BDR16/svn-migration-dump/Administration/Competition Forms/Formula Electric/ESF/Photos/6.2 Motor and Wiring Position - Copy.JPG

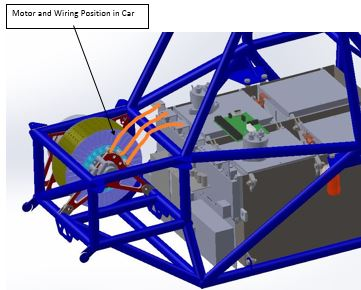
Administration/Competition Forms/Formula Electric/ESF/Photos/6.2 Motor and Wiring Position - Copy.JPG
