BDR16/svn-migration-dump/Administration/Project Management/Change Management/Read Me.txt

Files in this folder should be named according to the work package that the effect and the date which they were created.

Examples: "Drivetrain Nov 1" "Steering Oct 5" etc
