BDR16/svn-migration-dump/Administration/Impact Attenuator Reports/FH Design Selection.docx

Design Selection:

We decided to use the same Aluminum honeycomb from our 2014 vehicle, as that attenuator performed well. Again, we opted for the industry standard pre-crushed 8*8*4 in aluminum 5052 5.7pcf 3/16” honeycomb because of its abundance and low-cost compared to a custom-built honeycomb.

To dissipate the kinetic energy of our 317.5 kg car in the event of a crash at 7 m/s, we needed at least 9.3 in in the fore/aft direction. After adding a 15% safety margin we decided to stack another 2.6 in honeycomb with identical properties on top of the 8*8*4 block, thereby giving rise to our new impact attenuator with dimensions 10.6*8*4. This safety margin allows our car to strike a wall at 20 degrees and still absorb all of the vehicle’s Kinetic Energy.

We bonded these pieces with WEST SYSTEM® Six10® Thickened Epoxy Adhesive. To increase surface area and improve resistance to shearing forces, we placed a 0.06 inch thick aluminum plate between the honeycomb pieces. Detailed information regarding the equivalency of the epoxy to the (4) 5/16 Grade 5 bolts stated in the rules T3.20.3 can be found in our SES rev1.

To attach the honeycomb system and the aluminum L brackets that help support the honeycomb on the anti-intrusion plate we again used WEST SYSTEM® Six10® Thickened Epoxy Adhesive. The aluminum L brackets provide an additional level of protection against shearing forces and enhances stability in the event of a linear impact.

We used 4 mm-thick aluminum for our anti-intrusion plate to facilitate bonding with the honeycomb and the L brackets, since they are aluminum as well.

In summary, the impact attenuator we designed for our 2016 car was optimized in terms of cost, weight and use of materials. We emphasized safety as a key point and thus over-engineered both our honeycomb system and our anti-intrusion plate to outperform the criteria of Formula Hybrid, as we believe that a few pounds and a few dollars are well spent to protect a human life.

Yale University, Formula SAE Hybrid 2016
