BDR16/svn-migration-dump/Administration/Competition Forms/Formula Hybrid/213_Yale University_FH_Design.docx

## Bulldogs Racing BR16 Design Report

## Introduction

Bulldogs Racing has moved from the hybrid category to the all-electric category in the 2016 season for a variety of reasons. First, Yale University has set a major focus on sustainability throughout our daily lives. We think that electric vehicles will be the key to a sustainable future in transportation assuming improved battery technology over the course of the century. Additionally, the three North American electric vehicle competitions provide more utility for an electric vehicle than the single hybrid competition in New Hampshire. Most importantly, Formula Student has set a trend of electric vehicle performance that has dwarfed previous internal combustion, not to mention hybrid, records. Bulldogs Racing’s 2016 car, BR16, has been designed for optimal performance across acceleration, skid pad, autocross, and endurance events while still remaining manufacturable and cost conscious.

Our design philosophy can be summed up in this single phrase: “We don’t get to choose not to have problems, but we do get to choose the types of problems we are likely to have.” We do not have a perennial Formula SAE team with a history of success at competition. We do not have significant carry over between teams due to the leadership burning out. Not a single member of the championship 2013 team is on this year’s 2016 team, and only three of our members have been to a competition. Our first step to success has been recognizing these disadvantages, and focusing our efforts on the parts of the car that will benefit us most in competition. The North American electric vehicle competitions have been plagued with poor performances during technical inspection, resulting in cars that do not reach the track. Our number one priority is passing technical inspection with a car that can be successful in all four dynamic events.

## Powertrain

The powertrain of BR16 is made up of the cells, motor controller, motor, and gearbox. All of these components were chosen to operate well with each other. Moreover, the entire package was designed to race competitively in the acceleration, skid pad, autocross, and endurance dynamic events.

### Motor

The design started with the motor, as we found it easiest to adjust other components in relation to the motor rather than vice versa. The goals of motor selection were to traction limit the vehicle up to as high of a speed as possible, maintain greater than 90% efficiency at the average endurance speed, and reduce cost/fabrication time. We discarded any homemade or rewound motors due to the last goal, leaving us with a list of motors from Enstroj, Yasa, Nova, and Allied Motion. Of these choices, the Emrax 207 medium motor matched our goals best in an independent rear wheel drive configuration. We planned to mount our batteries directly behind the driver to drastically lower our polar moment of inertia when compared to side pods. This scheme would not be possible with a chain or belt drive, so we had a choice of direct or planetary gear drive. The Yasa motor lends itself to direct drive, but has a low power to weight ratio when compared to the Emrax. The Emrax 207 Medium has a maximum voltage of 300V, directly correlating with the electric vehicle ruling in North America. Running two Emrax motors each with a gear ratio of 4 results in a top speed of 90mph, traction limited operation up to 40mph, and greater than 96% efficiency from 25 to 50mph. On top of these phenomenal performance characteristics, using two independent motors cuts out the need for a differential.

### Gearbox

To meet packaging requirements, the gearbox had to mount axially to each of the rear motors with a speed reduction ratio of 4. The best solution we found to meet this need was the planetary gearbox. Following our design philosophy, we searched for a planetary gearbox that could be dropped into the car using only mounting tabs and half shafts rather than designing the gearbox ourselves. Unfortunately, we could not find such a product and had to settle somewhere in between. The Matex 146-4MEF planetary gearbox fit our reduction ratio needs at the cost of designing a watertight housing to meet manufacturer-suggested lubrication specifications.

### Motor Controller

The motor controller’s primary design specification was to match the motor type, voltage, and current while remaining efficient, low cost, and easy to integrate. Additionally, we wanted a motor controller that could perform in all four quadrants for regenerative braking. Enstroj suggested using the Bamocar D3 400-400 motor controller with the Emrax series of motors. We decided to follow their suggestion in order to ensure compatibility between the motor and controller. While the Bamocar motor controller is fairly lightweight, it wastes a lot of space volumetrically. We repackaged the motor controllers in a lower footprint housing in order to fit them behind the driver’s seat. This, again, is an example of a compromise we had to make between designing an entire component from scratch versus buying a drop-in component off the shelf.

### Cells

The accumulator cell was the most difficult component of the powertrain to choose due to the wide performance gap between designing and purchasing battery packs. Most off the shelf battery packs that we found did not meet our requirements for nominal voltage, continuous current, peak current, specific power, specific energy, energy density, and form factor. The only suitable battery pack we found was the A123 AMP20 energy module, but we could not find a supplier that sold them. Between lithium cobalt cells from Tenergy, Haiyen, and Turnigy and lithium iron cells from A123 we looked for a cell that would meet our requirements while resulting in a manufacturable and reliable battery pack. Our main focus was on high capacity cells such that the battery pack could be a series string of cells, forgoing the parallel cell fusing rule. Additionally, higher capacity cells would require less overall cells, resulting in easier fabrication and higher reliability. The A123 AMP20 cell used in the A123 AMP20 energy module was selected for numerous reasons. Its 20Ah capacity allowed us to design an accumulator with an 86S1P configuration with a maximum voltage of 300V. Its 600A peak current aligns well with two times the Emrax 207 Medium’s peak current rating. Lastly, AMP20 pouch cells are aligned face to face in compressed cell stacks that fit well between the driver’s seat and rear axle.

## Tires

All forces produced by the powertrain in acceleration and cornering are reacted through the tire contact patches at low speeds. Therefore, it is important for the chassis, suspension, braking, and steering systems to keep the tires in their optimal state throughout all conditions that may be achieved on the track. However, determining this optimal state is another problem in and of itself, usually achieved through the analysis of tire data.

### Tire Selection

Tire selection depends mostly upon rear weight bias, of which Bulldogs Racing's 2016 car will have about 60%. Tires should be picked such that the peak coefficient of friction for the outside rear tire under 30% load plus load transfer should be equal to the peak coefficient of friction for the outside front tire under 30% load plus load transfer. Doing this will ensure that the two sets of tires begin slipping from the track at about the same lateral acceleration. Aside from matching the fronts and rears in this manner, the tires with the highest possible coefficients of friction should be chosen to maximize vehicle performance.

Due to time constraints and a small one-man tire team, tire selection was limited to finding peak values and fitting magic formula curves rather than developing extensive tire models. The data was parsed into runs with constant rim width, pressure, vertical load, and camber. Figure 4 (left) shows five example data sets of cornering force vs. slip angle for a 7.5” Hoosier tire on an 8” rim width at 10psi of pressure and 0 degrees of camber. After the data was parsed into a usable format, each data set was fit with Pacejka's magic formula to determine peak coefficient of friction values for both longitudinal and lateral forces. MATLAB's nonlinear least squares curve fitting tool was used to create the fits, one of which is shown in Figure 4 (right).

### Tire Analysis

Once the runs were fit, the peak coefficient of friction values were averaged across multiple dimensions and compared between differing tire manufacturers and models. Peak coefficient of friction was averaged across all dimensions except for rim width to determine optimal rim width. Then that rim width was chosen for future analysis. Next peak coefficient of friction was averaged across all dimensions except for rim width and pressure to determine optimal pressure at the optimal rim width. Then that pressure was chosen for future analysis. Finally, a plot of lateral force versus vertical force for multiple cambers was generated at the optimal rim width and pressure to determine tire camber sensitivity as shown in figure 5. This analysis was completed for both the front and rear Hoosier tires such that the suspension could be designed to keep the tires happy.

### Suspension Geometry

The goal of our double wishbone geometry was to minimize camber change, track width change, and roll center change as the suspension moves in bump, droop, and roll. Note in figure 5 that the 7.5” Hoosiers performed best at 0 degrees of camber, and therefore the suspension should be designed such that the outside, more heavily laden tire has 0 degrees of camber during a turn. A 2D geometry sketch was used with a trial and error process to determine optimal parameters. Note that a more robust method would have involved a track simulator with tire models, but we did not have the time to implement such a solution. The change in camber was adjusted to about 2 degrees for a 2.5 degree roll, thereby compromising between tire camber and roll gradient performance. The static camber was left very low, namely -0.5 degrees in the front and -1 degree in the rear because the uprights will have built-in static camber adjustment through shims, but only in the negative direction. Additionally, the front and rear roll centers were kept as close as possible to each other in both height and lateral offset such that the roll axis remained constant relative to the vehicle mass centroid axis.

### Suspension Adjustability

A multitude of suspension parameters are statically adjustable between races. Toe can be adjusted due to a left and right handed rod end being used on the front steering link and rear toe rod. Ride height can be adjusted by the same method’s use on the pull rods. Additionally, this ride height adjustment is independent of spring preload, which is adjusted directly on the damper. Kingpin axis inclination is adjustable by the threaded rod ends on the front wishbones, although this adjustment will slightly change other suspension properties such as camber, track, and roll center sensitivity to bump, droop, and roll. Steering arm and Ackermann are adjustable through steering link tabs that bolt to the front uprights. Finally, camber is adjustable through shims on the bottom of each front and rear upright.

### Uprights

The suspension uprights were manufactured from 7075-T6 aluminum to reduce weight and compliance. A variety of major changes were made to the front and rear uprights from BR13. The front and rear uprights were thinned from 1.95” to 1.4” and 1.5” respectively. A removable plate was added at the bottom wishbone attachment point to allow for camber adjustment. In terms of weight savings, the new upright pockets were cut completely through because simulation showed that leaving a thin layer of aluminum on the back of the upright does not significantly increase strength or rigidity, but drastically increases weight. Additionally, a triangular structure was run to either side of the wishbone and toe link attachment points on the uprights to better support the nodes. A weight of 1.71 and 1.98lbs was achieved for the front and rear uprights respectively with a safety factor of over 5, as opposed to about 3.16 and 3.37lbs for the old car.

## Steering

A Stiletto 12:1 rack and pinion was used to transfer steering forces from the wheels to the steering column and driver. Four brake calipers were used at the front of the car to produce enough braking force for BR13. To reduce weight and system complexity, Wilwood master cylinder and caliper bore diameters were selected such that only two brake calipers needed to be used at the front of the car, resulting in a total of four calipers on the vehicle. Additionally, the bore diameters were selected such that braking force distribution matched 2g longitudinal load transfer for a 40% front biased vehicle.

## Chassis

To start off, we were able to reduce both the height and length of the chassis due to packaging design considerations made before the summer of 2015. The width could also be reduced because the vehicle no longer needed to house both an electric motor and internal combustion engine in parallel. The rear box that used to house the differential, but now houses the motors and gearboxes was significantly reduced in size due to the lack of large chain driven sprockets. Lastly, the driver seat angle was increased to 45 degrees to give more room for the accumulator in the area directly behind the seat. A weight of 65lb was achieved, directly in line with our goal of fabricating a chassis that weighs less than 70lb.

## Aerodynamics

Despite our lack of experience, we made a few common sense design decisions to take advantage of aerodynamics with BR16. Frontal area of the cockpit opening was reduced as much as possible in chassis design to reduce aerodynamics drag. Additionally, our contoured body prevents laminar-turbulent flow transition, again reducing drag. Lastly, NACA ducts on either side of the driver’s head pull air into the radiator that cools the motors and motor controllers.

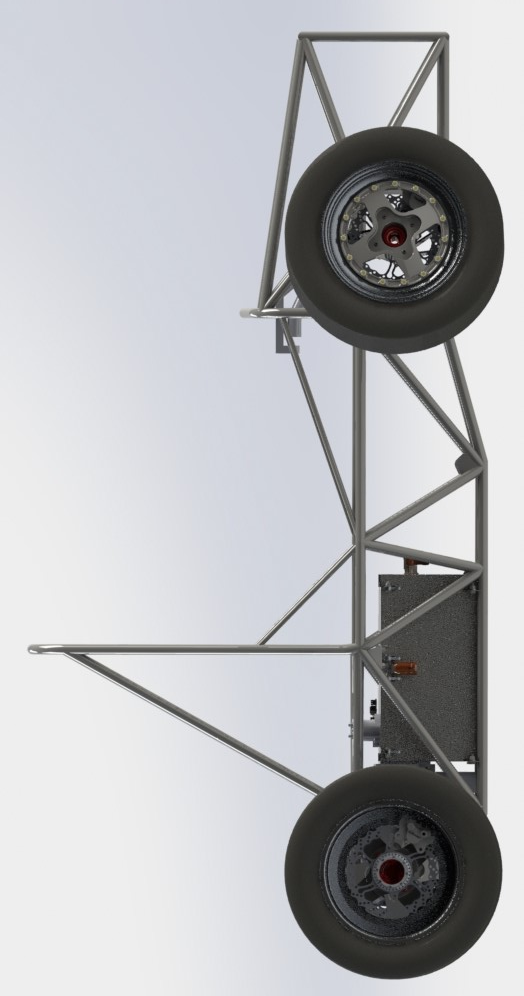
[picture p7: figure]

Figure 1 - Side view

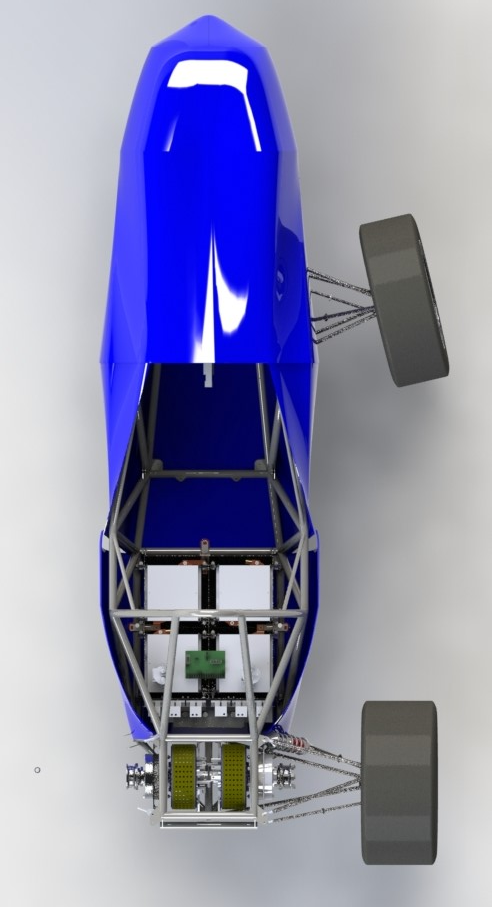
[picture p8: figure]

Figure 2 - Front view

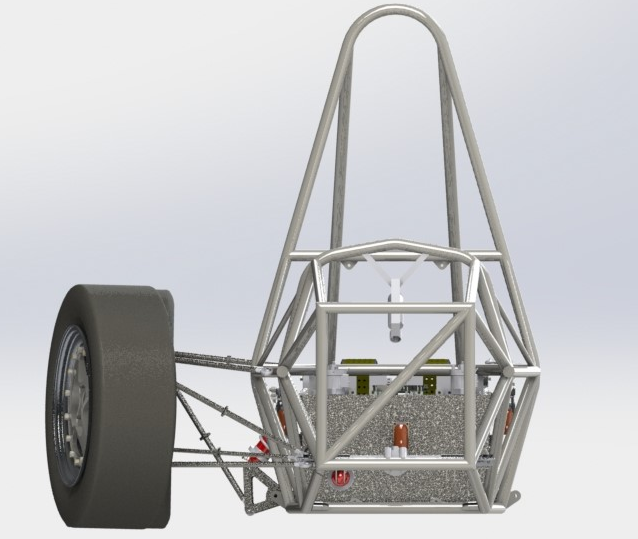
[picture p9: figure]

Figure 3 - Front View

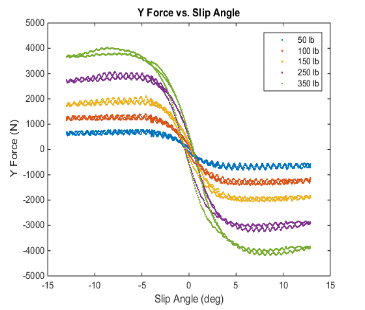
[picture p10: figure]
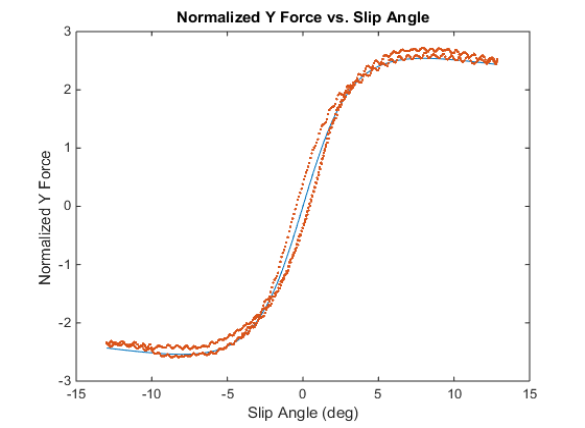
[picture p11: figure]

Figure 4 – TTC parsed tire data (left) fit to Pacejka’s magic formula (right)

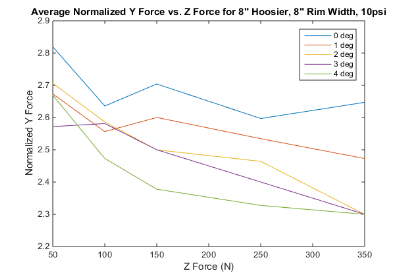
[picture p12: figure]

Figure 5 – Lateral vs. vertical force for rear tire cambers (listed cambers should be negative)

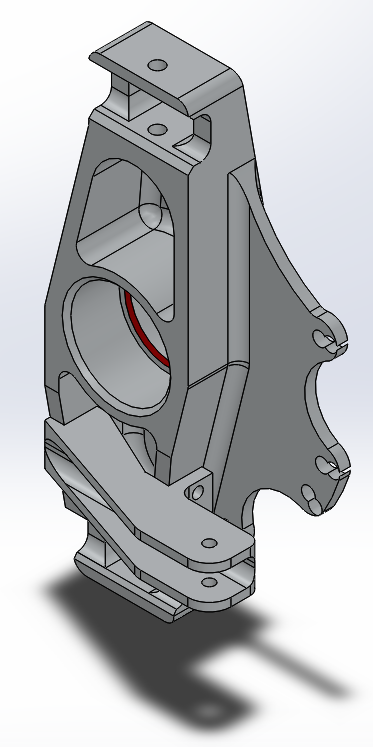
[picture p13: figure]
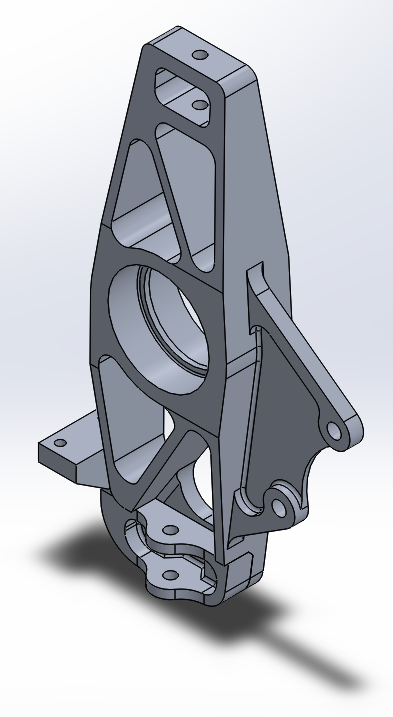
[picture p14: figure]
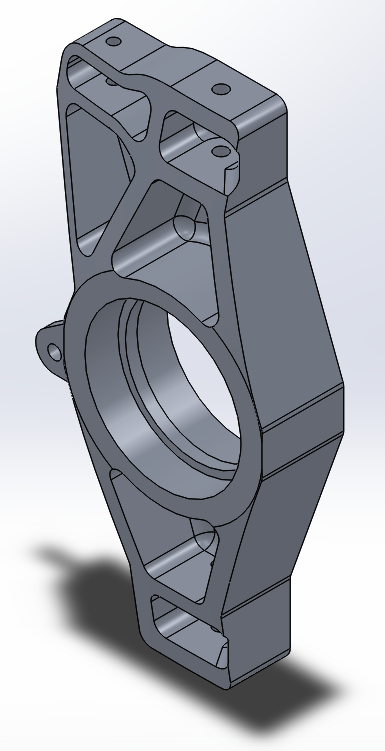
[picture p15: figure]
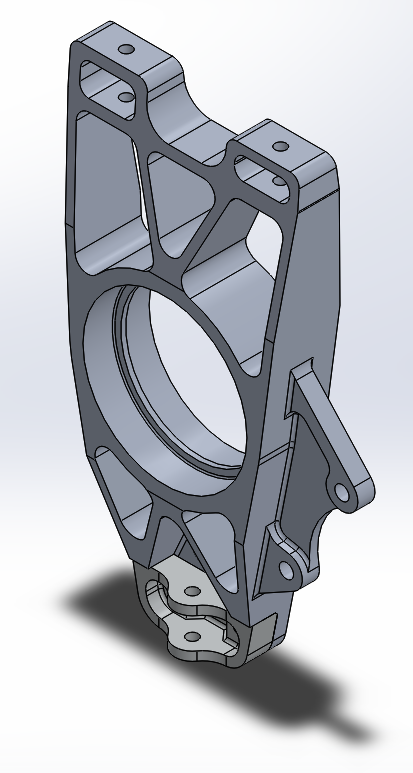
[picture p16: figure]

Figure 6 – From left to right old front, new front, old rear, new rear

bulldogsracing.com | philip.piper@yale.edu | (713) 501-2744
