BDR16/svn-migration-dump/Administration/Bulldogs Racing Template.pptx

## Slide 2

Bulldogs Racing

Notes: 4-5 day seminar focusing on vehicle dynamics from a data standpoint. Started with the tire data and moved towards suspension. It was a lot of work. Got a giant binder and an excel sheet with a lot of the calculation. On the way back, Saw belter’s house.
