BDR16/svn-migration-dump/Administration/Impact Attenuator Reports/213_Yale University_FH_IAD_Addendum.xlsx

Formula SAE Hybrid Impact Attenuator Report Addendum: Equivalency of Epoxy Bonding
5/16 Grade 5 bolts |  |  |  |  |  | Honeycomb Properties
Tensile Strength | 827 | MPa |  |  |  | Hexagonal Cell Size | 0.1875 | in
Shear Strength | 513 | MPa |  |  |  | One side of the hexagon | 0.10825 | in
Tensile Stress Area Diameter | 0.008 | m | (1 bolt)* |  |  | Foil Gauge | 0.002 | in
Shear Stress Area Diameter | 0.008 | m | (1 bolt)* |  |  | One Hexagon Area | 0.03 | sq in
Tensile Stress Area | 0.0002010619298 | m^2 | (4 bolts) |  |  | One Hexagon Perimeter | 0.65 | in
Shear Stress Area | 0.0002010619298 | m^2 | (4 bolts) |  |  | Crush Area of Honeycomb | 32 | sq in
Tensile Failure of Bolts | 166278.216 | N | (4 bolts) |  |  | # of Hexagons in Crush Area | 1066.666667
Shear Failure of Bolts | 412579.08 | N | (4 bolts) |  |  | Foil Surface Area for Bonding* | 2.426666667 | sq in
*Assuming a 5/16 shank (which is an overestimate) |  |  |  |  |  | Foil Surface Area for Bonding* | 0.001565588267 | m^2
 |  |  |  |  |  | *For calculating the failure limits of the epoxy. Found by multiplying the number of hexagons by the perimeter of a single hexagon by the foil thickness. Divided by 2 to avoid double-counting the adjacent sides. Epoxy assumed to form 0.005" radius fillet between the honeycomb and the spacer.
Equivalency of Epoxy Bonding the Main Honeycomb and its Brackets to the Anti-Intrusion Plate*
Epoxy Tensile Strength | 44 | MPa
Epoxy Shear Strength | 78 | MPa
Tensile Stress Area | 0.02064512 | m^2 | (4 brackets)**
Tensile Stress Area | 0.001565588267 | m^2 | (Honeycomb)*** |  |  | Honeycomb Failure Limits
Shear Stress Area | 0.02064512 | m^2 | (4 brackets)** |  |  | Tensile Strength* | Not Rated
Shear Stress Area | 0.001565588267 | m^2 | (Honeycomb)*** |  |  | Shear Strength | 3.17 | MPa
Tensile Failure of Honeycomb and Brackets | 977271.1637 | N | (Total) | 587.7325289 | % equivalency | Tensile Stress Area** | 0.02064512 | m^2
Shear Failure of Honeycomb and Brackets | 1732435.245 | N | (Total) | 419.9038024 | % equivalency | Shear Stress Area** | 0.02064512 | m^2
*Total of 4 L brackets are used at 4 sides of the honeycomb. Each bracket is a 4" x 4" 0.060" thick 6061 T6 Aluminum, bent into an L shape. |  |  |  |  |  | Tensile Failure of Honeycomb* | Not Rated
 |  |  |  |  |  | Shear Failure of Honeycomb | 65445.0304 | N
**Assuming 2" x 4" bracket contact area with both the AI plate and the honeycomb. Sides of the honeycomb are flattened before adhesion. |  |  |  |  |  | *Tensile strength of honeycomb not rated; poor in tension.
 |  |  |  |  |  | **For calculating the failure limits of the Aluminum honeycomb. Same as the crush area. Supplied by Plascore, vendor of the honeycomb, in references.
***See the Honeycomb Properties chart for the details on the calculation.
All Dimensions in Inches in Drawing |  |  |  |  |  | Equivalency of Epoxy Bonding the Extenstion Honeycomb to the Spacer Plate*
 |  |  |  |  |  | Tensile Strength | 44 | MPa
 |  |  |  |  |  | Shear Strength | 78 | MPa
 |  |  |  |  |  | Foil Surface Area for Bonding* | 0.001565588267 | m^2
 |  |  |  |  |  | Tensile Stress Area | 0.001565588267 | m^2
 |  |  |  |  |  | Shear Stress Area | 0.001565588267 | m^2
 |  |  |  |  |  | Tensile Failure of Epoxy | 68885.88373 | N | N/A | % equivalency
 |  |  |  |  |  | Shear Failure of Epoxy | 122115.8848 | N | 186.5930599 | % equivalency
 |  |  |  |  |  | *The equivalency that we need to prove is that of the honeycomb, since the failure modes on the spacer plate and the additional honeycomb block are those of the epoxy and the honeycomb itself.
 |  |  |  |  |  | References
 |  |  |  |  |  | Bolt Tensile Strength (https://www.fastenal.com/content/documents/FastenalTechnicalReferenceGuide.pdf)
 |  |  |  |  |  | Bolt Shear Strength (http://www.blacksfasteners.co.nz/assets/boltshearcapacity_14-15.pdf)
 |  |  |  |  |  | West Systems Six10 Epoxy (http://www.westsystem.com/ss/typical-physical-properties/)
 |  |  |  |  |  | Plascore Aluminum Honeycomb (http://www.plascore.com/download/datasheets/honeycomb_data_sheets/Plascore_5052.pdf)
