BDR16/svn-migration-dump/Electrical/High Voltage/High Voltage Design.xls

Voltage (V) | Capactiance (uF) | Safety Factor
300 | 1600 | 1.35
Precharge Resistor
%Voltage | Time (s) | Resistance (Ohm) | Power (W)
90 | 5 | 1005.311301 | 11.664
Discharge Resistor
End Voltage (V) | Time (s) | Resistance (Ohm) | Power for 15s per Formula Hybrid EV4.9.3 (W)
30 | 5 | 1005.311301 | 89.52450842
