BDR16/svn-migration-dump/Mechanical/Impact Attenuator/Impact Attenuator Calculations.xlsx

Sheet: Material
New Impact Attenuator Reference
Material
Vendor | Plascore
ID | PAMG-XR1-5.7-3/16-P-5052
Rebranded As | PACL-XR1-5.7-3/16-20-P-5052
Properties
Series: | PAMG Aerospace Grade | (rebranded as PACL CrushLite)
Alloy | 5052 Aluminum
Corrosion Resistance | Coated
Density | 5.7 pcf (91.3 kg/m^3)
Cell Size | 3/16 in (4.76mm) | measured from edge to edge, perpendicular
Thickness | 0.02 in (0.51 mm)
Perforated | Yes
Why this material?
Aluminum | best strength to weight; most cost-efficient compared to plastic or composite solutions
5052 | best strenght to weight ratio for Aluminum honeycomb, only second to 5056, but much cheaper than 5056
5.7 pcf, 3/16 in, .02 | most widely and readily available and cheapest that still satisfies the constraints
Precrushed | to eliminate peak loads at the front crush zone

Sheet: Calculations
Independent Variables
Car Mass | 230.00 | kg
Driver Mass | 80.00 | kg | This is in the rules
Crash Velocity | 7.00 | m/s | This is in the rules
Max Acceleration | 40.00 | g
Max Avg Acceleration | 20.00 | g
Min Crush Stroke | 0.20 | m | This is in the rules
Min IA Width | 0.20 | m | This is in the rules
Min IA Height | 0.10 | m | This is in the rules
Max Crush P | 2844087.00 | Pa | Supplied by Plascore
Min Crush P | 2326981.00 | Pa | Supplied by Plascore
Min Crush Stroke Efficiency | 0.76 |  | Supplied by Plascore
Dependent Variables
Total Mass (lbs) | 700.00 | lbs | Rounded to the nearest 100 lbs, per the rules
Total Mass | 317.52 | kg
KE | 7779.12 | J
Primary Calculations
Crush Area | 0.02 | m^2 | as mandated by the rules
Min Crush Stroke w/ Pmax | 0.14 | m | Quoting KE = F * s ; F = P * A ; Pmin and Pmax are Plascore values
Min Crush Stroke w/ Pmin | 0.17 | m
Min IA Length | 0.21993 | m
Sanity Check
Min Crush Stroke | 0.12 | m | Quoting Vf^2 = Vi^2 + 2 * a * s | The design crush stroke value is higher; average acceleration will be less than 20g
Max Crush Area | 0.02 | m^2 | Quoting F = m * a ; F = P * A | The design crush area is lower; a force lower than m * 20g will be needed to compress
Max Avg Acceleration | 14.94 | g
Min Energy Absorbed | 7779.12 | J |  | Above 7350 J as stated by the FSAE
Min Crush Force | 46539.62 | N
Max Crush Force | 56881.74 | N |  | This might be a problem if we want to collect data from Instron - it does not register data after 50 kN I think, but then there is not much we can do, since F is directly proportional to Area, and we can not reduce the area per the rules.
Dynamicity and Angularity of the Impact
Crush P coefficient (7 m/s) | 1.06 |  | fig 2, pg 5 of Hew Web | As the impact velocity increases, the crush P coefficient increases, up to about 1.1 at 10 m/s, after which it continues to increase at a marginal rate.
Min Dynamic Crush Stroke | 0.16 | m | at 7 m/s
Min Dynamic IA Length | 0.21 | m |  | Lower than the min static IA length
Crash Angle | 20.00 | degrees |  | Up to 20 degrees, linear decrease in the crush strength proportional to the change in the angle between the load path and the normal vector of the front plane of the IA (1% decrease for every degree). After 20 degrees, 2% decrease after every degree. Car is not expected to hit a wall head-on at any angle greater than 20 degrees. Quoting Theta = arccos(L / R), where L is the wheelbase of the car and R is the turning radius for a rough estimate of centripetal acceleration. V^2 / R = 7^2 / 4.5 = around 1.1g. Assuming the driver is using the brakes if the impact is imminent, the traction circle does not premit cornering with over 20 degrees of steering input without breakaway. As a result, impacts over 20 degrees are not expected.
Angular Crush P coefficient | 0.80 |  | fig 3, pg 6 of Hex Web
Normal Crash Velocity (grip) | 6.58 | m/s | case where the wheels and the car point in the same direction
KE | 6869.13 | J
Min Dynamic Crush Stroke w/ Pmin | 0.17 | m
Min Dynamic IA Length | 0.22902 | m
Crash Angle | 20.00 | degrees
Angular Crush P coefficient | 0.80 |  | fig 3, pg 6 of Hex Web
Normal Crash Velocity (oversteer) | 7.00 | m/s | case where the wheels point in the direction of the load path, but vehicle travels at 30 degrees wrt the wheels (oversteer)
KE | 7779.12 | J
Min Dynamic Crush Stroke w/ Pmin | 0.20 | m
Min Dynamic IA Length | 0.25936 | m
Precrushed Section Length | 0.00953 | m | pg 11 of Hex Web |  | 0.9525
Total Proposed IA Length | 0.26888 | m
 | 10.58590857 | in
