BDR16/svn-migration-dump/Mechanical/Steering/Steering Design.xls

Sheet: Steering Statics
Car Parameters
Mass (kg) | 300
Front Track Width | 1258.49
COG Height (mm) | 250
Front Weight Bias (%) | 40
Max Lateral G's | 1.6
Tire Parameters | Outside | Inside
Tire Fz (lbf) | 216.4386797 | 48.20765233
Tire Mz (Nm) | 58 | 7
Tire Fy (N) | 2500 | 600
Caster Angle (deg) | 4 | 4
Kingpin Offset (mm) | 0 | 0
Wheel Radius (in) | 21 | 21
Pneumatic Trail (mm) | 23.2 | 11.66666667
Mechanical Trail (mm) | 18.64948075 | 18.64948075
Steering Moment (Nm) | 104.6237019 | 18.18968845
Steering Forces/Moments
Upright Arm Length (mm) | 100
Upright Bolt Separation (mm) | 27.94
Steering Wheel Diameter (mm) | 260
Rack Linear Travel (mm) | 114.3
Rack Rotational Travel (deg) | 315
Rack Effective Pinion Radius (mm) | 20.79018285
Tie Rod Force (N) | 1228.133903
Upright Bolt Force (N) | 2197.805839
Steering Ratio | 4.809962505
Steering Wheel Torque (Nm) | 43.50291785
Steering Wheel Force (lb) | 37.61496524
Bolts | Tie Rod Bolt | Upright Bolt
Diameter (in) | 0.25 | 0.19
Tensile Strength (psi) | 170000 | 170000
Shear Strength Mult | 0.6 | 0.6
Shear Strength (psi) | 102000 | 102000
Critical Shear Force (N) | 44543.70368 | 25728.44325
Safety Factor | 36.26941946 | 11.70642228
Tubes
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
