BDR16/svn-migration-dump/Administration/Competition Forms/Formula Electric/E228_Yale_spec.xls

Sheet: FSAE_Specs_EV_Powertrain
FSAE (EV) Design Spec Sheet |  |  |  |  |  |  | 2016
Competitors: Please read the Instructions-Tips (tab below) prior to the completion and submission of this sheet.
Car No. |  | E228
School |  | Yale University
Dimensions | Units
Overall Dimensions | mm | Length: | 2650 | Width: | 1452 | Height: | 1149
Wheelbase & Track | mm | Wheelbase: | 1549 | Front Track: | 1263 | Rear Track: | 1187
Center of Gravity Design Height | mm | CG Height: | 200 to 250 | Confirmed Via: | Three point hang test with ballast for driver
Mass without driver | kg | Front: | 60 to 75 | Rear: | 150 to 165 | Total: | 210 to 240
Weight Distribution with 68kg driver |  | % Front: | 40 | % Left: | 50
Suspension Parameters | Units | Front |  |  | Rear
Tire Size, Compound and Make |  | Hoosier 13" ID x 6" width R25B |  |  | Hoosier 13" ID x 8" width R25B
Wheels (width, construction) |  | Keizer aluminum 13" OD x 6" width |  |  | Keizer aluminum 13" OD x 8" width
Suspension Type |  | Double wishbone |  |  | Double wishbone
Suspension design travel | mm | Jounce (col D): Rebound (col E): | 30 | 30 | Jounce (col G): Rebound (col H): | 30 | 30
Wheel rate (chassis to wheel center) | N/mm | 14.84 |  |  | 21
Roll rate (chassis to wheel center) | NM/deg | 205.1 |  |  | 255.6
Sprung mass natural frequency | Hz | 2.5 |  |  | 2.4
Jounce Damping | % critical | 0.8 | at __ mm/sec: | 100 | 1.15 | at __ mm/sec: | 100
Rebound Damping | % critical | 1.25 | at __ mm/sec: | 100 | 1.75 | at __ mm/sec: | 100
Motion ratio | _.__:1 | 1 | Type: | linear | 1.04 | Type: | linear
Ride Camber (Rate of Camber Change) | deg/m | 33.1 |  |  | 29.5
Roll Camber | deg/deg | 0.79 |  |  | 0.76
Static Toe (- out, + in) | deg | -1.0 to 1.0 |  |  | -1.0 to 1.0
Static camber | deg | -0.5 to -2.5 |  |  | -1.0 to -3.0
Static camber adjustment method |  | Adjustable by up to 2 degrees using upright shims |  |  | Adjustable by up to 2 degrees using upright shims
Anti dive / Anti Squat | % | 0 |  |  | 0
Roll center height above ground, static | mm | 46.6 |  |  | 37.2
Roll center position at 1g lateral acc | mm | Height (col D): Lateral (col E): | 41.3 | 48.5 | Height (col G): Lateral (col H): | 37.5 | 33.7
Front Caster, Trail, and Scrub Radius |  | Caster (deg): | 4 | Kin Trail (mm): | 18.6 | Scrub Rad (mm) | 31.4
Front Kingpin Axis |  | Inclination (deg): | 0.5 | Offset (mm): | 31.4
Static Ackermann | % | 25 | Adjustable? | Yes
Suspension Adjustment Methods |  | Adjustable Ackermann and steering arm length through interchangeable steering arms bolted to front uprights
Steer Ratio, C-Factor, Steer Arm Length |  | Steer Ratio (x:1) | 5.3 | c-factor (mm) | 65.3 | Steer Arm Length | 60.8
Brake System / Hub & Axle | Units | Front |  |  | Rear
Rotors |  | RCV floating iron 9" dia 0.18" thick weight optimized |  |  | RCV floating iron 9" dia 0.18" thick weight optimized
Master Cylinder |  | Wilwood compact remote flange 0.8125" bore size |  |  | Wilwood compact remote flange 1.125" bore size
Calipers |  | Wilwood PS-1 dual piston 1.12" piston diameter |  |  | Wilwood PS-1 dual piston 1.12" piston diameter
Brake Pad/Lining Material |  | Wilwood 4108 sintered metallic pad |  |  | Wilwood 4108 sintered metallic pad
Force and Pressures @ 1g Deceleration |  | Front Pres. (bar): | 32.1 | Rear Pres. (bar): | 16.8 | Pedal Force (kN) | 0.43
Upright Assembly |  | Alu 7075-T6 camber, steering arm, and Ackermann adj |  |  | Machined aluminum 7075-T6 camber adjustable
Hub Bearings |  | Timken 08000 back to back tapered roller bearings |  |  | Timken L610500 back to back tapered roller bearings
Axle type, size, and material |  | RCV steel hub |  |  | RCV steel hub with enclosed CV joint
Ergonomics | Units
Driver Size Adjustments |  | Longitudinally adjustable pedal plate (+/- 4") and vertically adjustable seat (+/- 6")
Seat (materials, padding/damping) |  | Carbon fiber seat with foam inserts for comfort and height adjustment
Steering Wheel (dia, construction) |  | Diamter (mm) | N/A | Construction | N/A
Shift Actuator (type, location) |  | N/A
Clutch Actuator (type, location) |  | N/A
Instrumentation |  | Speed gage, fuel gage, AMS fault light, IMD fault light, software fault light, and performance/endurance switch
Optional: (e.g., Driver Safety Systems, etc.?) |  | Regenerative braking hand paddle actuation
Electrical (non-drive systems) | Units
Power Management / Control |  | Littelfuse PDM with relay and fuse integration
Wiring / Loom / ECM mounting |  | Expandable braided sleaving for heat and vibration resistance
Battery / Charging System |  | Lithium polymer 12V, 6Ah battery with on-board battery management system
Grounding |  | Analog instrumentation grounding through shielded cable
Driver Assist Systems |  | Driver adjustable traction control and torque vectoring
Logging / Telemetry |  | Data logging through CAN bus to ECU; wireless AMS data transmission
Special Sensing Technology |  | N/A
Frame | Units
Frame Construction |  | Steel spaceframe
Material |  | 4130 steel
Joining method and material |  | TIG welding with ER80S-D2
Bare frame mass with brackets & paint | kg | Target: | 30 | Physical Test: | 30
Torsional stiffness | N-m/deg | Target: | 1500 | Simulated: | 1455 | Physical Test: | N/A
Torsional stiffness validation method |  | N/A
Impact Attenuator configuration |  | Aluminum honeycomb student design based on standard impact attenuator
Impact Attenuator dimensions | mm | Width: | 203 | Height: | 102 | Depth: | 272
Impact Attenuator energy capacity | kJ | Energy: | 8.72 | Method: | Instron physical testing
Tractive Drive Power System | Units | Front |  |  | Rear
Motor Manufacturer / Model / Type |  | N/A |  |  | Enstroj Emrax 207 Medium
Motor Technology utilized |  | N/A |  |  | Permanent magnet synchronous axial flux
Motor Count and Location(s) |  | N/A |  |  | 2; one per left/right wheel
Driven Wheel Count & Location(s) |  | N/A |  |  | 2; left and right wheels are independently driven
Nominal Motor Voltage (phase and volts) | P, V | Phase (col D): Voltage (col E): | N/A | N/A | Phase (col G): Voltage (col H): | 3 | 320
Maximum Design Motor RPM (1/min) | rpm | N/A |  |  | 6000
Base Speed (max torque until xx RPM) | rpm | N/A |  |  | 4000
Maximum Motor Torque (peak) | Nm for Xsec | N/A |  |  | 160 for minutes at cold start or seconds at hot start
Maximum Motor Torque (continuous) | Nm | N/A |  |  | 80
Maximum Motor Power (peak) | kW at RPM | N/A |  |  | 80kW at 6000RPM
Maximum Motor Power (continuous) | kW @ RPM | N/A |  |  | 20 to 32kW at 6000RPM
Motor Speed Sensor(s)? If so, what type |  | N/A |  |  | One resolver per motor
Significant Motor Modifications |  | N/A |  |  | N/A
Motor Controller(s) Type / Model |  | N/A |  |  | Unitek Bamocar D3 400-400
Motor Controller Discharge Power (peak) | kW for x sec | N/A |  |  | 160
Controller Continuous Discharge Power | kW | N/A |  |  | 80
Accumulator Cell Manufacturer / Type |  | N/A |  |  | A123 Amp20 pouch cell
Accumulator Cell Voltage / Capacity | Volts, mAh | N/A |  |  | 300V, 20000mAh
Accumulator Voltage (fully charged) | V | N/A |  |  | 300
Accumulator Cell Technology/Chemistry |  | N/A |  |  | LiFePO4
Accumulator Cell Configuration |  | N/A |  |  | 86S1P
Accumulator Discharge Power (peak) | kW for x sec | N/A |  |  | 180kW for 10s
Accumulator Discharge Pwr (continuous) | kW | N/A |  |  | 60
Accumulator Full Charge Time | hrs:min | N/A |  |  | 1:20 on 230VAC and 2:40 on 115VAC
Accumulator Charging Efficiency | % | N/A |  |  | 93
Accumulator Charging Power | kW | N/A |  |  | 4.5kW on 230VAC and 2.25kW on 115VAC
Torque Control Modes (vectoring, etc.) |  | N/A |  |  | Independent rear wheel torque vectoring
Other Special Components |  | N/A |  |  | Motor and controller liquid cooling
Drivetrain | Units
Drive Type |  | Matex 146-4MEF planetary gearbox
Differential Type (if used) |  | Independent rear wheel torque vectoring
Final Drive Reduction Ratio | _:1 | 4
Vehicle Speed @ max power (design) rpm | kph | 1st gear: | 148kph at 80kW/6000RPM | 2nd gear: | N/A | 3rd gear: | N/A
Vehicle Speed @ max power (design) rpm | kph | 4th gear: | N/A | 5th gear: | N/A | 6th gear: | N/A
Half shaft size and material |  | Hollow 13.5" long 4130 steel
Axle Joint type |  | Inner and outer tripod CV joint
Aerodynamics (if applicable) | Units
Type / Configuration |  | N/A
Forces (at 80 kph, ρ= 1.162 kg/m^3) |  | Downforce (N): | N/A | % Front: | N/A | Drag (N): | N/A
Coefficients & Reference Area |  | Cl: | N/A | Ref. Area (m^2): | N/A | Cd: | N/A
Noteable Features (active, etc) |  | N/A
Other Information | Units
Body Work (material, process) |  | Carbon fiber nosecone with dacron side panels
Optional Information |  | Retro F1 design

Sheet: Instructions-Tips
Instructions / Tips for Design Specification Sheet
Formatting: Please do not modify the formating of the spec sheet. It has been laid out to print on a single sheet of 8.5 x 11 paper (double sided). While we acknowledge that there is little space in the cells, we ask that you be brief and include longer descriptive information within the Design Report.
Completeness: Please complete the spec sheet in its entirety. The judges expect that there will be a value or description entered for each and every line item contained within. If by chance, the particular item does not apply to your vehicle / design, please enter "N/A" in the space provided. N/A in this case meaning: Not Applicable.
Range of Values: In cases where you have yet to determine a specific value for a parameter, please input the range that you anticipate the values to fall within. Please make the noted range as tight (ie. narrow bandwidth) as you feel comfortable.
Units: For the majority of the specifications requiring a numerical input, an example of the desired unit of measure has been provided. Please be consistent with the units as specified on this sheet.
Comments / Clue Tabs: For many line items, there is additional descriptive information provided if you hover your cursor over the specification cell. Please use this information to guide your entry.
Understanding: The sample values in the template are fictional and should not be used as the baseline for your designs. Note that the specifications identified within the spec sheet contain the type of information the judges will expect you to know, understand, and be capable of discussing during the Design Event. Key factors during the discussion shall be the engineering rationale behind each decision and resulting specification.
Consistency: All values contained within this spec sheet are expected to align with your Design report and your vehicle at competition. It should be expected that inconsistencies will be discussed during the Design event. Without adequate reasoning for the discrepancies, a negative impact on your design score may result.
Timliness: Please submit the Spec Sheet and Design Report ON TIME. Late submission penalties can be significant and there is little excuse for points lost due to late submissions.
Data Entry Issues: If you are having issues with Excel not taking a value (especially if a negative sign is used) please try beginning the entry with a " ' " as the first character.
File naming: Please adhere to the specific file naming convention as stated in the rules. This greatly simplifies file management for the judges and event organizers.
