BDR16/svn-migration-dump/Administration/Competition Forms/Formula Hybrid/213_Yale University_FH_Specs.xlsx

Formula Hybrid Design Spec. Sheet |  | 2016
Submit this sheet with your design report. This information will be reviewed by the design judges and may be referred to during the design event.
--Please do not modify the format of this sheet. Consistent formatting will help keep the judges happy!
Car No. | 213
School | Yale University
Team Name | Bulldogs Racing
Dimensions | Front | Rear
Overall Length, Width, Height | 2650mm x 1452mm x 1149mm
Wheelbase | 1549mm
Track | 1263mm | 1187mm
Weight (empty) | 60 to 75 kg | 150 to 165 kg
Weight with 150lb driver | 90 to 105 kg | 195 to 210 kg
Suspension Parameters | Front | Rear
Suspension Type | Double wishbone | Double wishbone
Tire Size and Compound Type | Hoosier 13in ID x 6in width R25B | Hoosier 13in ID x 8in width R25B
Wheels | Keizer aluminum 13in OD x 6in width | Keizer aluminum 13in OD x 8in width
Design ride height (chassis to ground) | 1.25in | 5in
Center of Gravity Design Height | 225mm
Suspension design travel | 1.25in | 1.25in
Static Toe and adjustment method | -1.0 to 1.0 deg with left/right handed rod ends | -1.0 to 1.0 deg with left/right handed rod ends
Static camber and adjustment method | -0.5 to -2.5 deg with upright shims | -1.0 to -3.0 deg with upright shims
Front Caster and adjustment method | 4 deg non-adjustable
Static Akermann and adjustment method | Progressive to 100% with upright steering tabs
Anti dive / Anti Squat | 0% | 0%
Roll center position static | 46.6mm | 37.2mm
Steer location, Gear ratio, Steer Arm Length | 5.3:1 steer ratio, 65.3mm c-factor, 60.8mm steer arm length
Mechanical Brake System / Hub & Axle | Front | Rear
Brake Rotors | RCV floating iron 9" x 0.18" thick weight optimized | RCV floating iron 9" x 0.18" thick weight optimized
Master Cylinder | Wilwood compact remote flange 0.8125" front bore and 1.125" rear bore
Calipers | Wilwood PS-1 dual piston 1.12" piston diameter | Wilwood PS-1 dual piston 1.12" piston diameter
Hub Bearings | Timken 08000 back-back tapered roller bearings | Timken L610500 back-back tapered roller bearings
Upright Assembly | Alu 7075-T6 camber, steering arm, and Ack adj | Alu 7075-T6 camber, steering arm, and Ack adj
Axle type, size, and material | RCV steel hub | RCV steel hub with enclosed CV joint
Regenerative Braking | Front | Rear
Type | N/A | Independent rear wheel regen braking
Ergonomics
Driver Size Adjustments | Longitudinall ajdustable pedal plate (+/-4") and vertically adjustable seat (+/- 6")
Seat (materials, padding) | Carbon fiber seat with foam inserts for comfort and height adjustment
Driver Visibility (angle of side view, mirrors?) | 110 degrees side view angle without mirrors
Frame
Frame Construction | Steel spaceframe
Material | 4130 steel
Joining method and material | TIG welding with ER80S-D2
Bare frame weight with brackets and paint | 30kg
Crush zone material | Aluminum honeycomb student design based on standard impact attenuator
Crush zone length | 272mm
Crush zone energy capacity | 8.72kJ
I.C. Engine | N/A
Fuel type | N/A
Manufacturer / Model | N/A
No. of Cylinders | N/A
Bore | N/A
Stroke | N/A
Displacement | N/A
Muffler | N/A
Max. rated power (kW @ RPM) | N/A
Max. rated torque (N·m @ RPM) | N/A
Complete the following only if Modified per. IC1.1
Compression ratio | N/A
Induction | N/A
Throttle Body / Mechanism | N/A
Fuel System (mfgr. and type) | N/A
Other significant modifications | N/A
Accumulator / Batteries
Type | Pouch cell
Manufacturer | A123
Model No. | AMP20
Capacity (Nameplate Rating) | 20Ah
Nominal Voltage & Operating Range | 3.3V, 2V to 3.6V
Quantity (Number of Cells) | 86S1P (86 total cells)
Total battery voltage | 283.8V
Total capacity (Wh) | 5676Wh (non-derated)
Protection / Fuses | Littelfuse L50S225 Fuse
Protection / Relays | Kilovac EV200 contactors
Official FH Cost
Accumulator / Capacitors
Type | N/A
Manufacturer | N/A
Type | N/A
Capacitance | N/A
Nominal Voltage & Operating Range | N/A
Rated Voltage | N/A
Quantity (Number of Cells) | N/A
Total capacitor voltage | N/A
Total capacity (Wh) | N/A
Protection / Fuses | N/A
Protection / Relays | N/A
Official FH Cost | N/A
Drive Motor(s)
Manufacturer | Enstroj
Type | Permanent magnet axial-flux AC synchronous
Model Number | Emrax 207 Medium
Max. rated power (kW @ RPM) | 80 kW @ 6000 RPM
Max. rated torque (N·m @ RPM) | 160 Nm @ 0 RPM
Maximum voltage | 300V
Maximum current | 320Arms
Estimated efficiency range | 96% from 1500 RPM to 3500 RPM at 40 Nm to 80 Nm
Motor Controller(s)
Manufacturer | Unitek
Model Number | Bamocar D3 400-400
Maximum voltage in | 400V
Maximum voltage out | 400V
Maximum current in | 400A
Maximum current out | 400A
Estimated efficiency range | 97%
Drivetrain
Type | 4:1 planetary gearbox
Architecture | Independent rear wheel drive from planetary gearbox to half shaft
Voltage Converter 1
Type (DC/DC, Inverter, or rectifier; unidirectional or bidirectional) | N/A
Input source (bus, accumulator, generator, etc.) | N/A
Output load (bus, accumulator, generator, etc.) | N/A
Maximum input voltage | N/A
Maximum output voltage | N/A
Maximum input current | N/A
Maximum output current | N/A
Estimated efficiency range | N/A
Voltage Converter 2
Type (DC/DC, Inverter, or rectifier; unidirectional or bidirectional) | N/A
Input source (bus, accumulator, generator, etc.) | N/A
Output load (bus, accumulator, generator, etc.) | N/A
Maximum input voltage | N/A
Maximum output voltage | N/A
Maximum input current | N/A
Maximum output current | N/A
Estimated efficiency range | N/A
On-board Charger (if applicable)
Max. Voltage | N/A
Max Current | N/A
Instrumentation
Driver displays | Speed gage, fuel gage, AMS fault light, IMD fault light, software fault light, and perf/end switch
Telemetry | In helmet radio
On-board computer | Beaglebone Black
Fuel level/consumption/efficiency/state of charge | Dashboard gauge
Aerodynamics (if applicable)
Front Wing (lift/drag coef., material, weight) | N/A
Rear Wing (lift/drag coef., material, weight) | N/A
Undertray (downforce/speed) | N/A
Wing mounting | N/A
Additional Information
Body Work (material, process) | Carbone fiber nosecone made with wet layup and dacron side panels
Design style | Retro F1
