BDR16/svn-migration-dump/Mechanical/Wheel Assemblies/Brakes/Brakes Design.xls

Brakes Design
Bulldogs Racing
BR2016
Read “Brakes Design.doc” for an explanation of what this spreadsheet calculates.
Car Parameters
Mass (kg) | 300
Wheelbase (mm) | 1550
COG Height (mm) | 250
Rear Weight Bias (%) | 60
Front Tire COF | 1.5
Rear Tire COF | 1.6
Max Braking Deceleration (g) | 1.53
Tire Forces | Front | Rear
Tire Vertical Load (N) | 951.7282258 | 519.7717742
Tire Ideal Brake Force (N) | 1427.592339 | 831.6348387
Front Brake Bias | 0.6318941065 | 0.3681058935
Brake Pedal
Driver Force (N) | 660 |  | Preferably 400-900N until lock
Max Driver Force (N) | 2000 |  | Set by the rules
Max Drive Force SF | 1.5
Brake Pedal Ratio | 5 |  | Smaller pedal ratio results in less pedal travel due to compliance
Pedal Force (N) | 3300
Max Pedal Force (N) | 15000
Bias Bar | Front | Rear
Brake Percent (%) | 50 | 50
Master Cylinder Force (N) | 1650 | 1650
Max Master Cylinder Force (N) | 7500 | 7500
Hydraulic Forces | Front | Rear
Master Cylinder Diameter (in) | 0.8125 | 1.125 | Wilwood Compact Remote Flange Mount Master Cylinder
Number of Calipers | 1 | 1 | Wilwood PS1
Caliper Diameter (in) | 1.123 | 1.123
Caliper Force (N) | 6304.15254 | 3288.277096
Max Caliper Force (N) | 28655.23882 | 14946.71407
Line Pressure (psi) | 715.3912607 | 373.1516144
Max Line Pressure (psi) | 3251.778458 | 1696.143702
Brake Force | Front | Rear
Brake Pad COF | 0.6 | 0.6
Brake Caliper Radius (in) | 4 | 4
Wheel Radius (in) | 10.5 | 10.3
Brake Force (N) | 1440.949152 | 766.2004885
Max Brake Force (N) | 6549.768872 | 3482.729493
Front Brake Bias | 0.6528552145 | 0.3471447855
Thermal
Brake Pedal Travel
Caliper piston travel (min) (in) | 0.04385 | for a single piston of PS1 2-piston caliper, stock pad w/o wear, 0.18 in rotor
Caliper piston travel (max) (in) | 0.21705 | for a single piston of PS1 2-piston caliper, stock pad w/ max wear, 0.18 in rotor
Total Fluid Displaced on Front Calipers (min) (m^3) | 2.84695192e-06
Total Fluid Displaced on Front Calipers (max) (m^3) | 1.409192507e-05
Total Fluid Displaced on Rear Calipers (min) (m^3) | 2.84695192e-06
Total Fluid Displaced on Rear Calipers (max) (m^3) | 1.409192507e-05
Front MC travel required (min) (in) | 0.3350752592
Front MC travel required (max) (in) | 1.658565223 | note that the max stroke of the calipers are 1.12 in
Rear MC travel required (min) (in) | 0.1747769099
Rear MC travel required (max) (in) | 0.8651158106 | note that the max stroke of the calipers are 1.12 in
 |  | design the system to allow 1 in MC travel on both MCs
