BDR16/svn-migration-dump/Mechanical/Wheel Assemblies/Suspension/Suspension Design.xls

Sheet: New Method
Sprung Mass (kg) | 260.00
Rear Weight Bias (%) | 60.00
Nominal Ride Height (mm) | 31.75
Max Roll Gradient (deg/g) | 1.56
 | Front |  |  |  | Rear
 | 0.00 | 0.25 | 1.00 | 1.25 | 0.00 | 0.25 | 1.00 | 1.25
Bump Spring Travel (mm) | 233.65 | 227.33 | 208.83 | 202.87 | 233.65 | 227.01 | 207.27 | 200.89
Droop Spring Travel (mm) | 233.65 | 240.02 | 259.53 | 266.16 | 233.65 | 240.29 | 260.21 | 266.79
Bump Motion Ratio |  | 1.00 | 0.98 | 0.97 |  | 1.05 | 1.04 | 1.03
Droop Motion Ratio |  | 1.00 | 1.02 | 1.02 |  | 1.05 | 1.05 | 1.04
 | Front | Rear |  | Spring (N/mm)
Sprung Mass (kg) | 52.00 | 78.00 |  | 11.4
Track Width (mm) | 1258.49 | 1182.29 |  | 14.9
COG Height (mm) | 250.00 | 200.00 |  | 16.6
Roll Center Height (mm) | 46.56 | 37.18 |  | 19.3
Tire Rate (N/mm) | 110.50 | 114.00 |  | 25.4
Spring Rate (N/mm) | 14.90 | 19.30
Wheel Rate (N/mm) | 14.84 | 20.95
Ride Rate (N/mm) | 13.08 | 17.70
Natural Frequency (Hz) | 2.52 | 2.40
Max Acceleration (g) | 7.99 | 7.20
Max Bump Spring Travel (mm) | 30.78 | 32.76
Max Droop Spring Travel (mm) | 32.51 | 33.14
Roll Rate (Nm/deg) | 180.82 | 215.88
Roll Gradient (deg/g) | 0.57 | 0.58
Roll Gradient (deg/g) | 1.18
Magic Number | 0.46
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
