BDR16/svn-migration-dump/Administration/Project Management/Project Management Application to BDR.pptx

## Project Management Application to BDR

Sunday October 4th, a beautiful day

## Introduction to PM

- Tool to aid in meeting project goals and timeline
- Creates a process for moving through a project and adapting to change
- Facilitates design succession
- Not an obstacle that impedes work

Bulldogs Racing

Notes: 4-5 day seminar focusing on vehicle dynamics from a data standpoint. Started with the tire data and moved towards suspension. It was a lot of work. Got a giant binder and an excel sheet with a lot of the calculation. On the way back, Saw belter’s house.

## Introduction to PM

## PM Applied to FH

- Project Plan 10/18
- Interim Report 2/3
- Presentation – Day of Static Events

## Project Plan – Outline of project

- Scope/Objectives presented in SOW
- Team Structure outlined in WBS
- Gantt Chart based on WP
- Change Management plan
- Succession Plan

## Interim Report – how are we doing

- Issued regularly throughout the project
- Identifies the project Status by comparing current state and real state
- Indicates any deviation from original plan through the use of change management

## Interim Report – how are we doing

## PM Presentation – Convince judges that the plan was

- carefully made
- Dynamically and flexible executed (change management)
- That information will be passed on
