BDR16/svn-migration-dump/Administration/Competition Forms/Formula Electric/ESA ESO Form/2016 FSAE ESA ESO Yale University.pdf

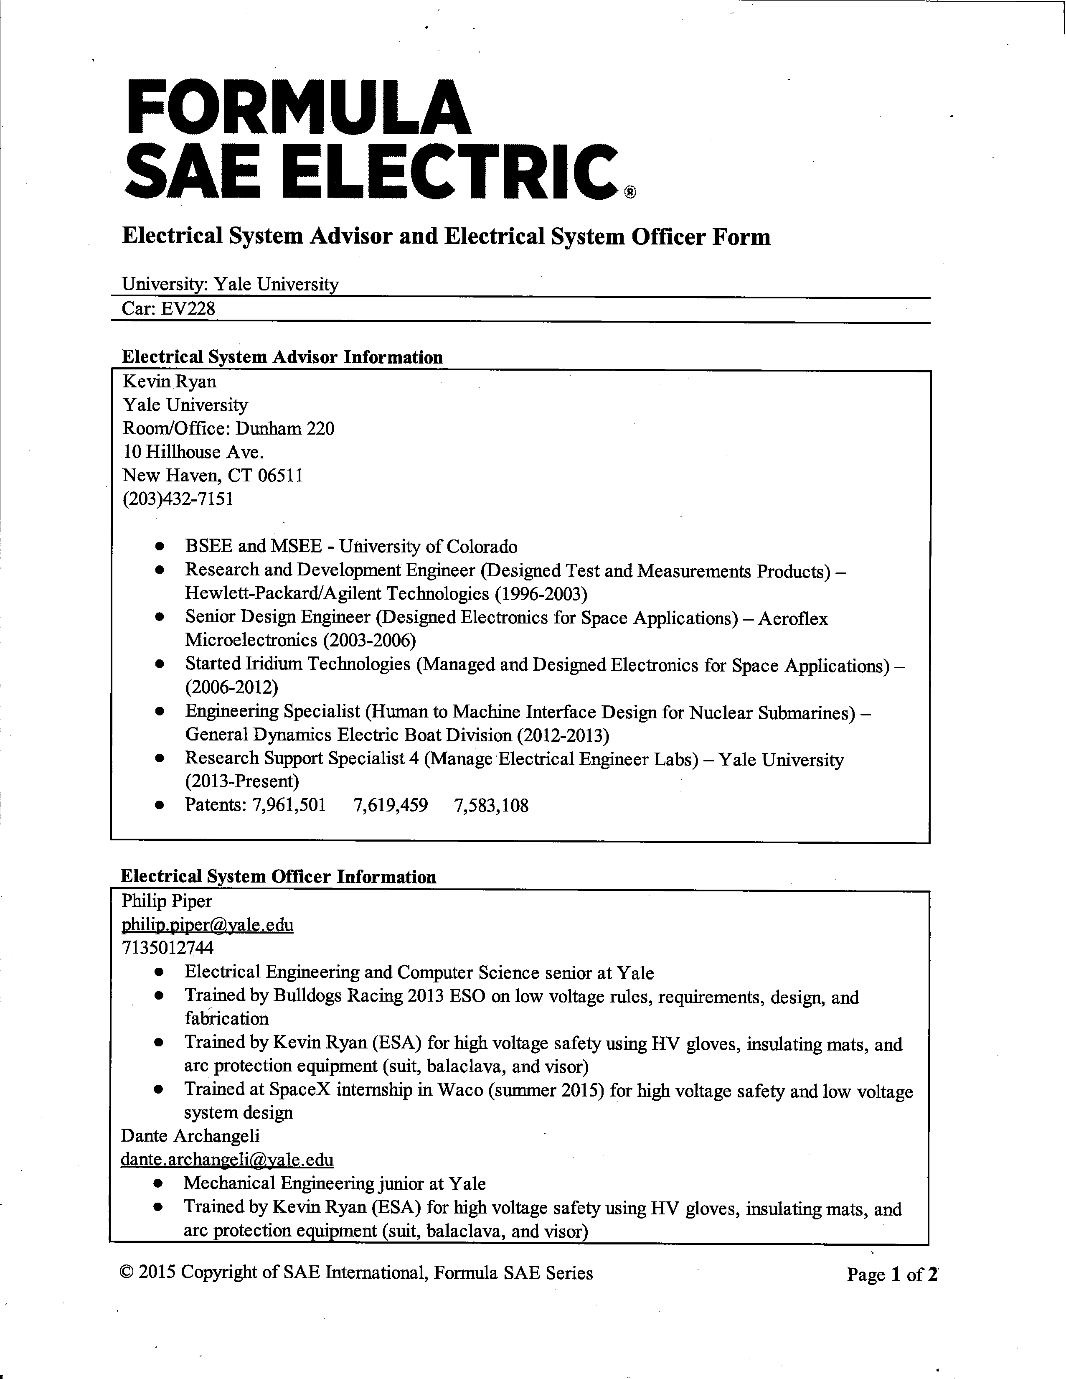
[picture p61: page 1]
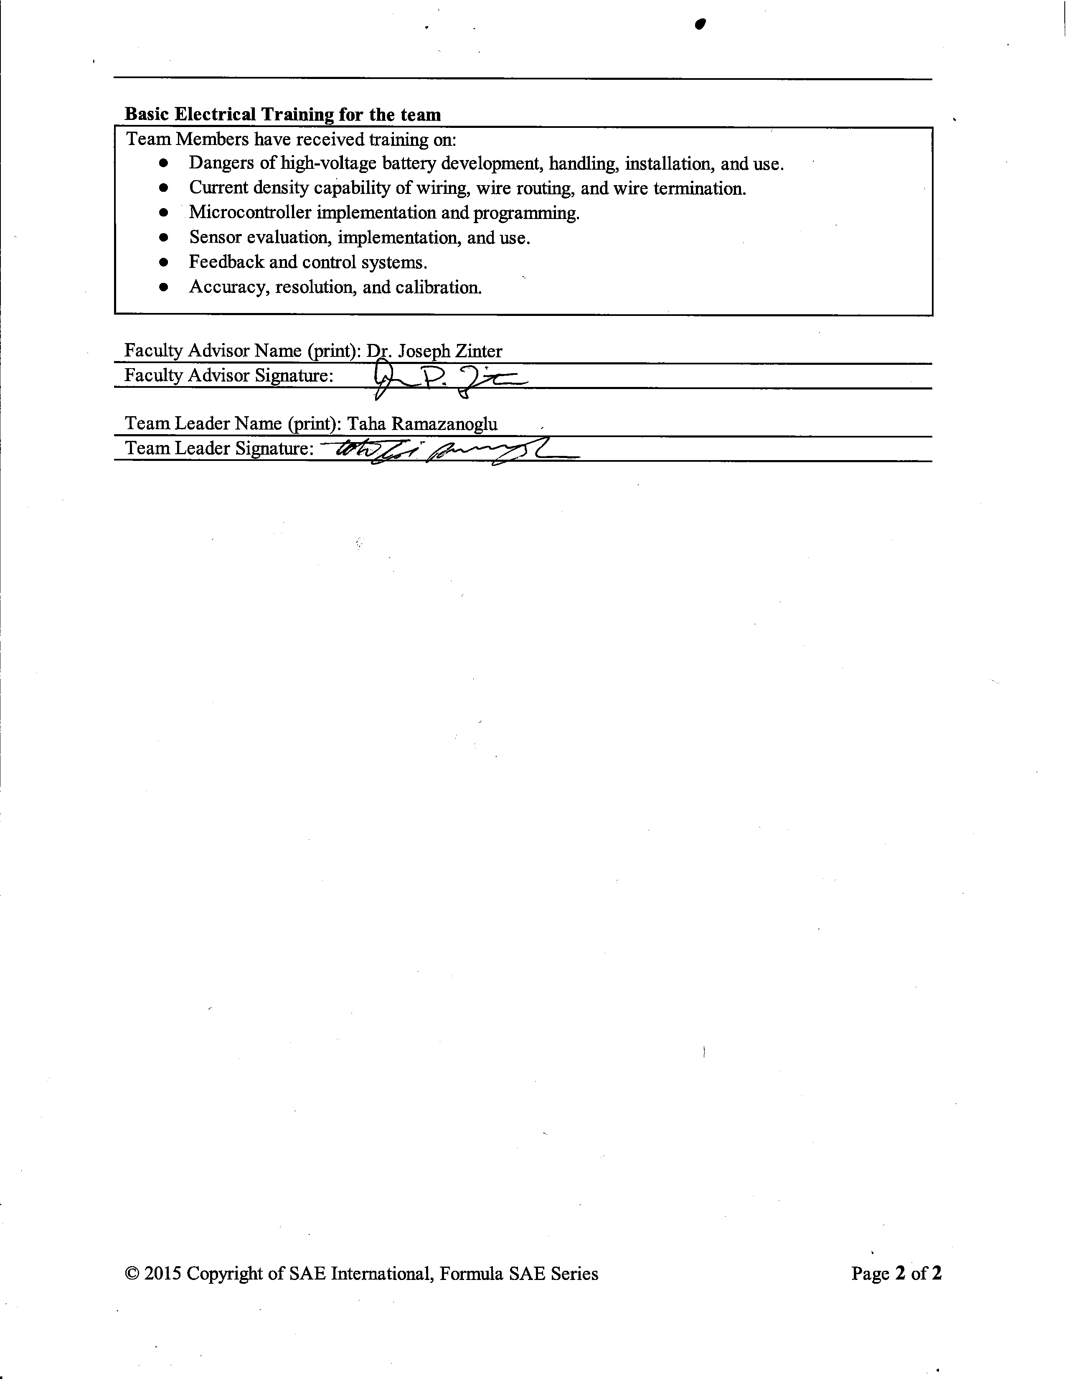
[picture p62: page 2]
