BDR16/svn-migration-dump/Administration/Competition Forms/Formula Electric/ESF/Photos/2.3.PNG

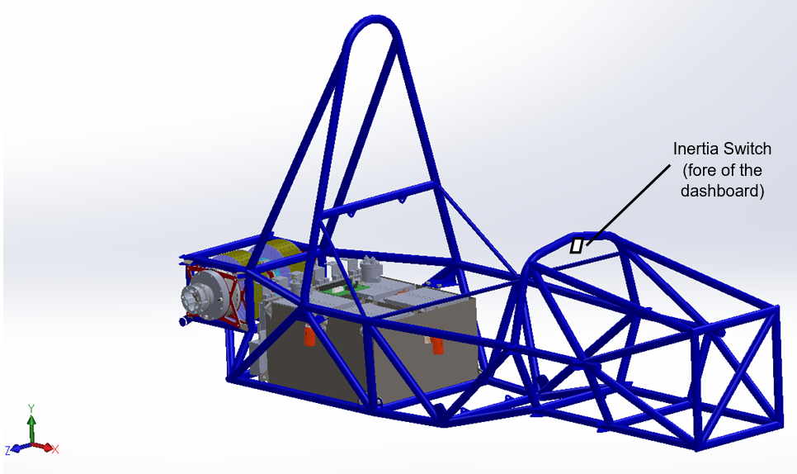
Administration/Competition Forms/Formula Electric/ESF/Photos/2.3.PNG
