BDR16/svn-migration-dump/Administration/Competition Forms/Formula Electric/ESF/Photos/2.5.PNG

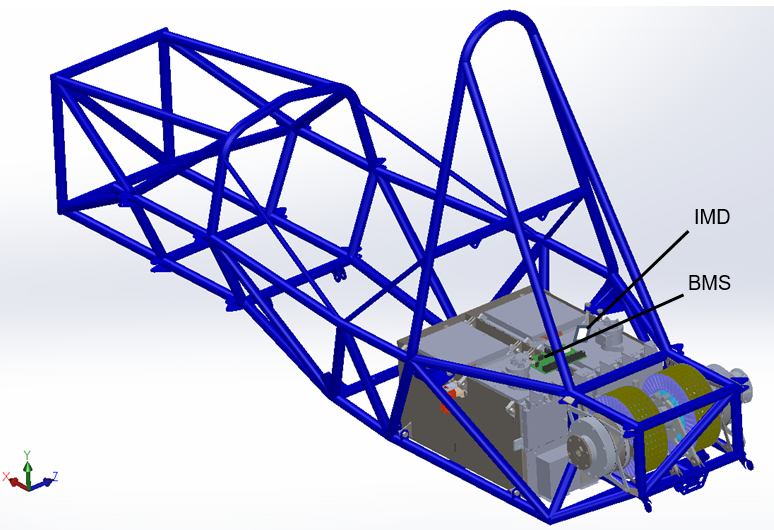
Administration/Competition Forms/Formula Electric/ESF/Photos/2.5.PNG
