BDR16/svn-migration-dump/Administration/Competition Forms/Formula Electric/ESF/Photos/4.3 Energy Meter - Copy.JPG

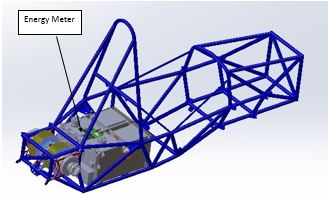
Administration/Competition Forms/Formula Electric/ESF/Photos/4.3 Energy Meter - Copy.JPG
