BDR16/svn-migration-dump/Administration/Competition Forms/Formula Electric/ESF/Photos/7.4.PNG

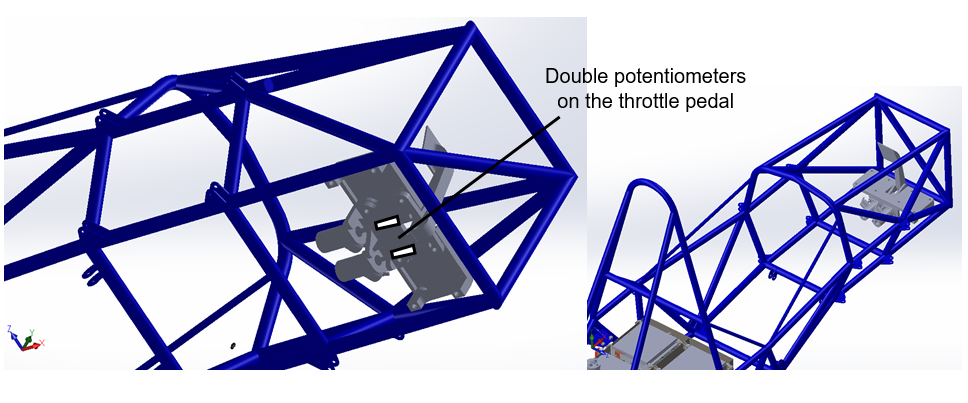
Administration/Competition Forms/Formula Electric/ESF/Photos/7.4.PNG
