BDR16/svn-migration-dump/Administration/Competition Forms/Formula Electric/ESF/Photos/8.1.3 DC-DC converttrt.JPG

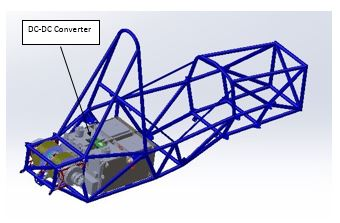
Administration/Competition Forms/Formula Electric/ESF/Photos/8.1.3 DC-DC converttrt.JPG
