BDR16/svn-migration-dump/Administration/Competition Forms/Formula Electric/ESF/Photos/10.1.2 Firewall - Copy.JPG

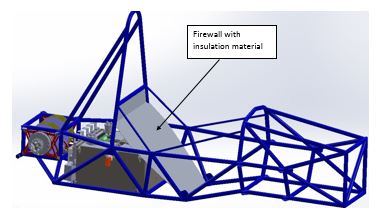
Administration/Competition Forms/Formula Electric/ESF/Photos/10.1.2 Firewall - Copy.JPG
