BDR16/svn-migration-dump/Administration/Competition Forms/Formula Electric/ESF/Photos/Accumulator Bot.png

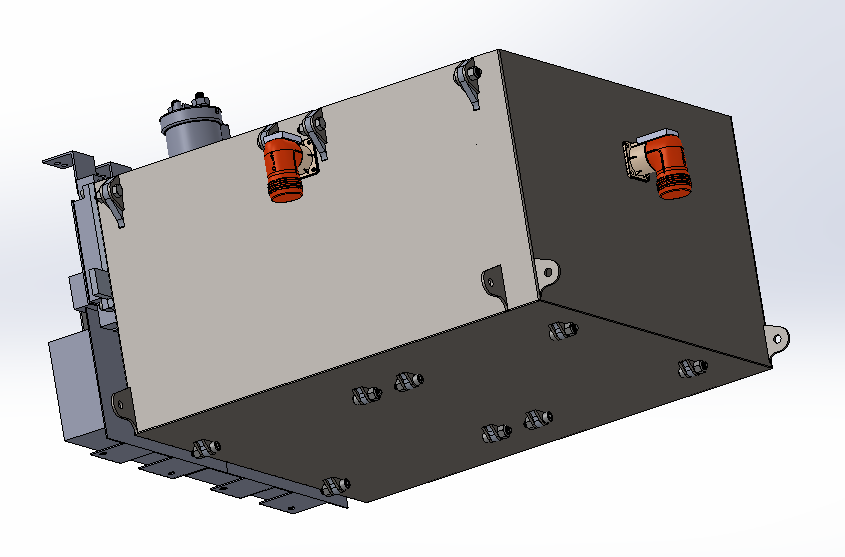
Administration/Competition Forms/Formula Electric/ESF/Photos/Accumulator Bot.png
