BDR16/svn-migration-dump/Administration/Competition Forms/Formula Electric/ESF/Photos/Accumulator box in the car for Phil.PNG

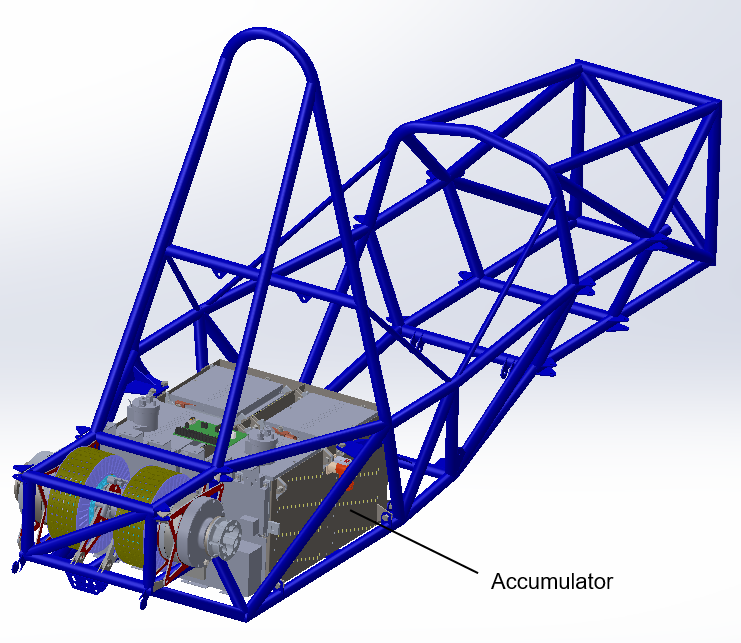
Administration/Competition Forms/Formula Electric/ESF/Photos/Accumulator box in the car for Phil.PNG
