BDR16/svn-migration-dump/Administration/Competition Forms/Formula Electric/ESF/Photos/BSPD.png

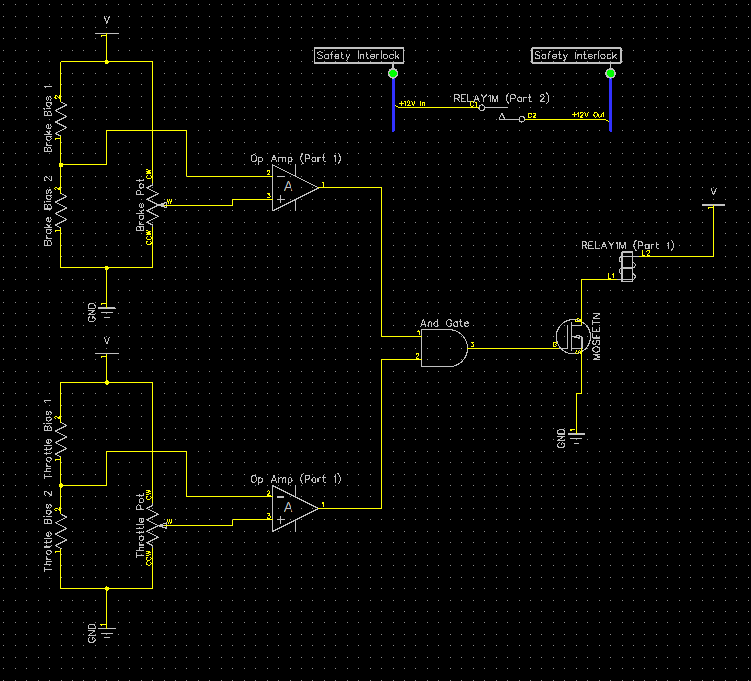
Administration/Competition Forms/Formula Electric/ESF/Photos/BSPD.png
