BDR16/svn-migration-dump/Administration/Competition Forms/Formula Electric/ESF/Photos/Buzzer.png

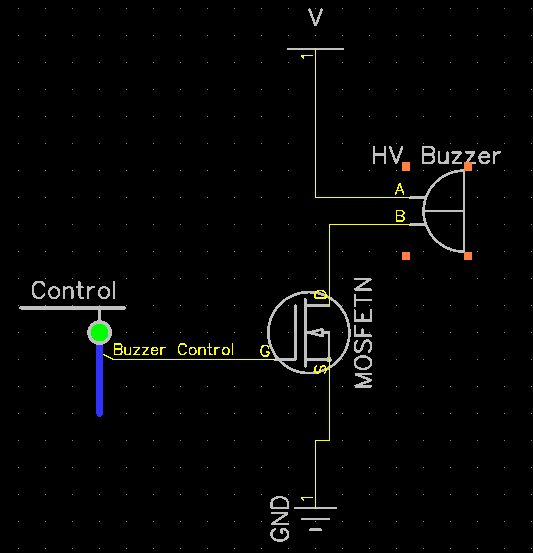
Administration/Competition Forms/Formula Electric/ESF/Photos/Buzzer.png
