BDR16/svn-migration-dump/Administration/Competition Forms/Formula Electric/ESF/Photos/Energy Meter Schematic.png

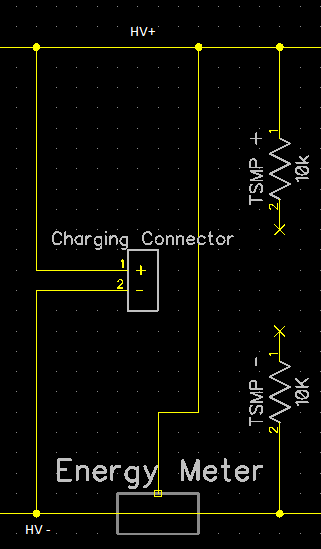
Administration/Competition Forms/Formula Electric/ESF/Photos/Energy Meter Schematic.png
