BDR16/svn-migration-dump/Administration/Competition Forms/Formula Electric/ESF/Photos/HV Indicator.png

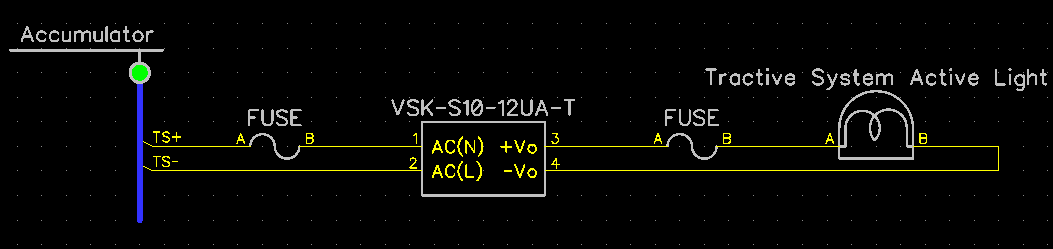
Administration/Competition Forms/Formula Electric/ESF/Photos/HV Indicator.png
