BDR16/svn-migration-dump/Administration/Competition Forms/Formula Electric/ESF/Photos/IMD Latching Circuit.png

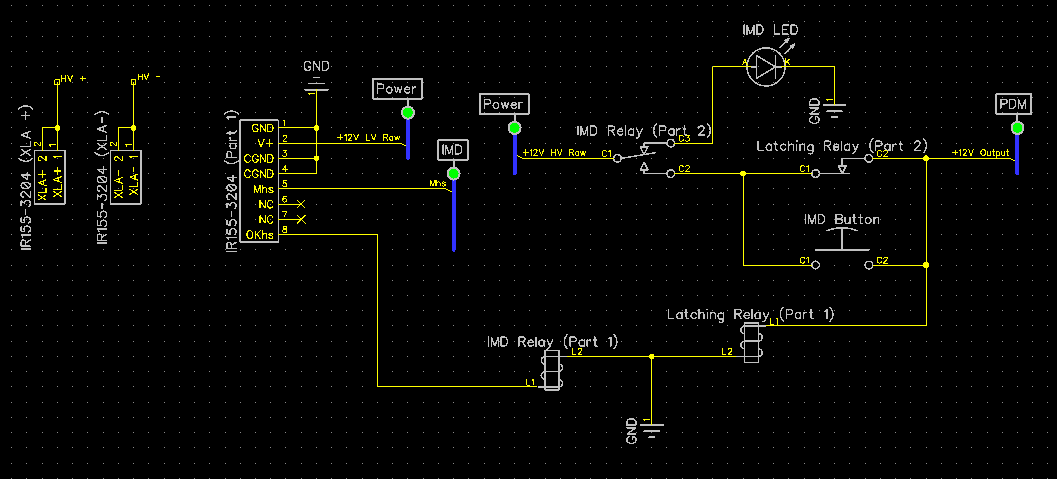
Administration/Competition Forms/Formula Electric/ESF/Photos/IMD Latching Circuit.png
