BDR16/svn-migration-dump/Administration/Competition Forms/Formula Electric/ESF/Photos/Latching Circuit.png

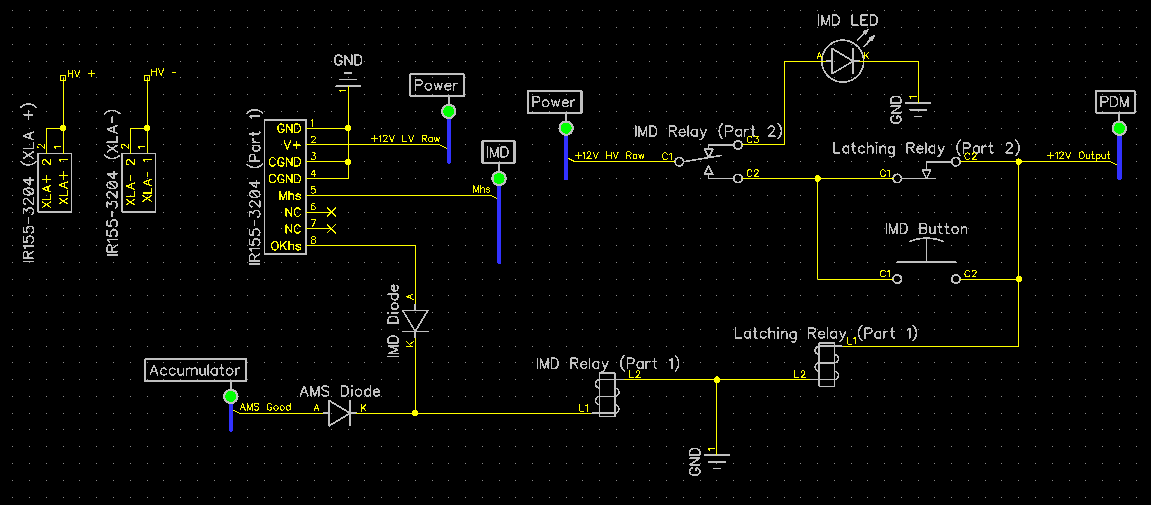
Administration/Competition Forms/Formula Electric/ESF/Photos/Latching Circuit.png
