BDR16/svn-migration-dump/Administration/Competition Forms/Formula Electric/ESF/Photos/Motor Controller Schematic Diagram.png

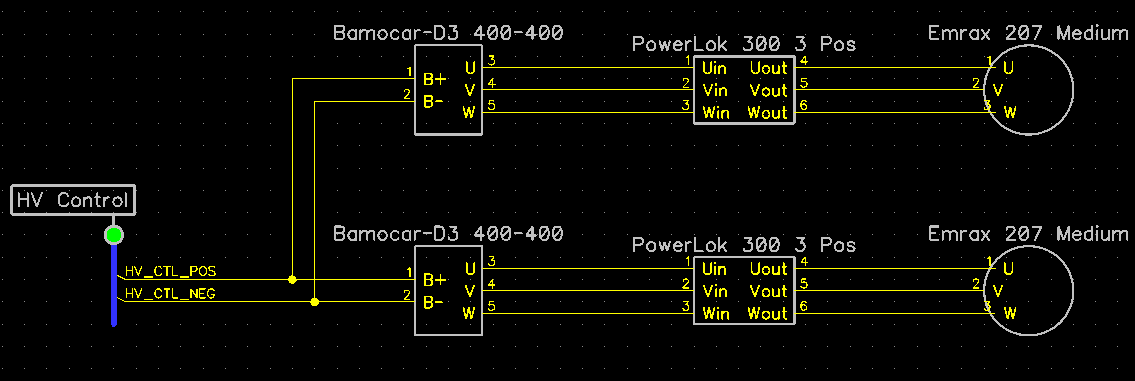
Administration/Competition Forms/Formula Electric/ESF/Photos/Motor Controller Schematic Diagram.png
