BDR16/svn-migration-dump/Administration/Competition Forms/Formula Electric/ESF/Photos/Safety Interlock Physical Buttons.png

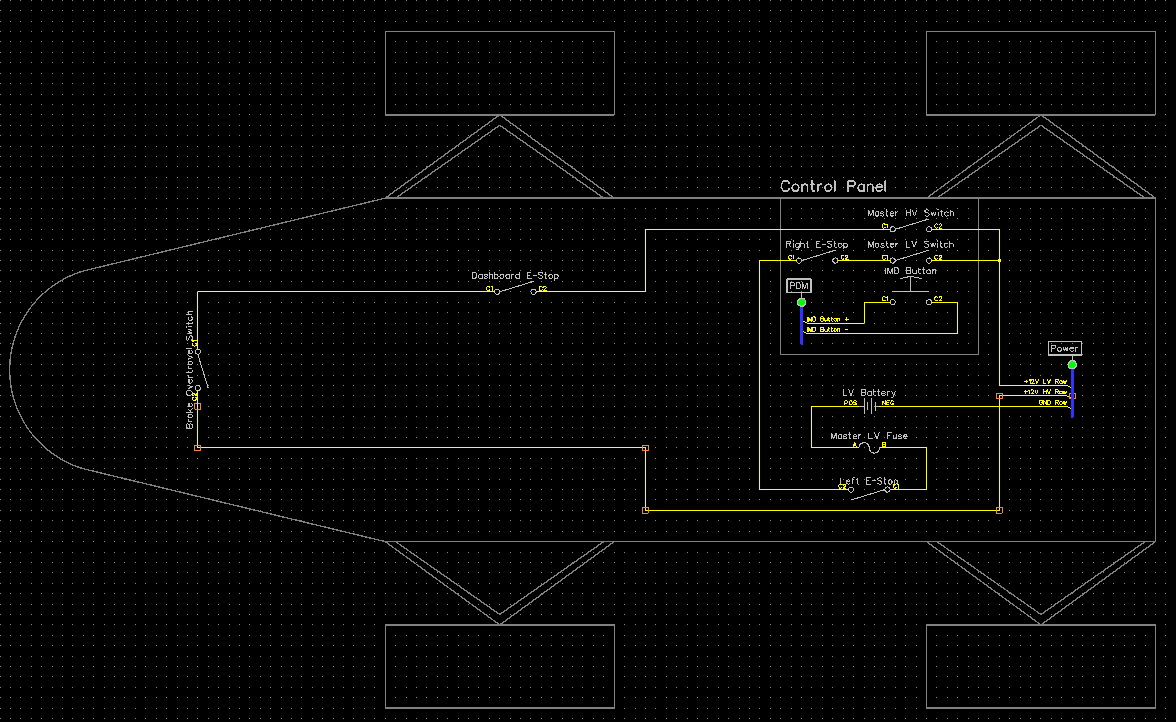
Administration/Competition Forms/Formula Electric/ESF/Photos/Safety Interlock Physical Buttons.png
