BDR16/svn-migration-dump/Administration/Competition Forms/Formula Electric/ESF/Photos/Stack Big Picture.png

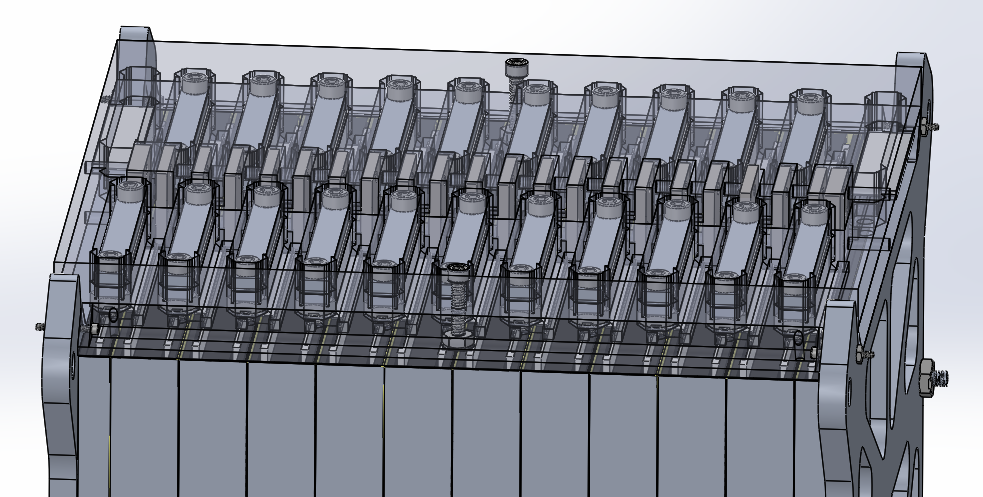
Administration/Competition Forms/Formula Electric/ESF/Photos/Stack Big Picture.png
