BDR16/svn-migration-dump/Administration/Competition Forms/Formula Electric/ESF/Photos/Stack Small.png

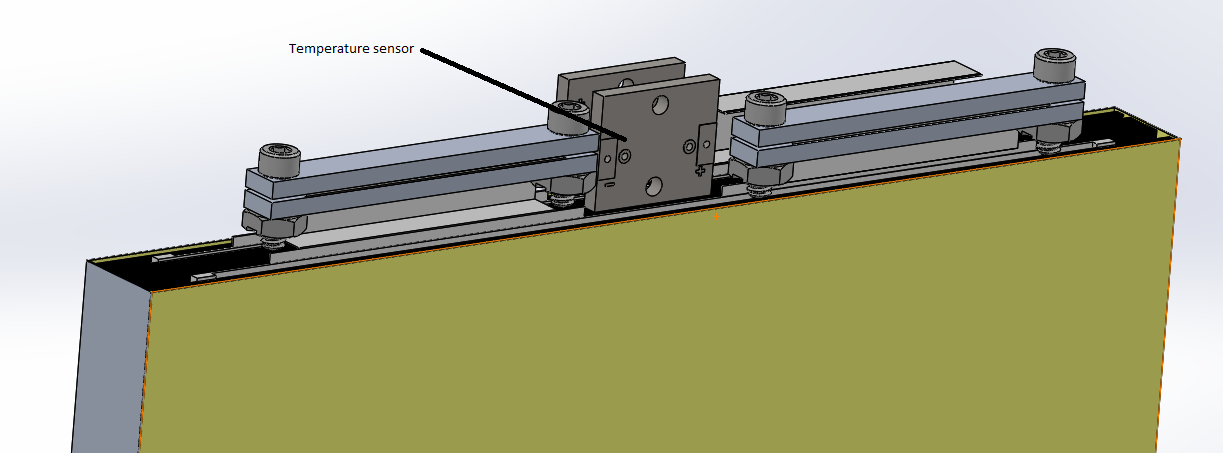
Administration/Competition Forms/Formula Electric/ESF/Photos/Stack Small.png
