BDR16/svn-migration-dump/Administration/Competition Forms/Formula Electric/ESF/Photos/Throttel Schematic.png

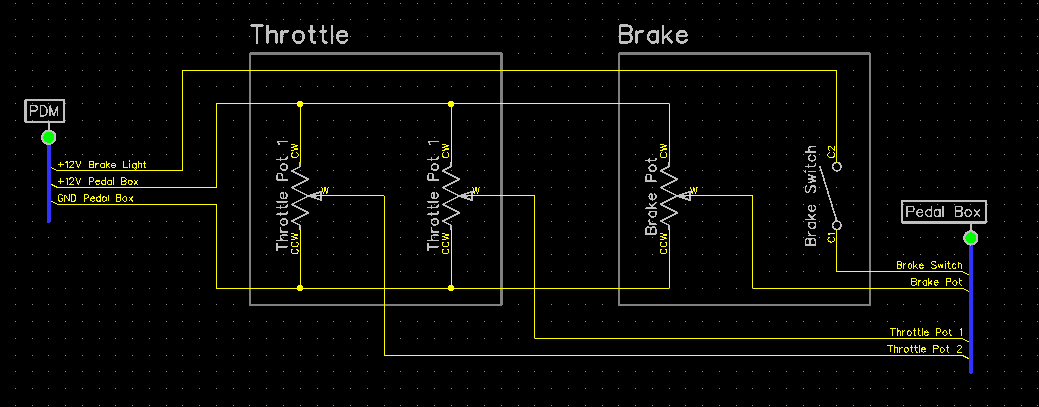
Administration/Competition Forms/Formula Electric/ESF/Photos/Throttel Schematic.png
