BDR16/svn-migration-dump/Administration/Competition Forms/Formula Hybrid/Team Photo.jpg

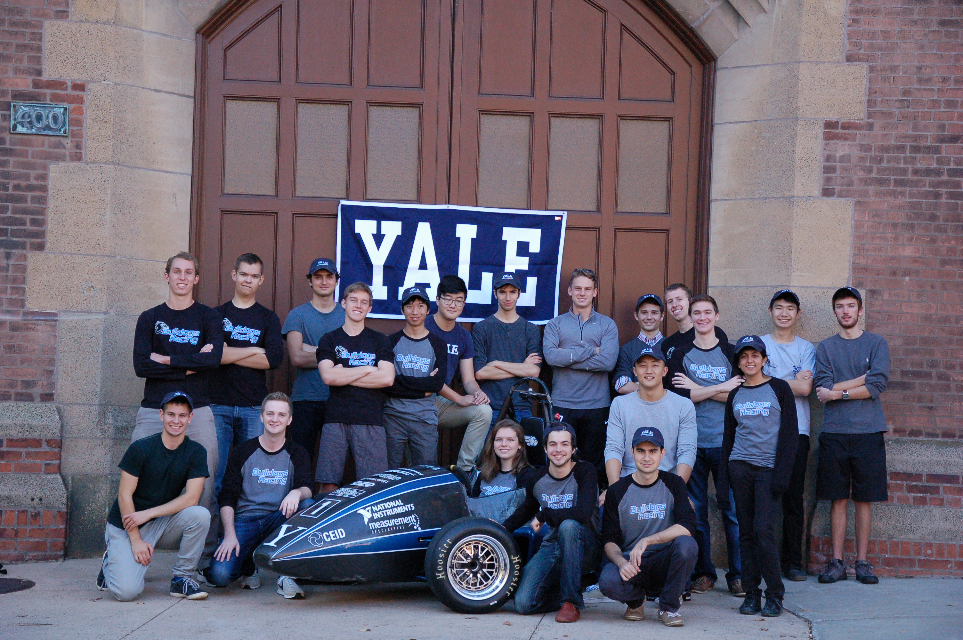
Administration/Competition Forms/Formula Hybrid/Team Photo.jpg
