BDR16/svn-migration-dump/Administration/Competition Forms/Formula North/E06_Yale_Program Submission/Schematics/Top.jpg

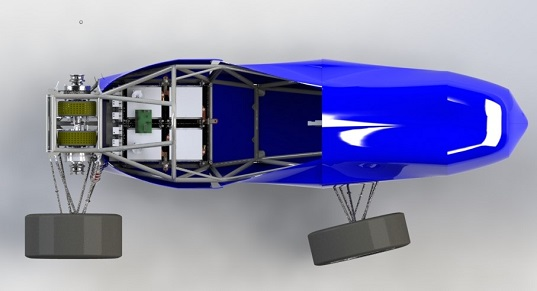
Administration/Competition Forms/Formula North/E06_Yale_Program Submission/Schematics/Top.jpg
