BDR16/svn-migration-dump/Administration/Competition Forms/Formula North/Quiz/Quiz Page 2.png

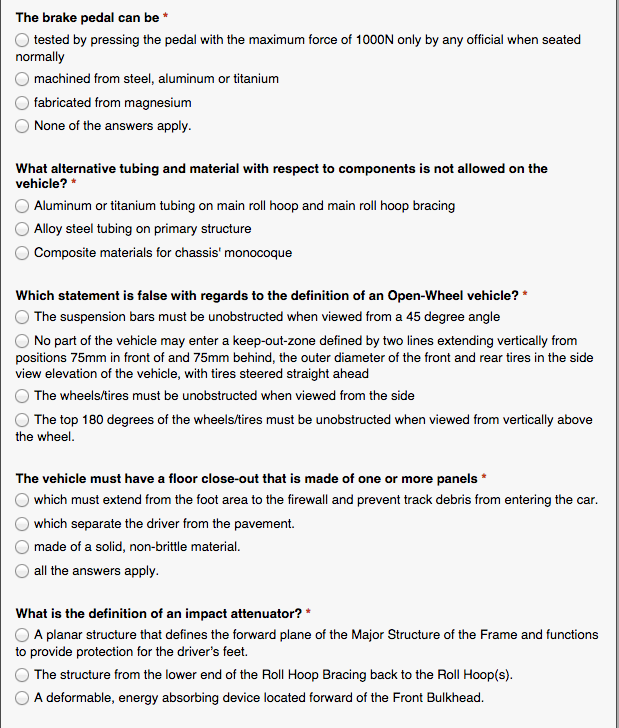
Administration/Competition Forms/Formula North/Quiz/Quiz Page 2.png
