BDR16/svn-migration-dump/Administration/Competition Forms/Formula North/Quiz/Quiz Page 4.png

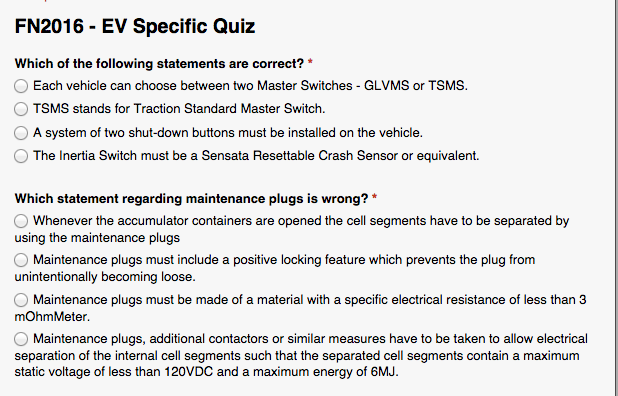
Administration/Competition Forms/Formula North/Quiz/Quiz Page 4.png
