BDR16/svn-migration-dump/Administration/Conventions/Design Flow Chart.png

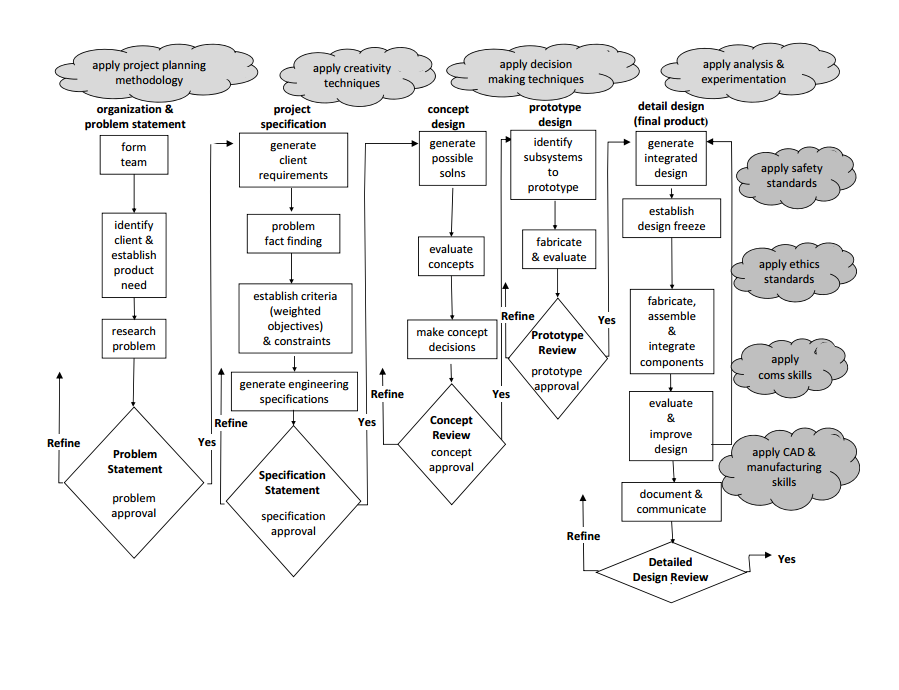
Administration/Conventions/Design Flow Chart.png
