BDR16/svn-migration-dump/Administration/Project Management/Gantt Chart/Gantt Full.jpg

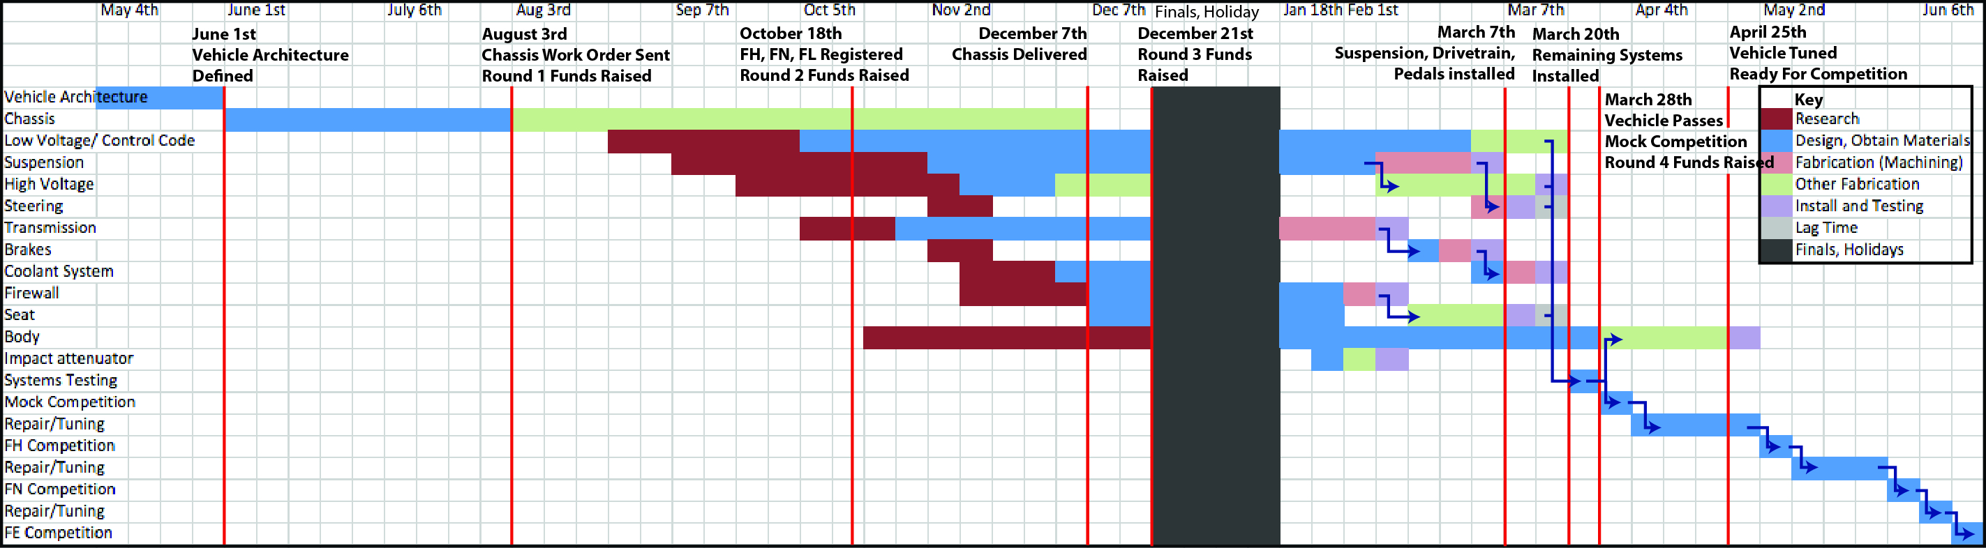
Administration/Project Management/Gantt Chart/Gantt Full.jpg
