BDR16/svn-migration-dump/Mechanical/Controls/Steering Wheel Materials.rtf

Urecoat: this will be painted on the inside of the mold so that when the grips are poured, they will have a grippy coating.
http://www.smooth-on.com/index.php?cPath=1434_1434

Flex Foam IT: this is a flexible foam that smooth-on inc recommended. I haven't quite decided on which density to get. The video on the website is number ten and I think we should go stiffer than that. They don't give much in terms of the elasticity or tear strength for each density.
http://www.smooth-on.com/index.php?cPath=1121

Moldstar: for mold making, they recommended Moldstar silicone rubber. I think the highest density should work well because we are using expanding rubber and we don't want the mold to deform during the expansion.
http://www.smooth-on.com/Silicone-Rubber-an/c2_1115_1341/index.html

US composites has a plasticine clay for molding that is compatible with the molding rubber. The catalog number is:
KLY-02
http://www.uscomposites.com/moldmaking.html

The only other part we would need for the steering wheel is the disconnect which is sold by Summit racing. This is the cheapest one that I could find that was similar to the one we have now:
http://www.summitracing.com/parts/qcr-68-015/overview/
