BDR16/svn-migration-dump/Administration/Orders/3_18_16 Order.ods

Sheet: Cooling
Total | 326.52
Name | Company | Product | Supplier | Quantity | Unit Price ($) | Link | Comments
NACA duct | Pegasus | Small NACA duct | Pegasus | 2 | 21.49 | https://www.pegasusautoracing.com/productselection.asp?Product=3627 | Black
Air duct | Pegasus | Neoprene 2.5” duct | Pegasus | 1 | 17.29 | https://www.pegasusautoracing.com/productselection.asp?Product=3620 | Part No. 3620-2.50-3 FOOT
Radiator | Motor Parts Mall | 266mm x 220mm | Motor Parts Mall | 1 | 85.95 | http://www.motorpartsmall.com/index.php?main_page=product_info&cPath=53_60&products_id=1369
Pump | Swiftech | Laing D5 Vario | Amazon | 1 | 94.99 | http://www.amazon.com/Swiftech-MCP655TM-Laing-Vario-controller/dp/B001G6S1JY
1/2” coolant line | Small Parts | 1/2” ID, 11/16” OD | Amazon | 1 | 24.85 | http://www.amazon.com/dp/B000FN1G6Y/ref=biss_dp_t_asn | 10' length
1/2” 1/2” barb union | Anderson Metals | 1/2” 1/2” barb union | Amazon | 1 | 4.5 | http://www.amazon.com/Anderson-Metals-Brass-Fitting-Union/dp/B0070TVBAW"+1%2F2"+barb+union | Choose 1/2” x 1/2” Barb
5/8” to 1/2” reducer | Pegasus | 5/8” x 1/2” straight reducer | Pegasus | 1 | 8.99 | https://www.pegasusautoracing.com/productdetails.asp?RecID=2806
Water block copper | Mueller B&K | 3/8” soft copper coil | Amazon | 1 | 21.54 | http://www.amazon.com/Mueller-UT06025-General-Purpose-Utility-Copper/dp/B00S04F8Z0
Water block tube nut | Eaton Weatherhead | 100X6 3/8” inv flare nut | Amazon | 2 | 1.46 | http://www.amazon.com/Eaton-Weatherhead-100X6-Inverted-Fitting/dp/B00VG35Y3I" | Choose the 1 option
Mot ctl dual flare to barb | Anderson Metals | 5/8”-18 male flare to 1/2” barb | Amazon | 1 | 7.55 | http://www.amazon.com/Anderson-Metals-Swivel-Fitting-Connector/dp/B0070TWKO8 | Choose 1/2” Barb x 5/8” Dual Seat Flare
Ctl rad dual flare to barb | Anderson Metals | 5/8”-18 male flare to 5/8” barb | Amazon | 1 | 7.66 | http://www.amazon.com/Anderson-Metals-Swivel-Fitting-Connector/dp/B0070TWKO8 | Choose 5/8” Barb x 5/8” Dual Seat Flare
Hose clamps | Precision Brand | M10S Micro Seal 1/2” | Amazon | 1 | 7.3 | http://www.amazon.com/Precision-Brand-Micro-Miniature-Stainless/dp/B007Q4YDOC?s=industrial | Choose ½ inches; pack of 10

Sheet: Brakes
Total | 293.07
Name | Company | Product | Supplier | Quantity | Unit Price ($) | Link | Comments
Banjo bolt | Earl's Performance Plumbing | M10-1.25 | Jegs | 4 | 4.99 | http://www.jegs.com/i/JEGS-Performance-Products/555/100736/10002/-1?parentProductId=
Banjo to AN3 | Earl's Performance Plumbing | 3/8” (10mm) to #3 | Jegs | 4 | 7.72 | http://www.jegs.com/i/Earls/361/997603/10002/-1?parentProductId=#moreDetails
Crush washer | Earl's Performance Plumbing | 10mm | Pegasus Racing | 12 | 0.79 | https://www.pegasusautoracing.com/productselection.asp?Product=3241 | Part No. 3241-3/8
Braided brake line | Earl's Performance Plumbing | Speed-Flex Hose -3AN | Jegs | 1 | 62.96 | http://www.jegs.com/i/Earls/361/620003/10002/-1?parentProductId=#moreDetails | 20 feet
Hose end | Jegs | 3AN hose end | Jegs | 12 | 5.99 | http://www.jegs.com/i/JEGS-Performance-Products/555/104000/10002/-1
Tee adapter | Jegs | 3AN by 3 steel tee | Jegs | 2 | 7.99 | http://www.jegs.com/i/JEGS-Performance-Products/555/100720/10002/-1
Hard line tube nut | Jegs | 3/16” - 3AN steel nut | Jegs | 1 | 3.99 | http://www.jegs.com/i/JEGS-Performance-Products/555/100385/10002/-1?parentProductId=#moreDetails | Pack of 6
Hard line tube sleeve | Jegs | 3/16” - 3AN steel sleeve | Jegs | 1 | 3.99 | http://www.jegs.com/i/JEGS-Performance-Products/555/100395/10002/-1?parentProductId=#moreDetails | Pack of 6
Hard line | Jegs | 3/16” NiCopp hard line | Jegs | 1 | 49.99 | http://www.jegs.com/i/JEGS-Performance-Products/555/635800/10002/-1?parentProductId=2111534 | 25 feet
NPT to AN fitting | Pegasus Racing | 1/8 NPT to 3AN | Pegasus Racing | 2 | 1.99 | https://www.pegasusautoracing.com/productselection.asp?Product=3250&scid=scplp11654763 | Part #3250-02-03S
AN male to male union | Pegasus Racing | 3AN to 3AN male union | Pegasus Racing | 1 | 4.69 | https://www.pegasusautoracing.com/productselection.asp?Product=3225 | Part no: 3225-03-03S
Rear caliper bolts | Drilled Head Bolts | M8-1.25 30mm | Drill Head Bolts | 1 | 7.86 | http://www.drilledheadbolts.com/DH-G88-HEX-M8-125-X-30MM-10-PCS-SDH80812530.htm | Pack of 10
Front caliper bolts | Drilled Head Bolts | M8-1.25 20mm | Drill Head Bolts | 1 | 7.43 | http://www.drilledheadbolts.com/DH-G88-HEX-M8-125-X-20MM-10-PCS-SDH80812520.htm | Pack of 10

Sheet: Steering
Total | 6.92
Name | Company | Product | Supplier | Quantity | Unit Price ($) | Link | Comments
Flanged bushing | McMaster Carr | 1.25” OD 1” ID | McMaster Carr | 2 | 3.46 | http://www.mcmaster.com/#6389k559/=11l3qov
Bushing housing | Anyone | 1.5” OD and <= 1.25” ID | Anywhere | 4 |  |  | I'll let you choose supplier in case you want to minimize cost. Aircraft Spruce or McMaster Carr would work. Quantity in inches.

Sheet: Charging PCB
Total | 43.94
Name | Company | Product | Supplier | Quantity | Unit Price ($) | Link | Comments
Charger fault LED | APEM | Q8R1BXXY110E | Newark | 1 | 1.78 | http://www.newark.com/apem/q8r1bxxy110e/panel-mount-indicator-led-8mm/dp/16R0187
Charger fault LED | APEM | Q14F1CXXR110E | Newark | 2 | 2.81 | http://www.newark.com/apem/q14f1cxxr110e/panel-mount-indicator-led-14mm/dp/15R9884
Charger fault relay | TE Connectivity | OUAZ-SS-112L | Newark | 2 | 2.14 | http://www.newark.com/te-connectivity-oeg/ouaz-ss-112l-900/relay-signal-spdt-120vac-24vdc/dp/73J6576
Charger latch relay | TE Connectivity | RTE24615 | Newark | 1 | 5.79 | http://www.newark.com/te-connectivity-schrack/rte24615/relay-dpdt-250vac-8a/dp/48F3750
Charger fault relay | TE Connectivity | T9AS5D12-12 | Digikey | 2 | 3.5 | http://www.digikey.com/product-detail/en/te-connectivity-potter-brumfield-relays/T9AS5D12-12/PB306-ND/254523
Charger latch relay | TE Connectivity | T92S11A12-120 | Digikey | 1 | 15.53 | http://www.digikey.com/product-detail/en/te-connectivity-potter-brumfield-relays/8-1393211-0/PB1412-ND/1127987
High V/C connector | Phoenix Contact | SPT 3 pos 1991105 | Digikey | 2 | 1.6 | http://www.digikey.com/product-detail/en/phoenix-contact/1991105/277-6710-ND/2527262
6 position connector | Phoenix Contact | Combicon PTSA 6 pos | Digikey | 1 | 0.74 | http://www.digikey.com/product-detail/en/phoenix-contact/1985234/277-1626-ND/568663

Sheet: LV PCB
Total | 0.77
Name | Company | Product | Supplier | Quantity | Unit Price ($) | Link | Comments
10V reference | TI | LM4040DIZ-10 | Digikey | 1 | 0.77 | http://www.digikey.com/product-detail/en/texas-instruments/LM4040DIZ-10.0%2FNOPB/LM4040DIZ-10.0%2FNOPB-ND/212716
