BDR16/svn-migration-dump/Administration/Orders/3_25_16 Order.ods

Sheet: Cooling
Total | 28.95
Name | Company | Product | Supplier | Quantity | Unit Price ($) | Link | Comments
5/8” to 1/2” reducer | Pegasus | 5/8” x 1/2” straight reducer | Pegasus | 1 | 8.99 | https://www.pegasusautoracing.com/productdetails.asp?RecID=2806
3/8” comp to 3/8” NPT male | Parker | CPI 6-6 | Amazon | 2 | 4.48 | http://www.amazon.com/Parker-4-4-FBZ-B-Compression-Fitting/dp/B005CD2O7M?s=industrial|Threaded+NPT | Choose 3/8” x 3/8” NPT Male
1/2” barb to 3/8” NPT fem | Anderson Metals | 1/2” Barb x 3/8” NPT female | Amazon | 2 | 5.5 | http://www.amazon.com/Anderson-Metals-Fitting-Connector-Female/dp/B0070TU3UQ | Choose 1/2” Barb x 3/8” NPT Female

Sheet: Brakes
Total | 5.99
Name | Company | Product | Supplier | Quantity | Unit Price ($) | Link | Comments
Replacement olives | Jegs | 3AN brass olives | Jegs | 1 | 5.99 | http://www.jegs.com/i/JEGS-Performance-Products/555/104050-1/10002/-1?parentProductId=1300664 | Pack of 4

Sheet: Charging PCB
Total | 89.29
Name | Company | Product | Supplier | Quantity | Unit Price ($) | Link | Comments
Charger fault relay | TE Connectivity | T9AS5D12-12 | Digikey | 2 | 3.5 | http://www.digikey.com/product-detail/en/te-connectivity-potter-brumfield-relays/T9AS5D12-12/PB306-ND/254523
Charger latch relay | TE Connectivity | T92S11A12-120 | Digikey | 1 | 15.53 | http://www.digikey.com/product-detail/en/te-connectivity-potter-brumfield-relays/8-1393211-0/PB1412-ND/1127987
High V/C connector | Phoenix Contact | SPT 3 pos 1991105 | Digikey | 2 | 1.6 | http://www.digikey.com/product-detail/en/phoenix-contact/1991105/277-6710-ND/2527262
6 position connector | Phoenix Contact | Combicon PTSA 6 pos | Digikey | 1 | 0.74 | http://www.digikey.com/product-detail/en/phoenix-contact/1985234/277-1626-ND/568663
Charger connector | Harwin Inc | Datamate female | Digikey | 1 | 13.33 | http://www.digikey.com/product-detail/en/harwin-inc/M80-4C10205F1-02-325-00-000/952-1244-ND/2264231
Charger connector | Harwin Inc | Datamate male | Digikey | 1 | 20.92 | http://www.digikey.com/product-detail/en/harwin-inc/M80-5T10205M1-02-331-00-000/952-1245-ND/2264232
Step down butt splice | Molex | 8 to 10-12 AWG | Digikey | 3 | 1.68 | http://www.digikey.com/product-detail/en/molex-llc/0191540044/WM4327-ND/2421258
Butt splice | Molex | 8 AWG | Digikey | 3 | 0.87 | http://www.digikey.com/product-detail/en/molex-llc/0191540041/WM7286-ND/3044480
1/2” cable gland | Amphenol | 0.5” diameter | Digikey | 1 | 2.8 | http://www.digikey.com/product-detail/en/amphenol-industrial-operations/AIO-CSM22/AIO-CSM22-ND/3904973
Power cable | Schurter | IEC 320-C19 | Digikey | 1 | 14.04 | http://www.digikey.com/product-detail/en/schurter-inc/6051.2041/486-1595-ND/2682474
Power outlet | TE Connectivity | IEC 320-C20 | Digikey | 1 | 4.08 | http://www.digikey.com/product-detail/en/te-connectivity-corcom-filters/4-1609134-7/CCM1919-ND/2571040

Sheet: LV PCB
Total | 1.14
Name | Company | Product | Supplier | Quantity | Unit Price ($) | Link | Comments
10V reference | TI | LM4040DIZ-10 | Digikey | 1 | 0.77 | http://www.digikey.com/product-detail/en/texas-instruments/LM4040DIZ-10.0%2FNOPB/LM4040DIZ-10.0%2FNOPB-ND/212716
3 position connector | Phoenix Contact | Combicon PTSA 3 pos | Digikey | 1 | 0.37 | http://www.digikey.com/product-detail/en/phoenix-contact/1985205/277-1623-ND/568660

Sheet: Body
Total | 40.44
Name | Company | Product | Supplier | Quantity | Unit Price ($) | Link | Comments
Copper mesh | M-D Hobby & Craft | Rolled copper mesh | Amazon | 6 | 6.74 | http://www.amazon.com/M-D-Hobby-Craft-Copper-24-Inch/dp/B00KKUZ6PY

Sheet: Dashboard
Total | 146.31
Name | Company | Product | Supplier | Quantity | Unit Price ($) | Link | Comments
Speedometer | Speedhut | GR2-SPEEDO-01 | Speedhut | 1 | 79.96 | http://www.speedhut.com/gauge/GR2-SPEEDO-01/1/Speedometer-Gauge-120mph-programmable
Fuel gauge | Speedhut | G-FUELLEV-01 | Speedhut | 1 | 56.68 | http://www.speedhut.com/gauge/G-FUELLEV-01/1/Speedhut-Fuel-Level-Gauge-(programmable)
Regen potentiometer | Bourns Inc. | PTA2043-2015CPB103 | Digikey | 2 | 1.16 | http://www.digikey.com/product-detail/en/bourns-inc/PTA2043-2015CPB103/PTA2043-2015CPB103-ND/3781176
Coily cable | CES | 3 conductor coil cable | Amazon | 1 | 7.35 | http://www.amazon.com/Coiled-Cable-conductors-extends-5ft/dp/B012J4615M?s=aps

Sheet: General
Total | 65.27
Name | Company | Product | Supplier | Quantity | Unit Price ($) | Link | Comments
Kapton Tape | Nulink | 150mm wide, 100ft | Amazon | 1 | 23.99 | http://www.amazon.com/Polyimide-Temperature-Resistant-Adhesive-Soldering/dp/B00U1X3WU6 | Choose “Wide: 150mm”
Smaller PDM | Cooper Bussmann | 15303-4-0-4 | Waytek Wire | 1 | 19.81 | https://www.waytekwire.com/item/46344/Cooper-Bussmann-15303-4-0-4-Mini-Fuse-Panel-/
1/4” heat shrink labels | Dymo | RhinoPRO 1/4in x 5ft | Amazon | 1 | 21.47 | http://www.amazon.com/DYMO-RhinoPRO-Heat-Shrink-Cable-4-inch/dp/B000AN9I7I
