BDR16/svn-migration-dump/Administration/Orders/3_8_16.ods

Sheet: General
Total | 584.369
Name | Company | Product | Supplier | Quantity | Unit Price ($) | Link | Comments
Inertia switch | Sensata |  | Electric Motorsport | 1 | 52 | http://www.electricmotorsport.com/resettable-inertia-switch-crash-sensor-kit.html | Buy with mating connectors option!!!
TSMS and GLVMS | E Support |  | Amazon | 1 | 15.99 | http://www.amazon.com/Support-Battery-Isolator-Disconnect-Switch/dp/B00U5UBQE4 | Order one pack of two
Ground bus | Blue Sea Systems | DualBus Plus | Amazon | 1 | 24.27 | http://www.amazon.com/Blue-Sea-Systems-DualBus-BusBar/dp/B000K2MABA
LV battery | Enersys | NP4-12 | Amazon | 1 | 33.99 | http://www.amazon.com/EnerSys-Genesis-NP4-12-Fast--Connector/dp/B00V57JC74 | Order one pack of two
LV fuse | Littelfuse | MINI 297 Series 2A | Newark | 10 | 0.313 | http://www.newark.com/littelfuse/0297002-wxn/fuse-mini-blade-2a/dp/98K4443
LV fuse | Littelfuse | MINI 297 Series 3A | Newark | 5 | 0.471 | http://www.newark.com/littelfuse/0297003-wxnv/fuse-blade-3a-32v-fast-acting/dp/78J5673
LV fuse | Littelfuse | MINI 297 Series 4A | Newark | 3 | 0.471 | http://www.newark.com/littelfuse/0297004-wxnv/fuse-blade-4a-32v-fast-acting/dp/12J4289
LV fuse | Littelfuse | MINI 297 Series 5A | Newark | 3 | 0.471 | http://www.newark.com/littelfuse/0297005-wxnv/fuse-blade-5a-32v-fast-acting/dp/78J5674?MER=BN-78J5674
LV fuse | Littelfuse | MINI 297 Series 7.5A | Newark | 3 | 0.236 | http://www.newark.com/littelfuse/029707-5wxnv/fuse-blade-7-5a-32v-fast-acting/dp/95F2012
Dashboard LED | Chicago Mini Lighting | 5102H3-12V Red | Newark | 5 | 1.59 | http://www.newark.com/chicago-miniature-lighting/5102h1-12v/panel-mount-indicator-led-6-35mm/dp/18M8153
Dashboard LED | Chicago Mini Lighting | 5103H3-12V Amber | Newark | 1 | 1.59 | http://www.newark.com/chicago-miniature-lighting/5102h3-12v/panel-mount-indicator-led-6-35mm/dp/93F3489
Dashboard LED | Chicago Mini Lighting | 5104H3-12V Green | Newark | 1 | 1.59 | http://www.newark.com/chicago-miniature-lighting/5102h5-12v/panel-mount-indicator-led-6-35mm/dp/18M8154
LV relay | Omron | G8V | Newark | 6 | 2.74 | http://www.newark.com/omron-electronic-components/g8v-1c7t-r-dc12/micro-automotive-relay-spdt-12vdc/dp/89C6921
BRB | IDEC | AVW401-R E-Stop | Newark | 2 | 38.11 | http://www.newark.com/idec/avw401-r/switch-emergency-stop-spst-nc/dp/74K3690
Ferrule crimper | Ferrules Direct | FD2810HX | Ferrules Direct | 1 | 64 | http://www.ferrulesdirect.com/terminal/3210/FD2810HX.htm
Ferrules 22 AWG | Ferrules Direct | AW05008 | Ferrules Direct | 1 | 6.08 | http://www.ferrulesdirect.com/terminal/INFERR/AW05008.htm
Ferrules 20 AWG | Ferrules Direct | AW07058 | Ferrules Direct | 1 | 6.08 | http://www.ferrulesdirect.com/terminal/INFERR/AW07508.htm
Ferrules 18 AWG | Ferrules Direct | AW10008 | Ferrules Direct | 1 | 6.08 | http://www.ferrulesdirect.com/terminal/INFERR/AW10008.htm
Ferrules 16 AWG | Ferrules Direct | AW15008 | Ferrules Direct | 1 | 6.08 | http://www.ferrulesdirect.com/terminal/INFERR/AW15008.htm
Label maker | Dymo | Rhino 4200 | Amazon | 1 | 45.99 | http://www.amazon.com/DYMO-Industrial-Labeling-Keyboard-1801611/dp/B005MR516Y?s=office-products
1/4” heat shrink labels | Dymo | RhinoPRO 1/4in x 5ft | Amazon | 1 | 21.47 | http://www.amazon.com/DYMO-RhinoPRO-Heat-Shrink-Cable-4-inch/dp/B000AN9I7I
1/2” heat shrink labels | Dymo | RhinoPRO 1/2” x 5ft | Amazon | 1 | 24.95 | http://www.amazon.com/DYMO-RhinoPRO-Heat-Shrink-Cable-2-inch/dp/B000AN9I64
1/4” sleeving | Techflex | 1/4” self wrap braided | Amazon | 1 | 19.47 | http://www.amazon.com/Sleeving-Self-Wrap-Braided-20/dp/B004UHQN2I
1/2” sleeving | Techflex | 1/2” self wrap braided | Amazon | 1 | 17.97 | http://www.amazon.com/TechFlex-0-50-inch-split-sleeving/dp/B0008IV3XC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
1/16” heat shrink | Alpha Wire | F221B1/16 BK100 | Digikey | 1 | 1.15 | http://www.digikey.com/product-detail/en/alpha-wire/F221B1%2F16 BK100/A116B-4-ND/281667
1/8” heat shrink | Alpha Wire | F221B1/8 BK100 | Digikey | 1 | 1.31 | http://www.digikey.com/product-detail/en/alpha-wire/F221B1%2F8 BK100/A018B-4-ND/281671
1/4” heat shrink | Alpha Wire | F221B1/4 BK100 | Digikey | 1 | 1.99 | http://www.digikey.com/product-detail/en/alpha-wire/F221B1%2F4 BK100/A014B-4-ND/281675
1/2” heat shrink | Alpha Wire | F221B1/2 BK210 | Digikey | 1 | 2.5 | http://www.digikey.com/product-detail/en/alpha-wire/F221B1%2F2 BK210/A012B-4-ND/281679
1” heat shrink | Alpha Wire | F221B1IN BK209 | Digikey | 1 | 5.06 | http://www.digikey.com/product-detail/en/alpha-wire/F221B1IN BK209/A100B-4-ND/281683
1.5” heat shrink | TE Connectivity Raychem | RNF-100-1-1/2-BK-SP | Digikey | 2 | 3.64 | http://www.digikey.com/product-detail/en/te-connectivity-raychem-cable-protection/RNF-100-1-1%2F2-BK-SP/RNF-100-1-1%2F2-BK-SP-01-ND/5418600
Self fusing silicon tape | Vypar Products | TPE-XCSB 2 pack | Amazon | 1 | 10.6 | http://www.amazon.com/Vypar-Products-Inc-TPE-XCSB-Self-Fusing/dp/B017RA7R5Q?s=office-products | Select the 2-Pack
Cold zip ties | Gardner Bender | 46-308UVBFZ | Amazon | 1 | 7.99 | http://www.amazon.com/Gardner-Bender-46-308UVBFZ-Performs-185-Degree/dp/B00PXLNB48
20 AWG red | Nexans | M22759/32-20-2 | Newark | 50 | 0.17 | http://www.newark.com/nexans/m22759-32-20-2/hook-up-wire-20awg-red-per-ft/dp/21T2995
20 AWG black | Harbour Industries | M22759/16-20-0 | Newark | 50 | 0.127 | http://www.newark.com/harbour-industries/m22759-16-20-0/hook-up-wire-20awg-black-per-ft/dp/21T2823
20 AWG white | Nexans | M22759/32-20-9 | Newark | 25 | 0.11 | http://www.newark.com/nexans/m22759-32-20-9/hook-up-wire-20awg-white-per-ft/dp/21T3013
20 AWG blue | NTE Electronics | WH20-06-100 | Newark | 1 | 14.34 | http://www.newark.com/nte-electronics/wh20-06-100/hook-up-wire-100ft-20awg-copper/dp/33C7326
16 AWG red | Pro Power | PP001272 | Newark | 1 | 28.66 | http://www.newark.com/pro-power/pp001272/tri-rated-cable-1-5mm2-red-100m/dp/68Y7955
16 AWG black | Pro Power | PP001188 | Newark | 1 | 28.66 | http://www.newark.com/pro-power/pp001188/tri-rated-cable-1-5mm2-black-100m/dp/68Y7871

Sheet: PDM
Total | 119.465
Name | Company | Product | Supplier | Quantity | Unit Price ($) | Link | Comments
PDM | Cooper Bussmann | 15303-5-2-4 | Waytek Inc | 1 | 57.57 | https://www.waytekwire.com/item/46357/Cooper-Bussmann-15404-2-0-1-0A-RFRM-Panel-/
PDM terminal removal | Delphi | 12094429 removal tool | Waytek Inc | 1 | 23.28 | http://www.waytekwire.com/item/422/Delphi-12094429-Metri-Pack-Terminal-Removal-Tool-/
PDM crimp tool | Delphi | 22-14 AWG crimper | Waytek Inc | 1 | 9.46 | http://www.waytekwire.com/item/533/CRIMPER-SEALED-METRI-PACK/
PDM terminals | Delphi | 22-20 AWG tangless | Waytek Inc | 50 | 0.1005 | http://www.waytekwire.com/item/30068/Delphi-12110846-Metri-Pack-280-Series-22-20-GA/
PDM terminals | Delphi | 18-16 AWG tangless | Waytek Inc | 50 | 0.0914 | http://www.waytekwire.com/item/30069/Delphi-12110847-Metri-Pack-280-Series-18-16-GA/
PDM seals | Delphi | 20-18 AWG seals | Waytek Inc | 100 | 0.0642 | http://www.waytekwire.com/item/39000/Delphi-15324982-Metri-Pack-280-Series-Cable-Seal-/
PDM seals | Delphi | 16-14 AWG seals | Waytek Inc | 100 | 0.0639 | http://www.waytekwire.com/item/39001/Delphi-15324980-Metri-Pack-280-Series-Cable-Seal-/
PDM seals | Delphi | Plug seals | Waytek Inc | 100 | 0.0675 | http://www.waytekwire.com/item/39010/Delphi-12010300-1-Way-Cable-Cavity-Plug-Seal-/

Sheet: LV PCB
Total | 29.42
Name | Company | Product | Supplier | Quantity | Unit Price ($) | Link | Comments
BBB cape headers | Adafruit | Stacking Header Set… | Adafruit | 2 | 4.95 | https://www.adafruit.com/products/706
5V DC-DC converter | Murata | OKI-78SR-5/1.5-W36H-C | Digikey | 2 | 4.3 | http://www.digikey.com/short/3qmd8c
2 position connector | Phoenix Contact | Combicon PTSA 2 pos | Digikey | 12 | 0.28 | http://www.digikey.com/product-detail/en/phoenix-contact/1985195/277-1622-ND/568659
4 position connector | Phoenix Contact | Combicon PTSA 4 pos | Digikey | 2 | 0.51 | http://www.digikey.com/product-detail/en/phoenix-contact/1985218/277-1624-ND/568661
5 position connector | Phoenix Contact | Combicon PTSA 5 pos | Digikey | 4 | 0.6 | http://www.digikey.com/product-detail/en/phoenix-contact/1985221/277-1625-ND/568662
8 position connector | Phoenix Contact | Combicon PTSA 8 pos | Digikey | 2 | 0.94 | http://www.digikey.com/product-detail/en/phoenix-contact/1985250/277-1628-ND/568665
9 position connector | Phoenix Contact | Combicon PTSA 9 pos | Digikey | 2 | 1.13 | http://www.digikey.com/product-detail/en/phoenix-contact/1985263/277-1629-ND/568666

Sheet: HV PCB
Total | 86.98
Name | Company | Product | Supplier | Quantity | Unit Price ($) | Link | Comments
HV DC-DC converter | CUI Inc | VSK-S5-12UA | Digikey | 2 | 16.33 | http://www.digikey.com/product-detail/en/cui-inc/VSK-S5-12UA/102-2388-ND/2718949
Precharge relay | Standex-Meder Elec | KT12-1A-40L-THT | Digikey | 1 | 8.42 | http://www.digikey.com/product-detail/en/standex-meder-electronics/KT12-1A-40L-THT/374-1359-ND/4341852
Discharge relay | Panasonic | AQZ404 | Digikey | 1 | 14.97 | http://www.digikey.com/product-search/en/relays/solid-state-relays/1048664?k=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
Precharge resistor | Vishay Dale | 1K 13W 5% wire | Digikey | 1 | 1.59 | http://www.digikey.com/product-detail/en/vishay-dale/CW0101K000JE73/CWE-1.0KRCT-ND/1166482
Discharge resistor | Ohmite | 2K 10W 5% wire | Digikey | 2 | 2.4 | http://www.digikey.com/product-detail/en/ohmite/20J2K0E/20J2K0E-ND/822951
HV indicator resistor | Vishay Dale | 22K 10W 5% wire | Digikey | 2 | 1.55 | http://www.digikey.com/product-detail/en/vishay-dale/ALSR0522K00JE12/ALSR5J-22.0K-ND/257471
TSMP resistor | Vishay Dale | 10K 10W 1% wire | Digikey | 2 | 2.18 | http://www.digikey.com/product-detail/en/vishay-dale/RS01010K00FE73/RSD-10KRCT-ND/1166571
HV lights fuse | Littelfuse | ATO 1A | Digikey | 2 | 0.28 | http://www.digikey.com/product-detail/en/littelfuse-inc/0287001.PXCN/F4191-ND/3102551
HV lights fuseholder | MPD | ATO holder BK-6010 | Digikey | 1 | 0.54 | http://www.digikey.com/product-detail/en/mpd-memory-protection-devices/BK-6010/BK-6010-ND/2330529
HV emeter fuse | Eaton Bussmann | BK/PCB-1/2-R 0.5A | Digikey | 2 | 2.24 | http://www.digikey.com/product-detail/en/eaton-bussmann/BK%2FPCB-1%2F2-R/283-2757-ND/954337
HV emeter fuseholder | Eaton Bussmann | BK/PCB | Digikey | 1 | 1.51 | http://www.digikey.com/product-detail/en/eaton-bussmann/BK%2FPCS/283-2356-ND/264876
HV TSAL/TSEL switch | E-Switch | 100DP1T1B1M2QEH | Digikey | 1 | 2.83 | http://www.digikey.com/product-detail/en/e-switch/100DP1T1B1M2QEH/EG2400-ND/378869
2 position connector | Phoenix Contact | Combicon PTSA 2 pos | Digikey | 3 | 0.28 | http://www.digikey.com/product-detail/en/phoenix-contact/1985195/277-1622-ND/568659
4 position connector | Phoenix Contact | Combicon PTSA 4 pos | Digikey | 2 | 0.51 | http://www.digikey.com/product-detail/en/phoenix-contact/1985218/277-1624-ND/568661
6 position connector | Phoenix Contact | Combicon PTSA 6 pos | Digikey | 1 | 0.74 | http://www.digikey.com/product-detail/en/phoenix-contact/1985234/277-1626-ND/568663
HV reg input capacitor | Nichicon | 1uF UVZ2V010MED | Digikey | 2 | 0.29 | http://www.digikey.com/product-detail/en/nichicon/UVZ2V010MED/493-1434-ND/589175
HV reg output capacitor | Nichicon | 22uF UVY2V220MHD1TO | Digikey | 2 | 1.14 | http://www.digikey.com/product-detail/en/nichicon/UVY2V220MHD1TO/493-12994-1-ND/4328611
HV reg | ON Semiconductor | NCP785AH120T1G | Digikey | 2 | 0.85 | http://www.digikey.com/product-detail/en/on-semiconductor/NCP785AH120T1G/NCP785AH120T1GOSCT-ND/5267884

Sheet: HV
Total | 1033.41
Name | Company | Product | Supplier | Quantity | Unit Price ($) | Link | Comments
HV charging fuse | Littelfuse | 0487010.MXP 10A | Digikey | 1 | 4.58 | http://www.digikey.com/product-detail/en/littelfuse-inc/0487010.MXP/F6661-ND/5029353
HV charging fuseholder | MPD | BF303 | Digikey | 1 | 1.32 | http://www.digikey.com/product-detail/en/mpd-memory-protection-devices/BF303/BF303-ND/2330519
Charger fault LED | APEM | Q8R1BXXY110E | Newark | 1 | 1.78 | http://www.newark.com/apem/q8r1bxxy110e/panel-mount-indicator-led-8mm/dp/16R0187
Charger fault LED | APEM | Q14F1CXXR110E | Newark | 2 | 2.81 | http://www.newark.com/apem/q14f1cxxr110e/panel-mount-indicator-led-14mm/dp/15R9884
Charger fault relay | TE Connectivity | OUAZ-SS-112L | Newark | 2 | 2.14 | http://www.newark.com/te-connectivity-oeg/ouaz-ss-112l-900/relay-signal-spdt-120vac-24vdc/dp/73J6576
Charger latch relay | TE Connectivity | RTE24615 | Newark | 1 | 5.79 | http://www.newark.com/te-connectivity-schrack/rte24615/relay-dpdt-250vac-8a/dp/48F3750
TSVP thin | Super Bright LEDs Inc | M3-R6 | Super Bright LEDs Inc | 2 | 5.95 | https://www.superbrightleds.com/moreinfo/rv-marker-led-lights/rectangular-led-truck-trailer-light-3-78in-led-marker-clearance-light-with-6-leds/575/ | Red color
TSEL | Super Bright LEDs Inc | MSTRB-360-A | Super Bright LEDs Inc | 1 | 39.95 | https://www.superbrightleds.com/moreinfo/strobe-beacons/led-hideaway-strobe-lights-mini-emergency-vehicle-led-warning-lights/1905/ | 360 deg, amber color
HV fuse | Littelfuse | L50S225 | eBay | 2 | 42.21 | http://www.ebay.com/itm/LITTELFUSE-L50S-225-NSPP-L50S225-/231139223575
Energy meter LV plug | Harting | 21032122305 | Newark | 1 | 16.6 | http://www.newark.com/harting/21-03-212-2305/connector-receptacle-m12-4-position/dp/93K3137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
SMD/HVD female | Amphenol | PL28X-301-50 | Newark | 4 | 52.28 | http://www.newark.com/amphenol-industrial/pl28x-301-50/rectangular-power-connector-cable/dp/51Y5075
SMD/HVD male | Amphenol | PL00X-301-10D8 | Newark | 4 | 28.26 | http://www.newark.com/amphenol-industrial/pl00x-301-10d8/rectangular-power-connector-panel/dp/51Y5046
Cntrler to motor female | Amphenol | PL283X-301-50 | Newark | 2 | 142.4 | http://www.newark.com/amphenol-industrial/pl283x-301-50/rectangular-power-connector-cable/dp/51Y5081
Cntrler to motor male | Amphenol | PL083X-301-10D8 | Newark | 2 | 64.73 | http://www.newark.com/amphenol-industrial/pl083x-301-10d8/rectangular-power-connector-panel/dp/51Y5055
1/2” conduit | Electri-Flex | 12NMFX100 | Platt | 10 | 0.55 | https://www.platt.com/platt-electric-supply/Flexible-Conduit-Liquidtight-Non-Metallic/Electri-Flex/12NMFX100/product.aspx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 | Quantity in feet
1/2” 0 conduit fitting | Arlington | NMLT50 | Platt | 2 | 1.99 | https://www.platt.com/platt-electric-supply/Liquidtight-Flex-Non-Metallic-Straight-Connectors/Arlington/NMLT50/product.aspx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
1” 90 conduit fitting | Arlington | NMLT90100 | Platt | 4 | 9.43 | https://www.platt.com/platt-electric-supply/Liquidtight-Flex-Non-Metallic-90-Degree-Connectors/Arlington/NMLT90100/product.aspx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
1” 0 conduit fitting | Arlington | NMLT100 | Platt | 7 | 4.09 | https://www.platt.com/platt-electric-supply/Liquidtight-Flex-Non-Metallic-Straight-Connectors/Arlington/NMLT100/product.aspx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
1/0 AWG lugs | Windy Nation | 1/0 AWG 5/16” copper | Amazon | 1 | 12.19 | http://www.amazon.com/Tinned-Battery-Welding-Connector-Terminal/dp/B008D54QZO | Select 5/16” and 1/0-Gauge
1/0 AWG lugs | Windy Nation | 1/0 AWG 3/8” copper | Amazon | 1 | 12.19 | http://www.amazon.com/TINNED-BATTERY-WELDING-CONNECTOR-TERMINAL/dp/B008D54R1M" | Select 3/8” and 1/0-Gauge
Emeter HV plug | Molex | Mini Fit Jr. 39-01-3022 | Digikey | 2 | 0.31 | http://www.digikey.com/product-detail/en/molex-llc/0039013022/WM1021-ND/1118564
Emeter HV fem term | Molex | Mini Fit Jr. 39-00-0038 | Digikey | 10 | 0.086 | http://www.digikey.com/product-detail/en/molex-llc/0039000038/WM2501CT-ND/467978
TSMP fem connector | Conxall/Switchcraft | 6280-2SG-318 | Digikey | 2 | 5.75 | http://www.digikey.com/product-detail/en/conxall-switchcraft/6280-2SG-318/SC2199-ND/3514977
TSMP male connector | Conxall/Switchcraft | 7282-2PG-300 | Digikey | 2 | 3.78 | http://www.digikey.com/product-detail/en/conxall-switchcraft/7282-2PG-300/SC1272-ND/526237

Sheet: Charging PCB
Total | 51.87
Name | Company | Product | Supplier | Quantity | Unit Price ($) | Link | Comments
Charger fault LED | APEM | Q8R1BXXY110E | Newark | 1 | 1.78 | http://www.newark.com/apem/q8r1bxxy110e/panel-mount-indicator-led-8mm/dp/16R0187
Charger fault LED | APEM | Q14F1CXXR110E | Newark | 2 | 2.81 | http://www.newark.com/apem/q14f1cxxr110e/panel-mount-indicator-led-14mm/dp/15R9884
Charger fault relay | TE Connectivity | OUAZ-SS-112L | Newark | 2 | 2.14 | http://www.newark.com/te-connectivity-oeg/ouaz-ss-112l-900/relay-signal-spdt-120vac-24vdc/dp/73J6576
Charger latch relay | TE Connectivity | RTE24615 | Newark | 1 | 5.79 | http://www.newark.com/te-connectivity-schrack/rte24615/relay-dpdt-250vac-8a/dp/48F3750
Charger fault relay | TE Connectivity | T9AS5D12-12 | Digikey | 2 | 3.5 | http://www.digikey.com/product-detail/en/te-connectivity-potter-brumfield-relays/T9AS5D12-12/PB306-ND/254523
Charger latch relay | TE Connectivity | T92S11A12-120 | Digikey | 1 | 15.53 | http://www.digikey.com/product-detail/en/te-connectivity-potter-brumfield-relays/8-1393211-0/PB1412-ND/1127987
High V/C connector | Phoenix Contact | SPT 3 pos 1991105 | Digikey | 2 | 1.6 | http://www.digikey.com/product-detail/en/phoenix-contact/1991105/277-6710-ND/2527262
2 position connector | Phoenix Contact | Combicon PTSA 2 pos | Digikey | 3 | 0.28 | http://www.digikey.com/product-detail/en/phoenix-contact/1985195/277-1622-ND/568659
3 position connector | Phoenix Contact | Combicon PTSA 3 pos | Digikey | 1 | 0.37 | http://www.digikey.com/product-detail/en/phoenix-contact/1985205/277-1623-ND/568660
6 position connector | Phoenix Contact | Combicon PTSA 6 pos | Digikey | 1 | 0.74 | http://www.digikey.com/product-detail/en/phoenix-contact/1985234/277-1626-ND/568663
8 position connector | Phoenix Contact | Combicon PTSA 8 pos | Digikey | 1 | 0.94 | http://www.digikey.com/product-detail/en/phoenix-contact/1985250/277-1628-ND/568665
120 charger to board | Qualtek | Q-716 | Digikey | 1 | 5.78 | http://www.digikey.com/product-detail/en/qualtek/Q-716/Q528-ND/2180785
