BDR16/svn-migration-dump/Administration/Orders/4_14_16 Order.ods

Total | 109
Name | Company | Product | Supplier | Quantity | Unit Price ($) | Link | Comments
1/0 Shielded Cable | Champlain | EXRAD XLE 600V | EVWest | 6 | 9.49 | http://www.evwest.com/catalog/product_info.php?products_id=423
1/4” by 3/4” motor bolt
1/4” distorted thread nut
Shielded Cable Gland | Bud Industries | NG-9516 | Digikey | 4 | 4.46 | http://www.digikey.ca/product-detail/en/bud-industries/NG-9516/377-1974-ND/439544
Charging connector cover | Conxall/Switchcraft | 6295 | Digikey | 1 | 0.93 | http://www.digikey.com/product-detail/en/conxall-switchcraft/6295/SC1397-ND/965061
TSMP panel side male | Conxall/Switchcraft | 6282-2PG-3DC | Digikey | 1 | 5.82 | http://www.digikey.com/product-detail/en/conxall-switchcraft/6282-2PG-3DC/SC1262-ND/526227
TSMP panel side fem | Conxall/Switchcraft | 6282-2SG-3DC | Digikey | 1 | 6.77 | http://www.digikey.com/product-detail/en/conxall-switchcraft/6282-2SG-3DC/SC1263-ND/526228
AMS connector | Molex | 39012160 | Digikey | 1 | 0.78 | http://www.digikey.com/product-detail/en/0039012160/WM3707-ND/61394
AMS connector crimp | Molex | 39000039 | Digikey | 15 | 0.182 | http://www.digikey.com/product-detail/en/0039000039/WM2501-ND/61448
AMS coil connector | Molex | 50579404 | Digikey | 2 | 0.27 | http://www.digikey.com/product-detail/en/0050579404/WM2902-ND/115057
AMS coil crimp | Molex | 16020103 | Digikey | 25 | 0.1632 | http://www.digikey.com/product-detail/en/0016020103/WM2512-ND/115063
AMS cell connector | Molex | 0050579405 | Digikey | 4 | 0.34 | http://www.digikey.com/product-detail/en/0050579405/WM2903-ND/115035
#10 standoff | Essentra Components | 005453000014 | Digikey | 5 | 0.33 | http://www.digikey.com/product-detail/en/essentra-components/005453000014/005453000014-ND/4104075
#8 standoff | Bivar Inc | Round #8 Nylon Spacer | Digikey | 18 | 0.095 | http://www.digikey.com/product-detail/en/bivar-inc/9912-187/492-1118-ND/586438
New BBB box | Hammond Manufacturing | RL6555 | Digikey | 1 | 7.85 | http://www.digikey.com/product-detail/en/hammond-manufacturing/RL6555/HM1076-ND/2094814
