BDR16/svn-migration-dump/Administration/Orders/4_18_16 Order.ods

Total | 124.632
Name | Company | Product | Supplier | Quantity | Unit Price ($) | Link | Comments
AMS mating connector | Molex | 39-01-4046 | Digikey | 1 | 0.37 | http://www.digikey.com/product-detail/en/molex-connector-corporation/39-01-4046/WM18440-ND/300073
AMS male terminals | Molex | 39-00-0040 | Digikey | 25 | 0.0708 | http://www.digikey.com/product-detail/en/molex-llc/0039000040/WM2500CT-ND/467979
AMS test fuseholders | MPD | BF303 | Digikey | 4 | 1.32 | http://www.digikey.com/product-detail/en/mpd-memory-protection-devices/BF303/BF303-ND/2330519
AMS test fuse | Schurter | 0001.2504 | Digikey | 5 | 0.59 | http://www.digikey.com/product-detail/en/schurter-inc/0001.2504/486-1782-ND/639704
AMS cell board conn | Molex | 0039013022 | Digikey | 8 | 0.33 | http://www.digikey.com/product-detail/en/molex-llc/0039013022/WM1021-ND/1118564
AMS female terminals | Molex | 39-00-0039 | Digikey | 20 | 0.1356 | http://www.digikey.com/product-detail/en/molex-llc/0039000039/WM2501-ND/61448
AMS cell board plug | Molex | 0039013023 | Digikey | 8 | 0.33 | http://www.digikey.com/product-detail/en/molex-llc/0039013023/WM1030-ND/447277
Accumulator seal | Rubber Products | 1” wide x 1/8” thk x 33 ft | Amazon | 1 | 18.06 | http://www.amazon.com/NEOPRENE-RUBBER-Self-Adhesive-Strip/dp/B0089FMXN0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
1/4” heat shrink labels | Dymo | RhinoPRO 1/4in x 5ft | Amazon | 3 | 21.47 | http://www.amazon.com/DYMO-RhinoPRO-Heat-Shrink-Cable-4-inch/dp/B000AN9I7I
BBB box | Bud Industries | 6.387 x 3.246 x 3.346 | Digikey | 1 | 13.3 | http://www.digikey.com/product-detail/en/bud-industries/PN-1333-DGMB/377-2160-ND/4897003
2 pos grommet | Keystone Electronics | .432” grommet | Digikey | 10 | 0.166 | http://www.digikey.com/product-detail/en/keystone-electronics/736/36-736-ND/316717
6 pos grommet | Keystone Electronics | .625” grommet | Digikey | 25 | 0.27 | http://www.digikey.com/product-detail/en/keystone-electronics/742/36-742-ND/316743
??? grommet | Keystone Electronics | .562” grommet | Digikey | 10 | 0.209 | http://www.digikey.com/product-detail/en/keystone-electronics/739/36-739-ND/106230
