BDR16/svn-migration-dump/Administration/Orders/4_1_16 Order.ods

Total | 38.57
Name | Company | Product | Supplier | Quantity | Unit Price ($) | Link | Comments
AMS test connector | Molex | 39-01-4040 Mini Fit Jr. | Digikey | 1 | 0.4 | http://www.digikey.com/product-detail/en/molex-llc/0039014040/WM18435-ND/300068
AMS female terminals | Molex | 39-00-0039 | Digikey | 5 | 0.19 | http://www.digikey.com/product-detail/en/molex-llc/0039000039/WM2501-ND/61448
AMS mating connector | Molex | 39-01-4046 | Digikey | 1 | 0.37 | http://www.digikey.com/product-detail/en/molex-connector-corporation/39-01-4046/WM18440-ND/300073
AMS male terminals | Molex | 39-00-0041 | Digikey | 5 | 0.17 | http://www.digikey.com/product-detail/en/molex-llc/0039000041/WM2500-ND/61445
Brake light | Super Bright LEDs | STFM-R12P | Super Bright LEDs | 1 | 20.95 | https://www.superbrightleds.com/moreinfo/truck-lights-lamps/round-led-truck-and-trailer-lights-4-led-stop-turn-tail-light-w-12-leds/3013/5756/ | Choose the red color
TSMP panel mount | Conxall/Switchcraft | Micro-Con-X 2 pos | Digikey | 1 | 3.56 | http://www.digikey.com/product-detail/en/conxall-switchcraft/17282-2PG-300/SC1206-ND/526171
TSMP cover | Conxall/Switchcraft | Micro-Con-X 2 pos | Digikey | 1 | 1.02 | http://www.digikey.com/product-detail/en/conxall-switchcraft/16295/SC1398-ND/2523443
TSMP male | Conxall/Switchcraft | Micro-Con-X 2 pos | Digikey | 1 | 5.56 | http://www.digikey.com/product-detail/en/conxall-switchcraft/16282-2SG-311/SC1203-ND/526168
Graphite lubricant | Panef | L-300 graphite | Amazon | 1 | 4.91 | http://www.amazon.com/Panef-Corp-Powdered-Graphite-Lubricant/dp/B0016GZQ60
