BDR16/svn-migration-dump/Administration/Orders/4_20_16 Order.ods

Total | 7.42
Name | Company | Product | Supplier | Quantity | Unit Price ($) | Link | Comments
IDC MC Connector | Assmann WSW Comp | AWLP-34/3.2G | Digikey | 3 | 1.35 | http://www.digikey.com/product-detail/en/assmann-wsw-components/AWLP-34%2F3.2-G/HDM34H-ND/924876
3/4” heat shrink | Alpha Wire | F221B3/4 BK207 | Digikey | 1 | 3.37 | http://www.digikey.com/product-detail/en/alpha-wire/F221B3%2F4 BK207/A034B-4-ND/281681
