BDR16/svn-migration-dump/Electrical/High Voltage/Accumulator Parts.xls

Contactor
Name | Company | Voltage (V) | Cont Current (A) | Peak Current (A) | Coil Current (A) | Resistance (mOhms) | Economizer/Dual Coil | Coil Suppression | Mass (kg) | Price ($) | Link | Comments
GX12/GX22 | Gigavac | 800 | 225 |  | 0.082 | 0.4 | Optional | Yes | 0.5 |  | http://www.gigavac.com/catalog/pp/gx.html
GX23/GX14/GX24/GX34/GX54 | Gigavac | 800 | 350 |  | 0.23 | 0.4 | Yes | Yes | 0.44 |  | http://www.gigavac.com/catalog/pp/gx.html
GV200 | Gigavac | 800 | 500 |  | 0.13 | 0.4 | Optional | Yes | 0.38 |  | http://www.gigavac.com/catalog/pp/gx.html
LEV200 | TE Connectivity | 900 | 500 | 2000 | 0.18 | 0.2 | No |  | 0.6 | 178.04 | http://www.mouser.sg/new/te-kilovac/televrelays/
EV200 | TE Connectivity | 900 | 500 | 2000 | 0.13 | 0.2 | Optional | Yes | 0.43 | 301.64 | http://www.mouser.sg/new/te-kilovac/televrelays/
GX16 | Gigavac | 800 | 600 |  | 0.64 | 0.3 | Yes | Yes | 0.9
Precharge Relay
Name | Company | Voltage (V) | Cont Current (A) | Peak Current (A) | Coil Current (A) | Resistance (mOhms) | Mass (kg) | Price ($) | Link | Comments
G2RL | Omron | 300 |  | 8 | 0.033 | 100 |  | 3 | https://www.components.omron.com/components/web/pdflib.nsf/0/8F66C9A835A195FE85257201007DD572/$file/G2RL_0911.pdf
Discharge Relay
Name | Company | Voltage (V) | Cont Current (A) | Peak Current (A) | Coil Current (A) | Resistance (mOhms) | Mass (kg) | Price ($) | Link | Comments
G2RL | Omron | 300 |  | 8 | 0.033 | 100 |  | 3 | https://www.components.omron.com/components/web/pdflib.nsf/0/8F66C9A835A195FE85257201007DD572/$file/G2RL_0911.pdf
Precharge Resistor
Calculations | Capacitance (F) | Time (s) | Precharge (%) | Voltage (V) | Resistor (Ohms) | Energy Stored (J) | Average Power (W)
 | 0.05 | 10 | 90 | 300 | 86.85889638 | 2250 | 225
Name | Company | Type | Min Power (W) | Max Power (W) | Overload | Requires Heatsink | Distributor | Price ($) | Link | Comments
PW-RC Series | Xicon | Cement | 5 | 25 | 5.5 | No | Mouser | 2 | http://www.mouser.com/ds/2/351/XC-600041-198125.pdf
89 Series Metal-Mite | Ohmite | Aluminum | 5 | 50 | 5 | Yes | Mouser | 15 | http://www.mouser.com/ds/2/303/res_89-275782.pdf
KAL Series | Stackpole Electronics | Aluminum | 12.5 | 50 | 5 | Maybe (Probably) | Digikey | 4 | https://www.seielect.com/catalog/SEI-KAL.pdf
270 Series | Ohmite | Ceramic | 12 | 1000 | 10 | No | Mouser | 20 | http://www.ohmite.com/cat/res_270.pdf
Discharge Resistor
Calculations | Capacitance (F) | Time (s) | Min Voltage (V) | Voltage (V) | Resistor (Ohms) | Energy Stored (J) | Average Power (W)
 | 0.05 | 5 | 30 | 300 | 43.42944819 | 2250 | 450
Name | Company | Type | Min Power (W) | Max Power (W) | Overload | Requires Heatsink | Distributor | Price ($) | Link | Comments
PW-RC Series | Xicon | Cement | 5 | 25 | 5.5 | No | Mouser | 2 | http://www.mouser.com/ds/2/351/XC-600041-198125.pdf
89 Series Metal-Mite | Ohmite | Aluminum | 5 | 50 | 5 | Yes | Mouser | 15 | http://www.mouser.com/ds/2/303/res_89-275782.pdf
KAL Series | Stackpole Electronics | Aluminum | 12.5 | 50 | 5 | Maybe (Probably) | Digikey | 4 | https://www.seielect.com/catalog/SEI-KAL.pdf
270 Series | Ohmite | Ceramic | 12 | 1000 | 10 | No | Mouser | 20 | http://www.ohmite.com/cat/res_270.pdf
Maintenance Switch (HV Disconnect)
Name | Company | Voltage (V) | Cont Current (A) | Peak Current (A) | Resistance (mOhms) | Mass (kg) | Price ($) | Link | Comments
HBD21 | Gigavac | 1000 | 200 | 2000 |  | 0.5 |  | http://www.gigavac.com/catalog/pp/manual-disconnect-switches.html
HBD31 | Gigavac | 1000 | 300 | 2000 |  | 0.5 |  | http://www.gigavac.com/catalog/pp/manual-disconnect-switches.html
HBD41 | Gigavac | 1000 | 400 | 2000 |  | 0.5 |  | http://www.gigavac.com/catalog/pp/manual-disconnect-switches.html
HV Fuse
Name | Company | Voltage (V) | Cont. Current (A) | 600A Time (s) | 2000A Time (s) | Loss (W) | Length (in) | Diameter (in) | Indication | Price ($) | Link | Comments
L50S200 | Littelfuse | 450 | 200 | 6 | 0.004 | 35 | 3.675 | 1.21875 | No | 146.58 | http://www.littelfuse.com/products/fuses/specialty-power-fuses/semiconductor-fuses/l50s/l50s200.aspx
L50S225 | Littelfuse | 450 | 225 | 18 | 0.0045 | 31 | 4.34375 | 1.5 | No | 200.36 | http://www.littelfuse.com/products/fuses/specialty-power-fuses/semiconductor-fuses/l50s/l50s225.aspx
DFJ-200 | Cooper Bussmann | 450 | 200 | 20 | 0.015 | 24 | 5.75 | 1.63 | No | 342.77 | http://www.cooperindustries.com/content/public/en/bussmann/electrical/products/high_speed_/dfj.html
JLLS200.X | Littelfuse | 300 | 200 | 30 | 0.02 |  | 3.25 | 1.078 | Yes | 117.57 | http://www.littelfuse.com/products/fuses/industrial-power-fuses/class-t-fuses/jlls/jlls200.aspx
0JTD200.XXID | Littelfuse | 500 | 200 | 85 | 0.33 | 18.39 | 5.75 | 1.5 | No | 334.01 | http://www.littelfuse.com/products/fuses/industrial-power-fuses/class-j-fuses/jtd/jtd200.aspx
LPJ-200SPI | Cooper Bussmann | 300 | 200 | 80 | 0.6 |  | 5.75 | 1.63 | Yes |  | http://www.cooperindustries.com/content/dam/public/bussmann/Electrical/Resources/product-datasheets-a/Bus_Ele_DS_1063_LPJ_SPI_70_to_600_Amps.pdf
FWH-200 | Cooper Bussmann | 500 | 200 | 6 | 0.001 | 41 | 3.625 | 1.156 | No | 149.15 | http://www.cooperindustries.com/content/dam/public/bussmann/Electrical/Resources/Catalogs/bus-ele-cat-1007-sec06-high-speed-fuses-north-american.pdf
FWH-225 | Cooper Bussmann | 500 | 225 | 13 | 0.004 | 39 | 4.34 | 1.5 | No | 139.35 | http://www.cooperindustries.com/content/dam/public/bussmann/Electrical/Resources/Catalogs/bus-ele-cat-1007-sec06-high-speed-fuses-north-american.pdf
Charger
Name | Company | Power (W) | Current (A) | UL Listed | Price ($) | Contacted | Link
BC-Series | Current Ways | 3000 | 10 | Yes |  | Yes | http://www.currentways.com/ev-battery-chargers/air-cooled-chargers/3kw-bc-series-air-cooled-ev-battery-charger-225-450vdc/
NLG513 | Brusa | 3700 | 12 | Maybe |  |  | http://www.brusa.eu/en/products/energy/chargers-400-v/nlg513-air-cooled.html
PFC20X | Manzita Micro | 4800 | 16 | No | 2050 | Yes | http://www.manzanitamicro.com/products?product_id=39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
PFC 5000 | Elcon | 4000 | 7.5 | CE | 1400 | Yes | http://www.elconchargers.com/catalog/item/7344653/7638123.htm
