BDR16/svn-migration-dump/Mechanical/Drivetrain/Resources/Material Database and Cut List.xlsx

Sheet: Cut list
Subsystem | Part (quantity if >1) | Approximate Size | Material | Unit Size | Cost per unit | Source | Quantity of Unit | Total Cost | Notes
Drivetrain | Motor Support (2) | .25x10x6in | 6061 Aluminum Plate, | .25x12x12in | $25.00 | Gibbs? | 1 | $25.00 | estimate based on online rate
 | Welded Inner Support (2) | .1x10x7in | 4130 Steel Plate, | .1x12x12in | $25.00 | Waterjet? | 2 | $50.00 | estimate inlcuding cutting
 | Bolted Outer Support (2) | .125x10x7in | 6061 Aluminum Plate, | .125x12x12in | $25.00 | Waterjet? | 2 | $50.00 | estimate inlcuding cutting
 | Oil Seal Structure (2) | 1x6in | 6061 Aluminum Rod, | 2x5.75in OD | $28.12 | Speedy Metals | 1 | $28.12 | Bore out round pocket .38x5 in, could be made from tube welded/bolted on.
 | Bearing Structure (2) | 2x6in | 6061 Aluminum Rod, | 4x5.75in OD | $56.24 | Speedy Metals | 1 | $56.24 | Bore out round pocket .875x5 in. There is also a lip extrusion that is about .75 in tall. Could be made from tube and round plate welded/bolted together.
 | Tab Material | .1x5x9in | 4130 Steel Plate, | .1x5x9in | $0.00 | In Garage | 1 | $0.00
 | Shaft Coupler Flange (2) | 3x3.75in | 1045 Steel Rod | 3x3.75in OD | $18.81 | Speedy Metals | 1 | $18.81
 | Shaft key Small (1) | 1.5x.3125x.375 | Mild steel | 12 in length | $3.00 | Fastenal, or Gibbs? | 1 | $3.00
 | Bearings (2) |  | 61808 |  | $22.00 | BDI | 2 | $44.00
 | Oil Seal, Inner (2) |  | Harwal 32x52x8 mm |  | $8.00 | BDI | 2 | $16.00
 | Oil Seal, Outer (2) |  | Harwal 42x52x8 mm |  | $8.00 | BDI | 2 | $16.00
 | Gaskets (6) | 6x6 in | Cellulose, .03125 | 12x36in Sheet | $6.00 | Auto Zone | 2 | $12.00
 | Bleeder Screw (6) |  | Wilwood 1/8-27 | 4 in pack | $11.00 | Wilwood | 2 | $22.00
 | Shaft Key Large (1) | 1.5x.3125x.5 | Mild Steel | 12 in length | $3.00 | Fastenal, or Gibbs? | 1 | $3.00
 |  |  |  |  |  |  |  | $344.17 | $316.21 | Money saved using by using tube instead of solid.

Sheet: Database
Material | Type | Dimensions | Cost | source | By the Inch? | Notes
1045 Steel Cold | Rod | 3.75in OD, 1 ft length | $78.00 | Speedy Metals
1045 Steel Hot | Rod | 4in OD, 1 ft length | $64.00 | Speedy Metals | 6.27
4130 Steel | Plate | .1x12x12 in | $22.00 | Online Metals
6061 Aluminum | Plate | .125x12x12 in | $18.00 | Gibbs |  | estimates
6061 Aluminum | Plate | .1x12x12 in | $12.00 | Gibbs |  | estimates
6061 Aluminum | Plate | .125x12x12 in | $39.00 | McMaster
6061 Aluminum | Plate | .125x12x12 in | $16.00 | Online Metals
6061 Aluminum | Plate | .1x12x12 in | $13.00 | Online Metals
6061 Aluminum | Plate | .1x12x12 in | $13.00 | Speedy Metals
6061 Aluminum | Plate | .25x12x12in | $25.00 | Speedy Metals
6061 Aluminum | Rod | 5.75in OD, 1ft length | $147.00 | McMaster | yes
6061 Aluminum | Rod | 6in OD, 1ft length | $160.00 | McMaster | yes
6061 Aluminum | Rod | 6in OD, 1ft length | $154.00 | Online Metals
6061 Aluminum | Rod | 5.75in OD, 1ft length | $144.00 | Speedy Metals | 14.06
6061 Aluminum | Rod | 6in OD, 1ft length | $159.00 | Speedy Metals | yes
6061 Aluminum | Rod | 6in OD, 1ft length | $104.00 | TW Metal
6061 Aluminum | Tube | 6in OD, 5in ID 1ft length | $98.00 | McMaster | yes
6061 Aluminum | Tube | 6in OD, 5in ID 1ft length | $68.00 | Online Metals | yes
6061 Aluminum | Tube | 6in OD, 5in ID 1ft length | $59.00 | Speedy Metals | 5.74
6061 Aluminum | Tube | 6in OD, 5in ID 1ft length | $52.00 | TW Metal
