BDR16/svn-migration-dump/Electrical/Low Voltage/Low Voltage Design.xls

Sheet: Sensors
Control Sensors
Name | Location | Quantity | Type | Comments
Throttle potentiometer | Pedal box | 2 | Analog in
Brake switch | Pedal box | 1 | Digital in
Brake potentiometer | Pedal box | 1 | Analog in
Emergency stop | Pedal box | 1 | Hardwired
Car enable | Dashboard | 1 | Digital in
Fault light | Dashboard | 1 | Digital out | Amber, flash based error code
Car enabled light | Dashboard | 1 | Digital out | Green – don't turn on until HV feedback
IMD light | Dashboard | 1 | Hardwired | Red
Emergency stop | Dashboard | 1 | Hardwired
HV enable | Accumulator | 1 | Digital out
HV on feedback | Accumulator | 1 | Digital in
Right motor controller | Accumulator | 1 | CAN bus
Left motor controller | Accumulator | 1 | CAN bus
AMS | Accumulator | 1 | CAN bus
IMD feedback | Accumulator | 1 | Analog in
Pitot tube |  | 1 | Analog in | Traction control, torque vectoring
IMU | Center of gravity | 1 | I2C, SPI, UART | Traction control, torque vectoring
Spring potentiometers | Center of gravity | 4 | Analog in | Traction control, torque vectoring
DAQ communication | Electronics Bay | 1 | I2C, SPI, UART, CAN | Might not need this if BBB
Control CAN | Electronics Bay | 1 | CAN bus
DAQ Sensors
Name | Location | Quantity | Type | Comments
Stack temperature | Accumulator |  | Analog in or Digital in | Need to decide on a good sensor, could be analog or 1-wire
Stack pressure | Accumulator |  | Analog in
Tire temperature | Tires | 16 | Digital in | IR sensors
Cameras |  |  | USB
Storage | Electronics Bay |  | USB
Right motor controller | Accumulator | 1 | CAN bus
Left motor controller | Accumulator | 1 | CAN bus
AMS | Accumulator | 1 | CAN bus
Control communication | Electronics Bay | 1 | I2C, SPI | Might not need this if BBB
Speed display | Dashboard | 1 | I2C, SPI
DAQ CAN | Electronics Bay | 1 | CAN bus | Might move to control if we want less data
Motor Controller CAN Bus
Name | Type
Throttle Setpoint | Control
Brake Setpoint | Control
RPM Feedback | Control
Fault | Control
Current Feedback | DAQ
Voltage Feedback | DAQ
AMS CAN Bus
Name | Type
Contactor Request | Control
LLIM | Control
Fault | Control
Cell tab temperature | DAQ
Current | DAQ
Cell voltage | DAQ

Sheet: Calibration
Instrument | Method
Pedal box potentiometers | Calibrate in car (move pedals)
Spring potentiometers | Calibrate in car (tilt)
Carbon resistive pressure | Use weights and foam
Diode junction temperature | Cold water bath
IR temperature | Rubber in fixed temp oven?
IMU | Calibrate in car (tilt)
Pitot tube | Wind tunnel

Sheet: Dashboard
E-stop
IMD light
Fault light
Car enabled light
Car enable button
E-stop
Speed 7 segment display
Cell temperature 7 seg
Endurance race SOC
