BDR16/svn-migration-dump/Mechanical/Wheel Assemblies/Wheels/Tires/Tire Design.xls

Slicks
Company | Tire Name | Wheel OD (in) | Tire OD (in) | Tread Width (in) | Section Width (in) | Rim (in) | Weight (lb) | Price ($) | Tire Data | Link | Comments
Hoosier | 43127 | 13 | 21 | 6 | 7.3 | 5.5-6.5 | 11 | 169.6 | TTC 4, 6 | https://www.hoosiertire.com/Fsaeinfo.htm
Hoosier | 43163 | 13 | 21 | 7 | 8 | 5.5-8 | 11 | 169.6 | TTC 4, 5, 6 | https://www.hoosiertire.com/Fsaeinfo.htm
Hoosier | 43168 | 13 | 20.6 | 8 | 9.4 | 7-9 | 12 | 180.8 | TTC 4 | https://www.hoosiertire.com/Fsaeinfo.htm
Avon | 14227S | 13 | 20 | 6.2 |  | 6 |  |  | Avon and TTC 2 | http://www.avonmotorsport.com/resource-centre/tyre-applications/sae-formula-student
Avon | 14254S | 13 | 20 | 7.2 |  | 7 |  |  | Avon and TTC 2 | http://www.avonmotorsport.com/resource-centre/tyre-applications/sae-formula-student
Avon | 14140S | 13 | 20 | 8.2 |  | 9 |  |  | Avon | http://www.avonmotorsport.com/resource-centre/tyre-applications/sae-formula-student
Goodyear | 2646 | 13 | 20.5 | 7.2 | 9 | 7 | 9.5 | 242 | None | http://www.racegoodyear.com/tires/pdf/Goodyear_Sports_Catalog_2015.pdf
Goodyear | 2647 | 13 | 22.5 | 9.2 | 11.3 | 9 | 11.9 | 275 | None | http://www.racegoodyear.com/tires/pdf/Goodyear_Sports_Catalog_2015.pdf
Wets
Company | Tire Name | Wheel OD (in) | Tire OD (in) | Tread Width (in) | Section Width (in) | Rim (in) | Weight (lb) | Price ($) | Tire Data | Link | Comments
Hoosier | 44150 | 13 | 20.6 | 7.4 | 8.3 | 7-8 | 12 | 188 | None | https://www.hoosiertire.com/Fsaeinfo.htm
Hoosier | 44185 | 13 | 21.2 | 6.7 | 7.2 | 6-8 | 11 | 185.6 | None | https://www.hoosiertire.com/Fsaeinfo.htm
Avon | 14227S | 13 | 20 | 6.2 |  | 6 |  |  | None | http://www.avonmotorsport.com/resource-centre/tyre-applications/sae-formula-student
Avon | 14254S | 13 | 20 | 7.2 |  | 7 |  |  | None | http://www.avonmotorsport.com/resource-centre/tyre-applications/sae-formula-student
Avon | 14140S | 13 | 20 | 8.2 |  | 9 |  |  | None | http://www.avonmotorsport.com/resource-centre/tyre-applications/sae-formula-student
Goodyear | 1883 | 13 | 21 | 5.9 | 7.7 | 6 | 10.5 | 244 | None | http://www.racegoodyear.com/tires/pdf/Goodyear_Sports_Catalog_2015.pdf
Goodyear | 1318 | 13 | 22.4 | 8.8 | 11.1 | 8 | 13 | 287 | None | http://www.racegoodyear.com/tires/pdf/Goodyear_Sports_Catalog_2015.pdf
