BDR16/svn-migration-dump/Administration/Things to Sell.xlsx

Sheet: HV
Generic Name | Manufacturer | Product name | Product number | Used Cost | Quantity | Date put on Ebay | Date Sold | Money received
Electric Motor | Motenergy |  | ME0201014201 |  | 1
Electric Motor | ******* | J-series | **** |  | *****
Power Source | Orion |  | HP585D
Motor Controller | Kelly | **** | **** |  | 1 |  |  |  | http://kellycontroller.com/ksl7215024v-72v150asensorless-bldc-controller-p-668.html
AC to DC converter | Vector | VEC-043B |  |  | 1
Motor Controller | Sevcon | Gen4 72 - 80V 350A | 634A83201 |  | 1
Motor Controller | New Generation Motor |  | NGM-SC-C100 |  | 1
Fuses | Bussman | FWA-200B |  |  | 5
Fuses | Bussman | FWA-250B |  |  | 1

Sheet: LV
Generic Name | Manufacturer | Product name | Product number | Used Cost | Quantity | Date put on Ebay | Date Sold | Money received
Radio | Bendiking |  |  |  | 1
CPU board |  | M3A76-CM rev.1.00G |  |  | 1
Graphics Card | GEForce | GTX660Ti |  |  | 1
Graphics Card | Sparkle Computer Graphics | 9500GT(PCI-E) |  |  | 1
Copper Wire |  | AWG 126T200 Ratio 1.3:5 |  |  | Many feet
Hard Drive | Hitachi | Deskstar 500GB | HDP725050GLA360 |  | 1
Wireless Card | EdiMax |  | EW-7128g |  | 1

Sheet: Mechanical
Generic Name | Manufacturer | Product name | Product number | Used Cost | Quantity | Date put on Ebay | Date Sold | Money received
Motor Cycle Chain - hkk 50-2 |  |  |  |  | 1
Motor Cycle Chain - 520 )-ring | Valor | 520 O-ring Nickel |  |  | 1
Springs | Fox | 400x2.45 |  |  | 2
Springs | Fox | 550x2.35 |  |  | 2
Springs | Fox | 600x2.35 |  |  | 2
Springs | Risse | 750x2.25 |  |  | 2
Spring+damper | Risse | External Resevoir/ coilover |  |  | 2
Radiator |  | 5x12x2 |  |  | 3
Radiator | Ninja or CRF | 12x12x1 |  |  | 1
Carborator |  |  |  |  | 2
Spark plug | Laser Iridium | NGK |  |  | 2
Exhaust and tube | KTM | SXF |  |  | 1
Damper | Kawasaki |  | 92161-0213 |  | 2
Oil Filter | Purolator | PureONE | PL14459 |  | 2
Throttle Body | Keihin |  |  |  | 1
Rack and Pinion | Stiletto |  |  |  | 1
Rack and Pinion |  |  |  |  | 1
Damper | Koni | Adjustable Shock Absorbers | 7610-1277 |  | 2
Sprocket Rear | Sprocket Specialists | 520 - 51T |  |  | 1
Sprocket Rear Split | Sprocket Specialists | 520 - 63T |  |  | 1
Sprocket Rear Split | Sprocket Specialists | 420Z - 88T |  |  | 1
Sprocket Rear Split | Sprocket Specialists | 420Z - 77T |  |  | 1
Sprocket Rear | Sprocket Specialists | 520 - 44T |  |  | 1
Sprocket Front | Martin | 40BS14 5/8x2 |  |  | 2
Steering Wheels |  |  |  |  | 2
Hubs | Genuine Rockfard |  |  |  | 6
Brake Disks | Yamaha | YZFRG | 253-12486 |  | 2
Air Filter | Yellow |  |  |  | 1
Brake Pads | Denmark |  |  |  | 4
RPM counter |  |  |  |  | 1
Fuel Filter | Trackside | M18-0614 |  |  | 1

Sheet: Misc.
Generic Name | Manufacturer | Product name | Product number | Used Cost | Quantity | Date put on Ebay | Date Sold | Money received
Power Source? | Dynomite Dynamometer | ***** |  |  | 1
Data Computer | Dynomite Dynamometer | ***** |  |  | 1
Small Orange Safety Light |  |  |  |  | 3
Small Orange Safety Light | Peterson | V766MA |  |  | 1
Large Orange Safety Light |  |  |  |  | 2
Heat Tape |  |  |  |  | Many feet
Stator | Honda |  |  |  | 1
Scale | Ohaus | Triple Beam Balance |  |  | 1
Big Red Button | IDEC | Type HW1X |  |  | 1
Trailer Hitch and Ball | 1 7/8th |  |  |  | 1
Inkjet Printer | Canon | MP620 |  |  | 1
