BDR16/svn-migration-dump/Electrical/Current.ods

Functional Name | Manufacturer | Product | Quantity | Cont Current (A) | Peak Current (A)
IMD | Bender | IR155-3204 | 1 | 0.15 | 2
Motor controller | Unitek | Bamocar D3 400-400 | 2 | 0.58
AIR | Kilovac | EV200 | 2 | 0.13 | 3.8
Brake light |  |  | 1 | 0.28
TSAL | Super Bright LEDs Inc | LED Hideaway Strobe | 1 | 0.15 | 0.4
Dashboard LED |  |  | 4 | 0.01
AMS | eLithion | Lithiumate Pro | 1 | 0.15
AMS wireless | eLithion | Wireless Advisor | 1 | 0.3
TSVP | Super Bright LEDs Inc | M3-R6 | 2 | 0.04
Microcontroller | BeagleBoard | Beaglebone Black | 1 | 0.4
Transponder |  |  | 1 | 0.02
 |  |  |  |  |  | 2.99
