BDR16/svn-migration-dump/Administration/Project Management/Gantt Chart/Project Activity Parameters.xlsx

Project Activity Parameters - Based on Work Packages
Sub-Task Category | Activity | Predecessor Activity* | Duration | Responsible Party** | Resources | Cost
Planning | Vehicle architecture conceptual design |  | 4 weeks | Executive Board |  |  |  | Partially Paid
Chassis | Design | P. Completion | 8 weeks | Phil Piper, Dante Archangeli |  | $3500.00 | Work | Paid
 | Fabrication | Design | 12 weeks |  | Chassis Materials, A Fabricator, Money | $1000.00 | Material
Suspension | Tire selection | P. Completion | 2 weeks | Phil Piper | Access to TTC | $500.00 | TTO Access
 | Research and development | P. Completion | 10 weeks |  | Tire Selection | $2148.00 | Tires
 | Obtain Components | R and D | 2 weeks |  | Money | ??? | Springs/Dampers
 | Fabrication | R and D | 2 weeks |  | Machine Shop Acces, Welding Team | ??? | Bearings
 | Install | Fabrication | 1 week |  | Car Time | ??? | Raw Material
Low Voltage | Circuit diagram | P. Completion | 3 weeks | Phil Piper |  | ??? | PCBS
 | Wiring diagram | Circuit Diagram | 2 weeks | Eli |  | ??? | Micro Controller
 | Obtain Components | Wiring Diagram | 2 weeks | Anton | Money | ??? | DAQ
 | Wiring Harness fabrication | Obtain Components | 4 weeks | Han | LV Components | ??? | Wiring and Other
 | Harness Test | Fabrication | 2 weeks
 | Install | Fabrication | 1 week |  | Car Time
High Voltage | Wiring Diagram | P. Completion | 5 weeks | Phil Piper |  | $5000.00 | Batteries
 | Obtain Components | Wiring Diagram | 1 week | Taha | Money | ??? | Accumulator (Non Batteries
 | Test batteries | Obtain Componenets | 2 weeks |  | Batteries | $3900.00 | Motor
 | First Battery Stack fabrication | Battery Test | 2 weeks |  | Batteries, Machine Shop Access | $3200.00 | Motor Controller
 | All Stacks fabrication | First Stack Fabrication | 2 weeks |  | Batteries, Machine Shop Access | $153.50 | Poron, Neoprene, Aluminum for heat spreaders
 | Accumulator Box fabrication | Accumulator Design | 3 weeks |  | Machine Shop Access, Protocase Sponsorship
 | Accumulator Test | Accumulator Box Design | 2 weels
 | Install | Fabrication | 1 week |  | Car Time
Impact Attenuator | Design | P. Completion | 2 weeks | Claire Mallon |  | $100.00
 | Obtain Components | Design | 1 week |  | Money
 | Fabrication | Design | 1 week |  | Extra material from chassis, Machine shop access, Welding Team
 | Test | Fabrication | 1 week |  | Extra IA device
 | Install | Fabrication | 1 week |  | Car Time
Firewall | Design | P. Completion | 2 weeks | Jordan Gardner |  | $80.00 | Aluminum
 | Obtain Components | Design | 1 week |  | Money | $100.00 | Insulating rubber
 | Fabrication | S. Design, Design | 2 weeks |  | Machine shop access
 | Install | Fabrication | 1 week |  | Car Time
Seat | Design | P. Completion | 3 weeks | Jordan Gardner |  | $100.00 | Foam for Mold
 | Obtain Components | Design | 1 week |  | Money | $150.00 | Foam Seat inserts
 | Fabrication | F. Design, Design | 7 weeks |  | Composites Team, Extra people, Wood shop access | $50.00 | Other Materials
 | Install | Fabrication | 1 week |  | Car Time
Body | Concept Creation | P. Completion | 4 weeks | Sida Tang | Graphic Designer | $0.00 | Carbon Fiber
 | Design | F. and Se. Completition, Concept Creation | 4 weeks | Jordan Gardner |  | $150.00 | Epoxy
 | Obtain Components | Design | 1 week | Tilman | Money | $300.00 | Foam
 | Fabrication | Obtain Components | 6 weeks |  | Composites Team, Extra people, Wood shop access | $150.00 | Vacuum bagging Stuff
 | Install | Fabrication | 1 week |  | Car Time | $50.00 | Dacron
Steering | Design | S. Design, P. Completion | 4 weeks | Yossi Kohrman-Glaser |  | $330.00 | Rack
 | Obtain Components | Design | 1 week |  | Money | $140.00 | Universal
 | Fabrication | Obtain Componenets | 4 weeks |  | Machine shop access, Welding Team | $153.00 | Raw Materials
 | Install | Fabrication | 1 week |  | Car Time | $180.00 | Steering Wheel
Transmission | Design | P. Completion | 4 weeks | Dante Archangeli |  | $300.00 | Steel and Aluminum Sheet
 | Obtain Components | Design | 1 week |  | Money | $100.00 | Bearings
 | Fabrication | Obtain Components | 3 weeks |  | Machine shop access, Welding Team | $1000.00 | Axles and tripos
 | Install | Fabrication | 1 week |  | Car Time | $4000.00 | housing and hubs
Brakes | Brake selection | P. Completion | 1 week | Holden Lessie-Bole |  | $172.00 | Master Cyliner
 | Design | Brake Slelection | 3 weeks |  |  | ??? | caliper and disk
 | Obtain Components | Design | 1 week |  | Money | $84.00 | lines and hardware
 | Fabrication | Obtain Components | 2 weeks |  | Machine shop access, Welding Team | $175.00 | Pedal Box hardware
 | Install | Fabrication | 1 week |  | Car Time | $60.00 | Aluminum Stock
Coolant System | Design | B. Completion, P. Completion | 4 weeks | Craig Wojtala | Fluids/Heat transder Lab Access
 | Obtain Components | Design | 1 week |  | Money | $300.00
 | Testing | Obtain Components | 2 weeks |  | Fluids/Heat transder Lab Access
 | Fabrication | Obtain Componenets | 2 weeks |  | Composites Team, Wood shop access
 | Install | Fabrication | 1 week |  | Car Time
Total Cost |  |  |  |  |  | $27625.50
* Predecessor Activity is prefaced with sub-task acronym if activity falls within a different sub-task
** A Party is responsible for the activities listed at, and below, their name
