BDR16/svn-migration-dump/Administration/Competition Forms/Formula Hybrid/SES/Structural Equivalency Spreadsheet.xlsm

Sheet: Read_Me
2016 Formula Hybrid Structural Equivalency Spreadsheet Guidance Notes
The SES template has been created to simplify the process of proving structural equivalency.
As downloaded the spreadsheet assumes a baseline steel chassis design. The majority of the cells in the spreadsheet are locked, you can only edit the cells shaded yellow.
Cells shaded grey are dependant on the data entered in yellow cells, the formulae in these grey cells have been left visible so you can see how the results are calculated.
The vast majority of the tabs can be accessed using the hyperlinks on the cover sheet. Note there are some that cannot such as the "additional info" and "welded tube insert" tabs. If you enable macros when opening the document "Ctrl+e" will always return you to the cover sheet.
There have been a few questions about how to handle bent/two piece tubes in place of a single baseline tube. If properly triangulated then the reinforced bent/two piece tube will be stiffer and stronger than the baseline tube, so please ensure you include images of the tube(s) in the "Chassis Pics" tab for the SES assessor to review. You may add additional proof of equivalence to the "Additional Info" tab if you deem it necessary. You do not need to adjust the number of tubes in the relevant calculation tab.
The SES has been extensively tested, but if you think you have found a mistake in the document or have any questions on how to use the template please submit a question to the FH rules committee in the usual manner.
If you find a new problem with the SES template or require a clarification 72 hours or less before the SES submission deadline please include your own proof of equivalency in the "Additional Info" tab as well as filing a Rules question.
Revisions:
V1.0 | First release for 2016 rules

Sheet: Version History
If you have to resubmit your SES then please update the table below, indicating what changes you have made from the previous submission.
Submission Version | Revision Comments
Original Submission | NA
First Revision | Updated the car number and event; updated the AI plate (it was steel, we switched to aluminum); addendum about honeycomb-to-AI plate attachment method per rule T3.20.3 (in additional info tab)

Sheet: Cover Sheet
2016 Formula HybridTM STRUCTURAL EQUIVALENCY SPREADSHEET (SES) V1.0 - COVER SHEET
This form must be completed and submitted by all teams no later than the date specified in the Action Deadlines on specific event website. The FSAE Technical Committee will review all submissions which deviate from the FSAETM rules and reply with a decision about the requested deviation. All requests will have a confirmation of receipt sent to the team. Structural Equivalency Spreadsheets (SES) must be submitted electronically in Microsoft Excel Format (*.xls). The submissions must be named as follows: schoolname_ses.xls using the complete school name. Please submit to the person indicated in the Action Deadlines for each event.
In the event that the FH Technical Committee requests additional information or calculations, teams have one week from the date of request to submit the requested information.
University Name |  |  | Yale University |  |  | Car No.(s) & Event(s) |  | Team #213, Formula Hybrid
Team Contact |  |  | Philip Piper |  |  | Email Address | philip.piper@yale.edu
Faculty Advisor |  |  | Joseph Zinter |  |  | Email Address | joseph.zinter@yale.edu
 |  |  |  |  |  |  |  |  | Tube and Laminate Equivalency |  |  |  |  |  |  |  |  | Tube 1 |  |  |  | Tube 2 |  |  |  | Tube 3 |  |  |  | Composite
Is proof of equivalency for your design required for any of the rules? |  |  |  |  |  |  |  |  | EI | Area | Yield | UTS | Yield as Welded | UTS as Welded | Max Bending Load at UTS | Max deflection at max baseline load | Energy absorbed during bending | Tube Material | Tube type | Outside Dimension | Wall thickness | Tube Material | Tube type | Outside Dimension | Wall thickness | Tube Material | Tube type | Outside Dimension | Wall thickness | Material | Panel Thickness | Skin Tickness | Panel Height
No. Chassis does not deviate from baseline requirements
Baseline Material Used |  | Alternative Material Used |  | Rule No. | Rule Description |  |  | Design Description and/or Material Used
YES |  | NO |  | T3.10 | Main Roll Hoop Tubing |  |  | 4130 Steel | NA | NA | NA | NA | NA | NA | NA | NA | NA | Steel | Round | 25.4 | 2.40
YES |  | NO |  | T3.11 | Front Roll Hoop Tubing |  |  | 4130 Steel | NA | NA | NA | NA | NA | NA | NA | NA | NA | Steel | Round | 25.4 | 2.40
YES |  | NO |  | T3.12 | Main Roll Hoop Bracing Tubing |  |  | 4130 Steel | NA | NA | NA | NA | NA | NA | NA | NA | NA | Steel | Round | 25.4 | 1.60
YES |  | NO |  | T3.12.6 | Main Hoop Bracing Support - Tube Frames |  |  | 4130 Steel | NA | NA | NA | NA | NA | NA | NA | NA | NA | Steel | Round | 25.4 | 1.25
YES |  | NO |  | T3.13 | Front Hoop Bracing - Tube Frames |  |  | 4130 Steel | NA | NA | NA | NA | NA | NA | NA | NA | NA | Steel | Round | 25.4 | 1.60
YES |  | NO |  | T3.18 | Front Bulkhead - Tube Frames |  |  | 4130 Steel | NA | NA | NA | NA | NA | NA | NA | NA | NA | Steel | Round | 25.4 | 1.60
YES |  | NO |  | T3.19 | Front Bulkhead Support - Tube Frames |  |  | 4130 Steel | NA | NA | NA | NA | NA | NA | NA | NA | NA | Steel | Round | 25.4 | 1.25
YES |  | NO |  | T3.24 | Side Impact Structure - Tube Frames |  |  | 4130 Steel | NA | NA | NA | NA | NA | NA | NA | NA | NA | Steel | Round | 25.4 | 1.60
YES |  | NO |  | T5.4 | Shoulder Harness Bar |  |  | 4130 Steel | NA | NA | NA | NA | NA | NA | NA | NA | NA | Steel | Round | 25.4 | 2.40
N/A |  | N/A |  | T3.36 | Front Hoop Bracing - Monocoques |  |  | N/A | NA | NA | NA | NA | NA | NA | NA | NA | NA
N/A |  | N/A |  | T3.31 | Front Bulkhead - Monocoques |  |  | N/A | NA | NA | NA | NA | NA | NA | NA | NA | NA
N/A |  | N/A |  | T3.32 | Front Bulkhead Support - Monocoques |  |  | N/A | NA | NA | NA | NA | NA | NA | NA | NA | NA
N/A |  | N/A |  | T3.33 | Side Impact Structure - Monocoques |  |  | N/A | NA | NA | NA | NA | NA | NA | NA | NA | NA
N/A |  | N/A |  | T3.36 | Main Hoop Bracing Support - Monocoques |  |  | N/A | NA | NA | NA | NA | NA | NA | NA | NA | NA
N/A |  | N/A |  | T3.34 | Main Hoop Attachment - Monocoques |  |  | N/A | NA
N/A |  | N/A |  | T3.35 | Front Hoop Attachment - Monocoques |  |  | N/A | NA
N/A |  | N/A |  | T3.36 | Hoop Bracing Attach. - Monocoques |  |  | N/A | NA
N/A |  | N/A |  | T3.37 | Impact Attenuator Attachment - Monocoques |  |  | N/A
YES |  | NO |  | T3.20.6 | Impact Attenuator Anti-Intrusion Plate |  |  | 6061-T6 Aluminum | NA
N/A |  | N/A |  | T3.40 | Safety Harness Attachment - Monocoques |  |  | N/A | NA
N/A |  | N/A |  | EV3.5.2 | Accumulator Attachment |  |  | 10 5/16" Grade 8 Hex Bolts
YES |  | NO |  | EV4.2.2 | Tractive System Protection |  |  | 4130 Steel | NA | NA | NA | NA | NA | NA | NA | NA | NA | Steel | Round | 25.4 | 1.25
Attachment Checklist (make sure all are included in your report)
P | Receipt, letter of donation or proof for non-steel materials (composite, honeycomb, resin, etc)
P | Properties for all non-steel materials
P | Monocoque Laminate Test data and pictures
P | Holes >4mm drilled in any regulated tubing require proof of equivalency, include area and moment of inertia
COMPLETE APPROPRIATE TABS TO PROVE EQUIVALENCY
Please see "Structural Equivalency Spreadsheet Guide" on the Read_Me tab of the SES Workbook
TECHNICAL COMMITTEE DECISION/COMMENTS
Approved by |  |  |  |  |  |  |  | Date
NOTE: THIS FORM AND THE APPROVED COPY OF THE SUBMISSION MUST BE PRESENTED AT TECHNICAL INSPECTION AT EVERY FORMULA SAE EVENT ENTERED

Sheet: Chassis Pics
Formula HybridTM STRUCTURAL EQUIVALENCY SPREADSHEET - CHASSIS PICTURES
University Name | Yale University |  | Car No.(s) & Event(s) | Team #213, Formula Hybrid
Please attach pictures of the frame and/or monocoque in the table below for review during the SES process. Please colour code all tubes to show outer diameter and wall thickness. Three view drawings and isometric views of the structure (CAD, FEA models, etc) are acceptable. Note: The final decision about all designs will be made at technical inspection. Approval of an SES does not guarantee passing Technical Inspection.
Images must include dimensions/labels indicating the following:
Angle of main and front hoops
Angle of main hoop bracing
Distance from top of main hoop to main hoop brace attachment
Distance from top of front hoop to front hoop brace attachment
Outer diameter and wall thickness of all tubes
Teams entering cars with EV Powertrains must show the location of all HV components in these images
Three View Legend
Color | Outer Diameter (in) | Thickness (in)
Red | 1 | 0.095
Green | 1 | 0.065 |  |  | Side View
Blue | 1 | 0.049
Yellow | 1 | 0.035
Purple | 0.5 | 0.035
Note that this legend does not apply to the chassis assembly with HV components.
Chassis Assembly with HV Components
 |  |  |  |  | Top View
HV Components Diagram |  |  |  |  | Front View | Isometric View

Sheet: MaterialData
Material Data Sheet
Material Spreadsheet Code | Steel | Aluminium 1 | Aluminium 2 | Carbon | Other 1 | Other 2 | Other 3 | Other 4 | Other 5 | Other 6
Material name | Steel | Aluminium | Aluminium | 2 ply | Your Mat. 1 | Your Mat. 2 | Your Mat. 3 | Your Mat. 4 | Your Mat. 5 | Your Mat. 6
Youngs Modulus, E | 200000000000 | 70000000000 | 2 | 3.214788025e+10 | 1 | 2 | 3 | 4 | 5 | 6
Yield strength, Pa | 305000000 | 276000000 | 2 | 226039783 | 1 | 2 | 3 | 4 | 5 | 6
UTS, Pa | 365000000 | 310000000 | 2 | 226039783 | 1 | 2 | 3 | 4 | 5 | 6
Yield strength, welded, Pa | 180000000 | 75000000 | 2 | N/A | 1 | 2 | 3 | 4 | 5 | 6
UTS welded, Pa | 300000000 | 62000000 | 2 | N/A | 1 | 2 | 3 | 4 | 5 | 6
UTS shear, Pa | 219000000 | 207000000 | 2 | 1 | 1 | 2 | 3 | 4 | 5 | 6
 | Steel properties based on SAE 1010 and are given in Rule T3.3.1 Note 1. Per rule T3.5 all steels are treated equally and are to use the above properties.
 | Results from extra physical test required by T3.30.1 should be entered in the "Other x" materials column as required.
Tubing only
Composite only
Tubes + composite
Round
Square

Sheet: Welded Tube Inserts
Welded Tube Insert Equivalency - required for all mandated tubes per T3.3 with drilled holes > 4mm dia.
If you have more than one type of insert please copy this tab
Material Property | Your Tube | Your Tube + Insert
Material type | Steel | Steel
Tube Shape | Round | N/A
Material name /grade | Steel | Steel
Youngs Modulus, E | 200000000000 | 200000000000
Yield strength, Pa | 305000000 | 305000000
UTS, Pa | 365000000 | 365000000
Yield strength, welded, Pa | N/A | 180000000
UTS welded, Pa | N/A | 300000000
Tube OD, mm | 25.4
Wall, mm | 2.4
 | Your Tube | Your Tube + Insert
OD, m | 0.0254
Wall, m | 0.0024
I, m^4 | 1.159348985e-08 | 0
EI | 2318.69797 | 0 | 0.0
Tube area, mm^2 | 173.4 | 0.0 | NA
Insert area, mm^2 | NA | 0.0 | NA
Yield tensile strength, N | 52891.85392 | 0 | 0.0
UTS, N | 63296.80878 | 0 | 0.0
Max load at mid span to give UTS for 1m long tube, N | 1332.794896 | 0 | 0.0
Max deflection at baseline load for 1m long tube, m | 0.01197506562 | 0 | 999.0
Energy absorbed up to UTS, J | 7.980153166 | 0 | 0.0
Note - the calculations above take account of the "as welded condition" strength reduction
Insert calculations or CAD screenshot proving tube + insert area and second moment
of area below. Use the "Additional Info" tab if more space is needed.

Sheet: T3.10 Main Hoop Tubing
Main Hoop Structural Equivalency - note, only steel may be used
Material Property | Baseline | Your Tube
Material type | Steel | Steel
Tube shape | Round | Round
Material name /grade | Steel | Steel
Youngs Modulus, E | 200000000000 | 200000000000
Yield strength, Pa | 305000000 | 305000000
UTS, Pa | 365000000 | 365000000
Yield strength, welded, Pa | 180000000 | 180000000
UTS welded, Pa | 300000000 | 300000000
Tube OD, mm | 25.4 | 25.4
Wall, mm | 2.4 | 2.4
 | Baseline | Your Tube
OD, m | 0.0254 | 0.0254
Wall, m | 0.0024 | 0.0024
I, m^4 | 1.159348985e-08 | 1.159348985e-08
EI | 2318.69797 | 2318.69797 | 100.0
Area, mm^2 | 173.4 | 173.4 | 100.0
Yield tensile strength, N | 52891.85392 | 52891.85392 | 100.0
UTS, N | 63296.80878 | 63296.80878 | 100.0
Yield tensile strength, N as welded | 31214.86461 | 31214.86461 | 100.0
UTS, N as welded | 52024.77434 | 52024.77434 | 100.0
Max load at mid span to give UTS for 1m long tube, N | 1332.794896 | 1332.794896 | 100.0
Max deflection at baseline load for 1m long tube, m | 0.01197506562 | 0.01197506562 | 100.0
Energy absorbed up to UTS, J | 7.980153166 | 7.980153166 | 100.0

Sheet: T3.11 Front Hoop Tubing
Front Hoop Structural Equivalency
Material Property | Baseline | Your Tube
Material type | Steel | Steel
Tube shape | Round | Round
Material name /grade | Steel | Steel
Youngs Modulus, E | 200000000000 | 200000000000
Yield strength, Pa | 305000000 | 305000000
UTS, Pa | 365000000 | 365000000
Yield strength, welded, Pa | 180000000 | 180000000
UTS welded, Pa | 300000000 | 300000000
Tube OD, mm | 25.4 | 25.4
Wall, mm | 2.4 | 2.4
 | Baseline | Your Tube
OD, m | 0.0254 | 0.0254
Wall, m | 0.0024 | 0.0024
I, m^4 | 1.159348985e-08 | 1.159348985e-08
EI | 2318.69797 | 2318.69797 | 100.0
Area, mm^2 | 173.4 | 173.4 | 100.0
Yield tensile strength, N | 52891.85392 | 52891.85392 | 100.0
UTS, N | 63296.80878 | 63296.80878 | 100.0
Yield tensile strength, N as welded | 31214.86461 | 31214.86461 | 100.0
UTS, N as welded | 52024.77434 | 52024.77434 | 100.0
Max load at mid span to give UTS for 1m long tube, N | 1332.794896 | 1332.794896 | 100.0
Max deflection at baseline load for 1m long tube, m | 0.01197506562 | 0.01197506562 | 100.0
Energy absorbed up to UTS, J | 7.980153166 | 7.980153166 | 100.0

Sheet: T3.12 Main Hoop Bracing
Main Hoop Bracing - Note: Only Steel may be used
Material Property | Baseline | Your Tube
Material type | Steel | Steel
Tube shape | Round | Round
Material name /grade | Steel | Steel
Youngs Modulus, E | 200000000000 | 200000000000
Yield strength, Pa | 305000000 | 305000000
UTS, Pa | 365000000 | 365000000
Yield strength, welded, Pa | 180000000 | 180000000
UTS welded, Pa | 300000000 | 300000000
Tube OD, mm | 25.4 | 25.4
Wall, mm | 1.6 | 1.6
 | Baseline | Your Tube
OD, m | 0.0254 | 0.0254
Wall, m | 0.0016 | 0.0016
I, m^4 | 8.50991848e-09 | 8.50991848e-09
EI | 1701.983696 | 1701.983696 | 100.0
Area, mm^2 | 119.6 | 119.6 | 100.0
Yield tensile strength, N | 36487.71372 | 36487.71372 | 100.0
UTS, N | 43665.62461 | 43665.62461 | 100.0
Yield tensile strength, N as welded | 21533.73268 | 21533.73268 | 100.0
UTS, N as welded | 35889.55447 | 35889.55447 | 100.0
Max load at mid span to give UTS for 1m long tube, N | 978.305589 | 978.305589 | 100.0
Max deflection at baseline load for 1m long tube, m | 0.01197506562 | 0.01197506562 | 100.0
Energy absorbed up to UTS, J | 5.857636811 | 5.857636811 | 100.0

Sheet: T3.12.6 T3.36 MHoop Brace Spt
Main Hoop Bracing Supports
 | Enter construction type |  | Tubing only
Material Property | Baseline | Your Tube | Your Composite | Your Total
Material type | Steel | Steel | Carbon
Tubing Type | Round | Round | NA
Material name /grade | Steel | Steel | 2 ply
Youngs Modulus, E | 200000000000 | 200000000000 | 3.214788025e+10
Yield strength, Pa | 305000000 | 305000000 | 226039783
UTS, Pa | 365000000 | 365000000 | 226039783
Yield strength, welded, Pa | 180000000 | 180000000 | N/A
UTS welded, Pa | 300000000 | 300000000 | N/A
Number of tubes | 2 | 2
Tube OD, mm | 25.4 | 25.4
Wall, mm | 1.25 | 1.25
Thickness of panel, mm |  |  | 22
Thickness of core, mm |  |  | 18
Thickness of skins, mm |  |  | 2
Panel height,mm |  |  | 200
OD, m | 0.0254 | 0.0254
Wall, m | 0.00125 | 0.00125
I, m^4 | 6.933293195e-09 | 6.933293195e-09 | Tubing Only | 6.933293195e-09
EI | 2773.317278 | 2773.317278 |  | 2773.317278 | 100.0
Area, mm^2 | 189.7 | 189.7 |  | 189.7 | 100.0
Yield tensile strength, N | 57850.46522 | 57850.46522 |  | 57850.46522 | 100.0
UTS, N | 69230.88461 | 69230.88461 |  | 69230.88461 | 100.0
Yield tensile strength, N as welded | 34141.25816 | 34141.25816 |  | 34141.25816 | 100.0
UTS, N as welded | 56902.09694 | 56902.09694 |  | 56902.09694 | 100.0
Max load at mid span to give UTS for 1m long tube, N | 1594.111506 | 1594.111506 |  | 1594.111506 | 100.0
Max deflection at baseline load for 1m long tube, m | 0.01197506562 | 0.01197506562 |  | 0.01197506562 | 100.0
Energy absorbed up to UTS, J | 9.544794944 | 9.544794944 |  | 9.544794944 | 100.0

Sheet: T3.13 T3.36 FHoop Bracing
Front Hoop Bracing
 | Enter construction type |  | Tubing only
Material Property | Baseline | Your Tube | Your Composite | Your Total
Material type | Steel | Steel | Carbon
Tubing Type | Round | Round | NA
Material name /grade | Steel | Steel | 2 ply
Youngs Modulus, E | 200000000000 | 200000000000 | 3.214788025e+10
Yield strength, Pa | 305000000 | 305000000 | 226039783
UTS, Pa | 365000000 | 365000000 | 226039783
Yield strength, welded, Pa | 180000000 | 180000000 | N/A
UTS welded, Pa | 300000000 | 300000000 | N/A
Number of tubes | 1 | 1
Tube OD, mm | 25.4 | 25.4
Wall, mm | 1.6 | 1.6
Thickness of panel, mm |  |  | 22
Thickness of core, mm |  |  | 18
Thickness of skins, mm |  |  | 2
Panel height,mm |  |  | 200
OD, m | 0.0254 | 0.0254
Wall, m | 0.0016 | 0.0016
I, m^4 | 8.50991848e-09 | 8.50991848e-09 | Tubing Only | 8.50991848e-09
EI | 1701.983696 | 1701.983696 |  | 1701.983696 | 100.0
Area, mm^2 | 119.6 | 119.6 |  | 119.6 | 100.0
Yield tensile strength, N | 36487.71372 | 36487.71372 |  | 36487.71372 | 100.0
UTS, N | 43665.62461 | 43665.62461 |  | 43665.62461 | 100.0
Yield tensile strength, N as welded | 21533.73268 | 21533.73268 |  | 21533.73268 | 100.0
UTS, N as welded | 35889.55447 | 35889.55447 |  | 35889.55447 | 100.0
Max load at mid span to give UTS for 1m long tube, N | 978.305589 | 978.305589 |  | 978.305589 | 100.0
Max deflection at baseline load for 1m long tube, m | 0.01197506562 | 0.01197506562 |  | 0.01197506562 | 100.0
Energy absorbed up to UTS, J | 5.857636811 | 5.857636811 |  | 5.857636811 | 100.0

Sheet: T3.18 T3.31 Ft Bulkhead
Front Bulkhead
 | Enter construction type |  | Tubing only
Material Property | Baseline | Your Tube | Your Composite | Your Total |  | Monocoque Bulkhead Dimensions |  |  |  |  | BH | FBHS
Material type | Steel | Steel | Carbon |  |  |  |  |  | Bulkhead Height | b (m) | 0.03 | 0.0015 |  |  |  |  | 3
Tubing Type | Round | Round | NA |  |  |  |  | Cutout Height |  | h (m) | 0.002 | 0.0254
Material name /grade | Steel | Steel | 2 ply |  |  |  |  |  |  |  |  |  | 2.048383e-09
Youngs Modulus, E | 200000000000 | 200000000000 | 3.214788025e+10 |  |  |  |  |  |  | A1 (m^2) | 6e-05 | I1 (m^4) | 2e-11
Yield strength, Pa | 305000000 | 305000000 | 226039783 |  |  |  |  |  |  | A2 (m^2) | 6e-05 | I2 (m^4) | 2e-11 | 1 | 2 |  | 4
UTS, Pa | 365000000 | 365000000 | 226039783 |  |  |  |  |  |  | A3 (m^2) | 3.81e-05 | I3 (m^4) | 2.048383e-09
Yield strength, welded, Pa | 180000000 | 180000000 | N/A |  |  |  | Cutout Width |  |  | A4 (m^2) | 3.81e-05 | I4 (m^4) | 2.048383e-09
UTS welded, Pa | 300000000 | 300000000 | N/A |  |  |  |  |  |  | x1 (m) | 0.001 | Ic1 (m^4) | 2.214897007e-08
 |  |  |  |  |  | Bulkhead Width |  |  |  | x2 (m) | 0.021 | Ic2 (m^4) | 5.796089555e-11
Number of tubes | 2 | 2 |  |  |  |  |  |  |  | x3 (m) | 0.0347 | Ic3 (m^4) | 1.005384045e-08
Tube OD, mm | 25.4 | 25.4 |  |  |  |  | Bulkhead Width, mm | 300 |  | x4 (m) | 0.0347 | Ic4 (m^4) | 1.005384045e-08 | Bulkhead |  | Front Bulkhead Support
Wall, mm | 1.6 | 1.6 |  |  |  |  | Bulkhead Height, mm | 350 |  | Centroid (m) | 0.0202
 |  |  |  |  |  |  | Cutout Width, mm | 240 |  |  |  | Ic12 (m^4) | 2.220693097e-08
Thickness of panel, mm |  |  | 22 |  |  |  | Cutout Height, mm | 250 |  |  |  | Ic34 (m^4) | 2.010768091e-08
Thickness of core, mm |  |  | 18 |  |  |  |  |  |  |  |  | E34 | 3.214788025e+10
Thickness of skins, mm |  |  | 2
Panel height,mm |  |  | 60
OD, m | 0.0254 | 0.0254
Wall, m | 0.0016 | 0.0016
I, m^4 | 8.50991848e-09 | 8.50991848e-09 | Tubing Only | 8.50991848e-09
EI | 3403.967392 | 3403.967392 |  | 3403.967392 | 100.0
Area, mm^2 | 239.3 | 239.3 |  | 239.3 | 100.0
Yield tensile strength, N | 72975.42743 | 72975.42743 |  | 72975.42743 | 100.0
UTS, N | 87331.24922 | 87331.24922 |  | 87331.24922 | 100.0
Yield tensile strength, N as welded | 43067.46537 | 43067.46537 |  | 43067.46537 | 100.0
UTS, N as welded | 71779.10895 | 71779.10895 |  | 71779.10895 | 100.0
Max load at mid span to give UTS for 1m long tube, N | 1956.611178 | 1956.611178 |  | 1956.611178 | 100.0
Max deflection at baseline load for 1m long tube, m | 0.01197506562 | 0.01197506562 |  | 0.01197506562 | 100.0
Energy absorbed up to UTS, J | 11.71527362 | 11.71527362 |  | 11.71527362 | 100.0

Sheet: T3.19 T3.32 FBH S'pt Structure
Front Bulkhead Support Structure
 | Enter construction type |  | Tubing only
Material Property | Baseline | Your Tube type 1 | Your Tube type 2 | Your Tube type 3 | Your Tubes Total | Your Composite | Your Total
Material type | Steel | Steel | Steel | Steel |  | Carbon
Tubing Type | Round | Round | Round | Round |  | NA
Material name /grade | Steel | Steel | Steel | Steel |  | 2 ply
Youngs Modulus, E | 200000000000 | 200000000000 | 200000000000 | 200000000000 |  | 3.214788025e+10
Yield strength, Pa | 305000000 | 305000000 | 305000000 | 305000000 |  | 226039783
UTS, Pa | 365000000 | 365000000 | 365000000 | 365000000 |  | 226039783
Yield strength, welded, Pa | 180000000 | 180000000 | 180000000 | 180000000 |  | N/A
UTS welded, Pa | 300000000 | 300000000 | 300000000 | 300000000 |  | N/A
Number of tubes | 3 | 3 | 0 | 0
Tube OD, mm | 25.4 | 25.4 | 25.4 | 25.4
Wall, mm | 1.25 | 1.25 | 1.25 | 1.25
 |  |  | Baseline design? | YES
Thickness of panel, mm |  | YES | N/A | N/A |  | 25
Thickness of core, mm |  |  |  |  |  | 22
Thickness of skins, mm |  |  |  |  |  | 1.5
Panel height,mm |  |  |  |  |  | 300
OD, m | 0.0254 | 0.0254 | No tubes | No tubes
Wall, m | 0.00125 | 0.00125
I, m^4 | 6.933293195e-09 | 6.933293195e-09 |  |  | 6.933293195e-09 | Tubing Only | 6.933293195e-09
EI | 4159.975917 | 4159.975917 |  |  | 4159.975917 |  | 4159.975917 | 100.0
Area, mm^2 | 284.5 | 284.5 |  |  | 284.5 |  | 284.5 | 100.0
Yield tensile strength, N | 86775.69783 | 86775.69783 |  |  | 86775.69783 |  | 86775.69783 | 100.0
UTS, N | 103846.3269 | 103846.3269 |  |  | 103846.3269 |  | 103846.3269 | 100.0
Yield tensile strength, N as welded | 51211.88724 | 51211.88724 |  |  | 51211.88724 |  | 51211.88724 | 100.0
UTS, N as welded | 85353.14541 | 85353.14541 |  |  | 85353.14541 |  | 85353.14541 | 100.0
Max load at mid span to give UTS for 1m long tube, N | 2391.16726 | 2391.16726 |  |  | 2391.16726 |  | 2391.16726 | 100.0
Max deflection at baseline load for 1m long tube, m | 0.01197506562 | 0.01197506562 |  |  | 0.01197506562 |  | 0.01197506562 | 100.0
Energy absorbed up to UTS, J | 14.31719242 | 14.31719242 |  |  | 14.31719242 |  | 14.31719242 | 100.0
 | 1372.792053 | 1386.658639 | 9e+99 | 9e+99
If FEA is required for Composite structures then add this information below

Sheet: T3.20.6 IA AI Plate
Impact Attenuator Anti-Intrusion Plate
Material Property | Baseline | Your Plate
Material type | Steel | Aluminium 1
Material name /grade | Steel | Aluminium
Youngs Modulus, E | 200000000000 | 70000000000
Yield strength, Pa | 305000000 | 276000000
UTS, Pa | 365000000 | 310000000
Yield strength, welded, Pa | 180000000 | 75000000
UTS welded, Pa | 300000000 | 62000000
UTS shear, Pa | 219000000 | 207000000
Thickness of panel, mm | 1.5 | 4
Panel height,mm | 305 | 305
I, m^4 | 8.578125e-11 | 1.626666667e-09
EI | 17.15625 | 113.8666667 | 100.0
Area, mm^2 | 457.5 | 1220.0 | NA
Yield tensile strength, N | 139537.5 | 336720 | 100.0
UTS, N | 166987.5 | 378200 | 100.0
Yield tensile strength, N as welded | 82350 | 91500 | 100.0
UTS, N as welded | 137250 | 75640 | 100.0
Perimeter shear strength for 25mm dia punch, N | 25800.32967 | 65030.96793 | 100.0
Max load at mid span to give UTS for 1m long tube, N | 166.9875 | 1008.533333 | 100.0
Max deflection at baseline load for 1m long tube, m | 0.2027777778 | 0.03055245536 | 100.0
Energy absorbed up to UTS, J | 16.93067708 | 93.04920635 | 100.0
 |  |  | PA

Sheet: T3.24 T3.33 Side Impact Struct.
Side Impact Structure
 | Enter construction type |  | Tubing only
Material Property | Baseline | Your Tube type 1 | Your Tube type 2 | Your Tube type 3 | Your Tubes Total | Your Composite | Your Total
Material type | Steel | Steel | Steel | Steel |  | Carbon
Tubing Type | Round | Round | Round | Round |  | NA
Material name /grade | Steel | Steel | Steel | Steel |  | 2 ply
Youngs Modulus, E | 200000000000 | 200000000000 | 200000000000 | 200000000000 |  | 3.214788025e+10
Yield strength, Pa | 305000000 | 305000000 | 305000000 | 305000000 |  | 226039783
UTS, Pa | 365000000 | 365000000 | 365000000 | 365000000 |  | 226039783
Yield strength, welded, Pa | 180000000 | 180000000 | 180000000 | 180000000 |  | N/A
UTS welded, Pa | 300000000 | 300000000 | 300000000 | 300000000 |  | N/A
Number of tubes | 3 | 3 | 0 | 0
Tube OD, mm | 25.4 | 25.4 | 25.4 | 25.4
Wall, mm | 1.6 | 1.6 | 1.6 | 1.6
 |  |  | Baseline design? | YES
Thickness of panel, mm |  | YES | N/A | N/A |  | 25
Thickness of core, mm |  |  |  |  |  | 22
Thickness of skins, mm |  |  |  |  |  | 1.5
Panel height,mm |  |  |  |  |  | 300
OD, m | 0.0254 | 0.0254 | No tubes | No tubes
Wall, m | 0.0016 | 0.0016
I, m^4 | 8.50991848e-09 | 8.50991848e-09 |  |  | 8.50991848e-09 | Tubing Only | 8.50991848e-09
EI | 5105.951088 | 5105.951088 |  |  | 5105.951088 |  | 5105.951088 | 100.0
Area, mm^2 | 358.9 | 358.9 |  |  | 358.9 |  | 358.9 | 100.0
Yield tensile strength, N | 109463.1411 | 109463.1411 |  |  | 109463.1411 |  | 109463.1411 | 100.0
UTS, N | 130996.8738 | 130996.8738 |  |  | 130996.8738 |  | 130996.8738 | 100.0
Yield tensile strength, N as welded | 64601.19805 | 64601.19805 |  |  | 64601.19805 |  | 64601.19805 | 100.0
UTS, N as welded | 107668.6634 | 107668.6634 |  |  | 107668.6634 |  | 107668.6634 | 100.0
Max load at mid span to give UTS for 1m long tube, N | 2934.916767 | 2934.916767 |  |  | 2934.916767 |  | 2934.916767 | 100.0
Max deflection at baseline load for 1m long tube, m | 0.01197506562 | 0.01197506562 |  |  | 0.01197506562 |  | 0.01197506562 | 100.0
Energy absorbed up to UTS, J | 17.57291043 | 17.57291043 |  |  | 17.57291043 |  | 17.57291043 | 100.0
 | 1684.963859 | 1701.983696 | 9e+99 | 9e+99
If FEA is required for Composite structures then add this information below

Sheet: T3.30 Laminate Test
Formula HybridTM SES - LAMINATE TEST RESULTS |  |  |  |  |  |  |  |  |  |  |  | Formula HybridTM SES - RIG COMPLIANCE TEST RESULTS (OPTIONAL)
University Name |  |  | Yale University |  |  |  | Car No.(s) & Event(s) |  |  | Team #213, Formula Hybrid |  | University Name |  |  |  |  | Car No.(s) & Event(s)
 |  |  |  |  | Paste images of test setup here |  |  |  |  |  |  |  |  |  |  | Paste images of test setup here
Figure 1: Test setup - Laminate Panel |  |  |  |  |  |  |  |  |  |  |  | Figure 3: Test setup - Steel tube(s)
 |  |  |  |  | Paste load deflection curve here |  |  |  |  |  |  |  |  |  |  | Paste load deflection curve here
Figure 2: Load Deflection Curve |  |  |  |  |  |  |  |  |  |  |  | Figure 4: Load Deflection Curve - Steel Tube(s)
Enter values for minimum and maximum load/deflection in linear-elastic region |  |  |  |  |  |  |  |  |  |  |  | Enter values for minimum and maximum load/deflection in linear-elastic region
x1 (mm) |  | 0 |  | y1 (N) | 0 |  |  | Gradient (N/mm) | 2000 |  | 1276.487772 | x1 (mm) |  | 0 | y1 (N) | 0 |  | Gradient (N/mm) | 0
x2 (mm) |  | 5 |  | y2 (N) | 10000 | (>= bending stiffness of one baseline side impact tube) |  |  |  |  |  | x2 (mm) |  | 0 | y2 (N) | 0
Enter value for force at panel failure or maximum tested force |  |  |  |  |  |  |  |  |  |  |  | Enter details of tube(s) tested
ymax (N) |  | 15000 |  | (>= bending strength of two baseline side impact tubes) |  |  |  |  |  |  |  |  | l (mm) | 400 | Tube Support Span |  |  | Theoretical EI (N.mm2) | 1744439000
 |  | 4119.413135 |  |  |  |  |  |  |  |  |  |  | n | 1 | Number of Tubes |  |  | Tested EI (N.mm2) | 1744439000
Enter details of test setup, panel core and skin thicknesses below |  |  |  |  |  |  |  |  |  |  |  |  | Do (mm) | 25.4 | Tube Outer Diameter |  |  | Rig Compliance (N/mm) | 0
 | l (mm) | 400 |  | Panel Support Span |  |  |  |  |  |  |  |  | Di (mm) | 22.1 | Tube Inner Diameter
h (mm) |  | 200 |  | Panel Height (should be 200mm, alternative sizes must be agreed in advance)
b (mm) |  | 22 |  | Core Thickness (from T3.24/T3.33 Side Impact Structure tab)
t1 (mm) |  | 1.5 |  | Inner Skin Thickness (from T3.24/T3.33 Side Impact Structure tab)
t2 (mm) |  | 1.5 |  | Outer Skin Thickness (from T3.24/T3.33 Side Impact Structure tab)
 | I (mm4) | 82950 |  | Second moment of area
 | E (GPa) | 32.1 |  | Skin modulus of elasticity
 | σUTS(MPa) | 226.039783 |  | UTS of skins

Sheet: T3.30.2 Different Layups
Formula HybridTM SES - DIFFERENT LAYUP LAMINATE TEST RESULTS |  |  |  |  |  |  |  |  |  |  | Formula HybridTM SES - DIFFERENT LAYUP RIG COMPLIANCE TEST RESULTS (OPTIONAL)
University Name |  |  | Yale University |  |  | Car No.(s) & Event(s) |  |  | Team #213, Formula Hybrid |  | University Name |  |  |  |  | Car No.(s) & Event(s)
 |  |  |  |  | Paste images of test setup here |  |  |  |  |  |  |  |  |  | Paste images of test setup here
Figure 1: Test setup - Laminate Panel |  |  |  |  |  |  |  |  |  |  | Figure 3: Test setup - Steel tube(s)
 |  |  |  |  | Paste load deflection curve here |  |  |  |  |  |  |  |  |  | Paste load deflection curve here
Figure 2: Load Deflection Curve |  |  |  |  |  |  |  |  |  |  | Figure 4: Load Deflection Curve - Steel Tube(s)
Enter values for minimum and maximum load/deflection in linear-elastic region |  |  |  |  |  |  |  |  |  |  | Enter values for minimum and maximum load/deflection in linear-elastic region
x1 (mm) |  | 0 |  | y1 (N) | 0 |  | Gradient (N/mm) | 0 |  | 1276.487772 | x1 (mm) |  | 0 | y1 (N) | 0 |  | Gradient (N/mm) | 0
x2 (mm) |  | 0 |  | y2 (N) | 0 |  |  |  |  |  | x2 (mm) |  | 0 | y2 (N) | 0
Enter value for force at panel failure or maximum tested force |  |  |  |  |  |  |  |  |  |  | Enter details of tube(s) tested
ymax (N) |  | 0 |  | (>= bending strength of two baseline side impact tubes) |  |  |  |  |  |  |  | l (mm) | 400 | Tube Support Span |  |  | Theoretical EI (N.mm2) | 1744439000
 |  | 4119.413135 |  |  |  |  |  |  |  |  |  | n | 1 | Number of Tubes |  |  | Tested EI (N.mm2) | 1744439000
Enter details of test setup, panel core and skin thicknesses below |  |  |  |  |  |  |  |  |  |  |  | Do (mm) | 25.4 | Tube Outer Diameter |  |  | Rig Compliance (N/mm) | 0
 | l (mm) | 400 |  | Panel Support Span |  |  |  |  |  |  |  | Di (mm) | 22.1 | Tube Inner Diameter
h (mm) |  | 200 |  | Panel Height (should be 200mm, alternative sizes must be agreed in advance)
b (mm) |  | 22 |  | Core Thickness
t1 (mm) |  | 1.5 |  | Inner Skin Thickness
t2 (mm) |  | 1.5 |  | Outer Skin Thickness
 | I (mm4) | 82950 |  | Second moment of area
 | E (GPa) | 0.0 |  | Skin modulus of elasticity
 | σUTS(MPa) | 0 |  | UTS of skins

Sheet: T3.32.3 T3.33.3 Shear Tests
Formula HybridTM SES - T3.32.3 PERIMETER SHEAR TEST RESULTS |  |  |  |  |  |  | Formula HybridTM SES - T3.33.3 PERIMETER SHEAR TEST RESULTS
University Name |  | Yale University |  |  | Car No.(s) & Event(s) | Team #213, Formula Hybrid | University Name |  |  |  |  | Car No.(s) & Event(s)
 |  |  |  | Paste images of test setup here |  |  |  |  |  |  | Paste images of test setup here
Figure 1: Test setup |  |  |  |  |  |  | Figure 1: Test setup
 |  |  |  | Paste load deflection curve here |  |  |  |  |  |  | Paste load deflection curve here
Figure 2: Load Deflection Curve |  |  |  |  |  |  | Figure 2: Load Deflection Curve
Enter value for force at failure or maximum tested force |  |  |  |  |  |  | Enter value for force at failure or maximum tested force
ymax (N) |  | 0 | FAIL |  |  |  | ymax (N) |  | 0 | FAIL
Enter details of skin thickness |  |  |  |  |  |  | Enter details of skin thickness
 | t (mm) | 0.00 |  |  |  |  |  | t (mm) | 0.00
σshear (Mpa) |  | 0.0 | Shear strength of skin, used for attachment calcs where appropriate |  |  |  | σshear (Mpa) |  | 0.0 | Shear strength of skin, used for attachment calcs where appropriate

Sheet: T3.34 Main Hoop Attachments
Main Hoop Attachments
No. of attachment points per side | 2 | Note: A minimum of two attachment points per side are required
Attachment 1 | FAIL |  | Attachment 2 | FAIL |  | Attachment 3 | N/A |  | Attachment 4 | N/A
Fastener dia., mm | 0 | FAIL | Fastener dia., mm | 0 | FAIL | Fastener dia., mm | 0 | FAIL | Fastener dia., mm | 0 | FAIL
No. of fasteners | 0 | FAIL | No. of fasteners | 0 | FAIL | No. of fasteners | 0 | FAIL | No. of fasteners | 0 | FAIL
Bracket to hoop weld length, mm | 0 | FAIL | Bracket to hoop weld length, mm | 0 | FAIL | Bracket to hoop weld length, mm | 0 | FAIL | Bracket to hoop weld length, mm | 0 | FAIL
Bracket thickness, mm | 0 | FAIL | Bracket thickness, mm | 0 | FAIL | Bracket thickness, mm | 0 | FAIL | Bracket thickness, mm | 0 | FAIL
Bracket perimeter, mm | 0 |  | Bracket perimeter, mm | 0 |  | Bracket perimeter, mm | 0 |  | Bracket perimeter, mm | 0
Skin thickness, mm | 0 |  | Skin thickness, mm | 0 |  | Skin thickness, mm | 0 |  | Skin thickness, mm | 0
Skin shear strength, MPa | 0 |  | Skin shear strength, MPa | 0 |  | Skin shear strength, MPa | 0 |  | Skin shear strength, MPa | 0
Perimeter shear strength, kN | 0 | FAIL | Perimeter shear strength, kN | 0 | FAIL | Perimeter shear strength, kN | 0 | FAIL | Perimeter shear strength, kN | 0 | FAIL
Backing plate thickness, mm | 0 | FAIL | Backing plate thickness, mm | 0 | FAIL | Backing plate thickness, mm | 0 | FAIL | Backing plate thickness, mm | 0 | FAIL
Backing plate perimeter, mm | 0 |  | Backing plate perimeter, mm | 0 |  | Backing plate perimeter, mm | 0 |  | Backing plate perimeter, mm | 0
Perimeter shear strength, kN | 0 | FAIL | Perimeter shear strength, kN | 0 | FAIL | Perimeter shear strength, kN | 0 | FAIL | Perimeter shear strength, kN | 0 | FAIL
Insert images of each attachment point proving the values used to prove equivalence below:

Sheet: T3.35 Front Hoop Attachments
Front Hoop Attachments
No. of attachment points per side | 2 | Note: A minimum of two attachment points per side are required for hoops that aren’t fully laminated into the chassis
Front hoop material | Steel | Note: This affects the minimum bracket to hoop weld length to prove equivalence to a welded side impact tube to hoop joint
Side Impact or Frt B'Head S'port | SIS | Is the hoop attached to the side impact structure or the front bulkhead support structure, this affects the skin shear strength used from test results
Attachment 1 | FAIL |  | Attachment 2 | FAIL |  | Attachment 3 | N/A |  | Attachment 4 | N/A
Fastener dia., mm | 0 | FAIL | Fastener dia., mm | 0 | FAIL | Fastener dia., mm | 0 | FAIL | Fastener dia., mm | 0 | FAIL
No. of fasteners | 0 | FAIL | No. of fasteners | 0 | FAIL | No. of fasteners | 0 | FAIL | No. of fasteners | 0 | FAIL
Bracket to hoop weld length, mm | 0 | FAIL | Bracket to hoop weld length, mm | 0 | FAIL | Bracket to hoop weld length, mm | 0 | FAIL | Bracket to hoop weld length, mm | 0 | FAIL
Bracket thickness, mm | 0 | FAIL | Bracket thickness, mm | 0 | FAIL | Bracket thickness, mm | 0 | FAIL | Bracket thickness, mm | 0 | FAIL
Bracket perimeter, mm | 0 |  | Bracket perimeter, mm | 0 |  | Bracket perimeter, mm | 0 |  | Bracket perimeter, mm | 0
Skin thickness, mm | 0 |  | Skin thickness, mm | 0 |  | Skin thickness, mm | 0 |  | Skin thickness, mm | 0
Skin shear strength, MPa | 0 |  | Skin shear strength, MPa | 0 |  | Skin shear strength, MPa | 0 |  | Skin shear strength, MPa | 0
Perimeter shear strength, kN | 0 | FAIL | Perimeter shear strength, kN | 0 | FAIL | Perimeter shear strength, kN | 0 | FAIL | Perimeter shear strength, kN | 0 | FAIL
Backing plate thickness, mm | 0 | FAIL | Backing plate thickness, mm | 0 | FAIL | Backing plate thickness, mm | 0 | FAIL | Backing plate thickness, mm | 0 | FAIL
Backing plate perimeter, mm | 0 |  | Backing plate perimeter, mm | 0 |  | Backing plate perimeter, mm | 0 |  | Backing plate perimeter, mm | 0
Perimeter shear strength, kN | 0 | FAIL | Perimeter shear strength, kN | 0 | FAIL | Perimeter shear strength, kN | 0 | FAIL | Perimeter shear strength, kN | 0 | FAIL
Insert images of fully laminated hoop or each attachment point proving the values used to prove equivalence below:

Sheet: T3.36 Hoop B'ing Attachments
Monocoque Hoop Bracing Attachments
Front Hoop Brace to Monocoque? | NO | Set to "NO" if the front hoop bracing is attached to tubes or is integral to the monocoque
Front Hoop Brace Material? | Steel | This affects the minimum bracket to hoop weld length to prove equivalence to a welded side impact tube to hoop joint
Main Hoop Brace to Monocoque? | NO | Set to "NO" if the main hoop bracing is attached to tubes
Side Impact or Frt B'Head S'port | SIS | Is the main hoop bracing attached to a laminate the same as the side impact structure or front bulkhead support?
Front Hoop Bracing Attachment | N/A |  | Main Hoop Bracing Attachment | N/A
Fastener dia., mm | 0.0 | FAIL | Fastener dia., mm | 0.0 | FAIL
No. of fasteners | 0 | FAIL | No. of fasteners | 0 | FAIL
Bracket to brace weld length, mm | 0 | FAIL | Bracket to hoop weld length, mm | 0 | FAIL
Bracket thickness, mm | 0 | FAIL | Bracket thickness, mm | 0 | FAIL
Bracket perimeter, mm | 0 |  | Bracket perimeter, mm | 0
Skin thickness, mm | 0 |  | Skin thickness, mm | 0
Skin shear strength, MPa | 0 |  | Skin shear strength, MPa | 0
Perimeter shear strength, kN | 0 | FAIL | Perimeter shear strength, kN | 0 | FAIL
Backing plate thickness, mm | 0 | FAIL | Backing plate thickness, mm | 0 | FAIL
Backing plate perimeter, mm | 0 |  | Backing plate perimeter, mm | 0
Perimeter shear strength, kN | 0 | FAIL | Perimeter shear strength, kN | 0 | FAIL
Insert images of each attachment point proving the values used to prove equivalence below:

Sheet: T3.40 Harness Attachments
Formula HybridTM STRUCTURAL EQUIVALENCY SPREADSHEET - HARNESS ATTACHMENT TEST RESULTS
University Name | Yale University |  |  | Car No.(s) & Event(s) |  | Team #213, Formula Hybrid
 |  |  | Paste images of test setups here
Figure 1: Test setups
 |  |  | Paste load deflection curves here
Figure 2: Load Deflection Curves |  |  |  |  |  |  | Shoulder harness attached to monocoque? | NO
PASS |  |  |  |  |  |  | Lap-belt attached to monocoque? | NO
 |  |  |  |  |  |  | Anti-submarine bolt attached to monocoque? | NO
 |  |  |  |  |  |  | Combined Lap & Anti-submarine belt? | NO
Shoulder Harness Attachment
Enter value for force at failure or maximum tested force |  |  |  |  | (>= 13000N)
ymax (N) | 0 | N/A
Lap Belt Attachment
Enter value for force at failure or maximum tested force |  |  |  |  | (>= 13000N)
ymax (N) | 0 | N/A
Anti-submarine Belt Attachment
Enter value for force at failure or maximum tested force |  |  |  |  | (>= 6500N)
ymax (N) | 0 | N/A
Combined Lap Belt & Anti-submarine Belt Attachment
Enter value for force at failure or maximum tested force |  |  |  |  | (>= 19500N)
ymax (N) | 0 | N/A

Sheet: T5.4 Shoulder Harness Bar
Shoulder Harness Bar Equivalency
 | Enter construction type |  | Tubing only
Material Property | Baseline | Your Tube | Your Composite | Your Total
Material type | Steel | Steel | Carbon
Tubing Type | Round | Round | N/A
Material name /grade | Steel | Steel | 2 ply
Youngs Modulus, E | 200000000000 | 200000000000 | 3.214788025e+10
Yield strength, Pa | 305000000 | 305000000 | 226039783
UTS, Pa | 365000000 | 365000000 | 226039783
Yield strength, welded, Pa | 180000000 | 180000000 | N/A
UTS welded, Pa | 300000000 | 300000000 | N/A
Number of tubes | 1 | 1
Tube OD, mm | 25.4 | 25.4
Wall, mm | 2.4 | 2.4
Thickness of panel, mm |  |  | 22
Thickness of core, mm |  |  | 20
Thickness of skins, mm |  |  | 1
Panel height,mm |  |  | 300
OD, m | 0.0254 | 0.0254
Wall, m | 0.0024 | 0.0024
I, m^4 | 1.159348985e-08 | 1.159348985e-08 | Tubing Only | 1.159348985e-08
EI | 2318.69797 | 2318.69797 |  | 2318.69797 | 100.0
Area, mm^2 | 173.4 | 173.4 |  | 173.4 | 100.0
Yield tensile strength, N | 52891.85392 | 52891.85392 |  | 52891.85392 | 100.0
UTS, N | 63296.80878 | 63296.80878 |  | 63296.80878 | 100.0
Yield tensile strength, N as welded | 31214.86461 | 31214.86461 |  | 31214.86461 | 100.0
UTS, N as welded | 52024.77434 | 52024.77434 |  | 52024.77434 | 100.0
Max load at mid span to give UTS for 1m long tube, N | 1332.794896 | 1332.794896 |  | 1332.794896 | 100.0
Max deflection at baseline load for 1m long tube, m | 0.01197506562 | 0.01197506562 |  | 0.01197506562 | 100.0
Energy absorbed up to UTS, J | 7.980153166 | 7.980153166 |  | 7.980153166 | 100.0

Sheet: T3.37 IA Attachments
Formula HybridTM SES - MONOCOQUE IA ATTACHMENTS
University Name | Yale University | Car No.(s) & Event(s) | Team #213, Formula Hybrid
If you have a monocoque chassis enter your proof of equivalency to 4 Grade 8.8 M8 fasteners in the cells below.
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
