BDR16/svn-migration-dump/Administration/Orders/4_17_16 Order.ods

Total | 38.92
Name | Company | Product | Supplier | Quantity | Unit Price ($) | Link | Comments
BBB USB cable gland | Amphenol | AIO-CSPG7 | Digikey | 1 | 1.37 | http://www.digikey.com/product-detail/en/amphenol-industrial-operations/AIO-CSPG7/AIO-CSPG7-ND/3904945
Buzzer | Mallory Sonalert | SC648AJR | Digikey | 1 | 37.55 | http://www.digikey.com/product-detail/en/mallory-sonalert-products-inc/SC648AJR/458-1215-ND/1957981
