BDR16/svn-migration-dump/Mechanical/Accumulator/Charging/Charging.SLDASM

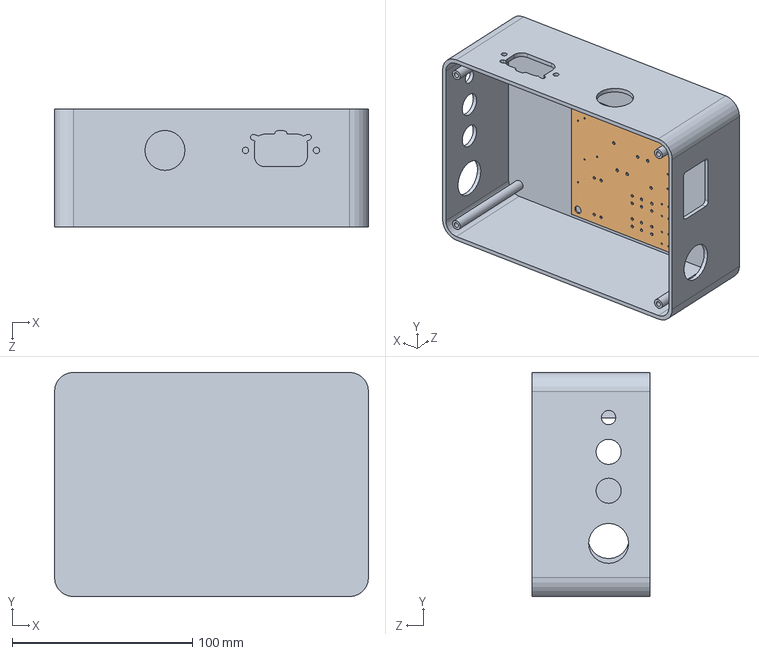
[picture p105: CAD file, 2016-09-20]
Mechanical/Accumulator/Charging/Charging.SLDASM
174.3 x 124.5 x 65.3 mm
Charging Box
Charging Board
