BDR16/svn-migration-dump/Mechanical/Accumulator/Covers/Covers.SLDASM

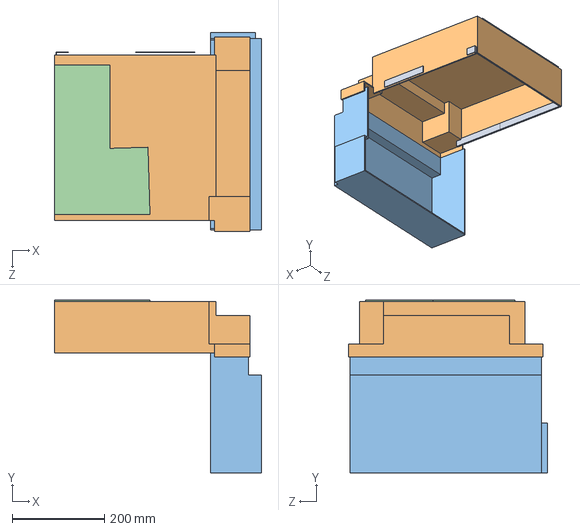
[picture p106: CAD file, 2016-09-20]
Mechanical/Accumulator/Covers/Covers.SLDASM
448.9 x 374.6 x 431.8 mm
Top Cover
Back Cover
