BDR16/svn-migration-dump/Mechanical/Accumulator/Stacks/Stack Parts/Insulation Film/Insulation Film Full.SLDPRT

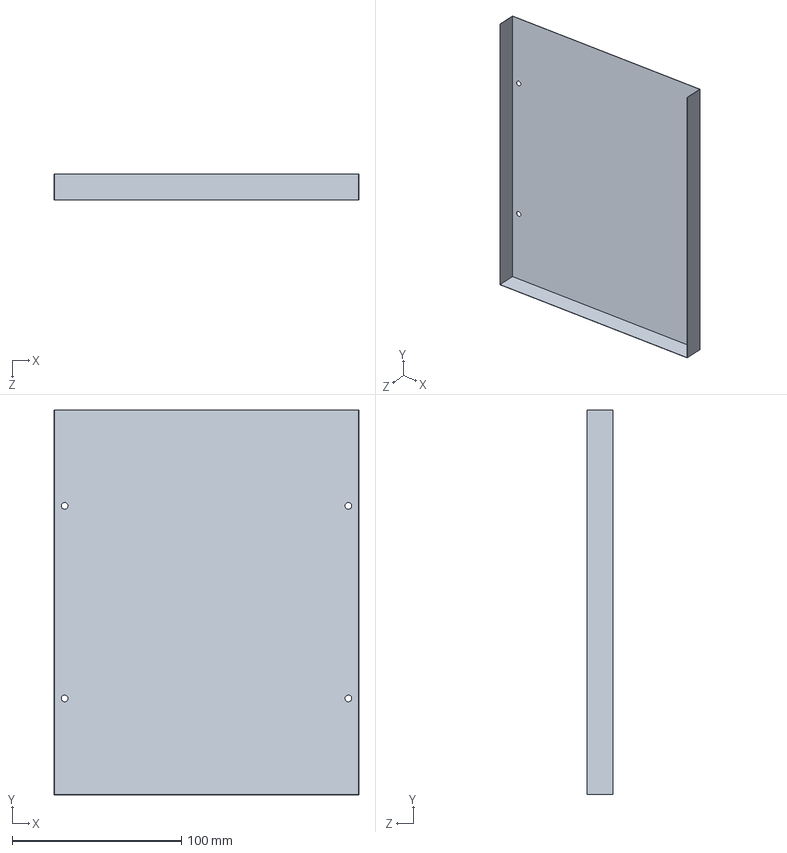
[picture p109: CAD file, 2016-09-20]
Mechanical/Accumulator/Stacks/Stack Parts/Insulation Film/Insulation Film Full.SLDPRT
179.7 x 227.2 x 15.5 mm
