BDR16/svn-migration-dump/Mechanical/Drivetrain/Coupler/Gearbox to Tripod/Tripod Coupler.SLDASM

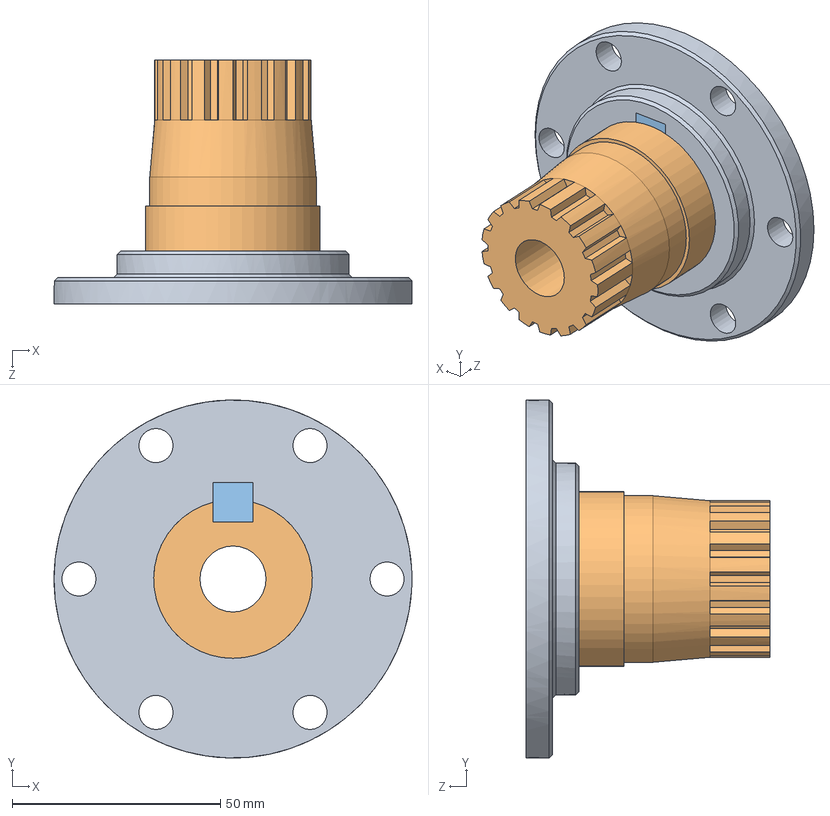
[picture p110: CAD file, 2016-09-20]
Mechanical/Drivetrain/Coupler/Gearbox to Tripod/Tripod Coupler.SLDASM
86.0 x 85.9 x 58.6 mm
Tripod Coupler Base
Tripod Coupler Shaft
Tripod Coupler Key
