BDR16/svn-migration-dump/Mechanical/Drivetrain/Drivetrain Left.SLDASM

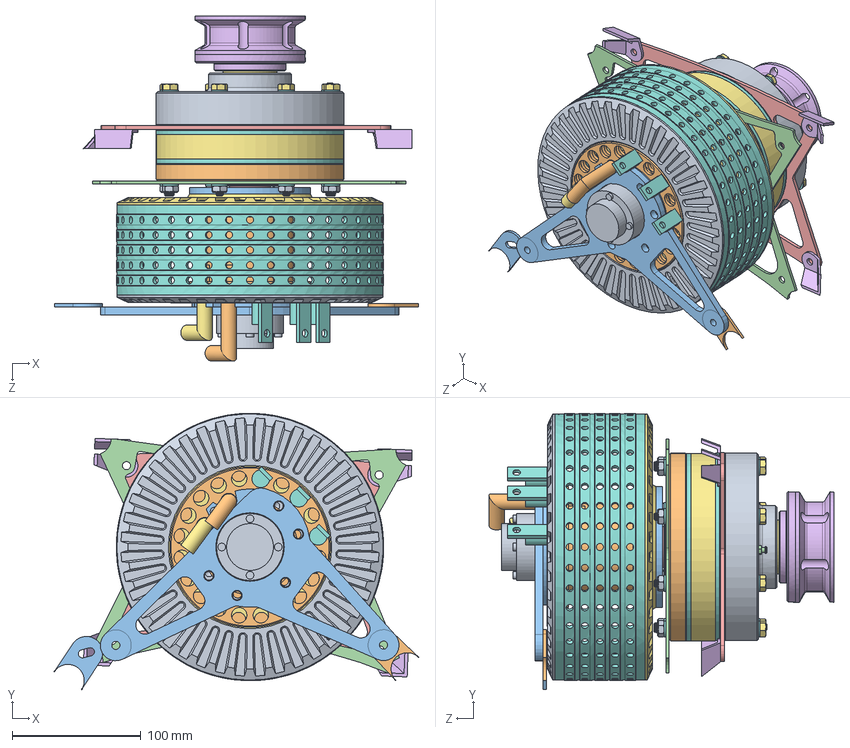
[picture p111: CAD file, 2016-09-20]
Mechanical/Drivetrain/Drivetrain Left.SLDASM
283.4 x 215.0 x 268.3 mm
Outer Cover
Inner Cover
Support Left
Inner Support
Outer Support
Outer Support Tabs
Coolant Pipe Short
Electrical Connector x 3
Resolver
Coolant Pipe Long
Resolver Plate
Axle Plate
Drive Plate
Nut x 16
Ring
Ring Cover x 2
Planet Gear x 4
Sun Gear
Coupler Base
Coupler Key
Coupler Shaft
Tripod Coupler Base
Tripod Coupler Shaft
Tripod Coupler Key
Harwal 32x52x8 ADL
Harwal 42x52x8 ADL
SKF 61808
Wilwood Bleeder Screw x 2
Nitrile Gasket x 3
Taylor INV-02002081
Steel Hex 1_4-20 3and1_4in Grade 5 x 8
Type 316 Steel 1_4in ID 1_2in OD Flat Washer x 16
Steel Thin Nyloc 1_4-20 Grade 8 x 8
Tab, Hole
Tab, Slot
