BDR16/svn-migration-dump/Mechanical/Drivetrain/Planetary Gearbox/Planetary Gearbox.SLDASM

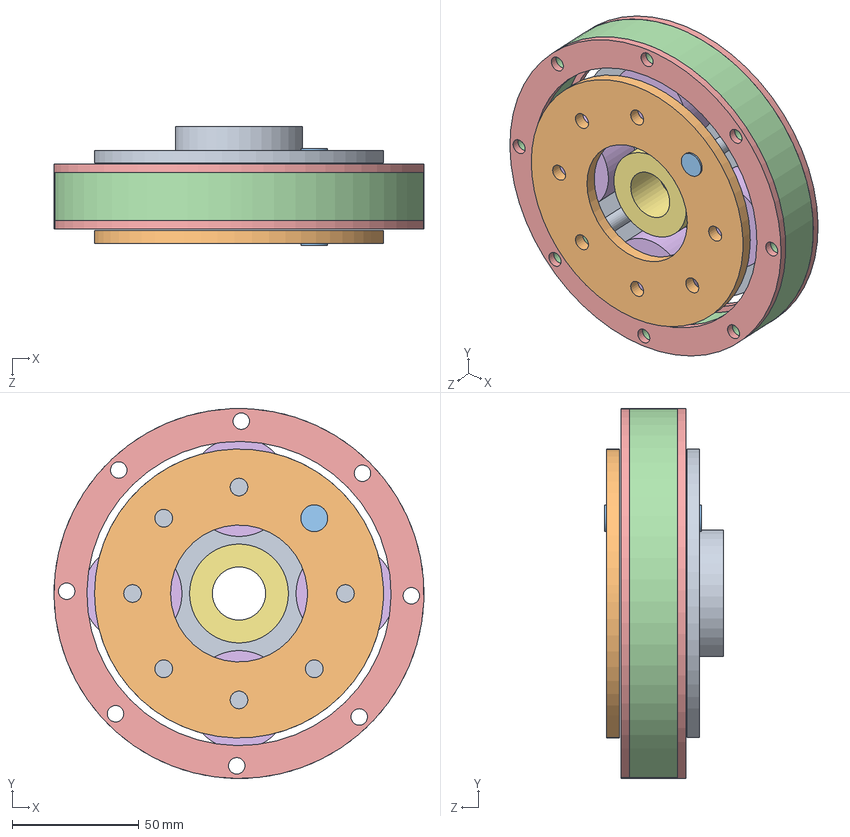
[picture p112: CAD file, 2016-09-20]
Mechanical/Drivetrain/Planetary Gearbox/Planetary Gearbox.SLDASM
146.0 x 146.0 x 46.8 mm
Axle Plate
Drive Plate
Nut x 2
Ring
Ring Cover x 2
Planet Gear x 4
Sun Gear
