BDR16/svn-migration-dump/Mechanical/Drivetrain/Tripod/RCV D4672-TA.SLDASM

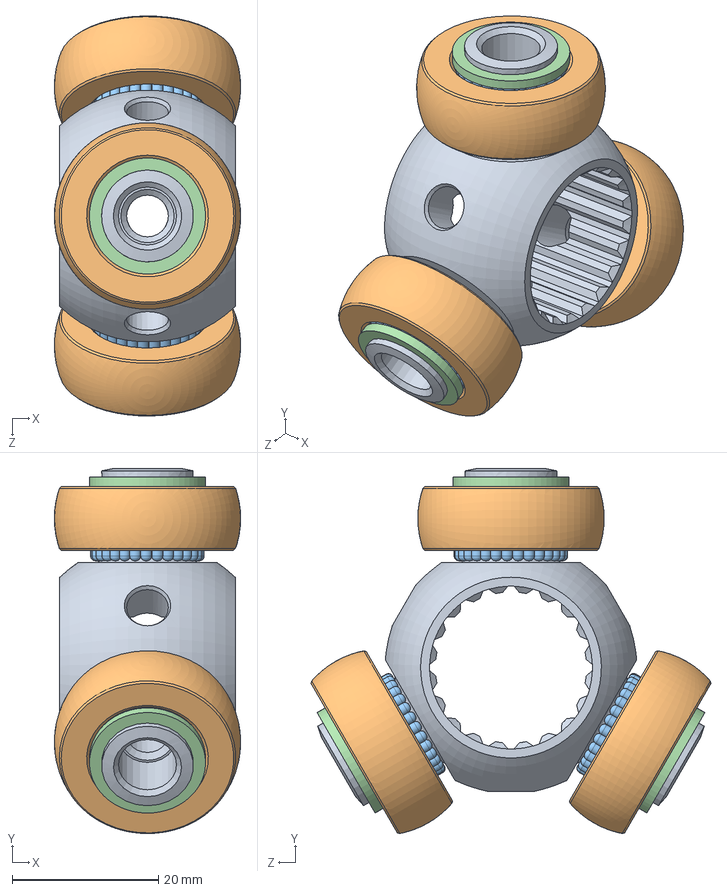
[picture p113: CAD file, 2016-09-20]
Mechanical/Drivetrain/Tripod/RCV D4672-TA.SLDASM
25.5 x 49.9 x 54.7 mm
FSAE Tripod V2
FSAE roller_2451 x 3
needle x 87
Tripod Retainer x 3
