BDR16/svn-migration-dump/Mechanical/Pedal Box/Master Cylinder/Master Cylinder.SLDASM

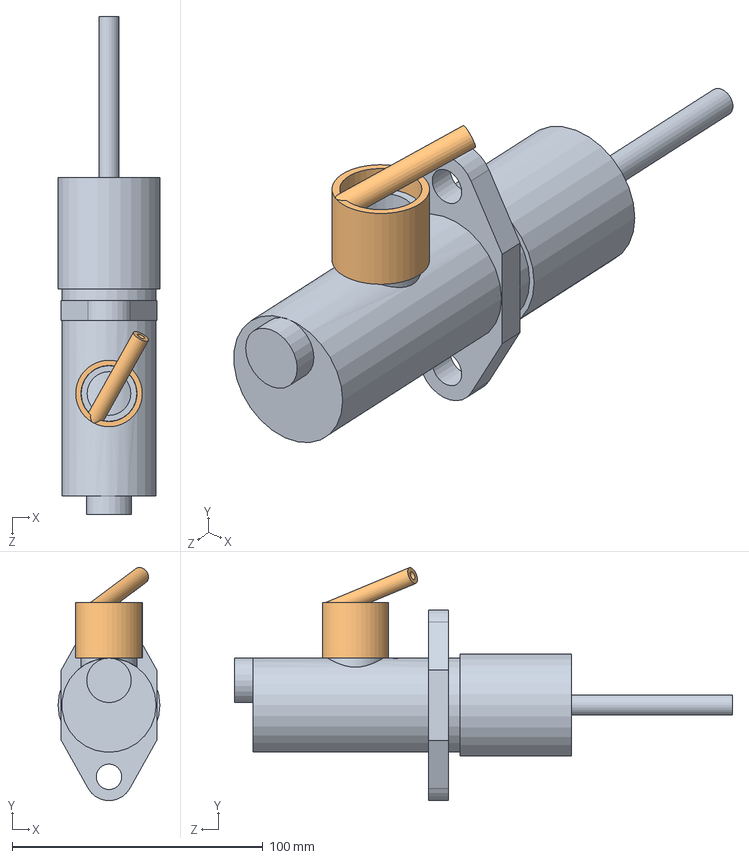
[picture p114: CAD file, 2016-09-20]
Mechanical/Pedal Box/Master Cylinder/Master Cylinder.SLDASM
40.6 x 93.0 x 198.6 mm
Reservoir Inlet
