BDR16/svn-migration-dump/Mechanical/Pedal Box/Over Travel Switch/Over Travel Switch.SLDASM

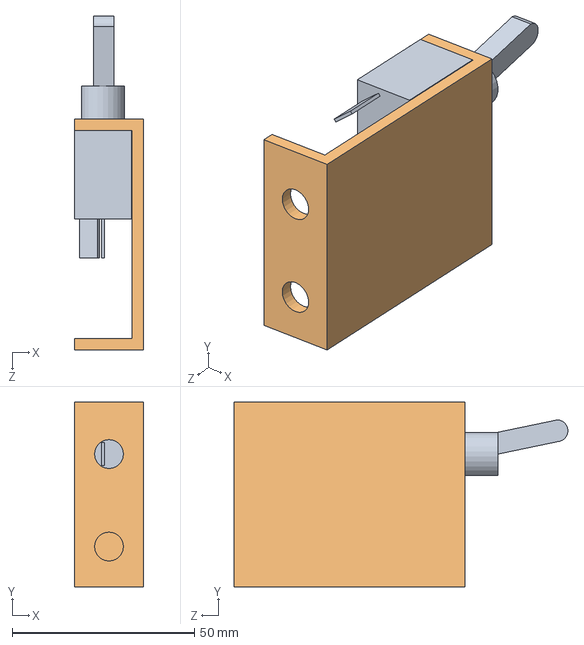
[picture p115: CAD file, 2016-09-20]
Mechanical/Pedal Box/Over Travel Switch/Over Travel Switch.SLDASM
19.1 x 50.8 x 91.7 mm
Toggle Switch
Switch Mount
