BDR16/svn-migration-dump/Mechanical/Pedal Box/Pedal Box in the Chassis.SLDASM

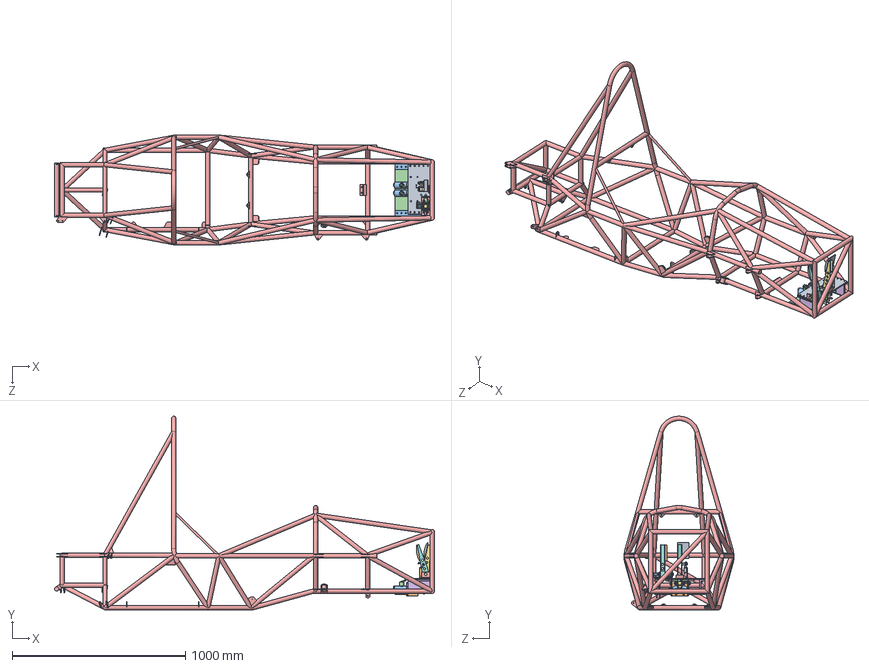
[picture p116: CAD file, 2016-09-20]
Mechanical/Pedal Box/Pedal Box in the Chassis.SLDASM
2192.5 x 1117.8 x 635.0 mm
Base Plate
C Bracket
Chassis Tabs
Foot Rest
L Bracket x 2
Risers x 2
Pedal Shaft Housing x 2
Pedal
Flanged Sleeve x 4
Narrow Pedal Pad
Steel Socket Shoulder 5_16in-18 1and3_4in x 2
Steel Nyloc 5_16-24 Grade 5
Accelerator Mount x 2
PTFE 3_8in ID 5_8in OD Washer x 4
Pedal Side x 2
Pad Backing
Wide Pedal Pad
Switch Actuator Plate
Steel Nyloc 5_16-24 Grade 8
Brake Pedal Mount x 2
Stop Plate
Overtravel Engager
Steel Thin Nyloc 1_4-20 Grade 8
Steel Hex 1_4-20 1and1_2in Grade 8
Toggle Switch
Switch Mount
Reservoir Inlet x 2
Accelerator Pedal Pot x 2
Key x 3
Casing x 3
Brake Pedal Pot
Brake Light Switch Mount
Steel Hex 5_16in-18 1in Grade 5
Shoulder Bold Potentiometer fit
Potentiometer Connector Nut Side
Chassis
