BDR16/svn-migration-dump/Mechanical/Pedal Box/Potentiometers/Accelerator Pot.SLDASM

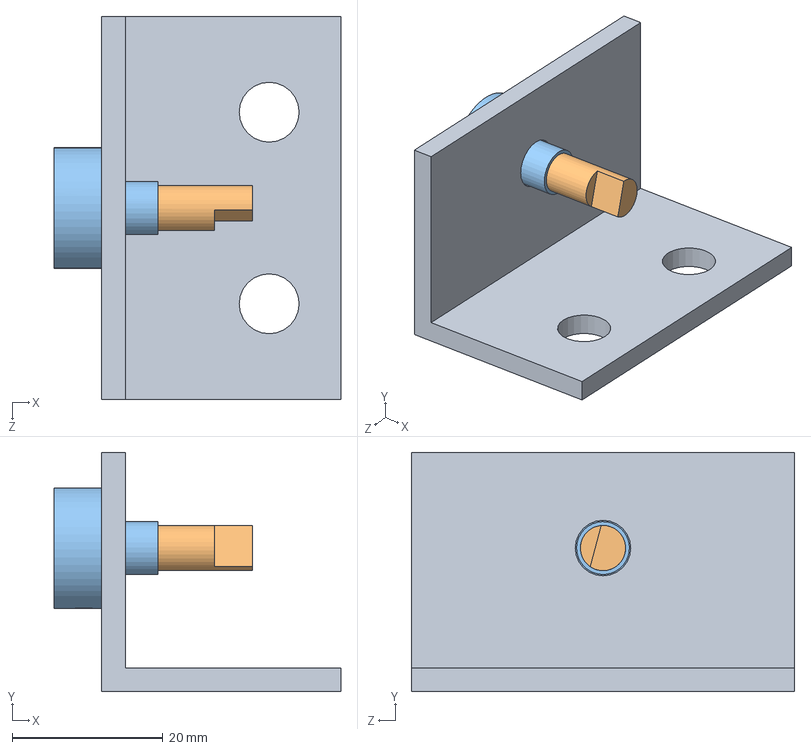
[picture p117: CAD file, 2016-09-20]
Mechanical/Pedal Box/Potentiometers/Accelerator Pot.SLDASM
38.0 x 31.8 x 50.8 mm
Accelerator Pedal Pot
Key
Casing
