BDR16/svn-migration-dump/Mechanical/Pedal Box/Static Structure/Static Structure.SLDASM

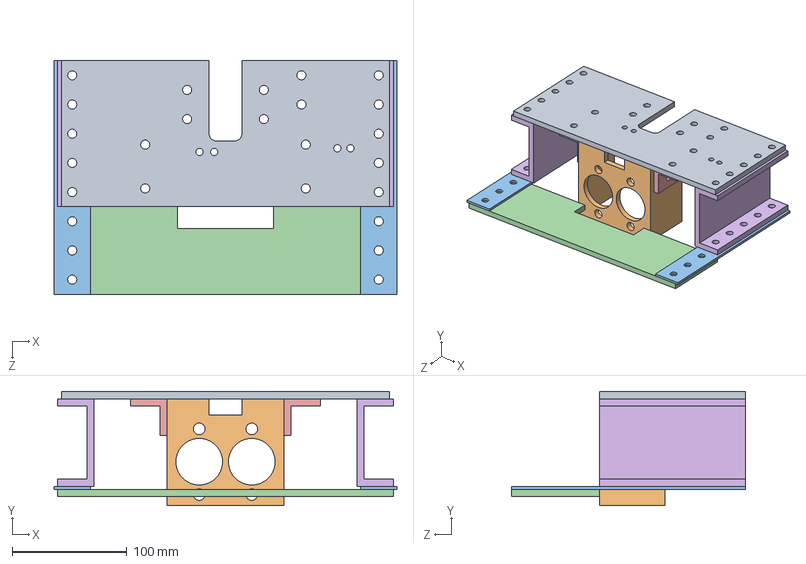
[picture p118: CAD file, 2016-09-20]
Mechanical/Pedal Box/Static Structure/Static Structure.SLDASM
298.4 x 99.2 x 203.2 mm
Base Plate
C Bracket
Chassis Tabs
Foot Rest
L Bracket x 2
Risers x 2
