BDR16/svn-migration-dump/Mechanical/Percy/Percy.SLDASM

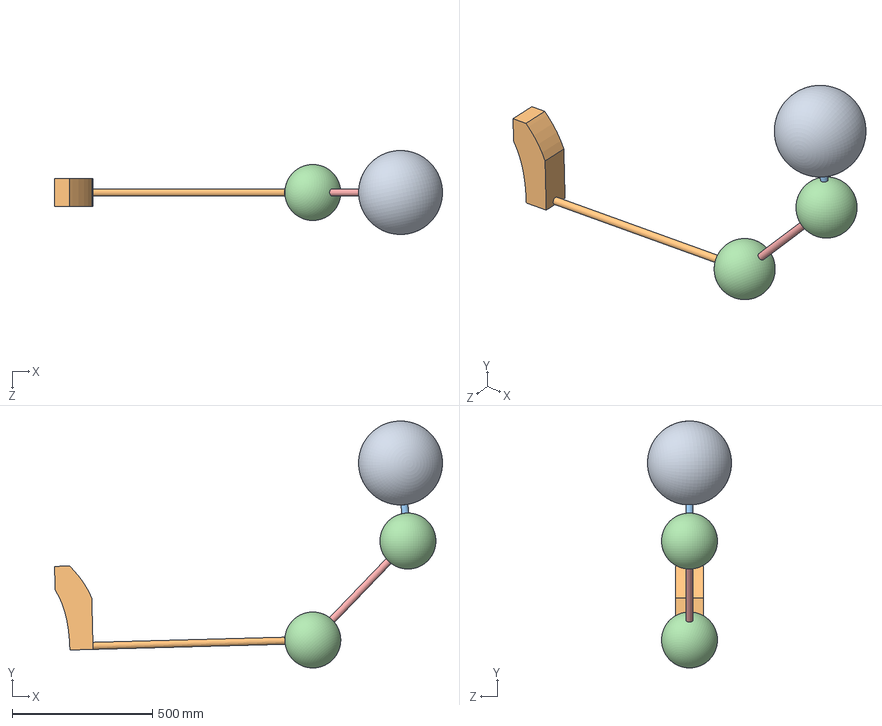
[picture p119: CAD file, 2016-09-20]
Mechanical/Percy/Percy.SLDASM
1385.4 x 881.8 x 299.9 mm
head
legs
neck
Shoulders x 2
torso
