BDR16/svn-migration-dump/Mechanical/Wheel Assemblies/Front Hub Assembly.SLDASM

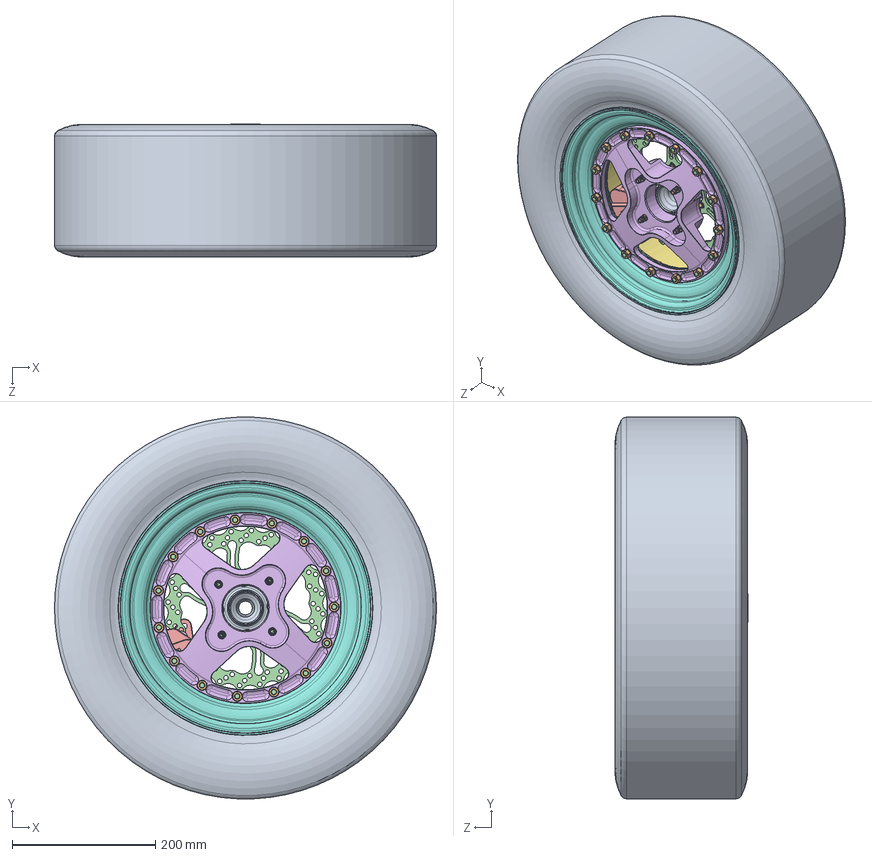
[picture p120: CAD file, 2016-09-20]
Mechanical/Wheel Assemblies/Front Hub Assembly.SLDASM
533.4 x 532.9 x 185.9 mm
Front Hub
Brake Rotor Pin x 6
Brake Rotor Snap Ring x 6
Brake Rotor
Titanium Stud x 4
Front Center
Front Inner Rim
Front Outer Rim
Front Tire
Steel Hex 5_16-18 Grade 5 x 15
5_16 Small OD Washer x 15
Steel 5_16in-18 1in Wheel x 15
Brake Caliper Frame
Brake Pad x 2
Brake Pin
Front Cup x 2
Front Cone x 2
Front Rollers x 2
Front Hub Nut
