BDR16/svn-migration-dump/Mechanical/Wheel Assemblies/Suspension/Members/Bearings and Rod Ends/HAB-4T Bearing/HAB-4T Bearing.SLDASM

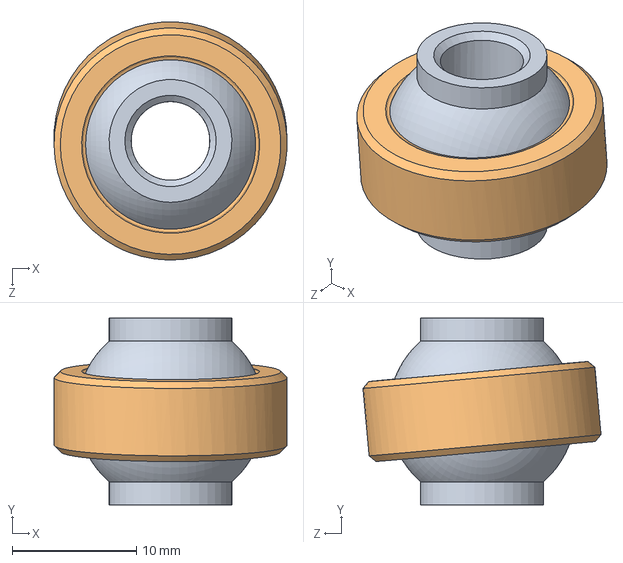
[picture p121: CAD file, 2016-09-20]
Mechanical/Wheel Assemblies/Suspension/Members/Bearings and Rod Ends/HAB-4T Bearing/HAB-4T Bearing.SLDASM
18.8 x 15.1 x 19.2 mm
HAB-4T Ball
HAB-4T Cup
