BDR16/svn-migration-dump/Mechanical/Wheel Assemblies/Suspension/Members/Bearings and Rod Ends/MM-4T Rod End/MM-4T Rod End.SLDASM

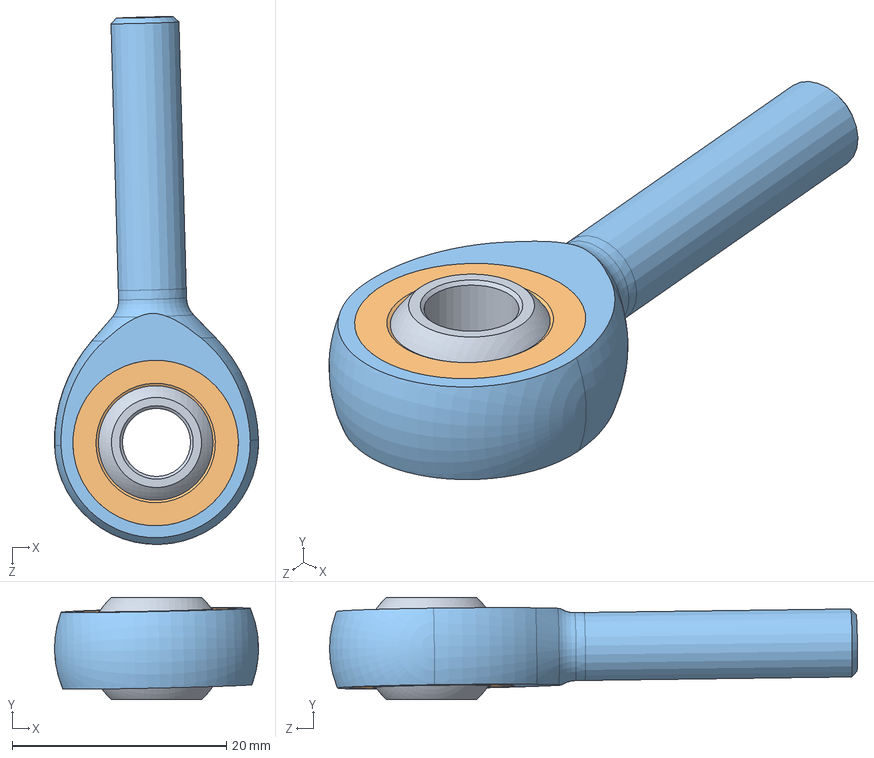
[picture p122: CAD file, 2016-09-20]
Mechanical/Wheel Assemblies/Suspension/Members/Bearings and Rod Ends/MM-4T Rod End/MM-4T Rod End.SLDASM
19.0 x 9.53 x 49.3 mm
MM-4T Ball
MM-4T Sleeve
MM-4T Housing
