BDR16/svn-migration-dump/Mechanical/Wheel Assemblies/Suspension/Members/Front Bottom Wishbone.SLDASM

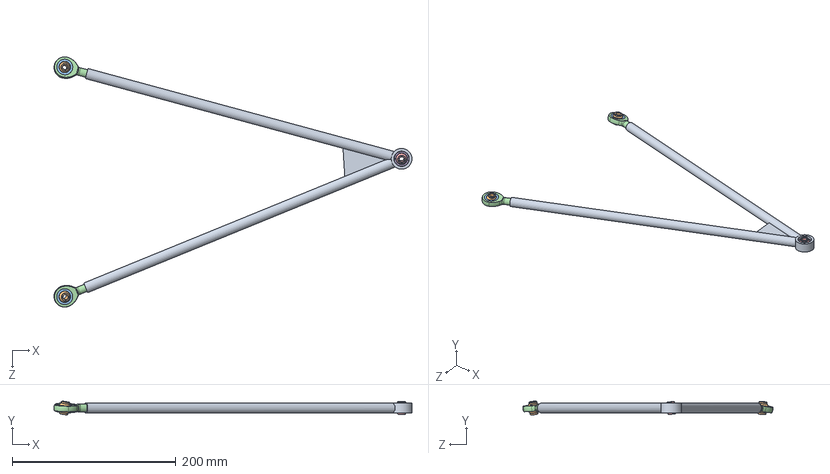
[picture p123: CAD file, 2016-09-20]
Mechanical/Wheel Assemblies/Suspension/Members/Front Bottom Wishbone.SLDASM
437.0 x 16.8 x 305.4 mm
Front Bottom Wishbone
HXAM-4T Ball x 2
HXAM-4T Sleeve x 2
HXAM-4T Housing x 2
HAB-4T Ball
HAB-4T Cup
