BDR16/svn-migration-dump/Mechanical/Wheel Assemblies/Suspension/Uprights/Bearings/Rear Upright Bearing.SLDASM

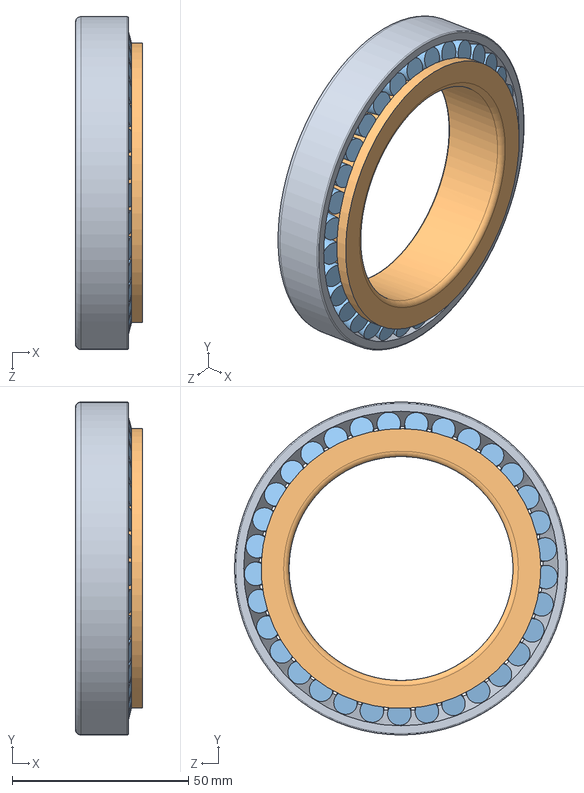
[picture p124: CAD file, 2016-09-20]
Mechanical/Wheel Assemblies/Suspension/Uprights/Bearings/Rear Upright Bearing.SLDASM
19.1 x 94.4 x 94.5 mm
Rear Cup
Rear Cone
Rear Rollers
