BDR16/svn-migration-dump/Mechanical/Wheel Assemblies/Suspension/Uprights/Simulation/Rear Right Upright Simulation.SLDASM

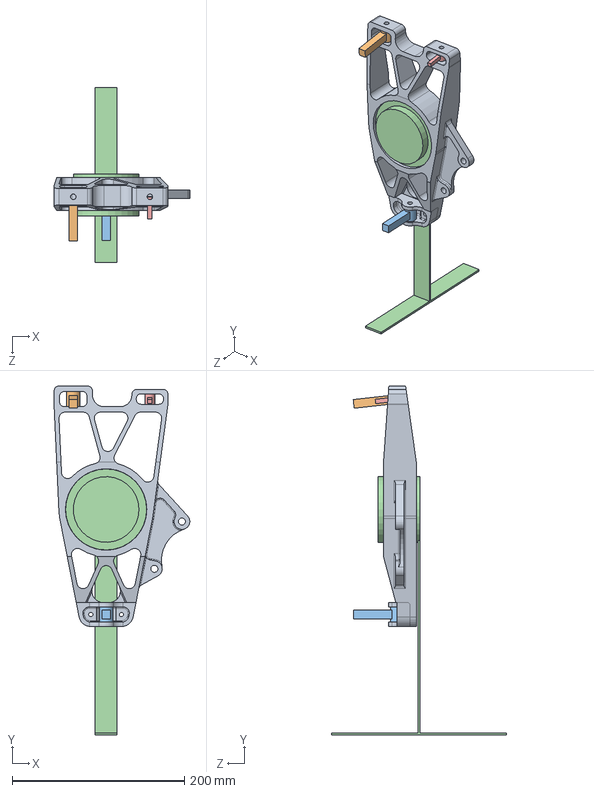
[picture p125: CAD file, 2016-09-20]
Mechanical/Wheel Assemblies/Suspension/Uprights/Simulation/Rear Right Upright Simulation.SLDASM
157.5 x 404.9 x 203.2 mm
Rear Right Upright
Upper A-Arm Spherical Joint
Lower A-Arm Spherical Joint
Hub and Tire
Toe Link Rod End
