BDR16/svn-migration-dump/Mechanical/Wheel Assemblies/Wheels/Front Wheel.SLDASM

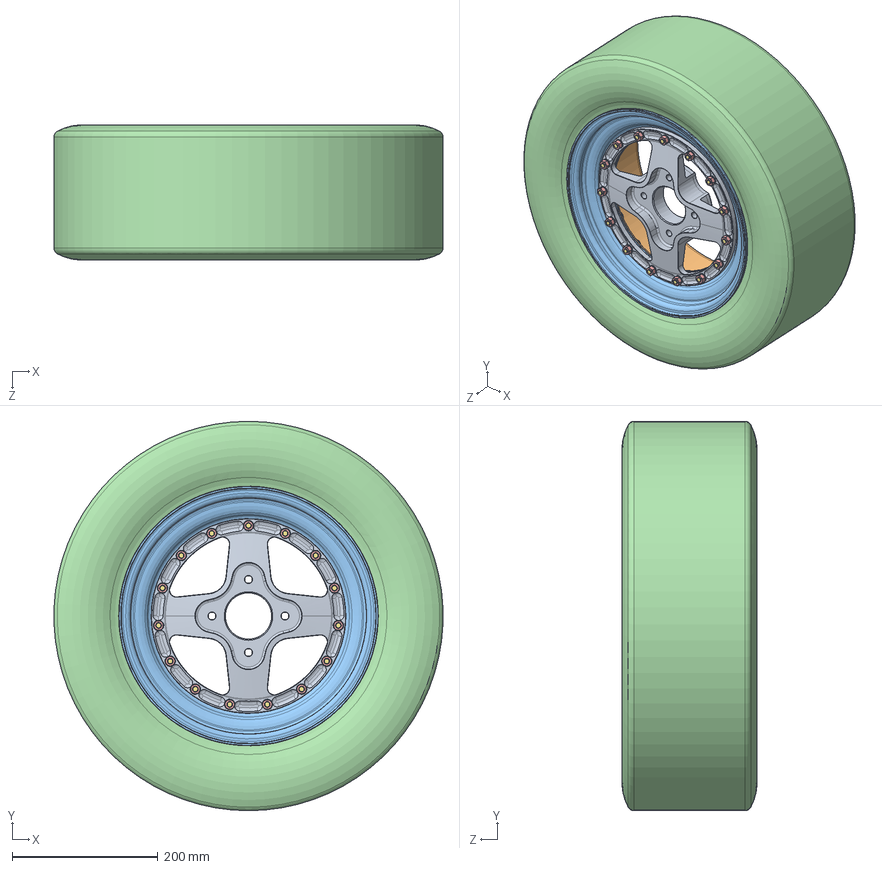
[picture p126: CAD file, 2016-09-20]
Mechanical/Wheel Assemblies/Wheels/Front Wheel.SLDASM
532.9 x 533.4 x 185.2 mm
Front Center
Front Inner Rim
Front Outer Rim
Front Tire
Steel Hex 5_16-18 Grade 5 x 15
5_16 Small OD Washer x 15
Steel 5_16in-18 1in Wheel x 15
