BDR16/svn-migration-dump/Mechanical/Accumulator/HV Control/Current Sensor/Current Sensor.SLDASM

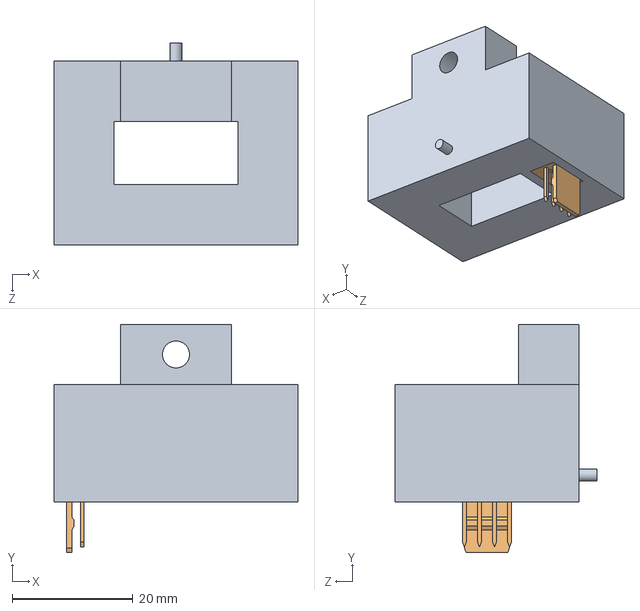
[picture p127: CAD file, 2016-09-20]
Mechanical/Accumulator/HV Control/Current Sensor/Current Sensor.SLDASM
40.5 x 37.9 x 33.5 mm
Current Sensor
Current Sensor Connector
