BDR16/svn-migration-dump/Mechanical/Accumulator/HV Control/HV Fusing/HV Fusing.SLDASM

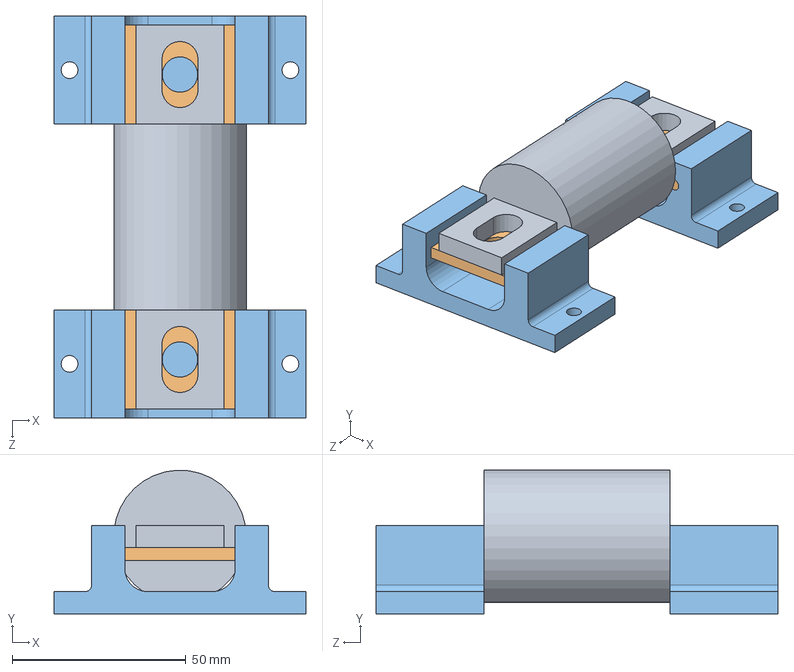
[picture p128: CAD file, 2016-09-20]
Mechanical/Accumulator/HV Control/HV Fusing/HV Fusing.SLDASM
72.4 x 41.3 x 115.6 mm
HV Fuse
HV Fuseholder Plate x 2
HV Fuseholder x 2
