BDR16/svn-migration-dump/Mechanical/Accumulator/Stacks/Cell Modules/Positive End Module.SLDASM

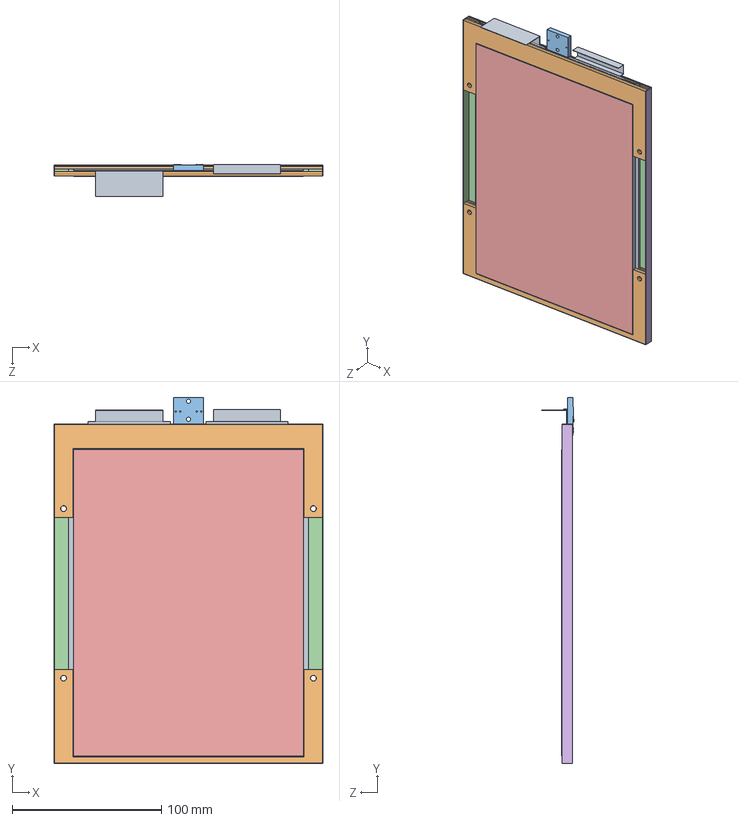
[picture p129: CAD file, 2016-09-20]
Mechanical/Accumulator/Stacks/Cell Modules/Positive End Module.SLDASM
180.0 x 245.2 x 21.7 mm
Cell Tab Config B Positive End
Repeating Frame Outer x 3
Cell Board End
Insulation Film Half
Insulation Film End
Heat Sink Half
