BDR16/svn-migration-dump/Mechanical/Accumulator/Stacks/Odd Stack.SLDASM

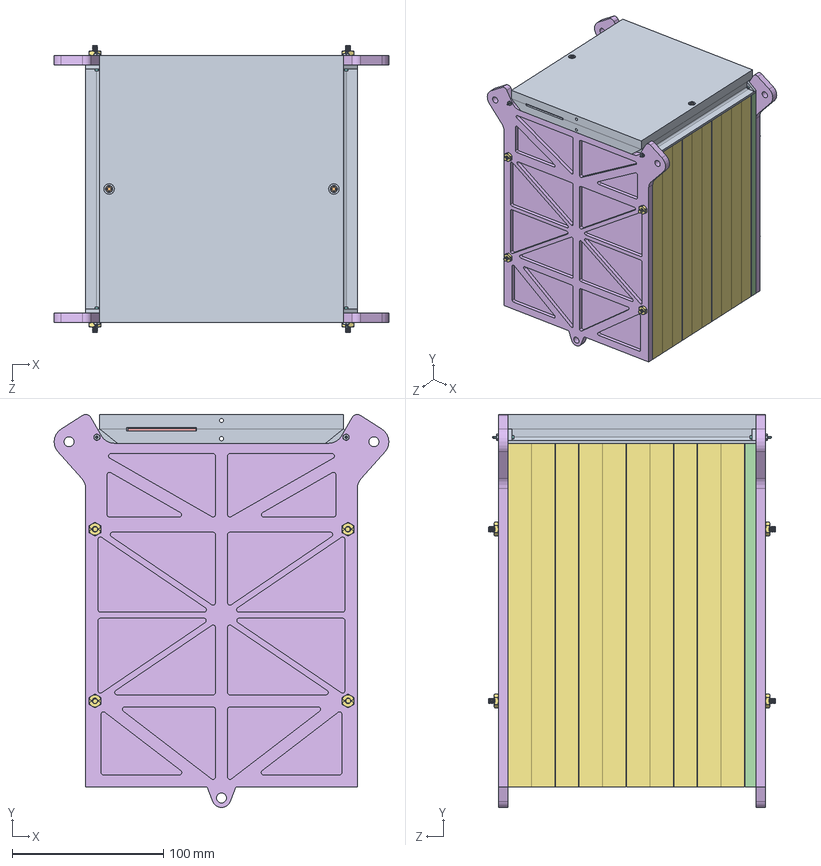
[picture p130: CAD file, 2016-09-20]
Mechanical/Accumulator/Stacks/Odd Stack.SLDASM
221.6 x 260.1 x 189.6 mm
Tab Cover Odd
Socket 4-40 0.625in x 2
Steel Hex 4-40 Grade 2 x 2
Cell Tab Config A x 10
Cell Tab Config B x 9
Tab Load Spreader x 40
Steel Toplock 6-32 Grade 2 x 48
Steel 6-32 0.4375in x 40
Cell Board Middle x 19
Repeating Frame Outer x 23
Repeating Frame Inner x 10
Insulation Film Back x 10
Insulation Film Full x 10
Cell Load Spreader x 10
Heat Sink Full x 10
Cell Tab Config B Positive End
Cell Board End x 2
Insulation Film Half
Insulation Film End
Heat Sink Half
Cell Tab Config B Negative End
End Plate x 2
Odd Threaded Rod x 4
Steel 0-80 1_2in x 4
Steel Hex 0-80 Grade 2 x 4
