BDR16/svn-migration-dump/Mechanical/Accumulator/Stacks/Stack Parts/Heat Sink/Heat Sink Full.SLDPRT

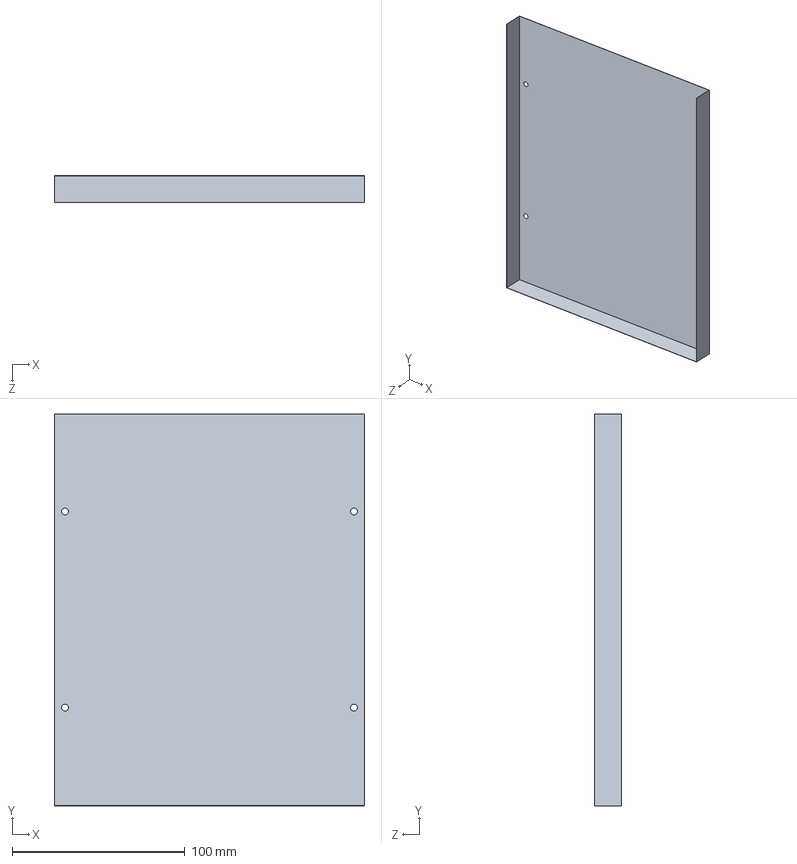
[picture p131: CAD file, 2016-09-20]
Mechanical/Accumulator/Stacks/Stack Parts/Heat Sink/Heat Sink Full.SLDPRT
179.7 x 227.2 x 15.5 mm
