BDR16/svn-migration-dump/Mechanical/Body/Rib Assembly.SLDASM

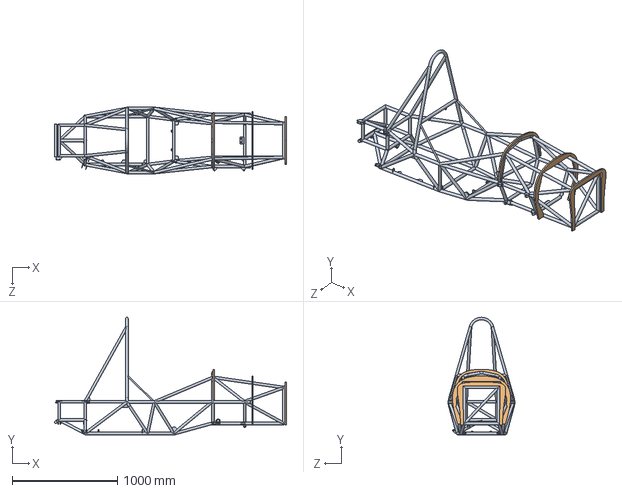
[picture p132: CAD file, 2016-09-20]
Mechanical/Body/Rib Assembly.SLDASM
2205.4 x 1117.8 x 635.0 mm
Body Sketches
Ribs
