BDR16/svn-migration-dump/Mechanical/Drivetrain/Support Structures/Drivetrain Parts Drawings.SLDASM

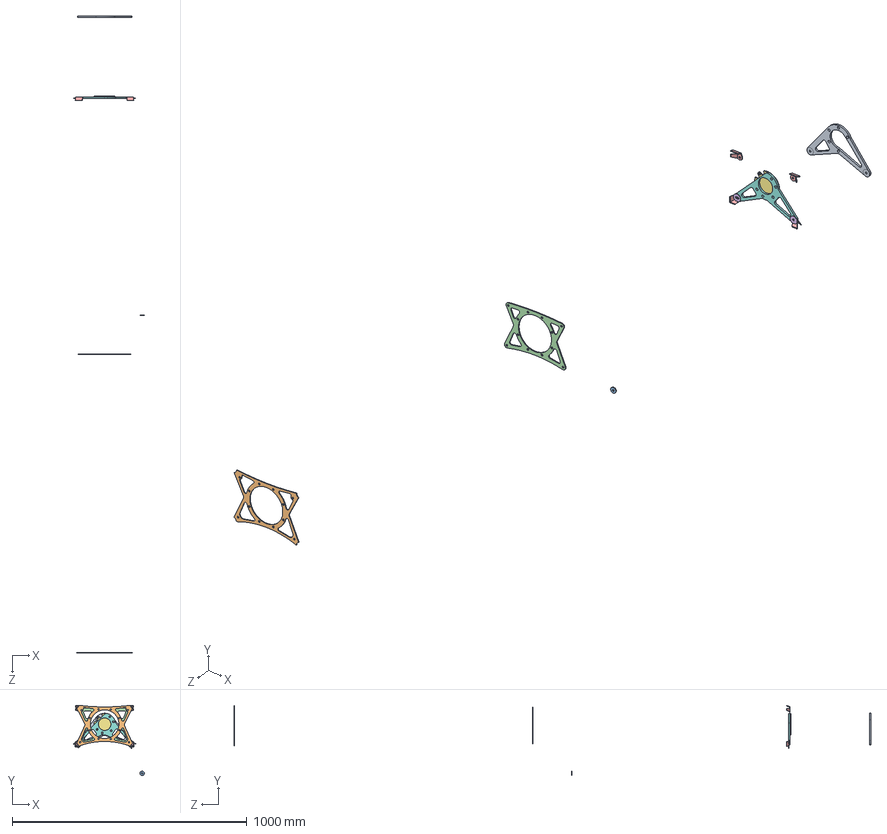
[picture p133: CAD file, 2016-09-20]
Mechanical/Drivetrain/Support Structures/Drivetrain Parts Drawings.SLDASM
301.6 x 299.1 x 2714.7 mm
