BDR16/svn-migration-dump/Mechanical/Pedal Box/Accelerator Pedal/Accelerator Pedal.SLDASM

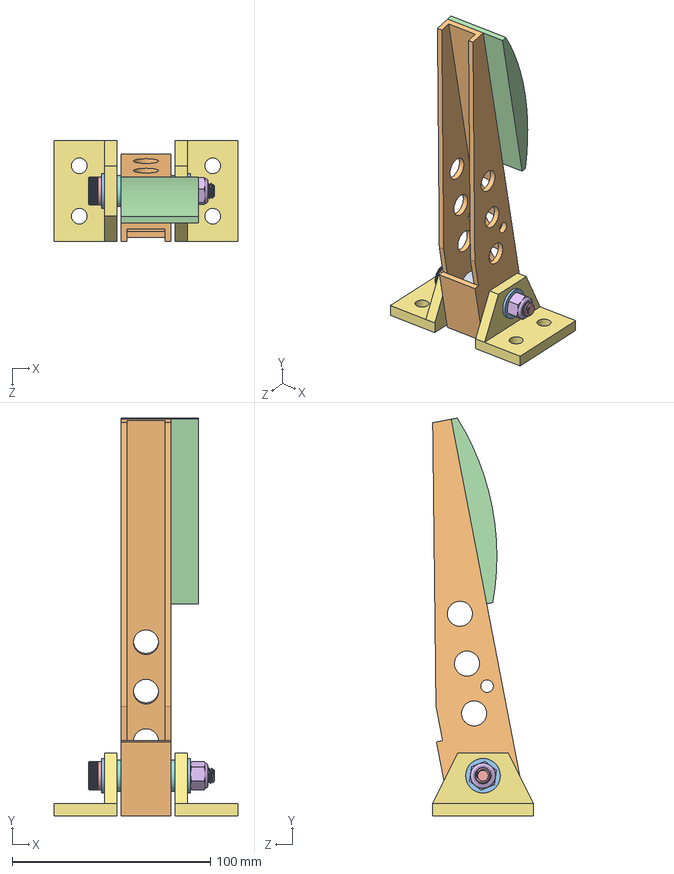
[picture p134: CAD file, 2016-09-20]
Mechanical/Pedal Box/Accelerator Pedal/Accelerator Pedal.SLDASM
92.7 x 200.8 x 50.8 mm
Pedal Shaft Housing
Pedal
Flanged Sleeve x 2
Narrow Pedal Pad
Steel Socket Shoulder 5_16in-18 1and3_4in
Steel Nyloc 5_16-24 Grade 5
Accelerator Mount x 2
PTFE 3_8in ID 5_8in OD Washer x 2
