BDR16/svn-migration-dump/Mechanical/Steering/Steering Assembly.SLDASM

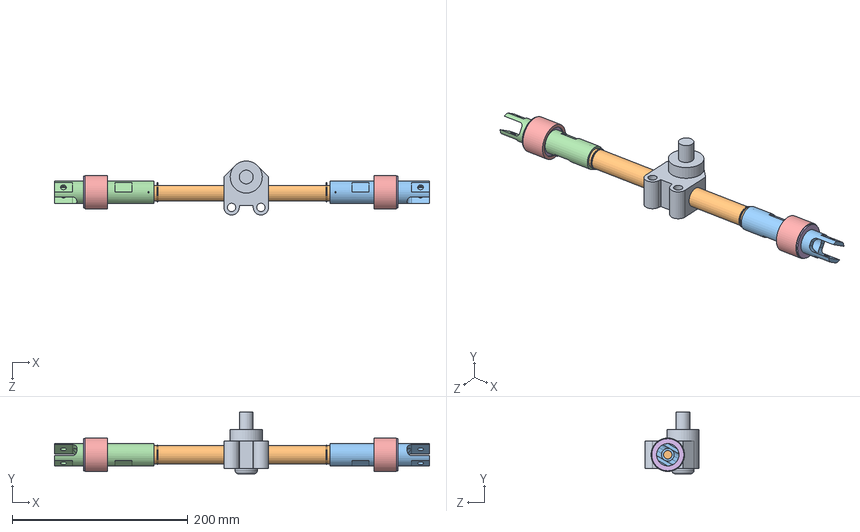
[picture p136: CAD file, 2016-09-20]
Mechanical/Steering/Steering Assembly.SLDASM
426.8 x 70.2 x 61.6 mm
Pinion
Rack
Steering Rack Extender Left
Steering Rack Extender Right
Bushing Housing x 2
Bushing x 2
