BDR16/svn-migration-dump/Mechanical/Templates/Template Fitting.SLDASM

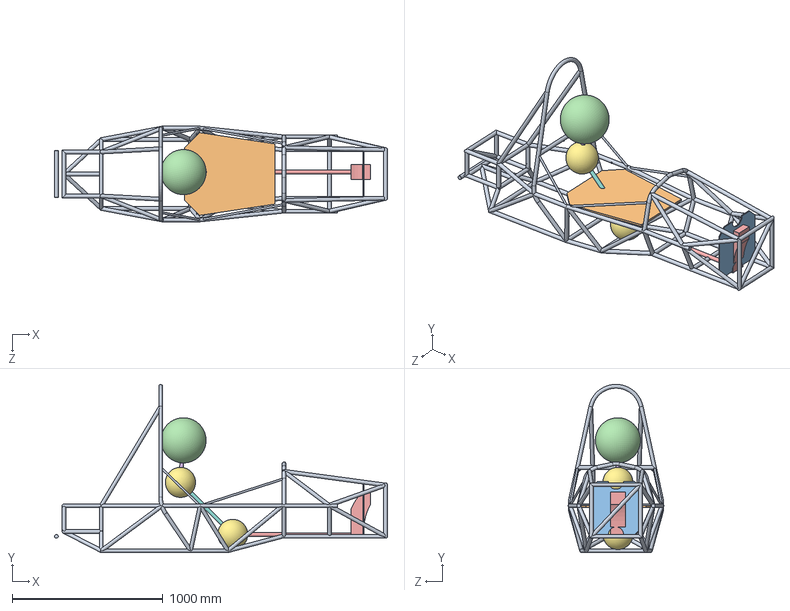
[picture p137: CAD file, 2016-09-20]
Mechanical/Templates/Template Fitting.SLDASM
2212.2 x 1117.2 x 635.0 mm
Chassis
Cockpit Opening
Cockpit Internal Cross Section
Head
Legs
neck
Shoulders x 2
torso
