BDR16/svn-migration-dump/Mechanical/Wheel Assemblies/Brakes/Brake Caliper/Brake Caliper.SLDASM

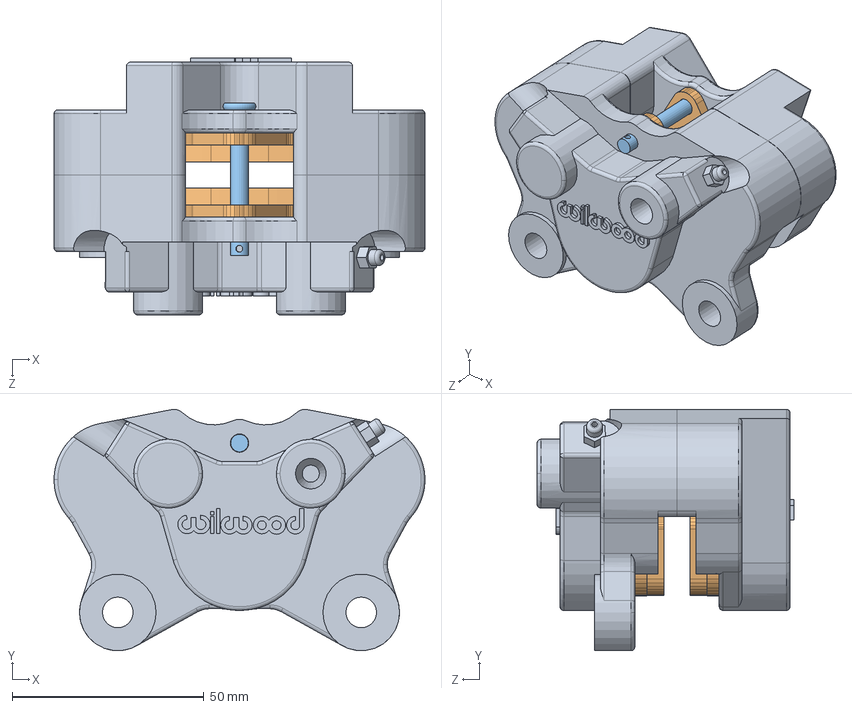
[picture p138: CAD file, 2016-09-20]
Mechanical/Wheel Assemblies/Brakes/Brake Caliper/Brake Caliper.SLDASM
96.8 x 62.9 x 67.0 mm
Brake Caliper Frame
Brake pad x 2
Brake Pin
