BDR16/svn-migration-dump/Mechanical/Wheel Assemblies/Suspension/Damper/Damper.SLDASM

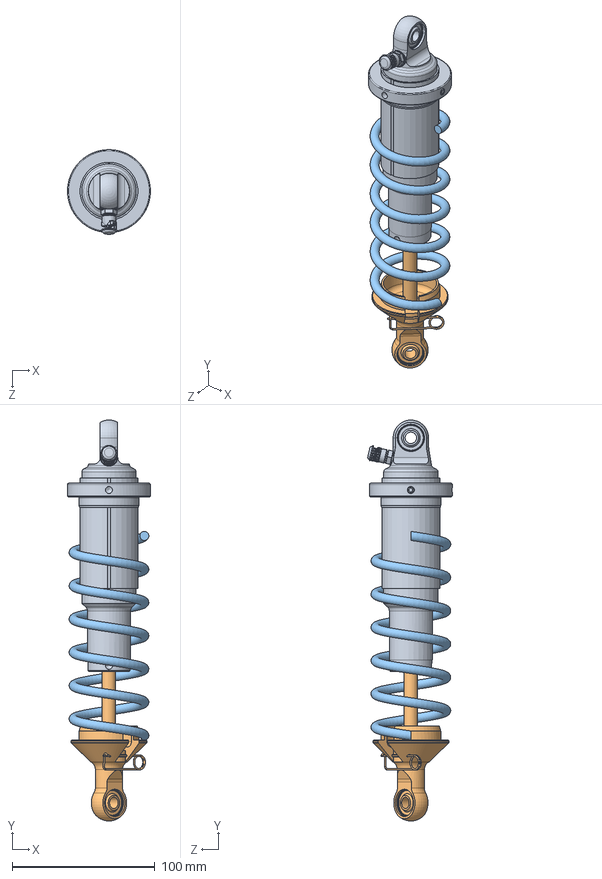
[picture p139: CAD file, 2016-09-20]
Mechanical/Wheel Assemblies/Suspension/Damper/Damper.SLDASM
58.1 x 280.6 x 59.3 mm
Quarter Midget Damper Base
Quarter Midget Damper Rod
Spring
