BDR16/svn-migration-dump/Mechanical/Wheel Assemblies/Suspension/Members/Rear Toe Rod.SLDASM

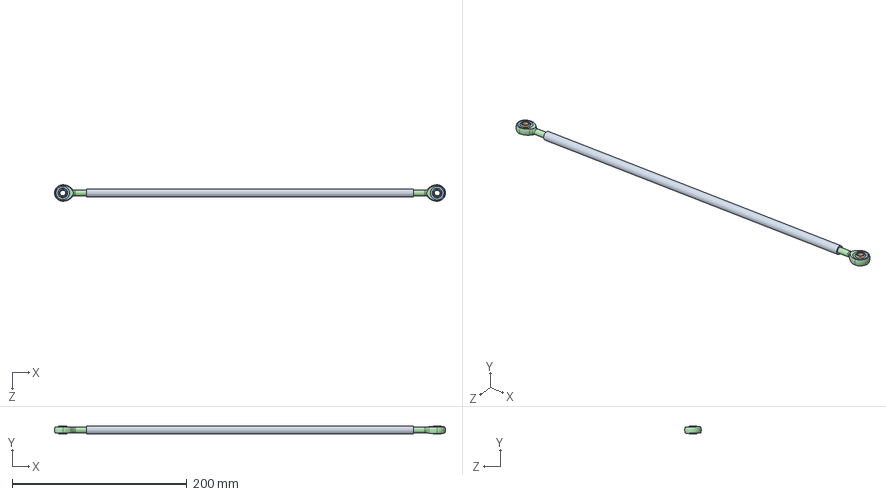
[picture p140: CAD file, 2016-09-20]
Mechanical/Wheel Assemblies/Suspension/Members/Rear Toe Rod.SLDASM
447.7 x 9.68 x 19.0 mm
Rear Toe Rod
MM-4T Ball x 2
MM-4T Sleeve x 2
MM-4T Housing x 2
