BDR16/svn-migration-dump/Mechanical/Wheel Assemblies/Suspension/Uprights/Bearings/Front Upright Bearing.SLDASM

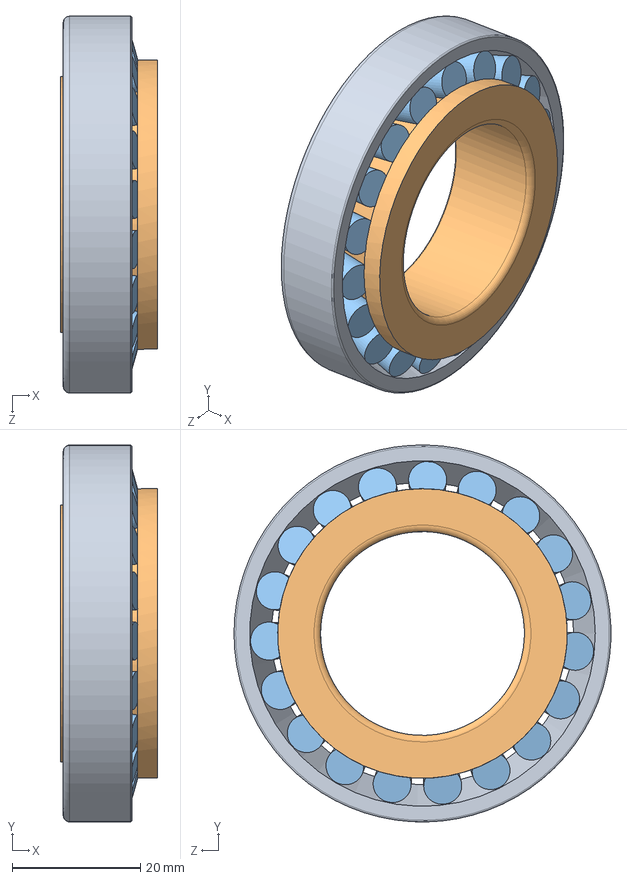
[picture p141: CAD file, 2016-09-20]
Mechanical/Wheel Assemblies/Suspension/Uprights/Bearings/Front Upright Bearing.SLDASM
15.1 x 58.7 x 58.7 mm
Front Cup
Front Cone
Front Rollers
