BDR16/svn-migration-dump/Mechanical/Wheel Assemblies/Wheels/Rear Wheel.SLDASM

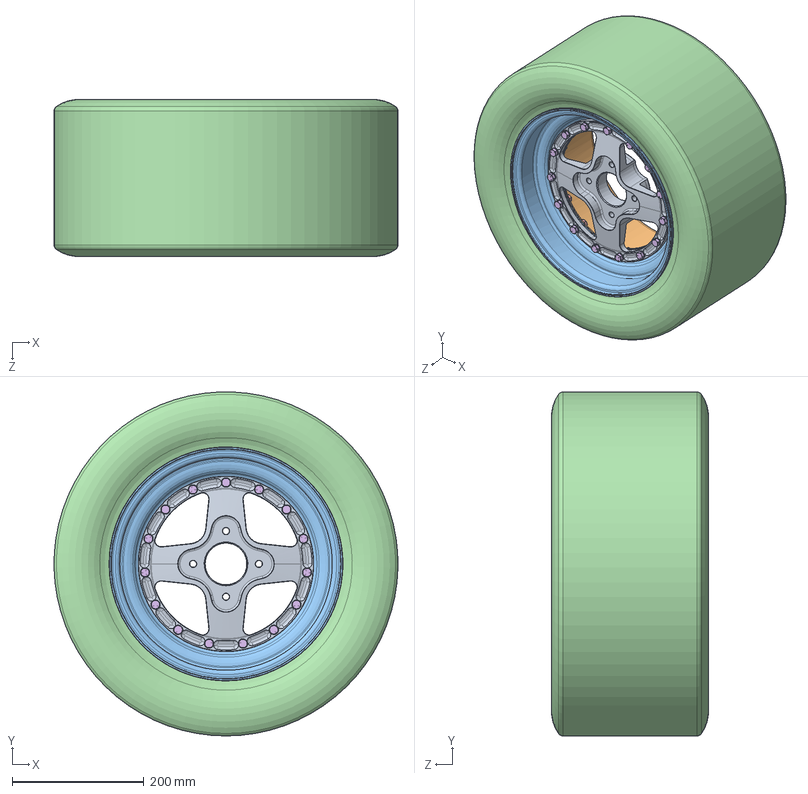
[picture p142: CAD file, 2016-09-20]
Mechanical/Wheel Assemblies/Wheels/Rear Wheel.SLDASM
523.1 x 523.0 x 238.4 mm
Rear Center
Rear Inner Rim
Rear Outer Rim
Rear Tire
Steel Hex 5_16-18 Grade 5 x 15
Steel Hex 5_16in-18 1in Grade 5 x 15
5_16 Small OD Washer x 30
