BDR16/svn-migration-dump/Mechanical/Accumulator/Stacks/Cell Modules/Negative End Module Odd.SLDASM

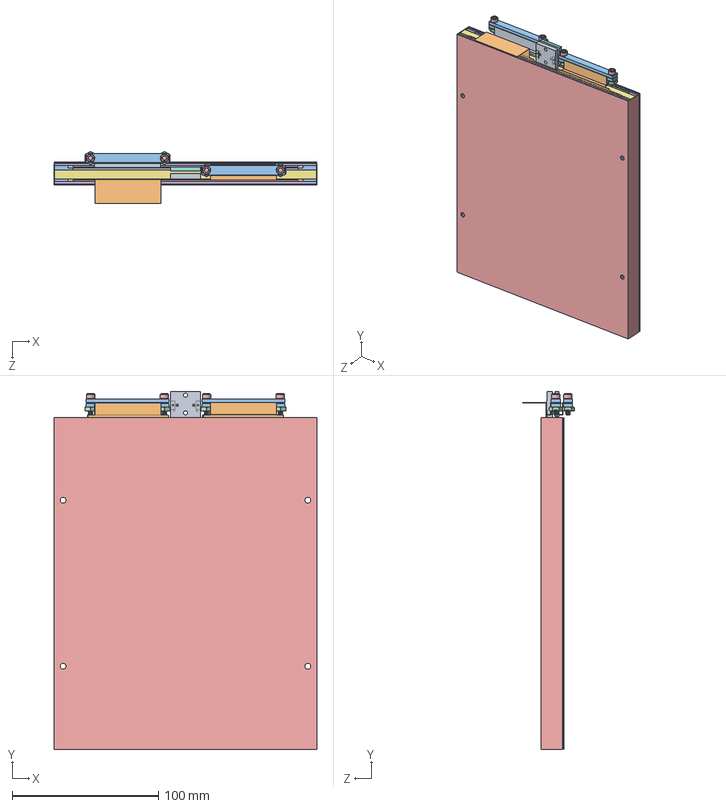
[picture p143: CAD file, 2016-09-20]
Mechanical/Accumulator/Stacks/Cell Modules/Negative End Module Odd.SLDASM
179.7 x 245.1 x 35.8 mm
Cell Tab Config A
Cell Tab Config B Negative End
Tab Load Spreader x 4
Steel Toplock 6-32 Grade 2 x 4
Steel 6-32 0.4375in x 4
Repeating Frame Outer x 2
Repeating Frame Inner
Cell Board Middle
Cell Board End
Insulation Film Back
Insulation Film Full
Cell Load Spreader
Heat Sink Full
