BDR16/svn-migration-dump/Mechanical/Accumulator/Stacks/Thermal Simulation/Solidworks Model/Cell.SLDASM

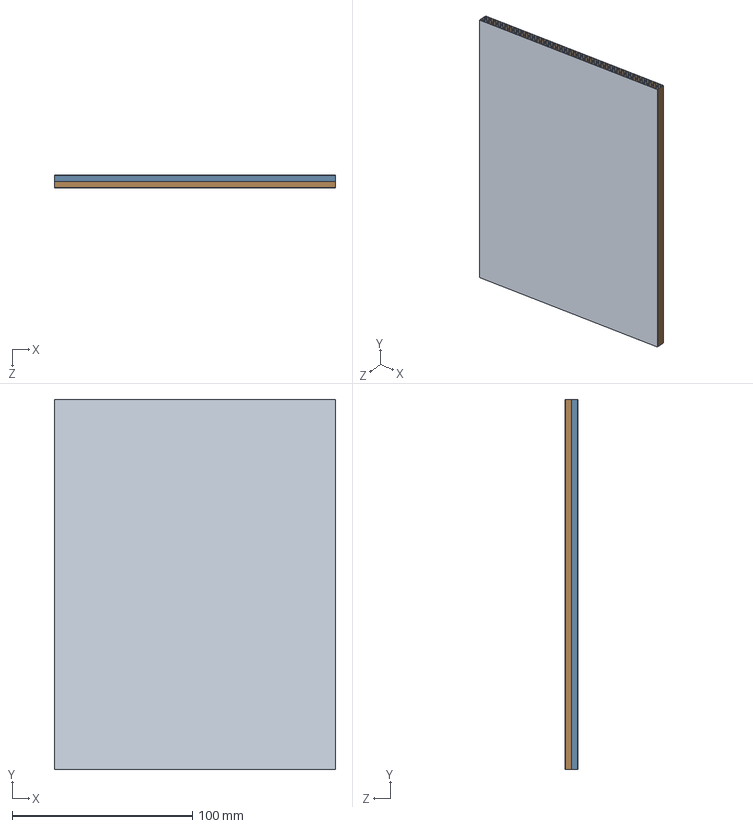
[picture p145: CAD file, 2016-09-20]
Mechanical/Accumulator/Stacks/Thermal Simulation/Solidworks Model/Cell.SLDASM
156.1 x 205.5 x 7.10 mm
Pouch x 2
Positive Layer x 25
Negative Layer x 25
