BDR16/svn-migration-dump/Mechanical/Drivetrain/Coupler/Motor to Gearbox/Motor to Gearbox Coupler.SLDASM

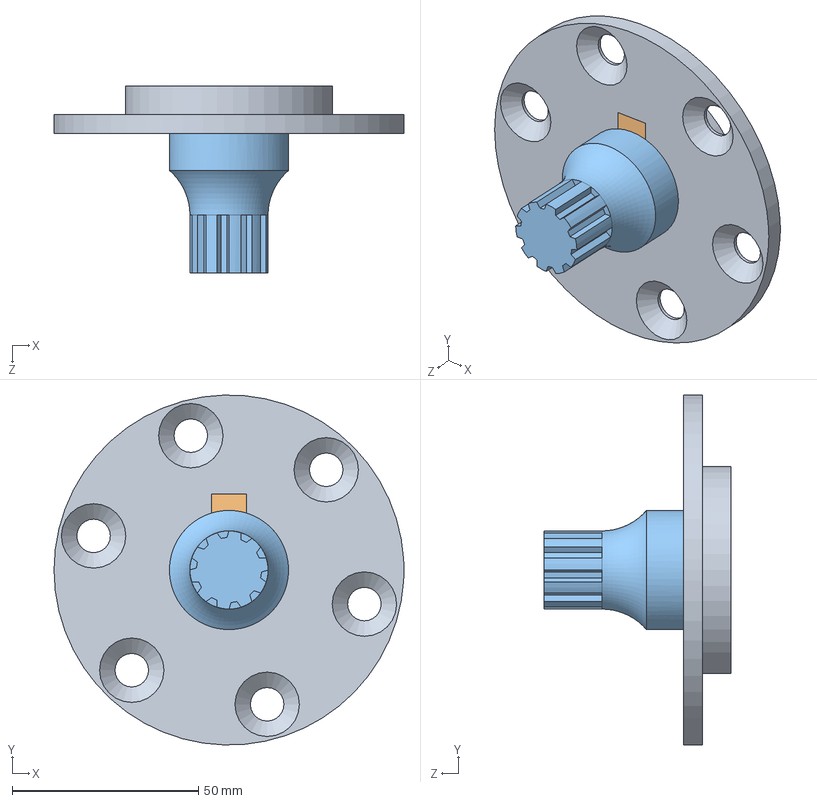
[picture p146: CAD file, 2016-09-20]
Mechanical/Drivetrain/Coupler/Motor to Gearbox/Motor to Gearbox Coupler.SLDASM
94.0 x 94.0 x 50.2 mm
Coupler Base
Coupler Key
Coupler Shaft
