BDR16/svn-migration-dump/Mechanical/Pedal Box/Balance Bar/Balance bar.sldasm

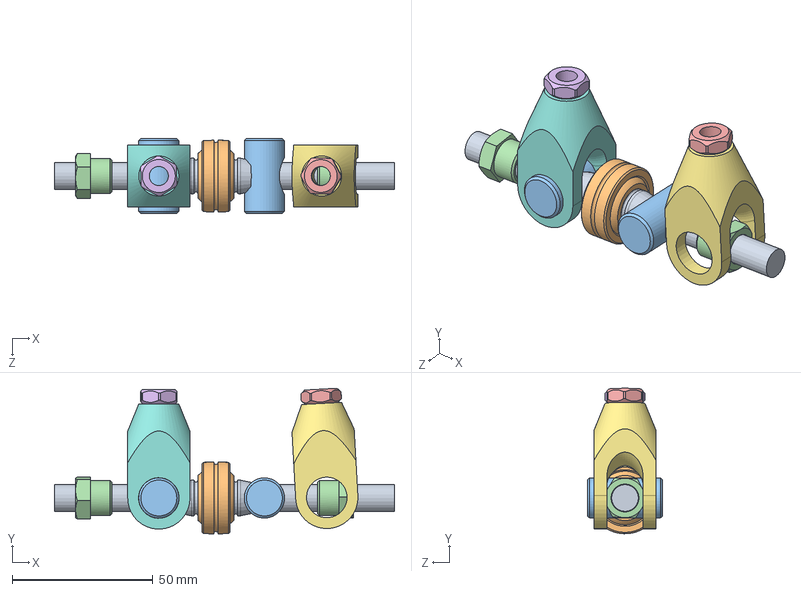
[picture p147: CAD file, 2016-09-20]
Mechanical/Pedal Box/Balance Bar/Balance bar.sldasm
120.7 x 51.6 x 26.7 mm
