BDR16/svn-migration-dump/Mechanical/Pedal Box/Potentiometers/Brake Pot.SLDASM

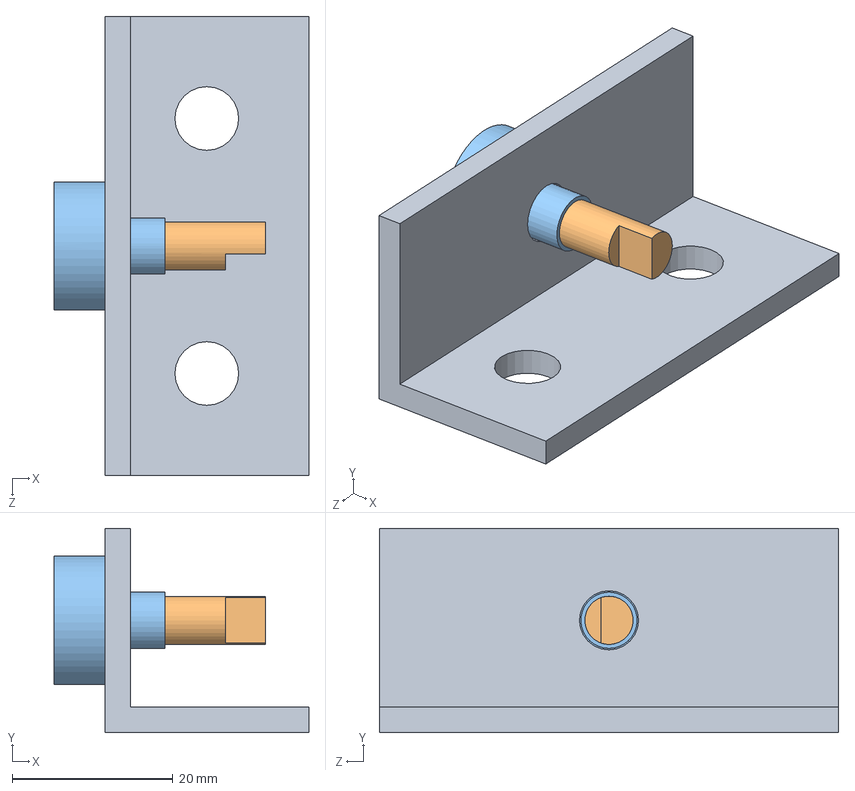
[picture p148: CAD file, 2016-09-20]
Mechanical/Pedal Box/Potentiometers/Brake Pot.SLDASM
31.7 x 25.4 x 57.1 mm
Brake Pedal Pot
Key
Casing
