BDR16/svn-migration-dump/Mechanical/Steering/Steering Rack/Steering Rack.SLDASM

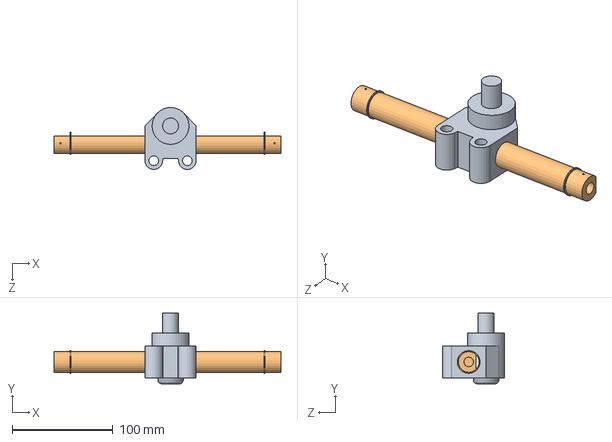
[picture p149: CAD file, 2016-09-20]
Mechanical/Steering/Steering Rack/Steering Rack.SLDASM
225.4 x 70.2 x 61.6 mm
Pinion
Rack
