BDR16/svn-migration-dump/Mechanical/Wheel Assemblies/Suspension/Members/Bearings and Rod Ends/HXAM-4T Rod End/HXAM-4T Rod End.SLDASM

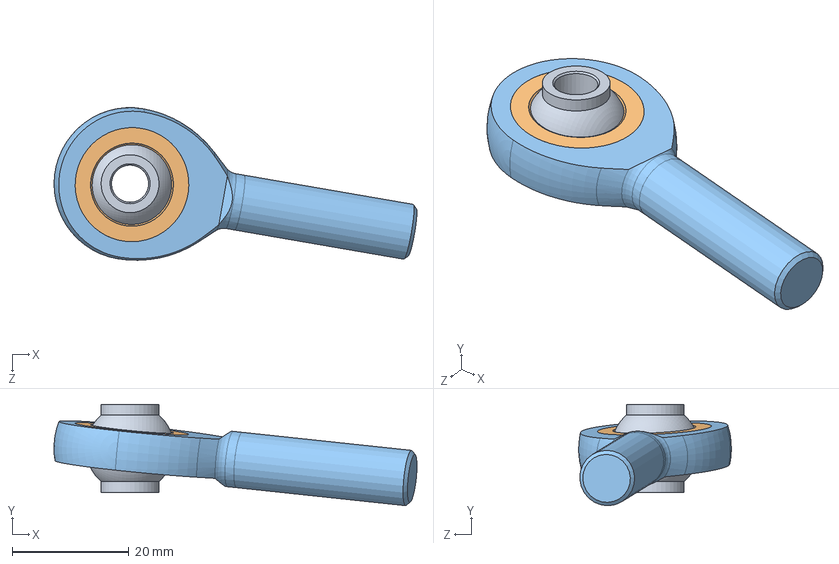
[picture p150: CAD file, 2016-09-20]
Mechanical/Wheel Assemblies/Suspension/Members/Bearings and Rod Ends/HXAM-4T Rod End/HXAM-4T Rod End.SLDASM
62.1 x 17.3 x 26.1 mm
HXAM-4T Ball
HXAM-4T Sleeve
HXAM-4T Housing
