BDR16/svn-migration-dump/Mechanical/Wheel Assemblies/Suspension/Members/Rear Bottom Wishbone.SLDASM

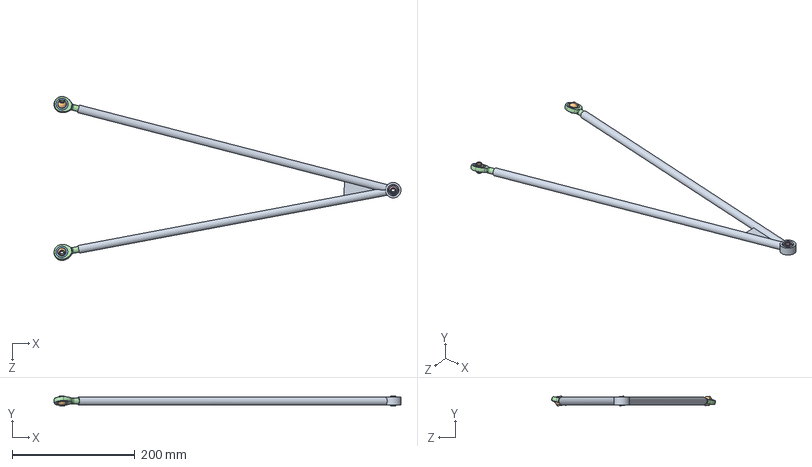
[picture p151: CAD file, 2016-09-20]
Mechanical/Wheel Assemblies/Suspension/Members/Rear Bottom Wishbone.SLDASM
565.9 x 16.4 x 267.3 mm
Rear Bottom Wishbone
HXAM-4T Ball x 2
HXAM-4T Sleeve x 2
HXAM-4T Housing x 2
HAB-4T Ball
HAB-4T Cup
