BDR16/svn-migration-dump/Mechanical/Steering/Steering Column/Steering Mount Sub.SLDASM

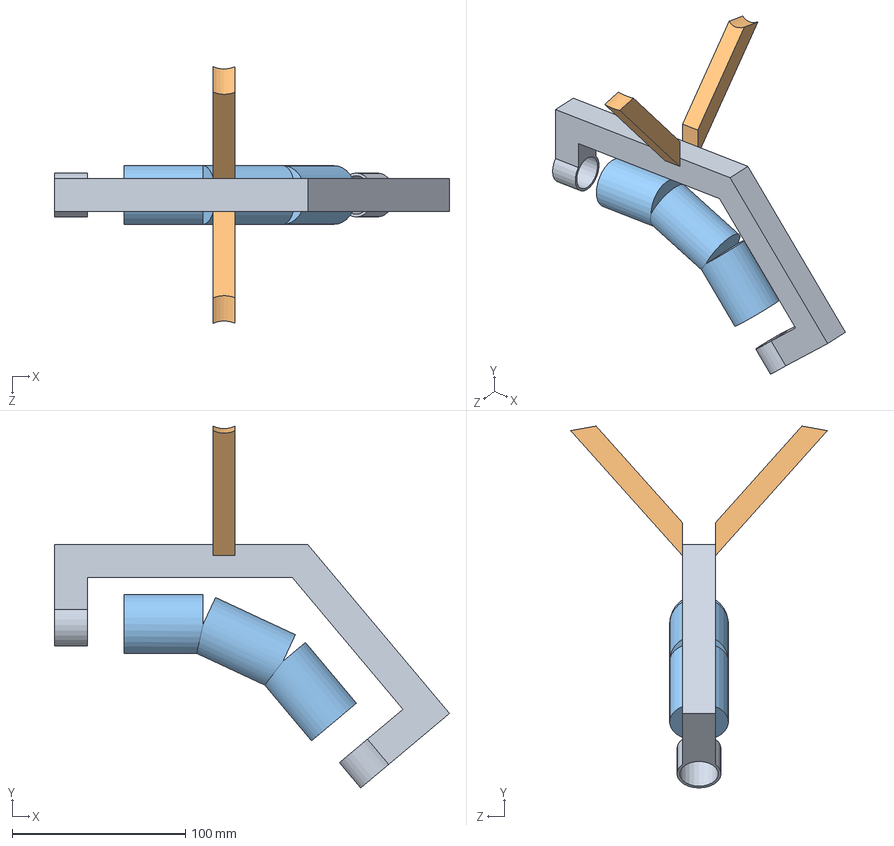
[picture p153: CAD file, 2016-09-20]
Mechanical/Steering/Steering Column/Steering Mount Sub.SLDASM
227.7 x 208.7 x 148.0 mm
Steering Column Mount
column mount y
Double U Joint Mockup
