BDR16/svn-migration-dump/Mechanical/Drivetrain/Motor/Motor.SLDASM

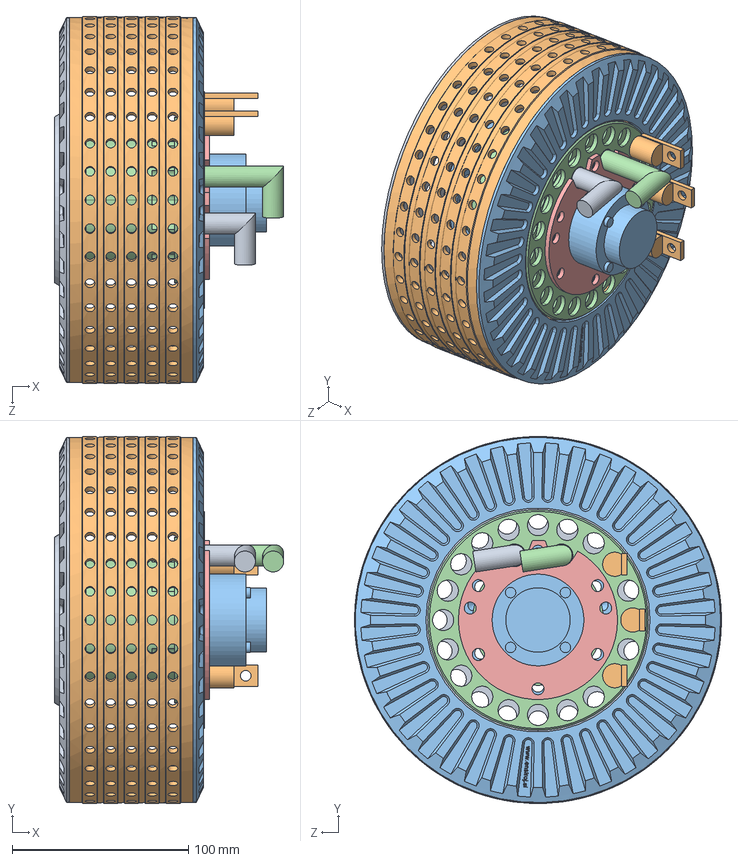
[picture p154: CAD file, 2016-09-20]
Mechanical/Drivetrain/Motor/Motor.SLDASM
130.0 x 208.0 x 208.0 mm
Coolant Pipe Short
Electrical Connector x 3
Resolver
Coolant Pipe Long
Resolver Plate
