BDR16/svn-migration-dump/Mechanical/Wheel Assemblies/Suspension/Members/Front Top Wishbone.SLDASM

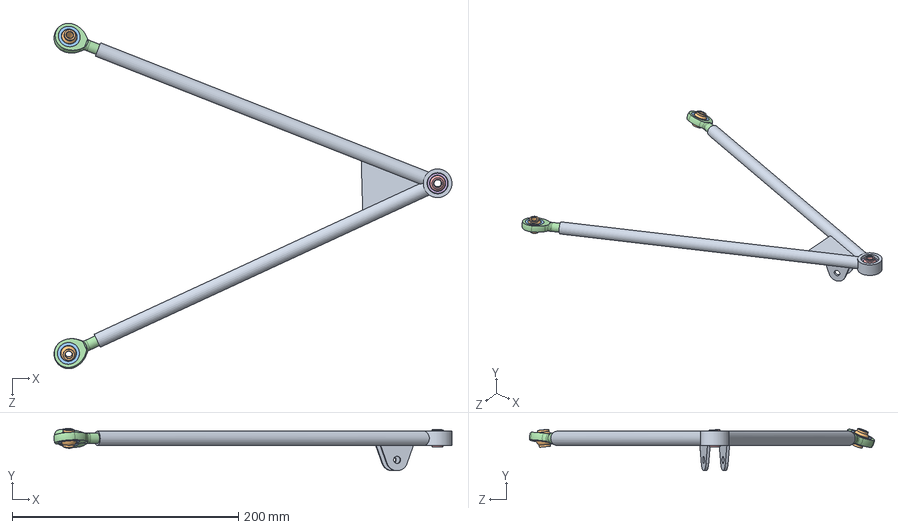
[picture p155: CAD file, 2016-09-20]
Mechanical/Wheel Assemblies/Suspension/Members/Front Top Wishbone.SLDASM
351.9 x 37.4 x 305.3 mm
Front Top Wishbone
HXAM-4T Ball x 2
HXAM-4T Sleeve x 2
HXAM-4T Housing x 2
HAB-4T Ball
HAB-4T Cup
