BDR16/svn-migration-dump/Mechanical/Wheel Assemblies/Suspension/Members/Rear Top Wishbone.SLDASM

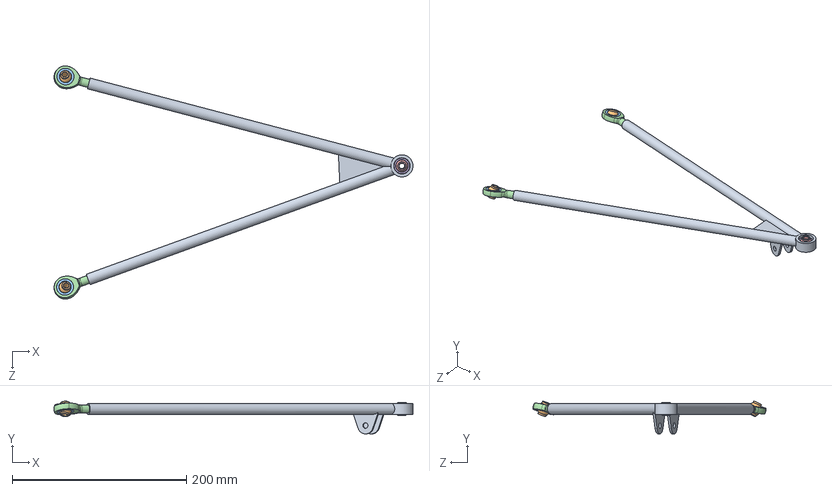
[picture p156: CAD file, 2016-09-20]
Mechanical/Wheel Assemblies/Suspension/Members/Rear Top Wishbone.SLDASM
411.5 x 37.6 x 267.3 mm
Rear Top Wishbone
HXAM-4T Ball x 2
HXAM-4T Sleeve x 2
HXAM-4T Housing x 2
HAB-4T Ball
HAB-4T Cup
