BDR16/svn-migration-dump/Mechanical/Wheel Assemblies/Suspension/Uprights/Simulation/Front Right Upright Simulation.SLDASM

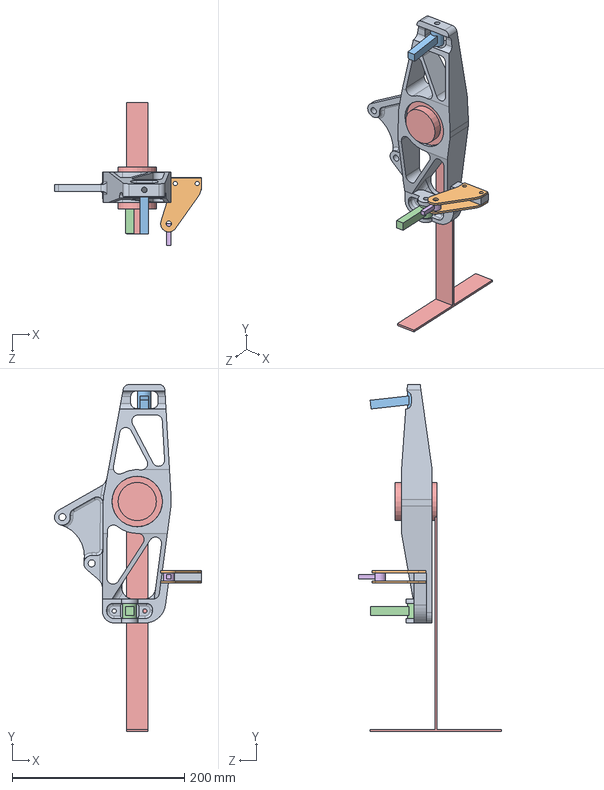
[picture p157: CAD file, 2016-09-20]
Mechanical/Wheel Assemblies/Suspension/Uprights/Simulation/Front Right Upright Simulation.SLDASM
170.6 x 402.4 x 166.2 mm
Front Right Upright
Front Upright Steering Arm
Front Upper A-Arm Spherical Joint
Lower A-Arm Spherical Joint
Front Hub and Tire
Steering Link Rod End
