BDR16/svn-migration-dump/Mechanical/Drivetrain/Support Structures/Motor Supports/Motor Offset Assembly.SLDASM

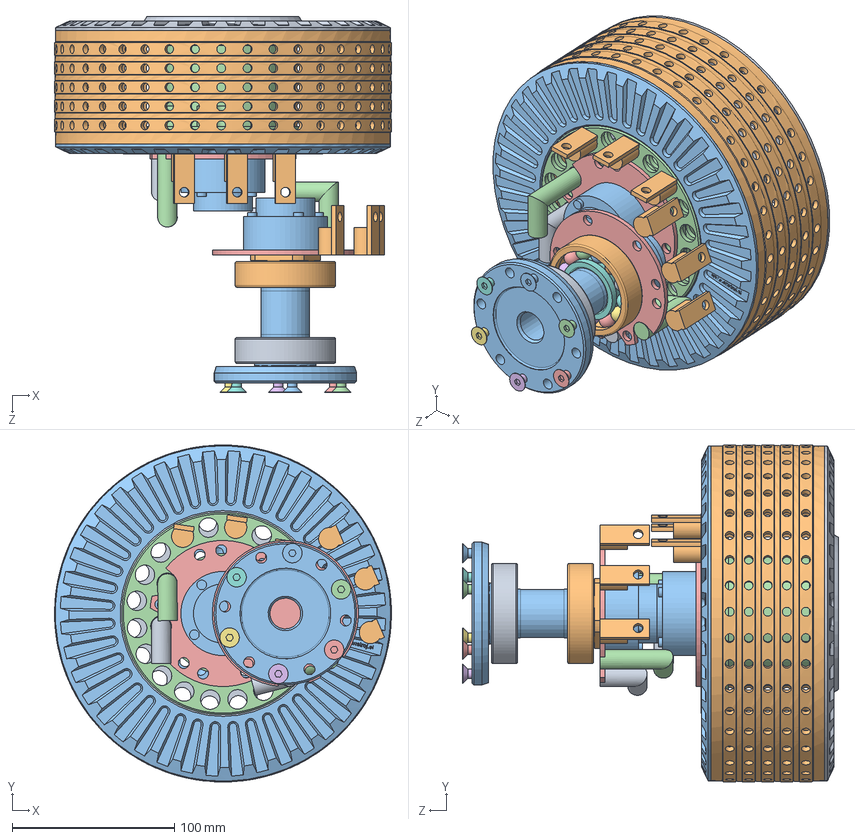
[picture p158: CAD file, 2016-09-20]
Mechanical/Drivetrain/Support Structures/Motor Supports/Motor Offset Assembly.SLDASM
208.0 x 208.0 x 232.2 mm
Coolant Pipe Short x 2
Electrical Connector x 6
Resolver x 2
Coolant Pipe Long x 2
Resolver Plate x 2
