BDR16/svn-migration-dump/Mechanical/Wheel Assemblies/Suspension/Members/Front Pull Rod.SLDASM

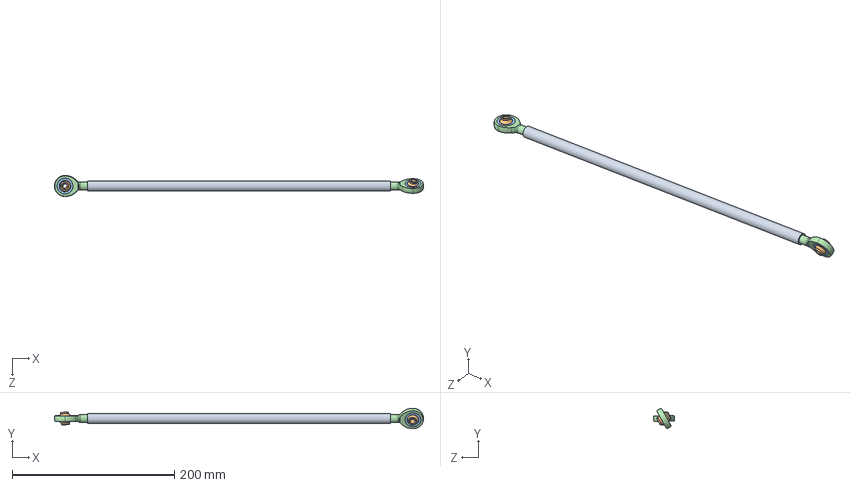
[picture p160: CAD file, 2016-09-20]
Mechanical/Wheel Assemblies/Suspension/Members/Front Pull Rod.SLDASM
454.6 x 25.2 x 26.0 mm
Front Pull Rod
HXAM-4T Ball x 2
HXAM-4T Sleeve x 2
HXAM-4T Housing x 2
