BDR16/svn-migration-dump/Mechanical/Chassis/Tabs/Tabs_Bulldogs_Racing_Rev02.SLDASM

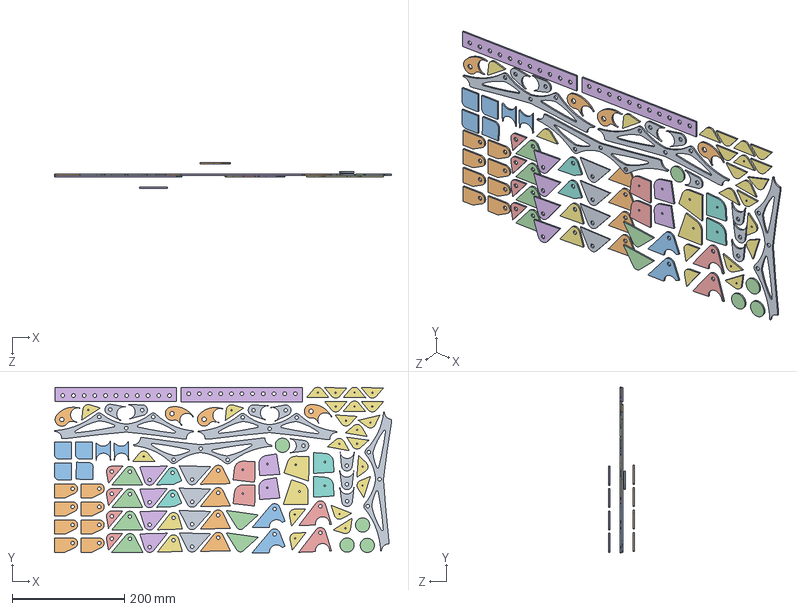
[picture p161: CAD file, 2016-09-20]
Mechanical/Chassis/Tabs/Tabs_Bulldogs_Racing_Rev02.SLDASM
600.0 x 294.7 x 45.7 mm
Planetary Inner Tab x 4
Planetary Outer Tabs x 8
Tab 55 x 2
Tab 56 x 4
Tab 57 x 4
Tab 58 x 4
Tab 59 x 2
Tab 60 x 2
Tab 61 x 4
Tab 62 x 4
Tab 63 x 4
Tab 64 x 2
Tab 65 x 2
Tab 66 x 2
Tab 67 x 2
Tab 68 x 2
Tab 69 x 8
Tab 70 x 4
Tab 71 x 2
Tab 73 x 4
Tab 75 (76 on cut list) x 2
tabs x 2
Extra Tab x 21
