BDR16/svn-migration-dump/Mechanical/Wheel Assemblies/Suspension/Members/Front Steering Rod.SLDASM

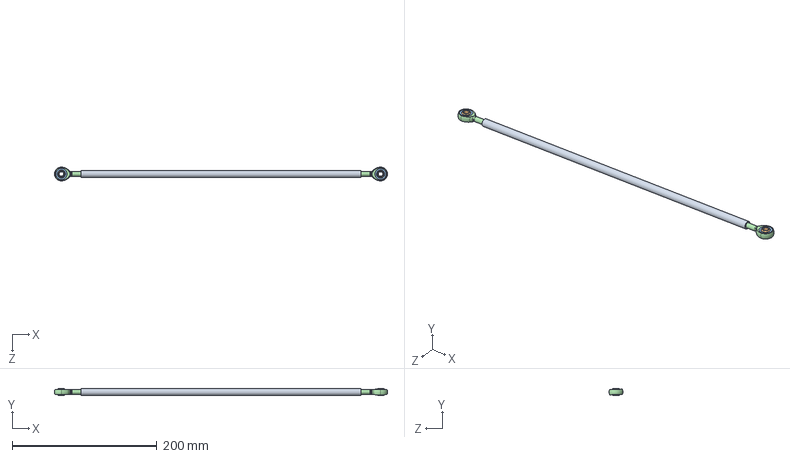
[picture p162: CAD file, 2016-09-20]
Mechanical/Wheel Assemblies/Suspension/Members/Front Steering Rod.SLDASM
459.5 x 9.71 x 19.0 mm
Front Steering Rod
MM-4T Ball x 2
MM-4T Sleeve x 2
MM-4T Housing x 2
