BDR16/svn-migration-dump/Mechanical/Pedal Box/Brake Pedal/Brake Pedal.SLDASM

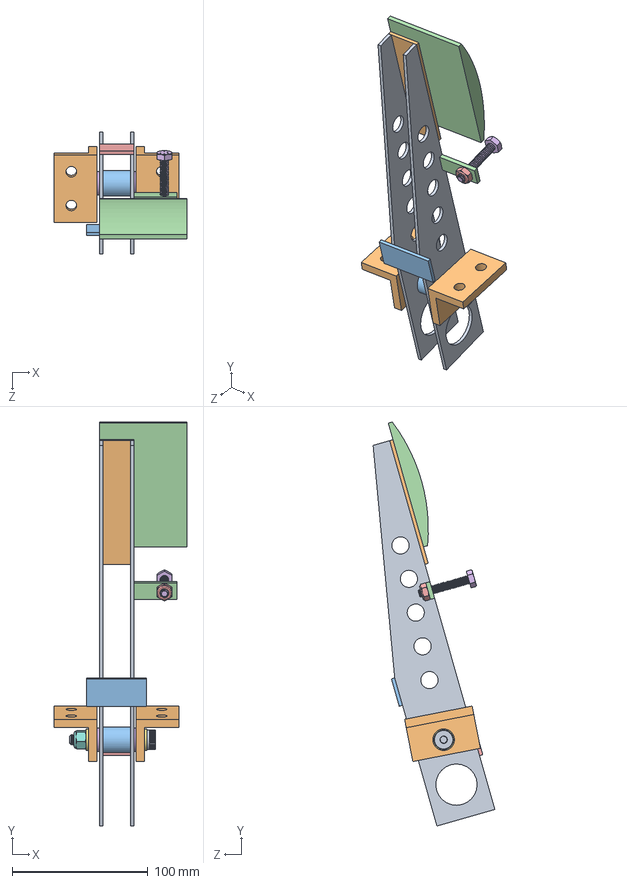
[picture p163: CAD file, 2016-09-20]
Mechanical/Pedal Box/Brake Pedal/Brake Pedal.SLDASM
97.9 x 298.0 x 89.8 mm
Pedal Side x 2
Pad Backing
Pedal Shaft Housing
Wide Pedal Pad
Switch Actuator Plate
Flanged Sleeve x 2
PTFE 3_8in ID 5_8in OD Washer x 2
Steel Nyloc 5_16-24 Grade 8
Steel Socket Shoulder 5_16in-18 1and3_4in
Brake Pedal Mount x 2
Stop Plate
Overtravel Engager
Steel Thin Nyloc 1_4-20 Grade 8
Steel Hex 1_4-20 1and1_2in Grade 8
