BDR16/svn-migration-dump/Mechanical/Accumulator/HV Control/Segment Maintenance Disconnect.SLDPRT

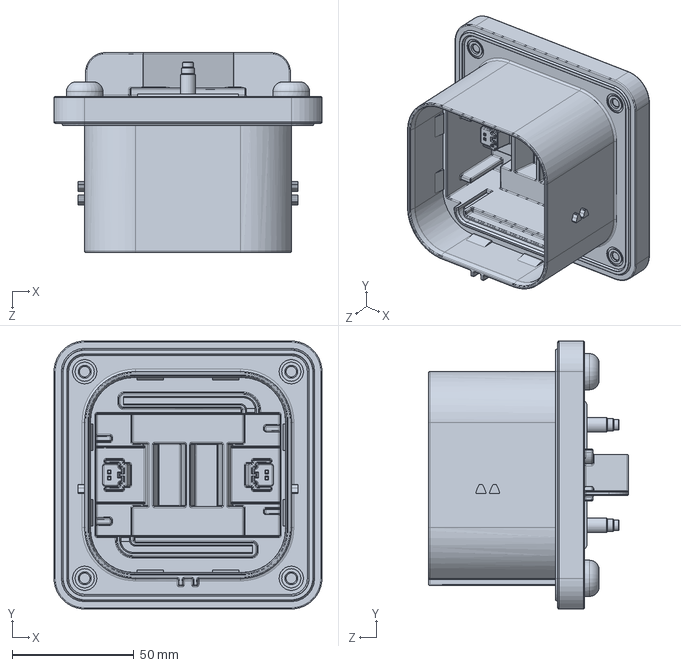
[picture p164: CAD file, 2016-09-20]
Mechanical/Accumulator/HV Control/Segment Maintenance Disconnect.SLDPRT
110.0 x 110.0 x 82.0 mm
