BDR16/svn-migration-dump/Mechanical/Accumulator/Motor Controller/Bamocar.SLDASM

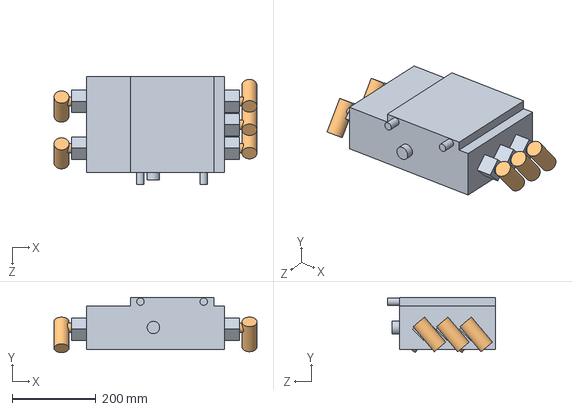
[picture p165: CAD file, 2016-09-20]
Mechanical/Accumulator/Motor Controller/Bamocar.SLDASM
486.0 x 132.1 x 258.0 mm
BamoCar
Pfisterer Elbow x 5
