BDR16/svn-migration-dump/Mechanical/Accumulator/Motor Controller/Motor Controller.SLDASM

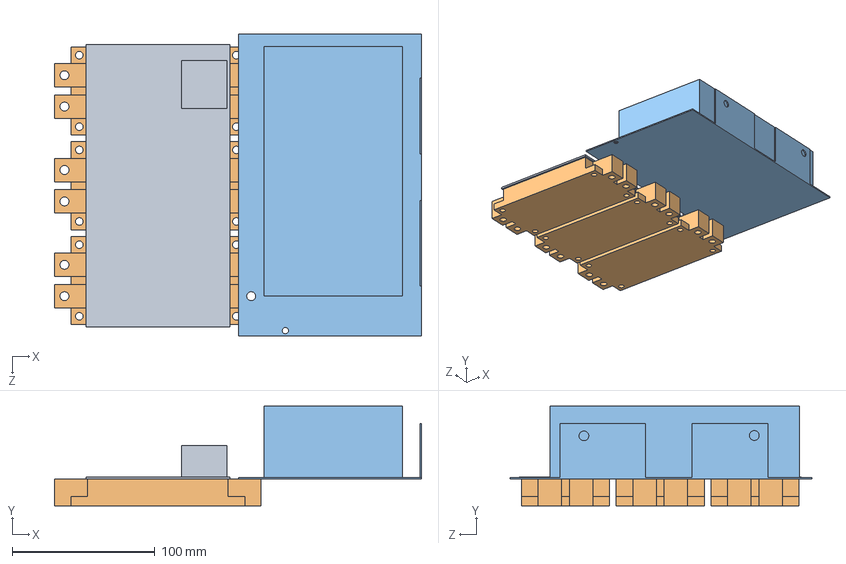
[picture p166: CAD file, 2016-09-20]
Mechanical/Accumulator/Motor Controller/Motor Controller.SLDASM
257.5 x 69.8 x 212.0 mm
HV Board
IGBT x 3
Capacitor Board
