BDR16/svn-migration-dump/Mechanical/Accumulator/Battery Box Handle.SLDPRT

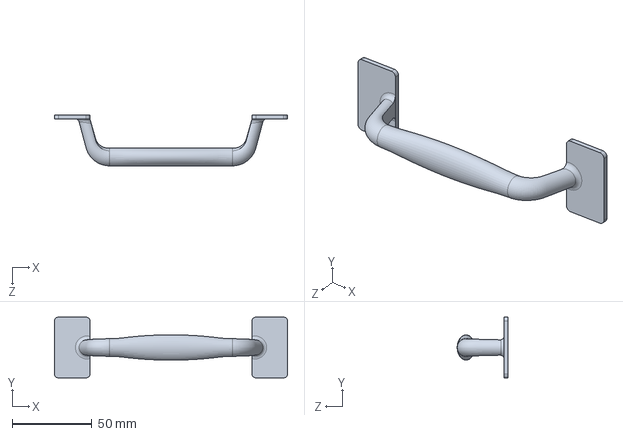
[picture p167: CAD file, 2016-09-20]
Mechanical/Accumulator/Battery Box Handle.SLDPRT
146.1 x 38.1 x 31.7 mm
