BDR16/svn-migration-dump/Mechanical/Accumulator/Battery Management System/Cell Boards/Cell Board End.SLDPRT

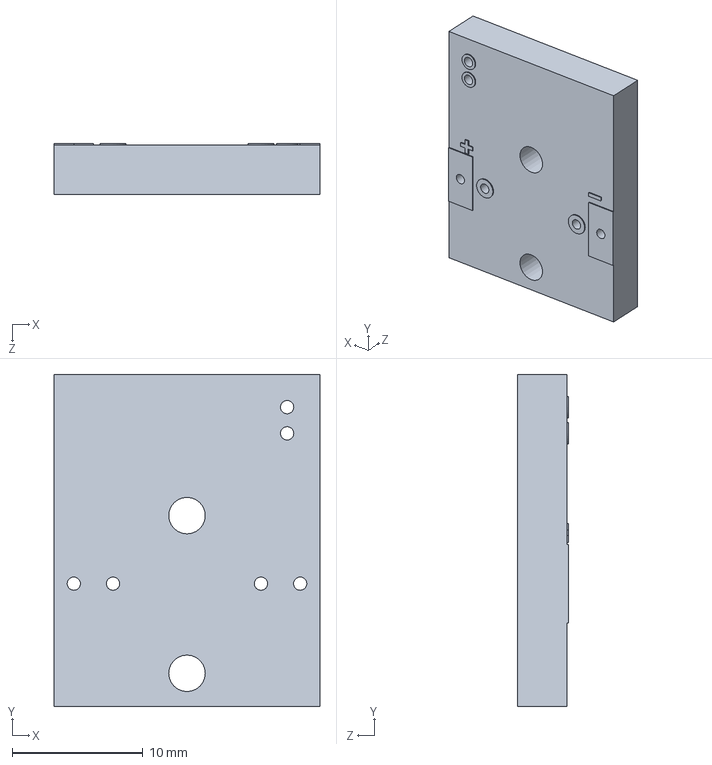
[picture p168: CAD file, 2016-09-20]
Mechanical/Accumulator/Battery Management System/Cell Boards/Cell Board End.SLDPRT
20.3 x 25.4 x 3.91 mm
