BDR16/svn-migration-dump/Mechanical/Accumulator/Connectors/Amphenol Triple PowerLok/Amphenol Triple PowerLok Connector.SLDPRT

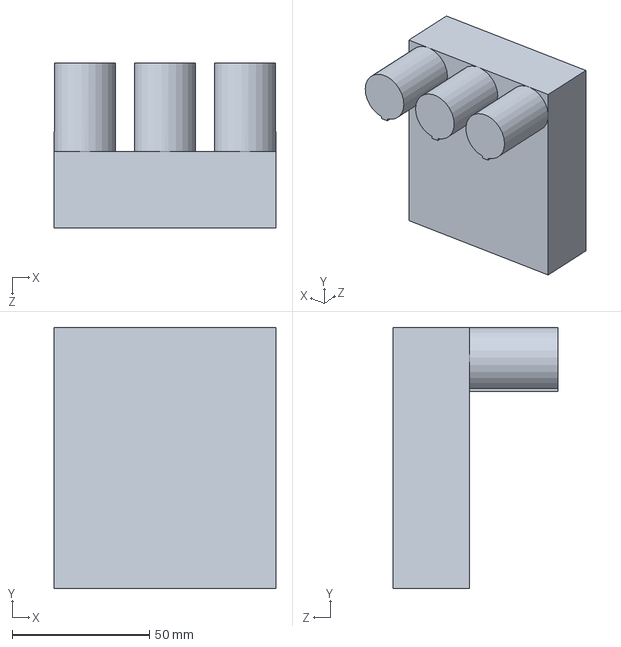
[picture p169: CAD file, 2016-09-20]
Mechanical/Accumulator/Connectors/Amphenol Triple PowerLok/Amphenol Triple PowerLok Connector.SLDPRT
80.8 x 95.2 x 60.3 mm
