BDR16/svn-migration-dump/Mechanical/Accumulator/HV Control/0 Gauge Lug.SLDPRT

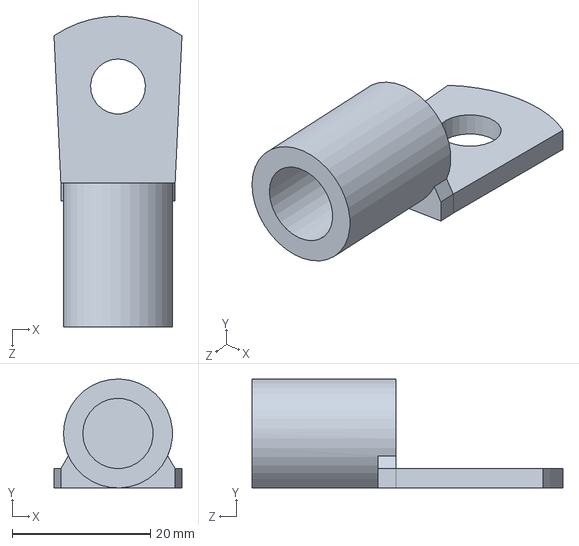
[picture p170: CAD file, 2016-09-20]
Mechanical/Accumulator/HV Control/0 Gauge Lug.SLDPRT
18.5 x 15.7 x 44.9 mm
