BDR16/svn-migration-dump/Mechanical/Accumulator/HV Control/Bus Bars/MC Positive.SLDPRT

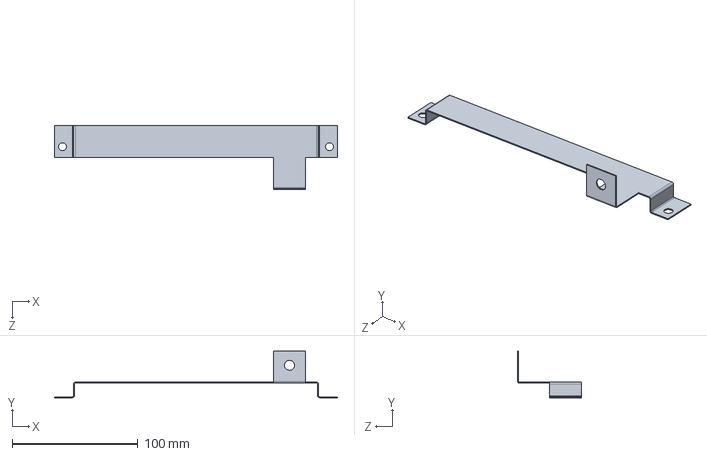
[picture p171: CAD file, 2016-09-20]
Mechanical/Accumulator/HV Control/Bus Bars/MC Positive.SLDPRT
224.7 x 36.9 x 50.8 mm
