BDR16/svn-migration-dump/Mechanical/Accumulator/HV Control/Current Sensor/Current Sensor Connector.SLDPRT

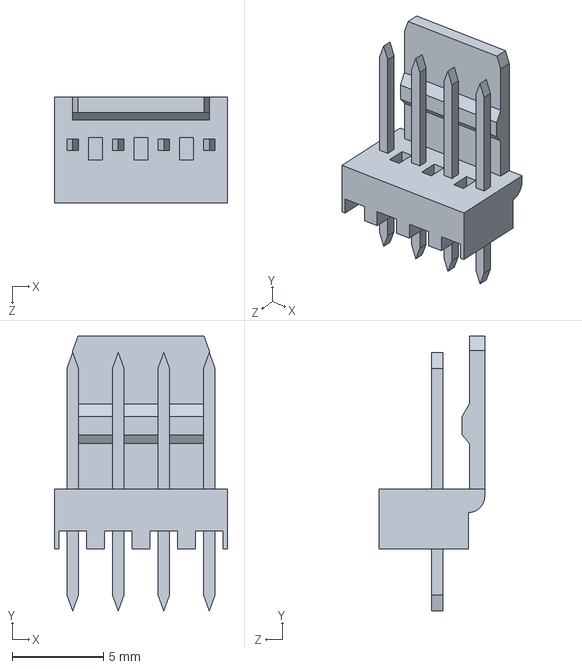
[picture p172: CAD file, 2016-09-20]
Mechanical/Accumulator/HV Control/Current Sensor/Current Sensor Connector.SLDPRT
9.50 x 15.1 x 5.80 mm
