BDR16/svn-migration-dump/Mechanical/Accumulator/HV Control/HV Fusing/HV Fuseholder.SLDPRT

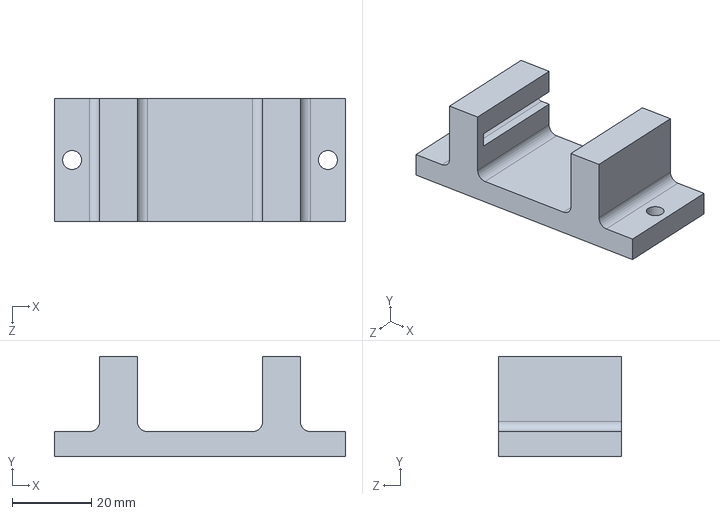
[picture p173: CAD file, 2016-09-20]
Mechanical/Accumulator/HV Control/HV Fusing/HV Fuseholder.SLDPRT
73.7 x 25.4 x 31.1 mm
