BDR16/svn-migration-dump/Mechanical/Accumulator/Motor Controller/Motor Controller Board/Regular Tab.SLDPRT

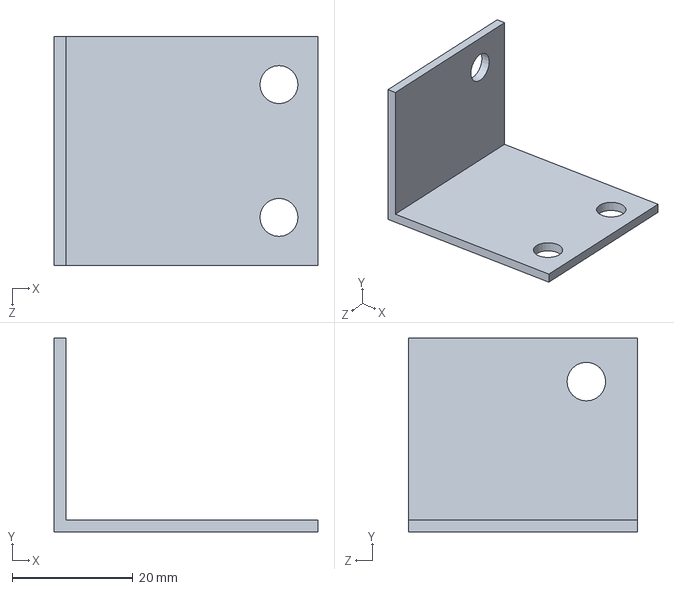
[picture p174: CAD file, 2016-09-20]
Mechanical/Accumulator/Motor Controller/Motor Controller Board/Regular Tab.SLDPRT
43.8 x 32.1 x 38.0 mm
