BDR16/svn-migration-dump/Mechanical/Accumulator/Motor Controller/Motor Controller Standoff.SLDPRT

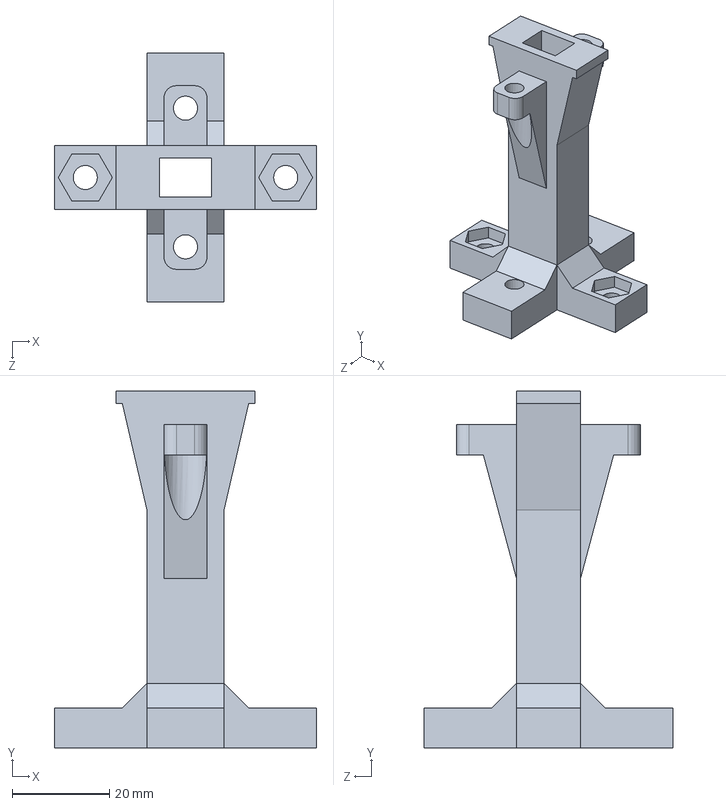
[picture p175: CAD file, 2016-09-20]
Mechanical/Accumulator/Motor Controller/Motor Controller Standoff.SLDPRT
54.0 x 73.5 x 51.3 mm
