BDR16/svn-migration-dump/Mechanical/Accumulator/Stacks/Stack Parts/Expansion Limiter/End Plate.SLDPRT

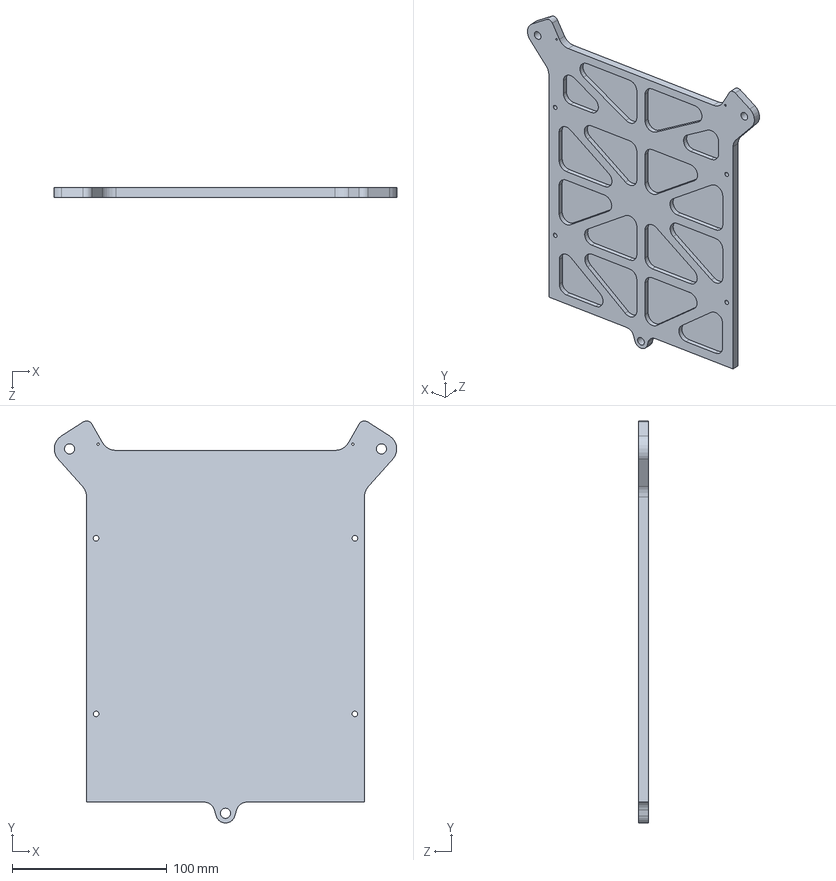
[picture p176: CAD file, 2016-09-20]
Mechanical/Accumulator/Stacks/Stack Parts/Expansion Limiter/End Plate.SLDPRT
221.6 x 260.0 x 6.35 mm
