BDR16/svn-migration-dump/Mechanical/Accumulator/Stacks/Stack Parts/Heat Sink/Heat Sink Half.SLDPRT

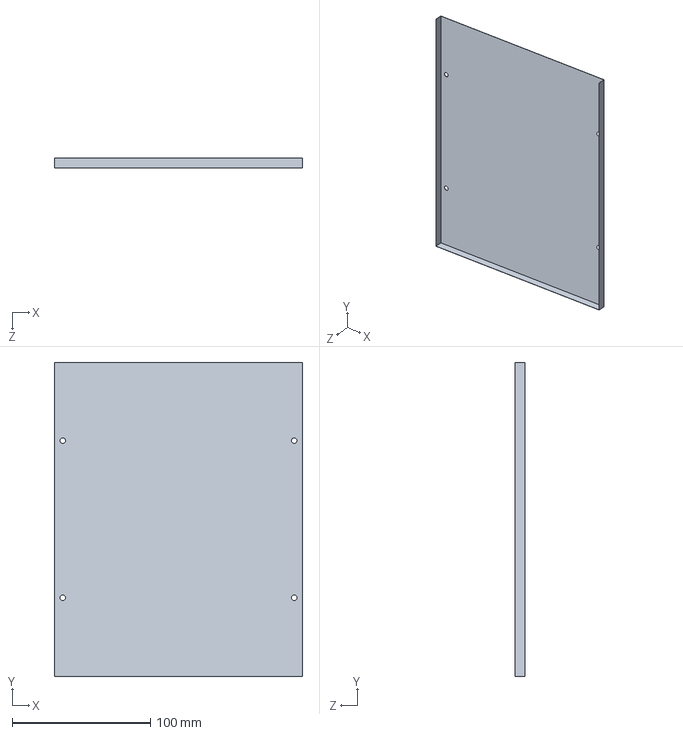
[picture p177: CAD file, 2016-09-20]
Mechanical/Accumulator/Stacks/Stack Parts/Heat Sink/Heat Sink Half.SLDPRT
179.7 x 227.2 x 7.20 mm
