BDR16/svn-migration-dump/Mechanical/Accumulator/Stacks/Stack Parts/Repeating Frame/Repeating Frame Outer.SLDPRT

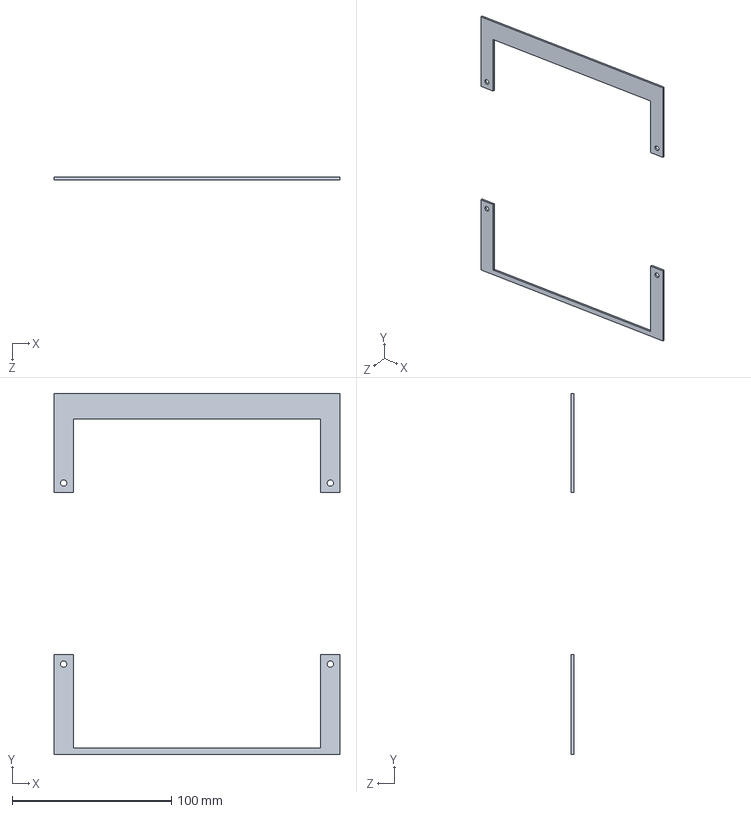
[picture p178: CAD file, 2016-09-20]
Mechanical/Accumulator/Stacks/Stack Parts/Repeating Frame/Repeating Frame Outer.SLDPRT
179.3 x 226.6 x 1.59 mm
