BDR16/svn-migration-dump/Mechanical/Accumulator/Stacks/Stack Parts/Tab Cover/Tab Cover Even.SLDPRT

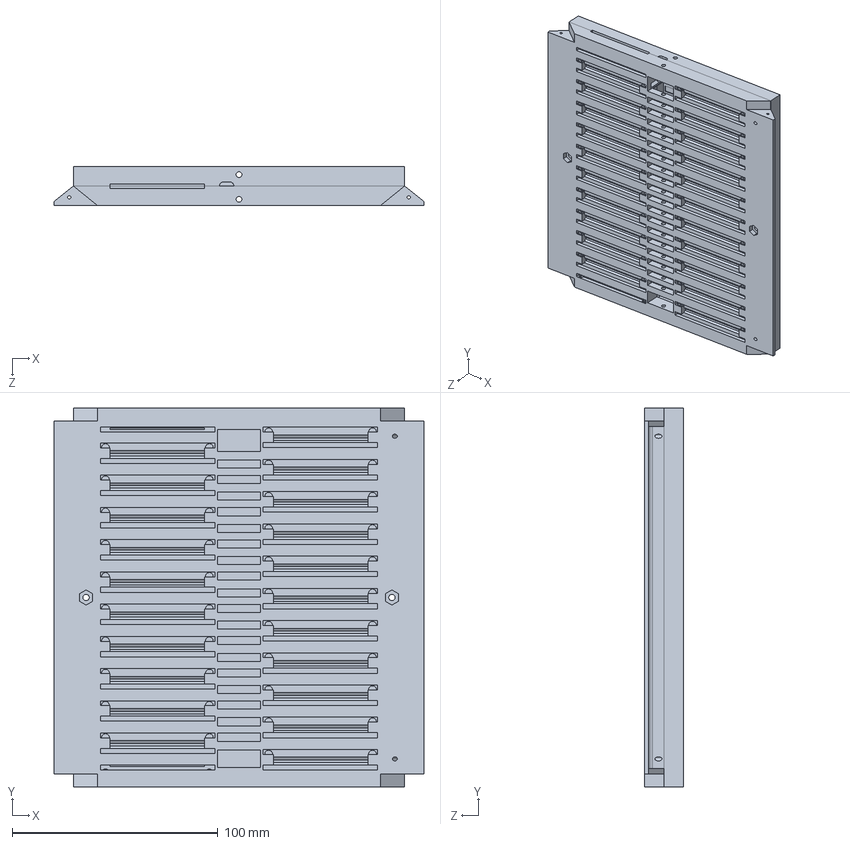
[picture p179: CAD file, 2016-09-20]
Mechanical/Accumulator/Stacks/Stack Parts/Tab Cover/Tab Cover Even.SLDPRT
180.0 x 184.3 x 19.1 mm
