BDR16/svn-migration-dump/Mechanical/Accumulator/Stacks/Stack Parts/Tab Load Spreader.SLDPRT

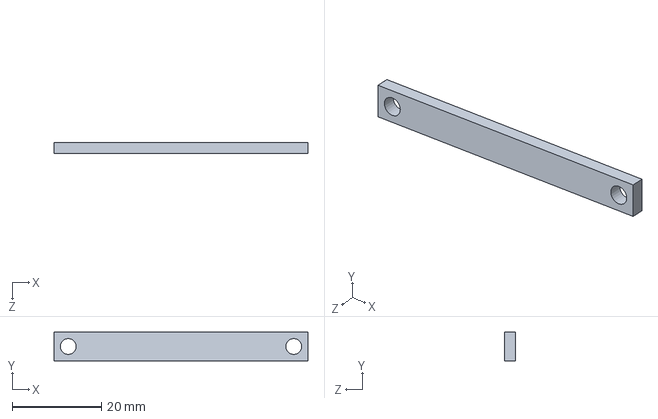
[picture p180: CAD file, 2016-09-20]
Mechanical/Accumulator/Stacks/Stack Parts/Tab Load Spreader.SLDPRT
57.0 x 6.41 x 2.54 mm
