BDR16/svn-migration-dump/Mechanical/Accumulator/Stacks/Thermal Simulation/Solidworks Model/Pouch.SLDPRT

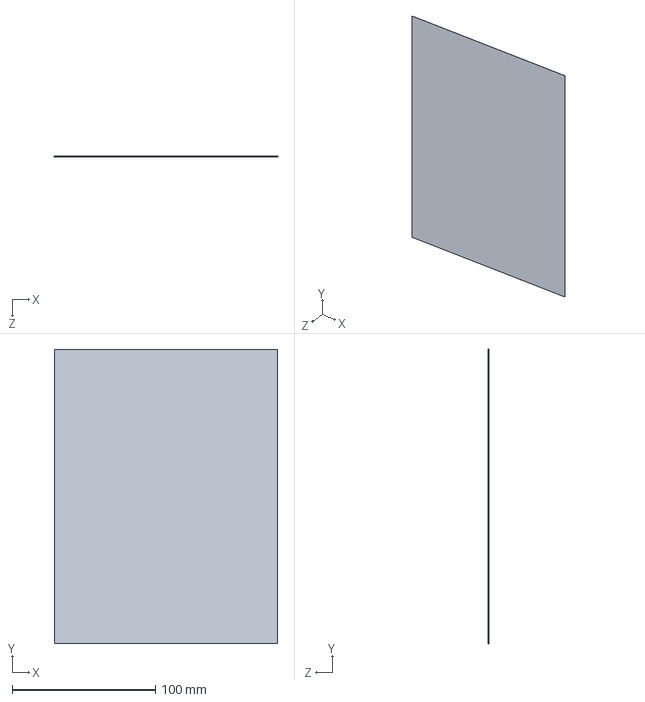
[picture p181: CAD file, 2016-09-20]
Mechanical/Accumulator/Stacks/Thermal Simulation/Solidworks Model/Pouch.SLDPRT
156.1 x 205.5 x 0.112 mm
