BDR16/svn-migration-dump/Mechanical/Accumulator/Thermal Analysis/Accumulator Box Thermal.SLDPRT

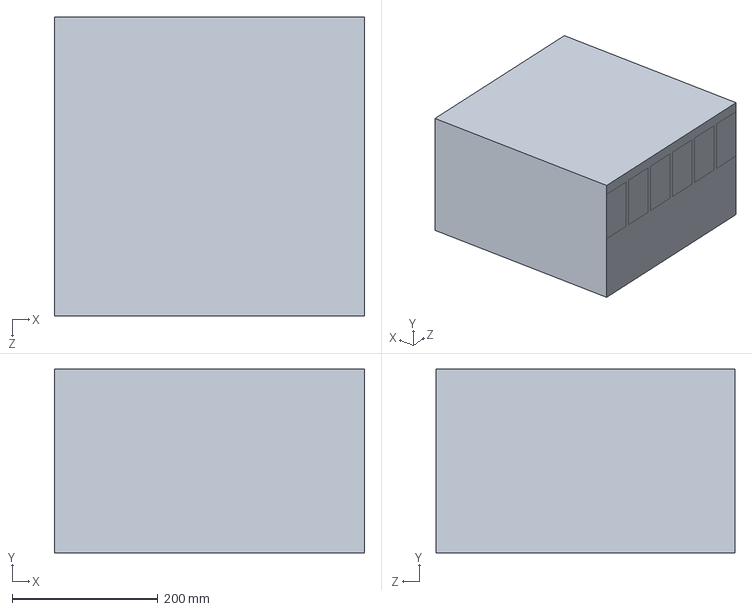
[picture p182: CAD file, 2016-09-20]
Mechanical/Accumulator/Thermal Analysis/Accumulator Box Thermal.SLDPRT
425.0 x 252.1 x 410.0 mm
