BDR16/svn-migration-dump/Mechanical/Accumulator/Water Block/Water Block.SLDPRT

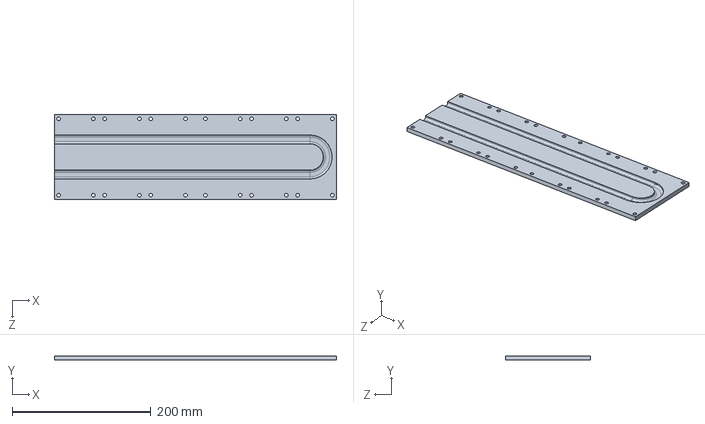
[picture p183: CAD file, 2016-09-20]
Mechanical/Accumulator/Water Block/Water Block.SLDPRT
407.0 x 6.35 x 122.0 mm
