BDR16/svn-migration-dump/Mechanical/BBB/BBB Box.SLDPRT

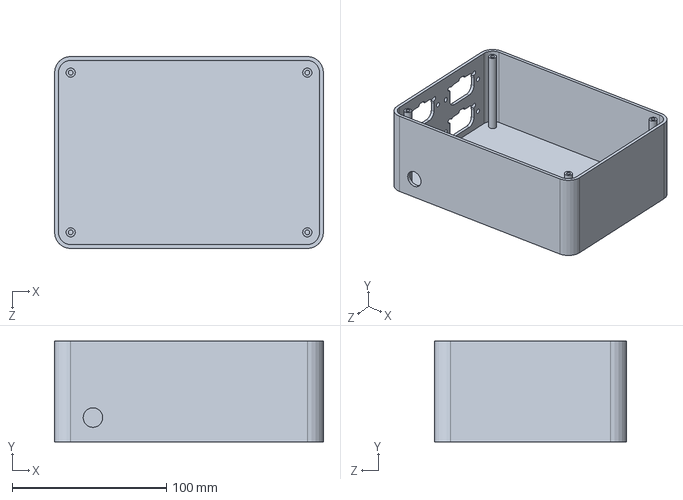
[picture p184: CAD file, 2016-09-20]
Mechanical/BBB/BBB Box.SLDPRT
174.3 x 65.3 x 124.5 mm
