BDR16/svn-migration-dump/Mechanical/Body/Ribs.sldprt

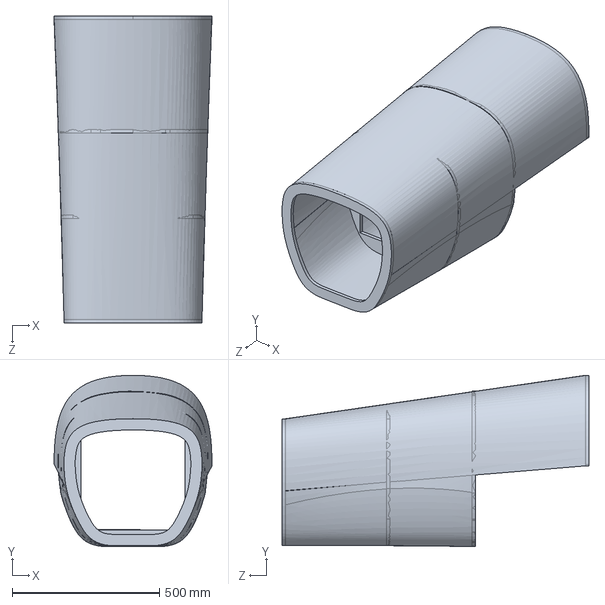
[picture p185: CAD file, 2016-09-20]
Mechanical/Body/Ribs.sldprt
535.8 x 581.0 x 1041.4 mm
