BDR16/svn-migration-dump/Mechanical/Chassis/Accumulator Upper Tab.SLDPRT

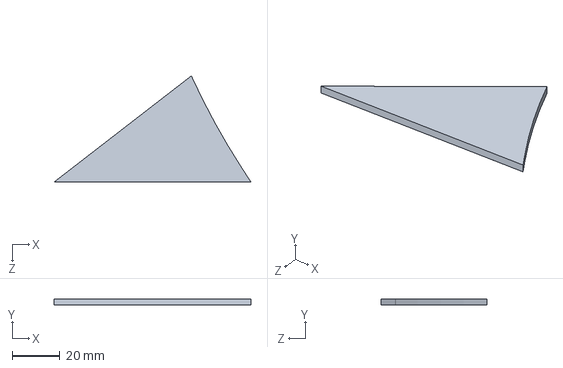
[picture p186: CAD file, 2016-09-20]
Mechanical/Chassis/Accumulator Upper Tab.SLDPRT
82.4 x 2.54 x 44.5 mm
