BDR16/svn-migration-dump/Mechanical/Chassis/Tabs/Tab 70.sldprt

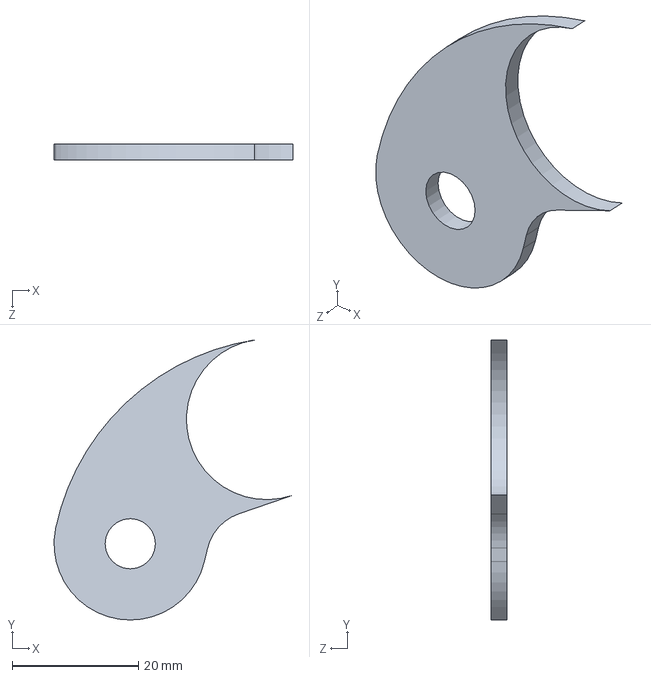
[picture p187: CAD file, 2016-09-20]
Mechanical/Chassis/Tabs/Tab 70.sldprt
37.8 x 44.3 x 2.54 mm
