BDR16/svn-migration-dump/Mechanical/Controls/Steering Wheel.SLDPRT

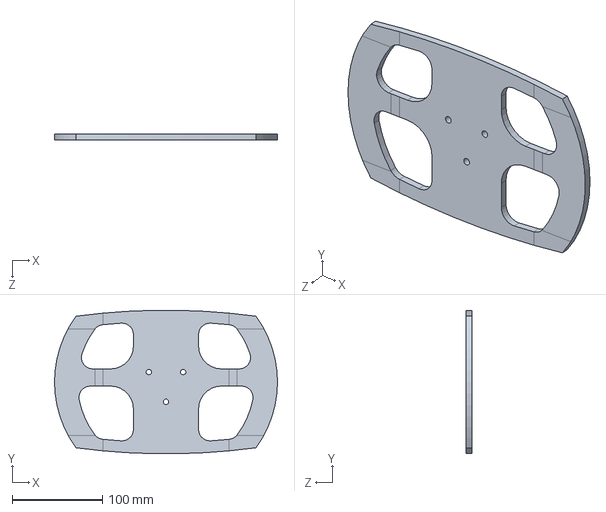
[picture p188: CAD file, 2016-09-20]
Mechanical/Controls/Steering Wheel.SLDPRT
247.6 x 159.2 x 6.35 mm
