BDR16/svn-migration-dump/Mechanical/Drivetrain/Axle/RCV D5158.SLDPRT

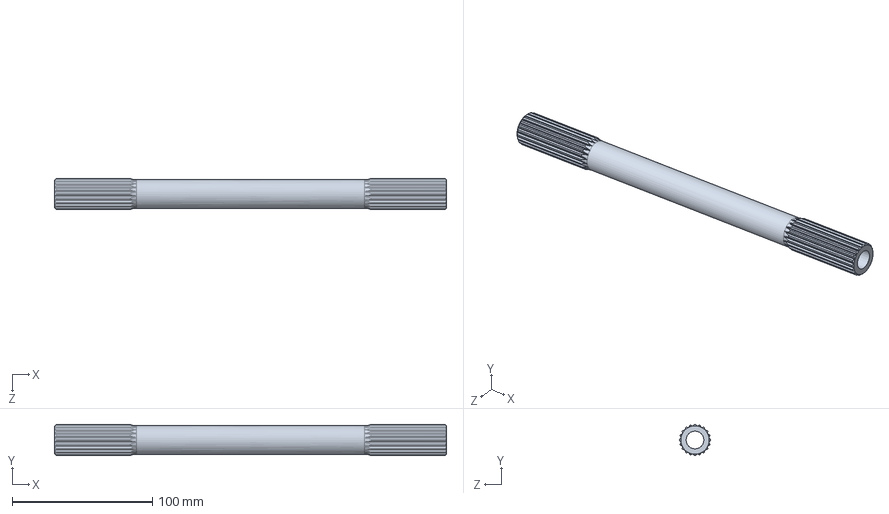
[picture p189: CAD file, 2016-09-20]
Mechanical/Drivetrain/Axle/RCV D5158.SLDPRT
279.4 x 22.1 x 22.1 mm
