BDR16/svn-migration-dump/Mechanical/Drivetrain/Bearings/SKF 61808.SLDPRT

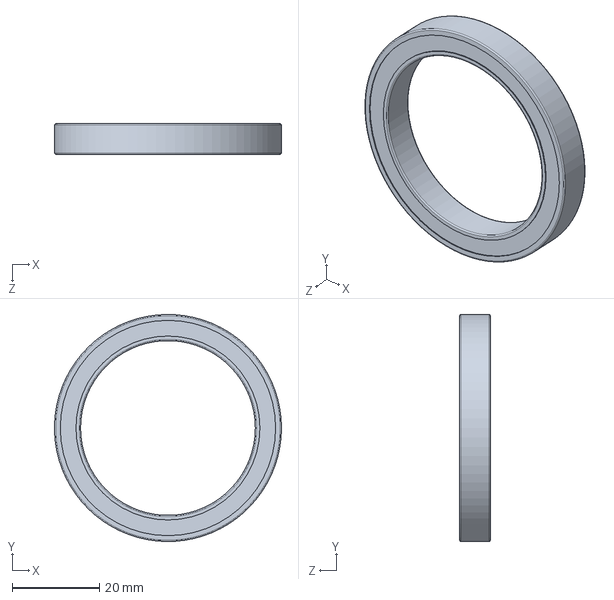
[picture p190: CAD file, 2016-09-20]
Mechanical/Drivetrain/Bearings/SKF 61808.SLDPRT
52.0 x 52.0 x 7.00 mm
