BDR16/svn-migration-dump/Mechanical/Drivetrain/Coupler/Motor to Gearbox/Coupler Base.SLDPRT

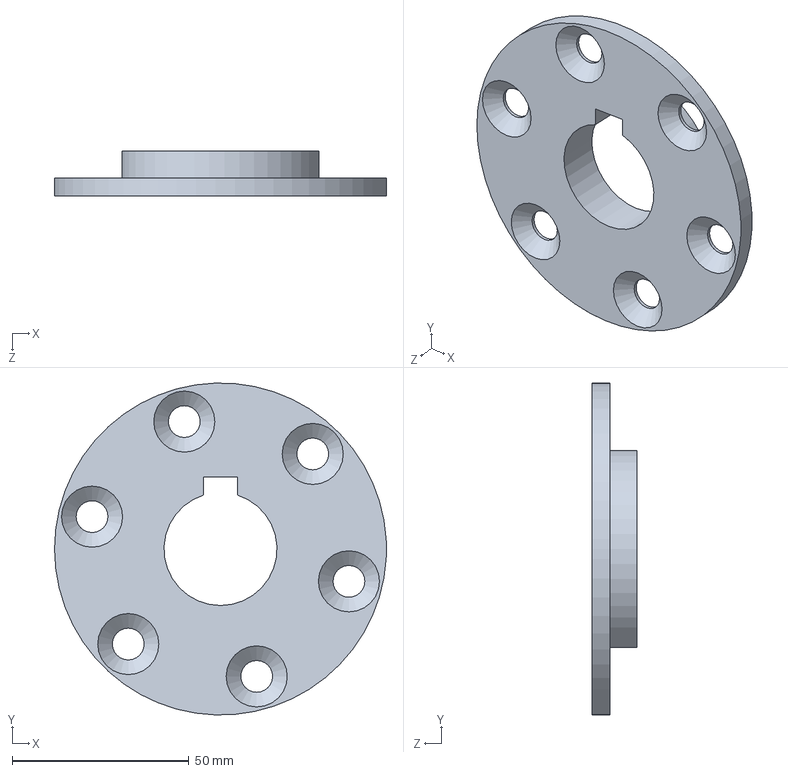
[picture p191: CAD file, 2016-09-20]
Mechanical/Drivetrain/Coupler/Motor to Gearbox/Coupler Base.SLDPRT
94.0 x 94.0 x 12.7 mm
