BDR16/svn-migration-dump/Mechanical/Drivetrain/Planetary Gearbox/Gearbox Covers/Outer Cover.SLDPRT

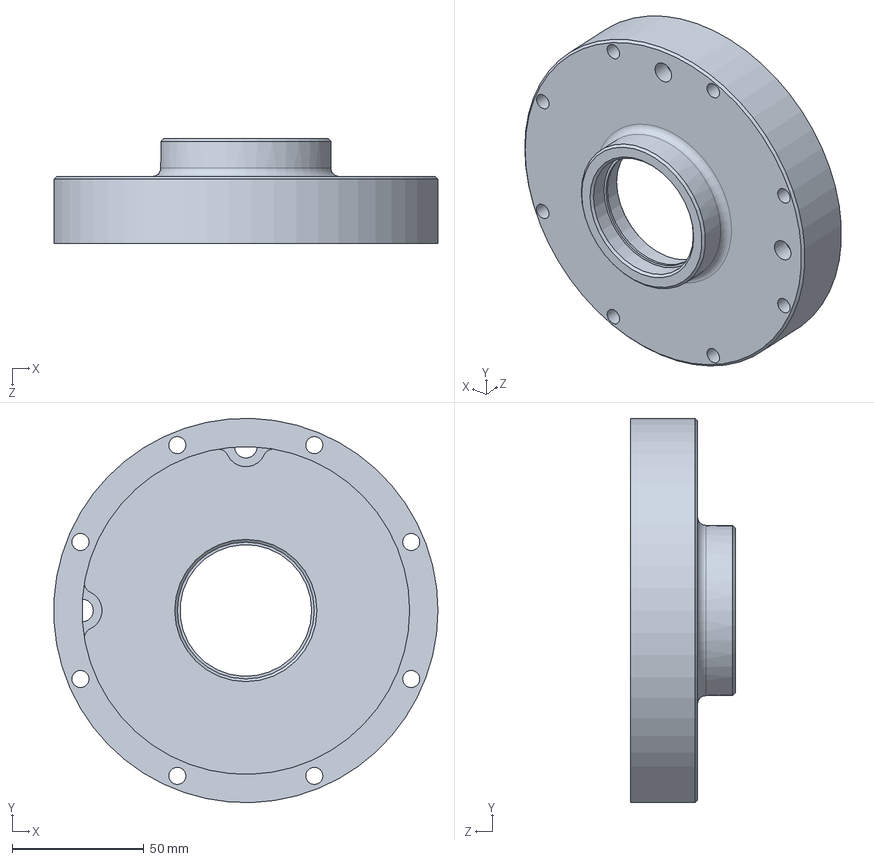
[picture p192: CAD file, 2016-09-20]
Mechanical/Drivetrain/Planetary Gearbox/Gearbox Covers/Outer Cover.SLDPRT
145.9 x 145.9 x 39.7 mm
