BDR16/svn-migration-dump/Mechanical/Drivetrain/Planetary Gearbox/Parts/Drive Plate.SLDPRT

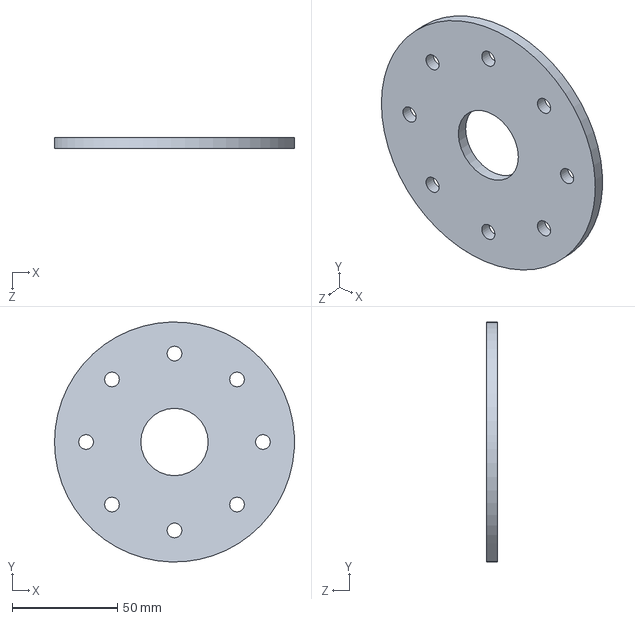
[picture p193: CAD file, 2016-09-20]
Mechanical/Drivetrain/Planetary Gearbox/Parts/Drive Plate.SLDPRT
114.0 x 113.9 x 5.00 mm
