BDR16/svn-migration-dump/Mechanical/Drivetrain/Support Structures/Motor Supports/Tab, Slot.SLDPRT

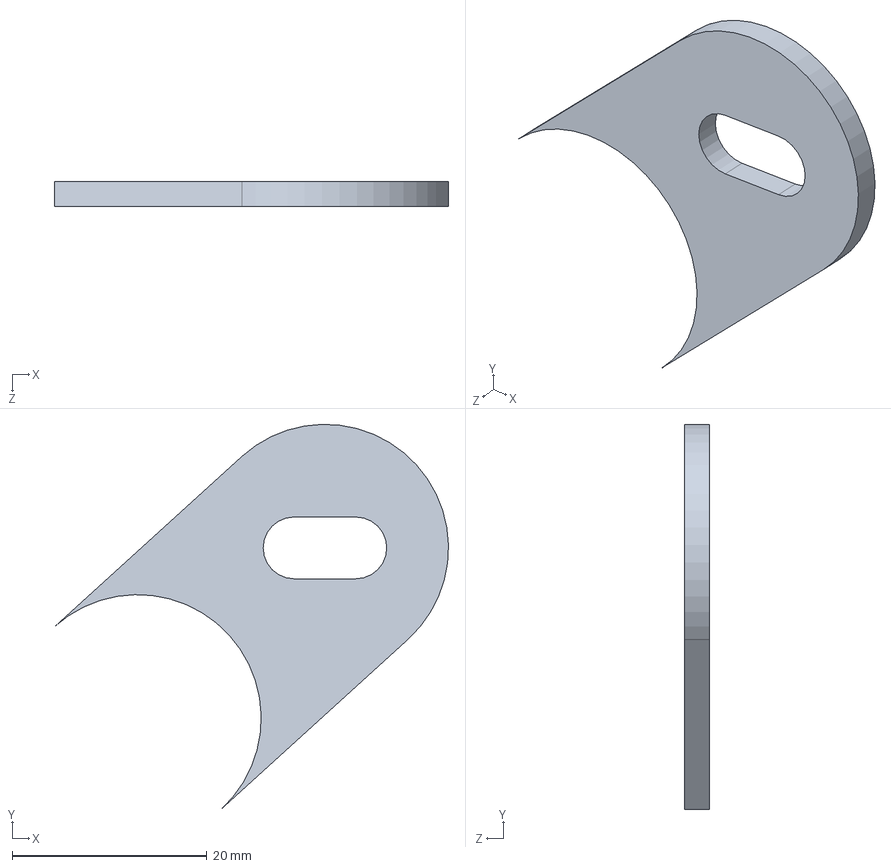
[picture p194: CAD file, 2016-09-20]
Mechanical/Drivetrain/Support Structures/Motor Supports/Tab, Slot.SLDPRT
40.5 x 39.6 x 2.54 mm
