BDR16/svn-migration-dump/Mechanical/Drivetrain/Support Structures/Planetary Supports/Outer Support.sldprt

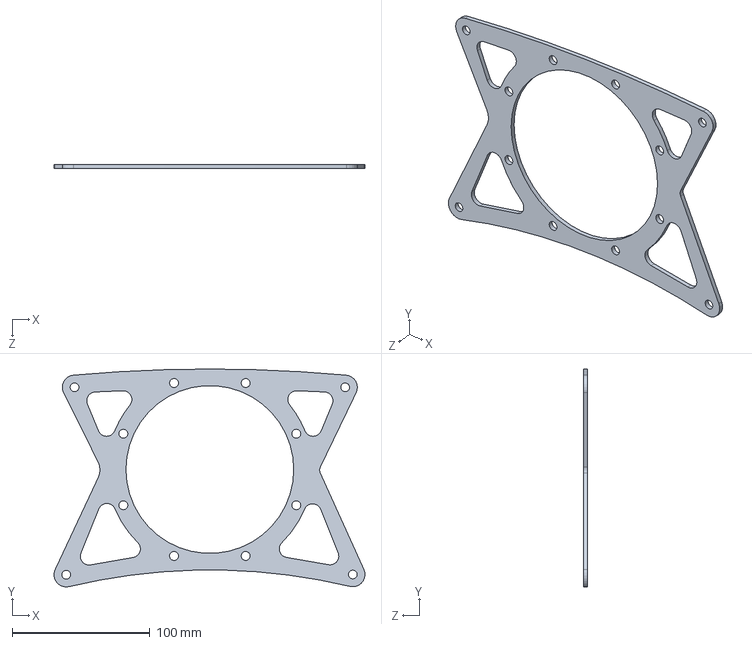
[picture p195: CAD file, 2016-09-20]
Mechanical/Drivetrain/Support Structures/Planetary Supports/Outer Support.sldprt
226.0 x 158.4 x 3.17 mm
