BDR16/svn-migration-dump/Mechanical/Drivetrain/Support Structures/Support Spacers.sldprt

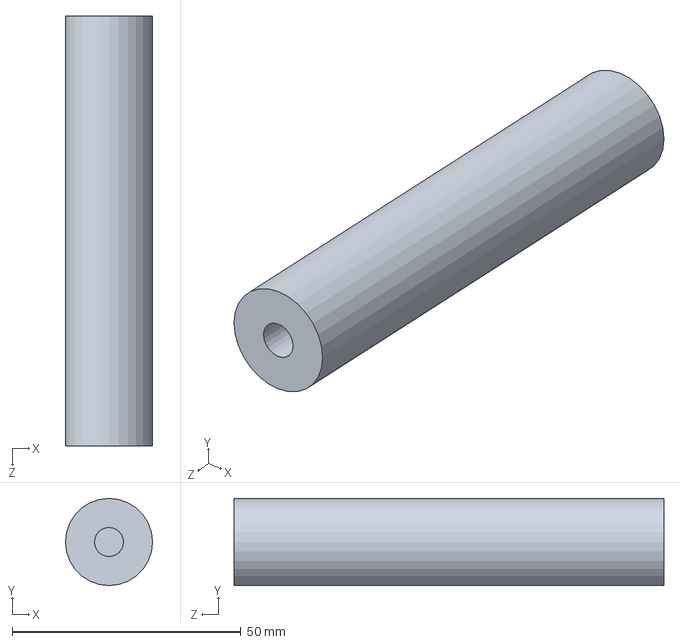
[picture p196: CAD file, 2016-09-20]
Mechanical/Drivetrain/Support Structures/Support Spacers.sldprt
19.1 x 19.1 x 94.0 mm
