BDR16/svn-migration-dump/Mechanical/Drivetrain/Tripod Housing/Extension Stop.SLDPRT

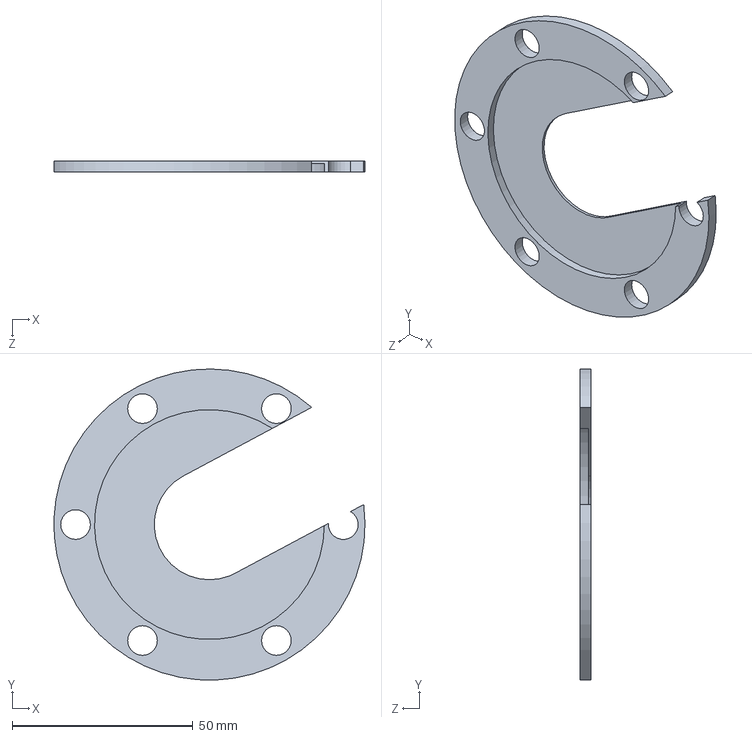
[picture p197: CAD file, 2016-09-20]
Mechanical/Drivetrain/Tripod Housing/Extension Stop.SLDPRT
85.9 x 85.9 x 3.17 mm
