BDR16/svn-migration-dump/Mechanical/Drivetrain/Tripod/RCV D4672-TA/FSAE Tripod V2.sldprt

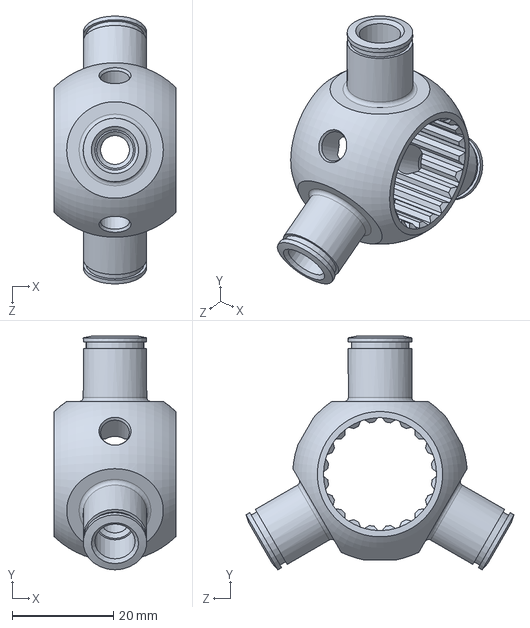
[picture p198: CAD file, 2016-09-20]
Mechanical/Drivetrain/Tripod/RCV D4672-TA/FSAE Tripod V2.sldprt
24.0 x 46.1 x 52.9 mm
