BDR16/svn-migration-dump/Mechanical/Drivetrain/Tripod/Taylor INV-02002011/INV-020020116.sldprt

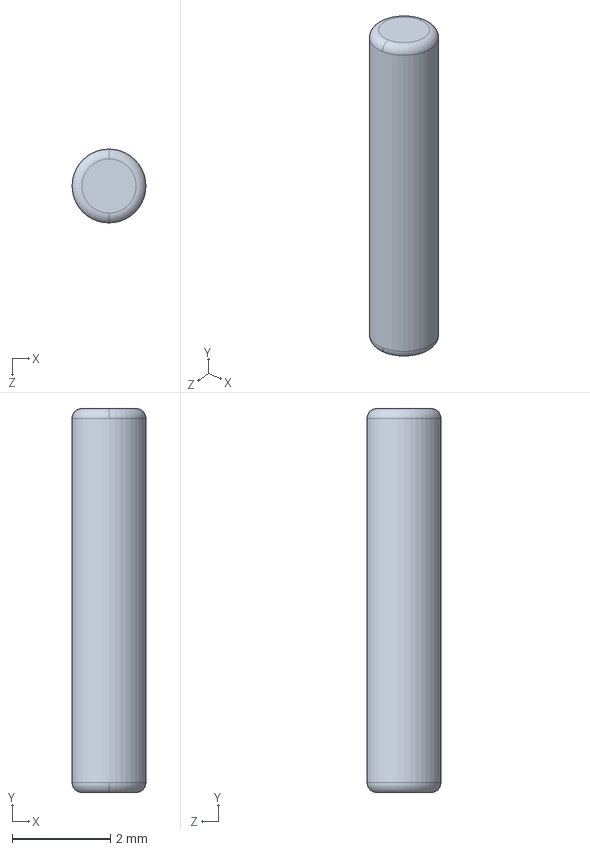
[picture p199: CAD file, 2016-09-20]
Mechanical/Drivetrain/Tripod/Taylor INV-02002011/INV-020020116.sldprt
1.50 x 7.80 x 1.50 mm
