BDR16/svn-migration-dump/Mechanical/Firewall/FirewallAttachToBodyDante1.SLDPRT

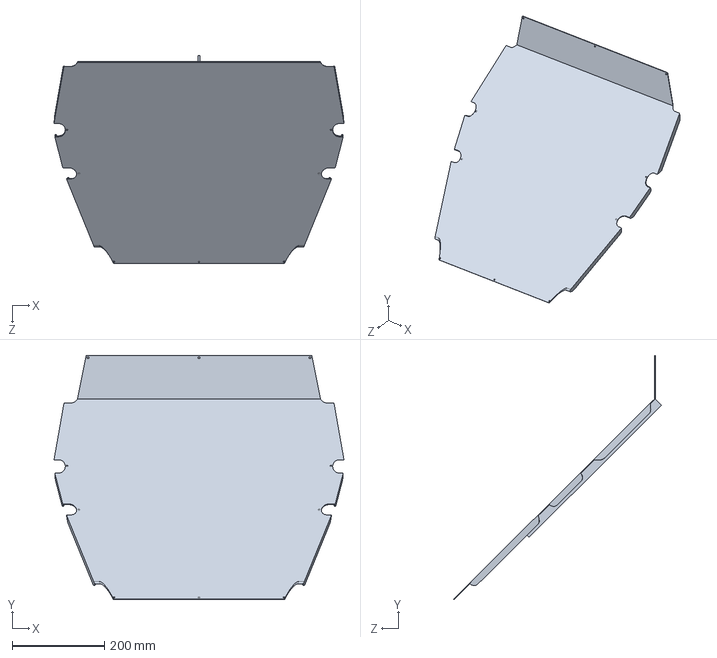
[picture p200: CAD file, 2016-09-20]
Mechanical/Firewall/FirewallAttachToBodyDante1.SLDPRT
630.3 x 530.8 x 451.9 mm
