BDR16/svn-migration-dump/Mechanical/General/Hex Caps/Steel Socket Shoulder 5_16in-18 1and3_4in.SLDPRT

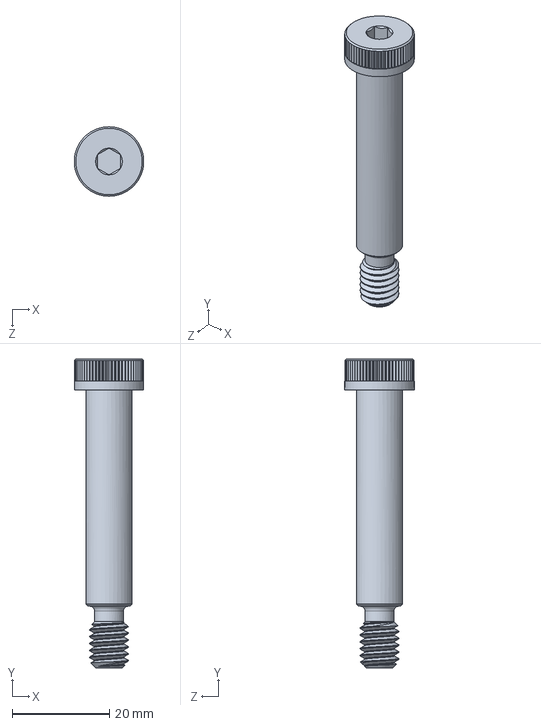
[picture p201: CAD file, 2016-09-20]
Mechanical/General/Hex Caps/Steel Socket Shoulder 5_16in-18 1and3_4in.SLDPRT
14.3 x 63.5 x 14.3 mm
