BDR16/svn-migration-dump/Mechanical/General/Nuts/Steel Hex 0-80 Grade 2.SLDPRT

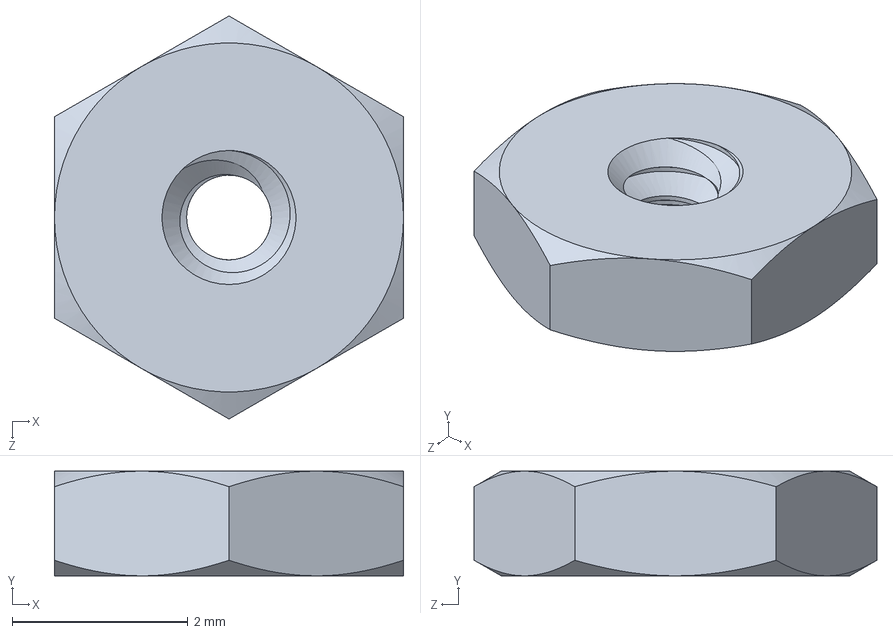
[picture p202: CAD file, 2016-09-20]
Mechanical/General/Nuts/Steel Hex 0-80 Grade 2.SLDPRT
3.97 x 1.19 x 4.58 mm
