BDR16/svn-migration-dump/Mechanical/General/Pipe Fittings/1_8 NPT.SLDPRT

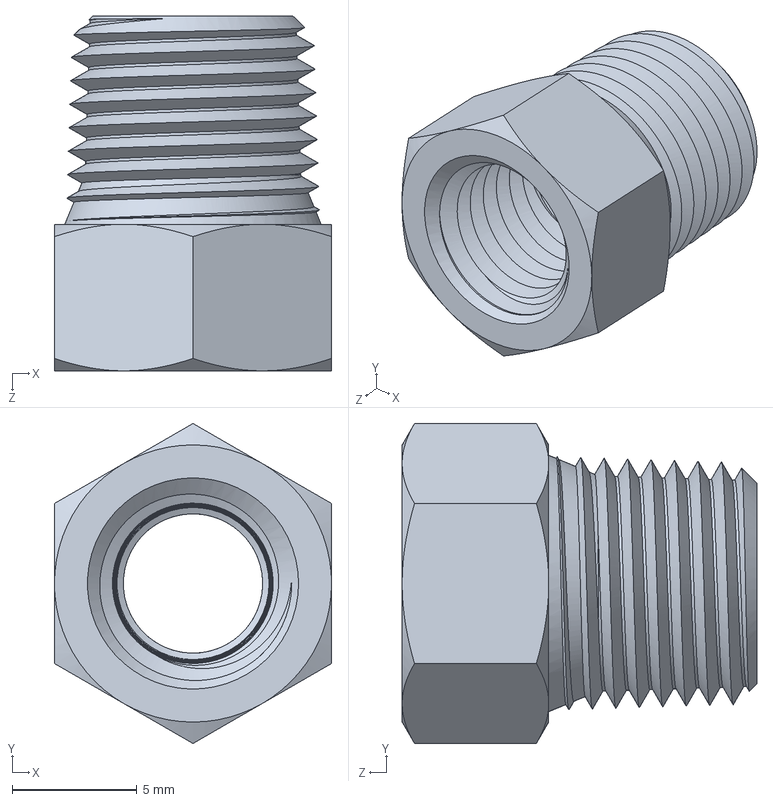
[picture p203: CAD file, 2016-09-20]
Mechanical/General/Pipe Fittings/1_8 NPT.SLDPRT
11.1 x 12.8 x 14.2 mm
