BDR16/svn-migration-dump/Mechanical/General/Socket Heads/Socket 4-40 0.625in.SLDPRT

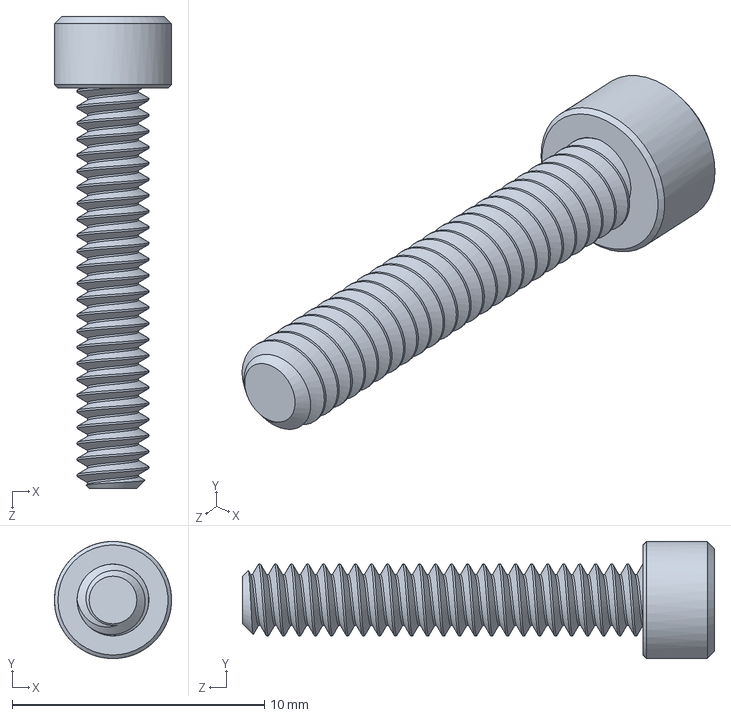
[picture p204: CAD file, 2016-09-20]
Mechanical/General/Socket Heads/Socket 4-40 0.625in.SLDPRT
4.65 x 4.64 x 18.7 mm
