BDR16/svn-migration-dump/Mechanical/Impact Attenuator/Diagonal Tab.SLDPRT

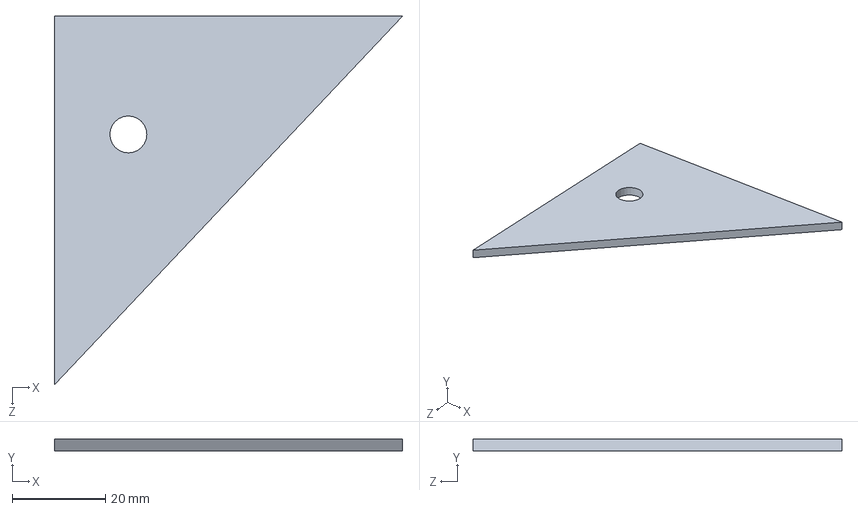
[picture p205: CAD file, 2016-09-20]
Mechanical/Impact Attenuator/Diagonal Tab.SLDPRT
74.8 x 2.54 x 79.2 mm
