BDR16/svn-migration-dump/Mechanical/Pedal Box/Accelerator Pedal/Accelerator Mount.SLDPRT

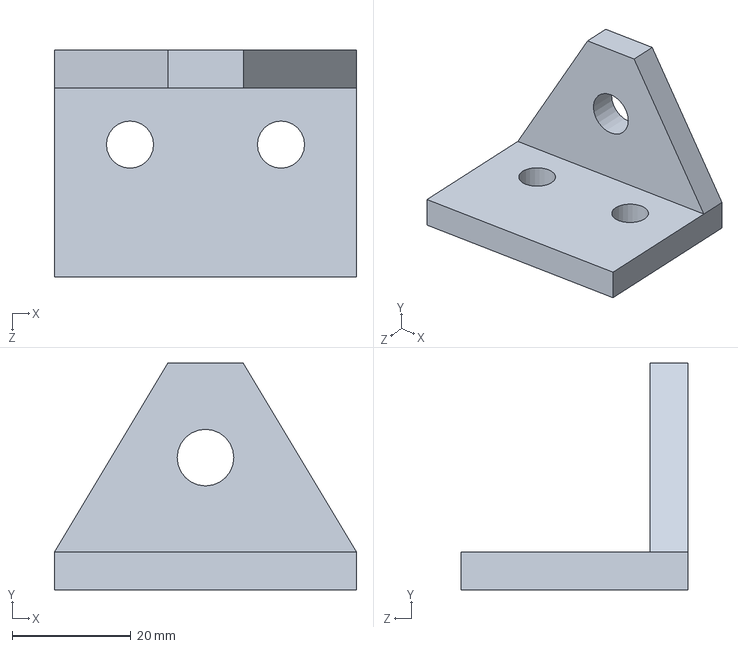
[picture p206: CAD file, 2016-09-20]
Mechanical/Pedal Box/Accelerator Pedal/Accelerator Mount.SLDPRT
50.8 x 38.1 x 38.1 mm
