BDR16/svn-migration-dump/Mechanical/Pedal Box/Balance Bar/DEFAULT-56_2014.sldprt

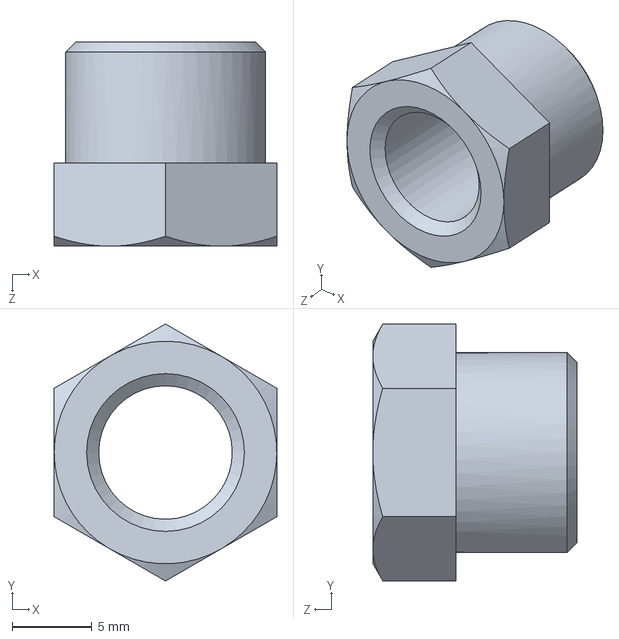
[picture p207: CAD file, 2016-09-20]
Mechanical/Pedal Box/Balance Bar/DEFAULT-56_2014.sldprt
14.0 x 16.1 x 12.8 mm
