BDR16/svn-migration-dump/Mechanical/Pedal Box/Brake Light Switch/Brake Light Switch Mount.SLDPRT

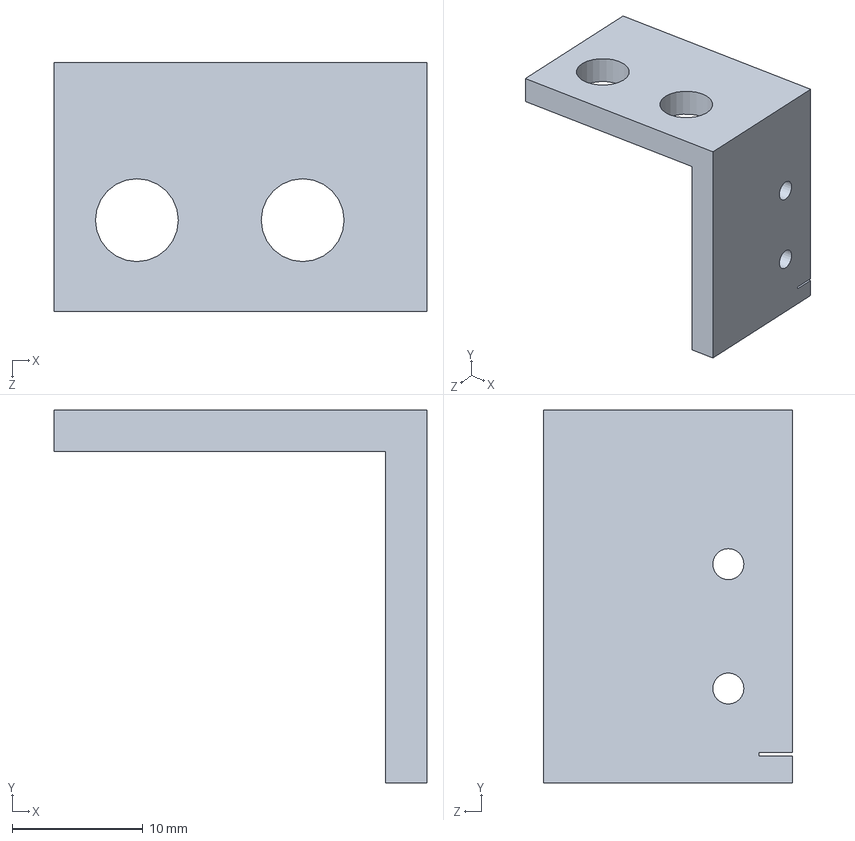
[picture p208: CAD file, 2016-09-20]
Mechanical/Pedal Box/Brake Light Switch/Brake Light Switch Mount.SLDPRT
28.6 x 28.6 x 19.1 mm
