BDR16/svn-migration-dump/Mechanical/Pedal Box/Brake Pedal/Pad Backing.SLDPRT

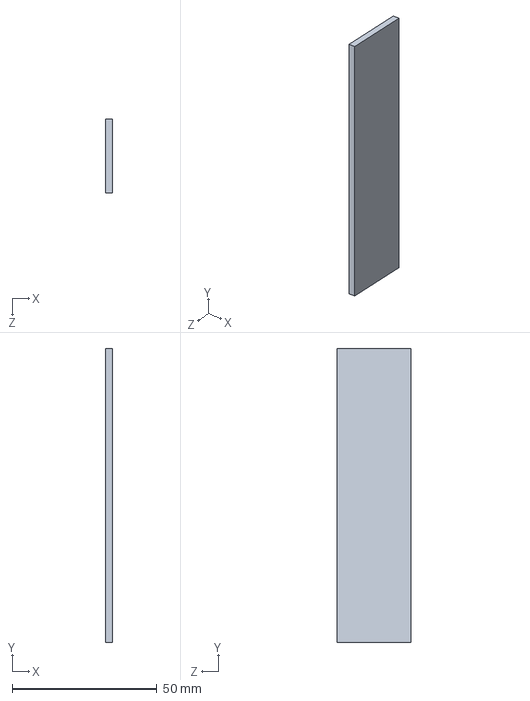
[picture p209: CAD file, 2016-09-20]
Mechanical/Pedal Box/Brake Pedal/Pad Backing.SLDPRT
2.54 x 101.6 x 25.4 mm
