BDR16/svn-migration-dump/Mechanical/Percy/Percy/head.SLDPRT

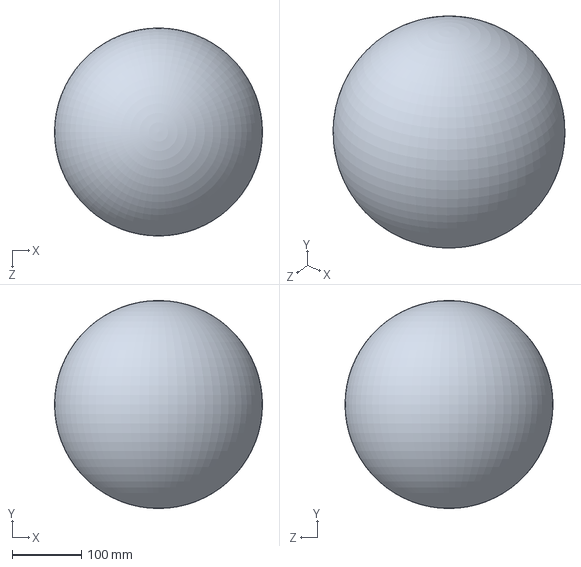
[picture p210: CAD file, 2016-09-20]
Mechanical/Percy/Percy/head.SLDPRT
300.0 x 300.0 x 300.0 mm
