BDR16/svn-migration-dump/Mechanical/Seat/Seat.SLDPRT

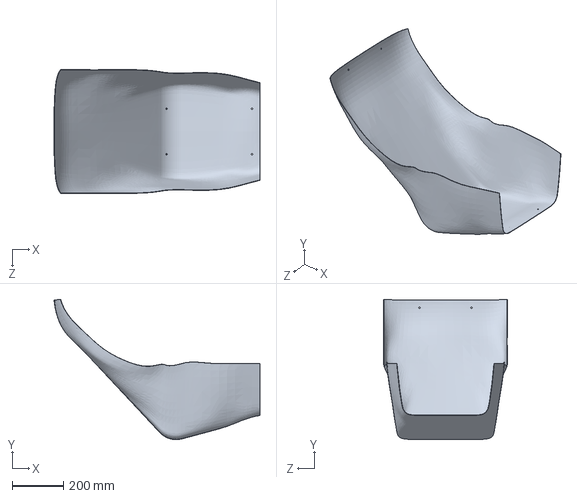
[picture p211: CAD file, 2016-09-20]
Mechanical/Seat/Seat.SLDPRT
804.6 x 547.8 x 483.3 mm
