BDR16/svn-migration-dump/Mechanical/Steering/Bushing Housing.SLDPRT

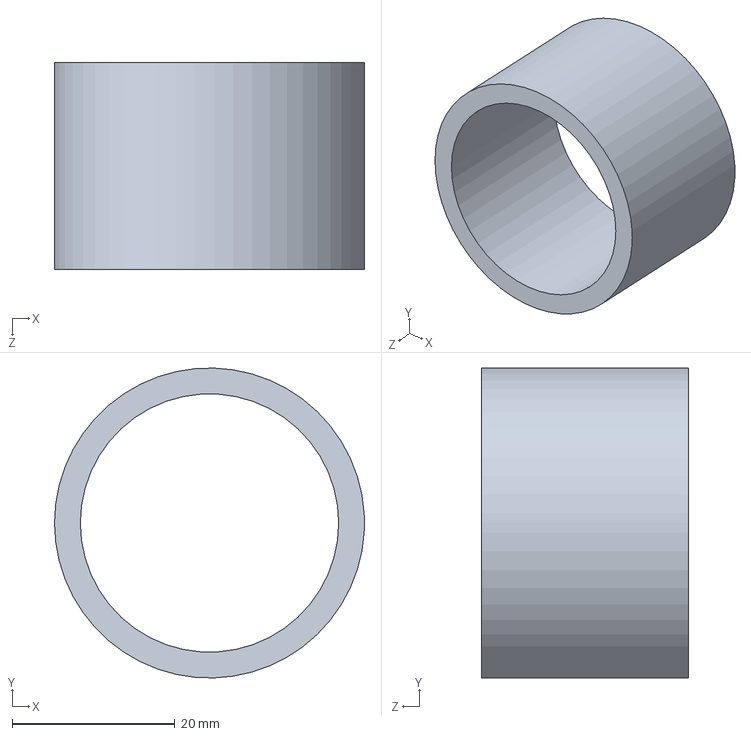
[picture p212: CAD file, 2016-09-20]
Mechanical/Steering/Bushing Housing.SLDPRT
38.1 x 38.1 x 25.4 mm
