BDR16/svn-migration-dump/Mechanical/Steering/Steering Column/U joint cover left half.SLDPRT

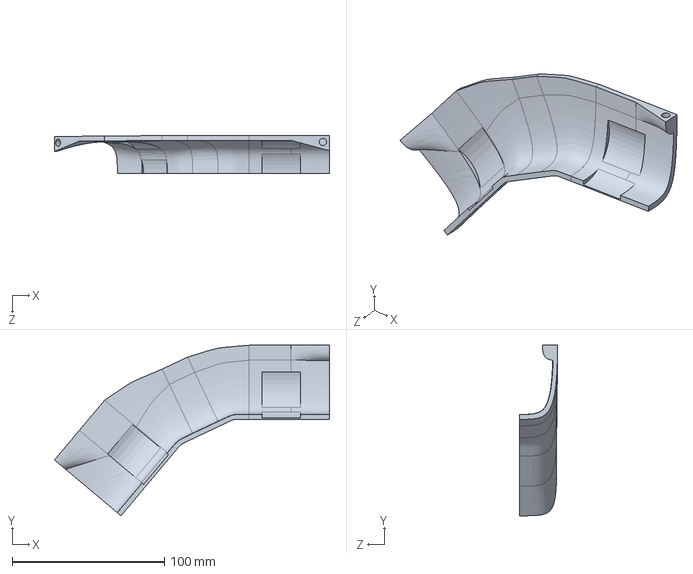
[picture p213: CAD file, 2016-09-20]
Mechanical/Steering/Steering Column/U joint cover left half.SLDPRT
180.9 x 112.2 x 25.0 mm
