BDR16/svn-migration-dump/Mechanical/Steering/Steering Rack Extenders/Steering Rack Extender Right.SLDPRT

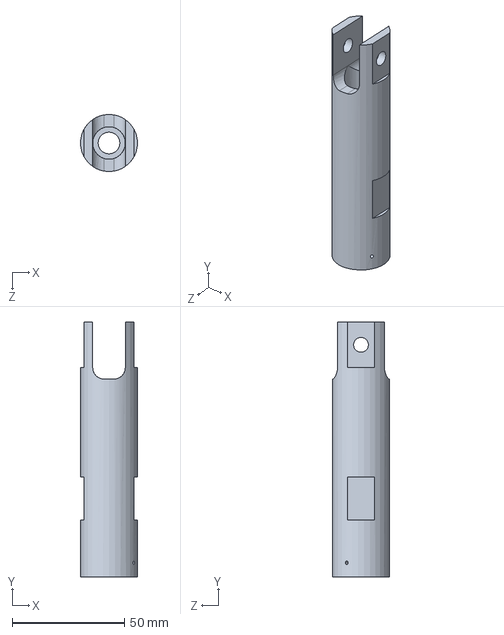
[picture p214: CAD file, 2016-09-20]
Mechanical/Steering/Steering Rack Extenders/Steering Rack Extender Right.SLDPRT
25.3 x 113.4 x 25.4 mm
