BDR16/svn-migration-dump/Mechanical/Steering/Steering Rack/Rack.SLDPRT

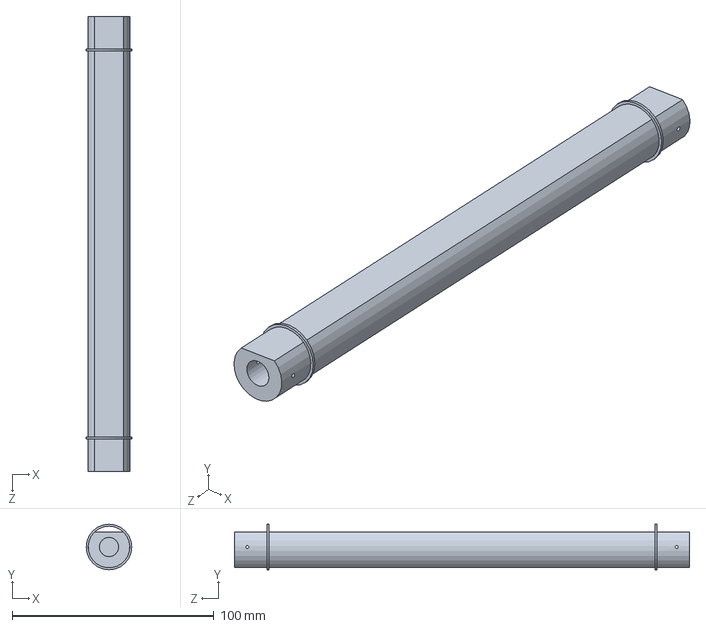
[picture p215: CAD file, 2016-09-20]
Mechanical/Steering/Steering Rack/Rack.SLDPRT
22.6 x 22.6 x 225.4 mm
