BDR16/svn-migration-dump/Mechanical/Tabs and Sheet Metal Parts/Specialty Metal Fabrications/Rear Damper Front Tab.DXF

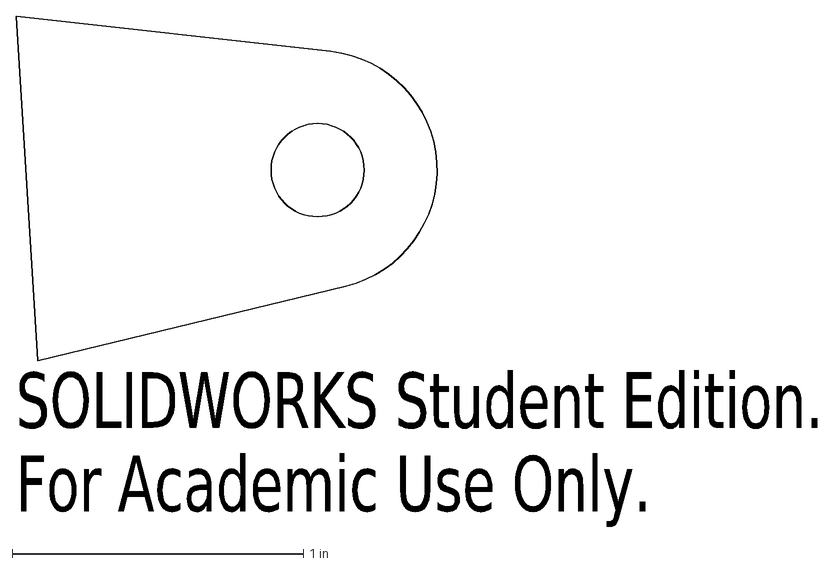
[picture p216: CAD file, 2016-09-20]
Mechanical/Tabs and Sheet Metal Parts/Specialty Metal Fabrications/Rear Damper Front Tab.DXF
SOLIDWORKS Student Edition.
For Academic Use Only.
