BDR16/svn-migration-dump/Mechanical/Templates/Cockpit Opening.SLDPRT

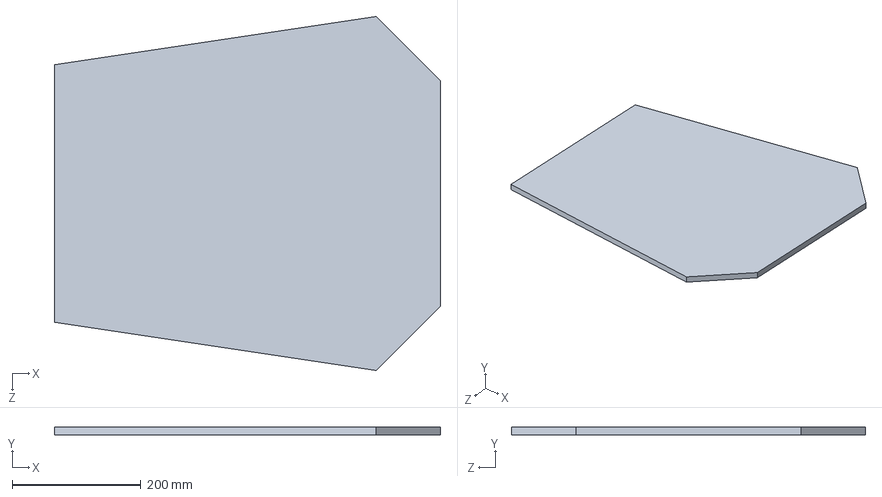
[picture p217: CAD file, 2016-09-20]
Mechanical/Templates/Cockpit Opening.SLDPRT
600.0 x 12.0 x 550.0 mm
