BDR16/svn-migration-dump/Mechanical/Wheel Assemblies/Brakes/Brake Caliper/Brake Pad.SLDPRT

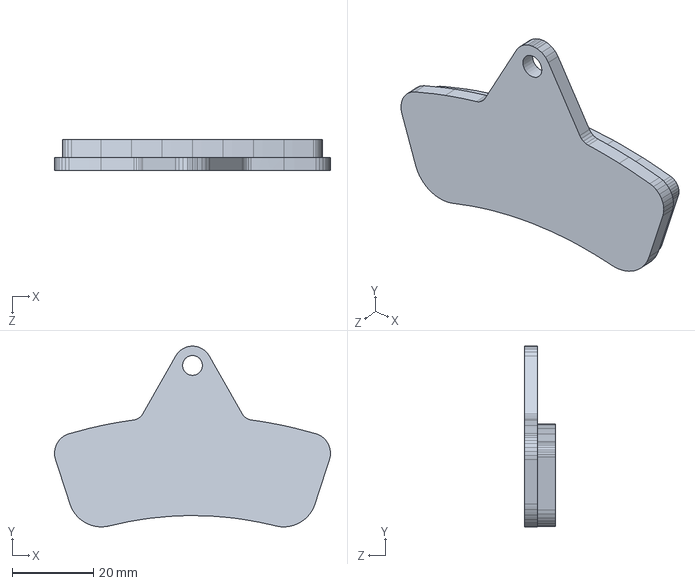
[picture p218: CAD file, 2016-09-20]
Mechanical/Wheel Assemblies/Brakes/Brake Caliper/Brake Pad.SLDPRT
67.9 x 44.5 x 7.60 mm
