BDR16/svn-migration-dump/Mechanical/Wheel Assemblies/Brakes/Brake Rotor.SLDPRT

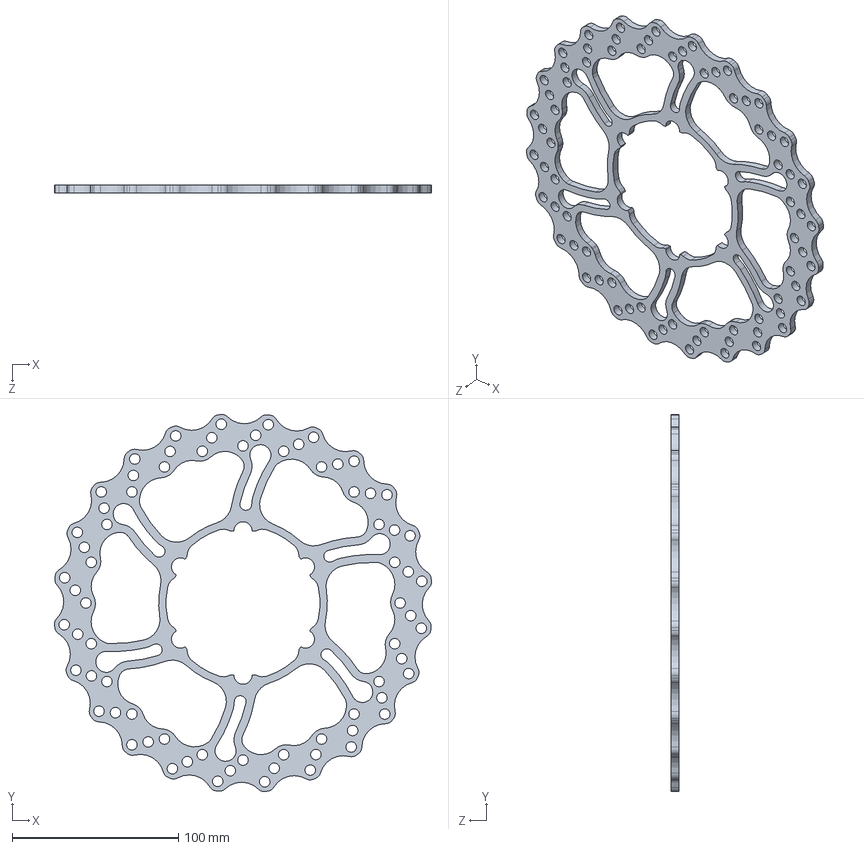
[picture p219: CAD file, 2016-09-20]
Mechanical/Wheel Assemblies/Brakes/Brake Rotor.SLDPRT
227.1 x 227.1 x 4.57 mm
