BDR16/svn-migration-dump/Mechanical/Wheel Assemblies/Hubs/Front Hub.SLDPRT

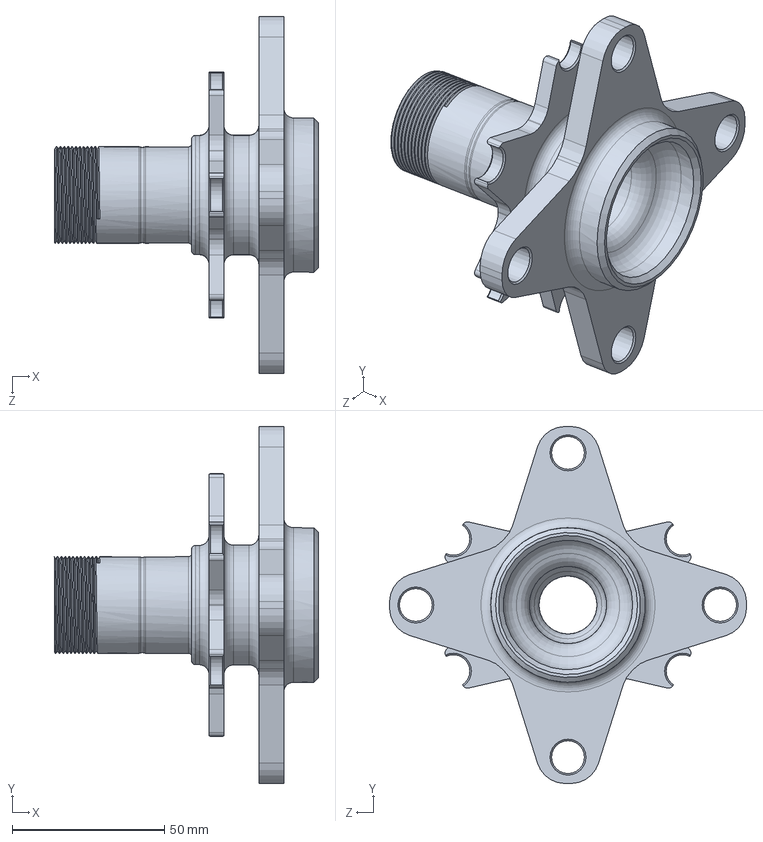
[picture p220: CAD file, 2016-09-20]
Mechanical/Wheel Assemblies/Hubs/Front Hub.SLDPRT
86.9 x 117.3 x 117.3 mm
