BDR16/svn-migration-dump/Mechanical/Wheel Assemblies/Suspension/Bellcranks/Rear Bellcrank.SLDPRT

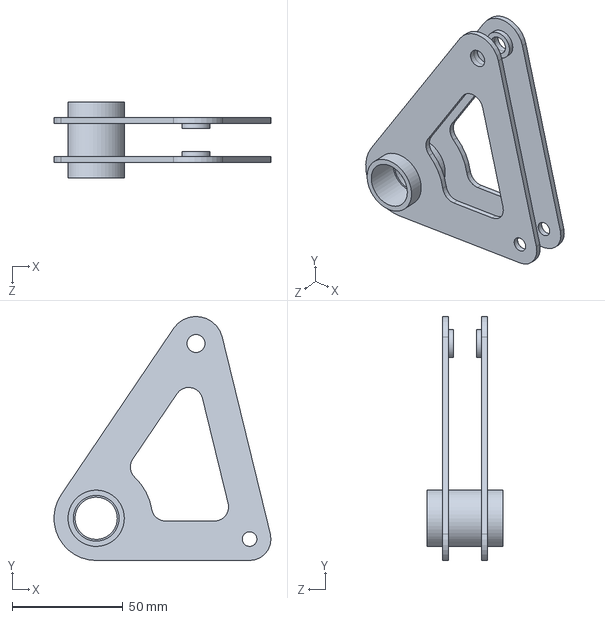
[picture p221: CAD file, 2016-09-20]
Mechanical/Wheel Assemblies/Suspension/Bellcranks/Rear Bellcrank.SLDPRT
97.9 x 110.1 x 34.3 mm
