BDR16/svn-migration-dump/Mechanical/Wheel Assemblies/Suspension/Damper/Quarter Midget Damper Rod.SLDPRT

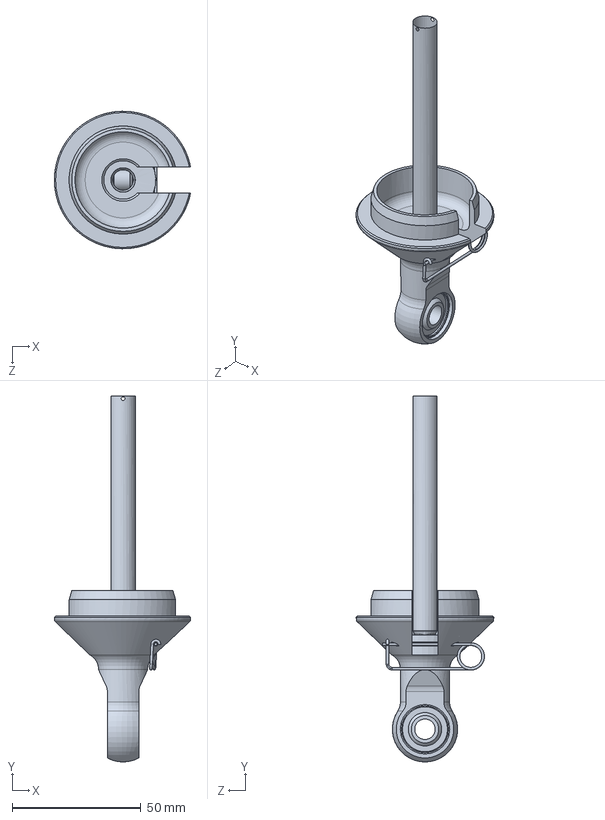
[picture p222: CAD file, 2016-09-20]
Mechanical/Wheel Assemblies/Suspension/Damper/Quarter Midget Damper Rod.SLDPRT
52.9 x 141.9 x 53.3 mm
