BDR16/svn-migration-dump/Mechanical/Wheel Assemblies/Suspension/Members/Pull Rods/Front Pull Rod.SLDPRT

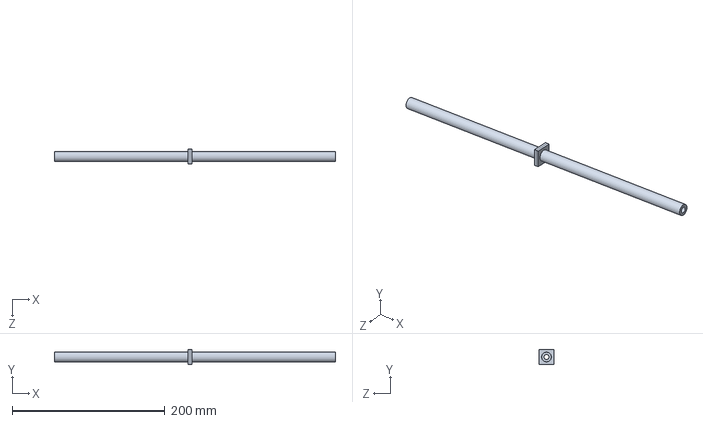
[picture p223: CAD file, 2016-09-20]
Mechanical/Wheel Assemblies/Suspension/Members/Pull Rods/Front Pull Rod.SLDPRT
368.2 x 19.1 x 19.1 mm
