BDR16/svn-migration-dump/Mechanical/Wheel Assemblies/Suspension/Members/Steering and Toe Rods/Front Steering Rod.SLDPRT

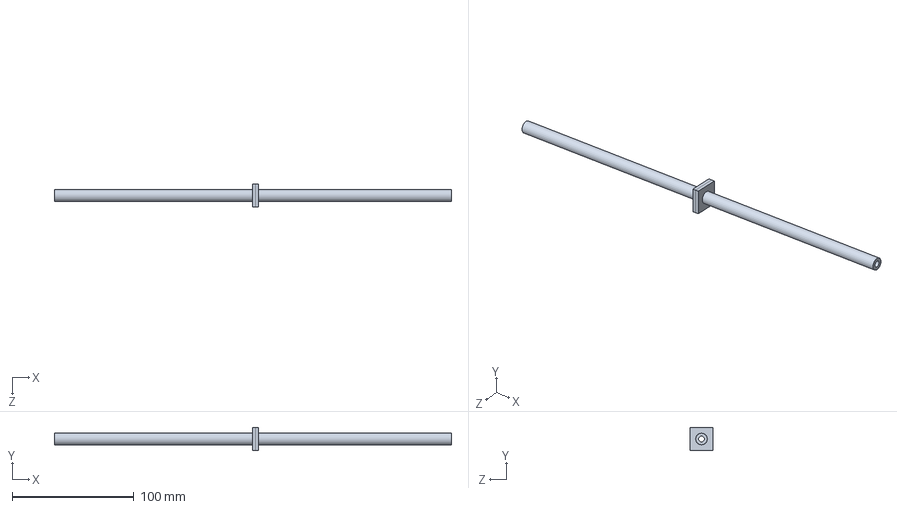
[picture p224: CAD file, 2016-09-20]
Mechanical/Wheel Assemblies/Suspension/Members/Steering and Toe Rods/Front Steering Rod.SLDPRT
326.3 x 19.1 x 19.1 mm
