BDR16/svn-migration-dump/Mechanical/Wheel Assemblies/Suspension/Members/Wishbones/Rear Top Wishbone.SLDPRT

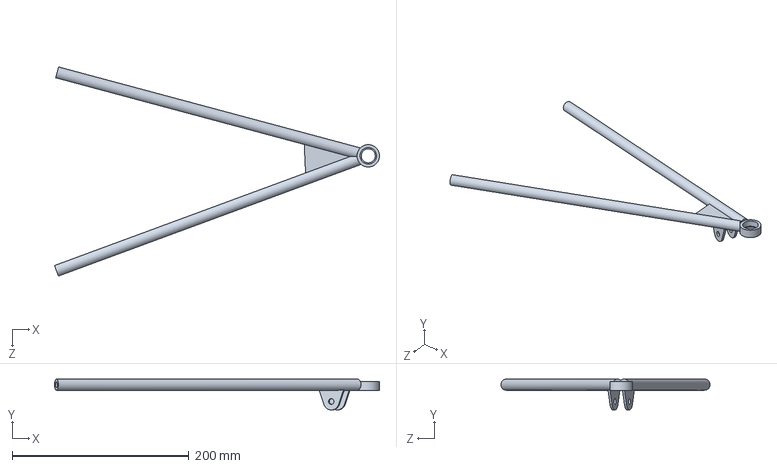
[picture p225: CAD file, 2016-09-20]
Mechanical/Wheel Assemblies/Suspension/Members/Wishbones/Rear Top Wishbone.SLDPRT
367.6 x 35.0 x 236.6 mm
