BDR16/svn-migration-dump/Mechanical/Wheel Assemblies/Suspension/Uprights/CAM/Front Upright Shim CAM.SLDPRT

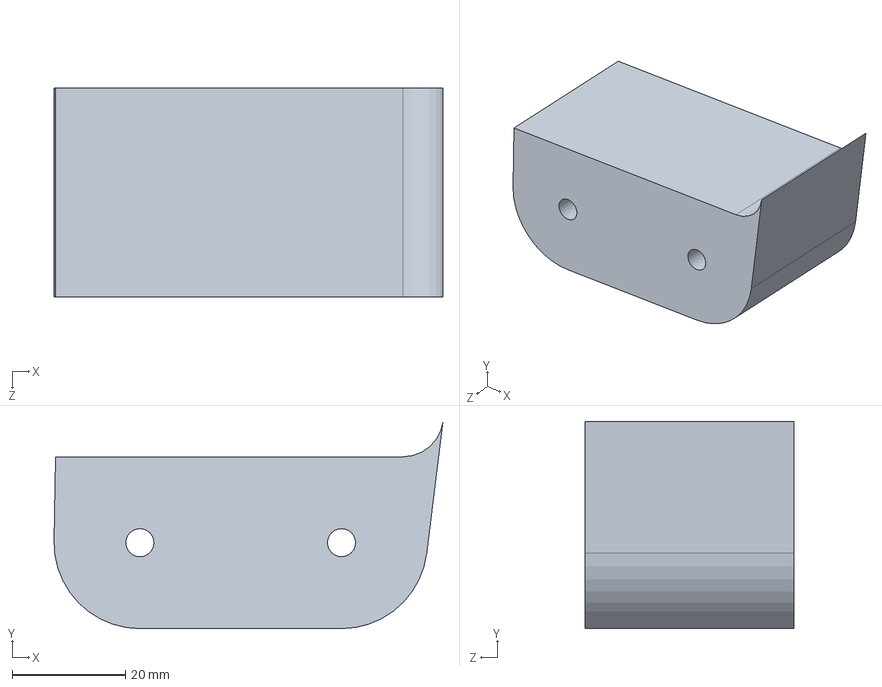
[picture p226: CAD file, 2016-09-20]
Mechanical/Wheel Assemblies/Suspension/Uprights/CAM/Front Upright Shim CAM.SLDPRT
68.6 x 36.5 x 36.8 mm
