BDR16/svn-migration-dump/Mechanical/Wheel Assemblies/Suspension/Uprights/Rear Right Upright.SLDPRT

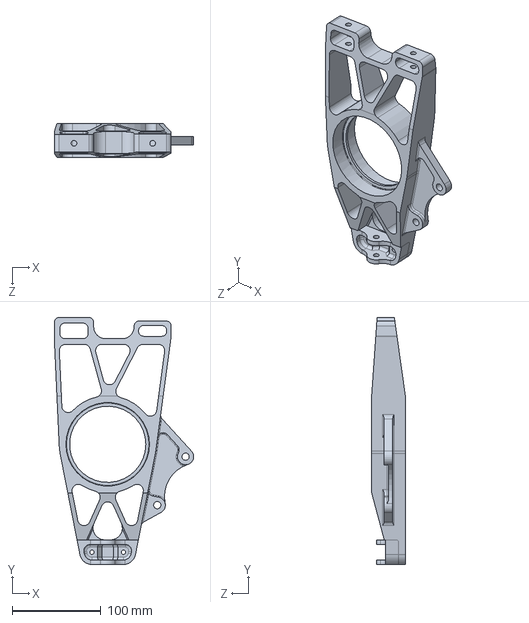
[picture p227: CAD file, 2016-09-20]
Mechanical/Wheel Assemblies/Suspension/Uprights/Rear Right Upright.SLDPRT
157.5 x 279.0 x 38.1 mm
