BDR16/svn-migration-dump/Mechanical/Wheel Assemblies/Wheels/Front Wheel/Front Inner Rim.SLDPRT

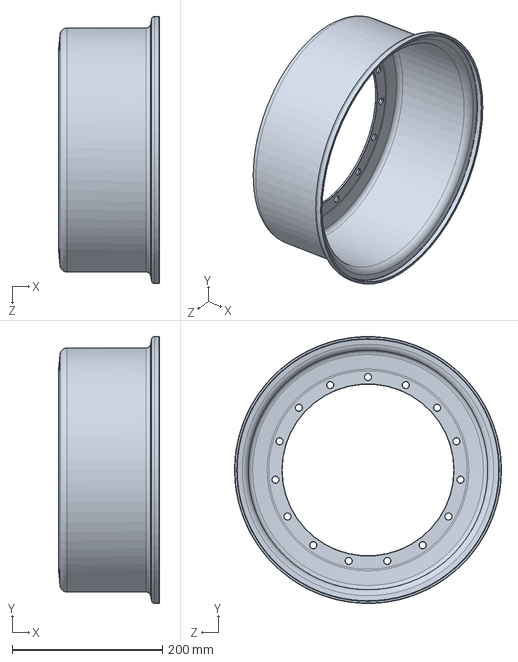
[picture p228: CAD file, 2016-09-20]
Mechanical/Wheel Assemblies/Wheels/Front Wheel/Front Inner Rim.SLDPRT
134.6 x 355.6 x 355.6 mm
