BDR16/svn-migration-dump/Mechanical/Wheel Assemblies/Wheels/Rear Wheel/Rear Outer Rim.SLDPRT

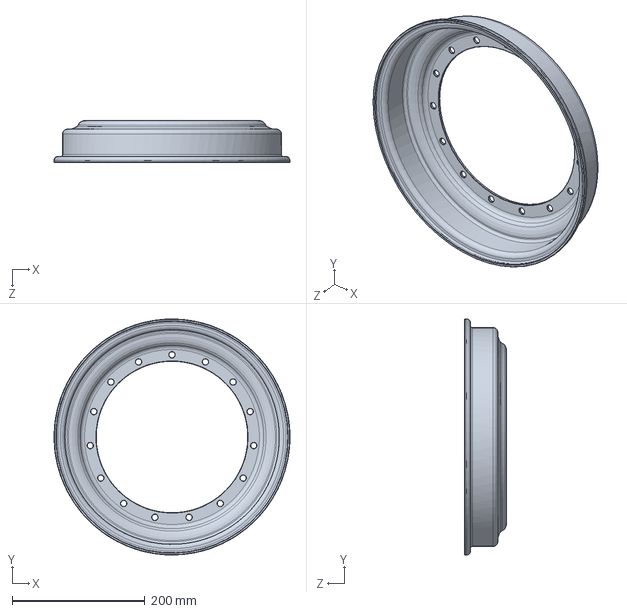
[picture p229: CAD file, 2016-09-20]
Mechanical/Wheel Assemblies/Wheels/Rear Wheel/Rear Outer Rim.SLDPRT
355.6 x 355.5 x 62.9 mm
