BDR16/svn-migration-dump/Mechanical/Wheel Assemblies/Wheels/Tires/Rear Tire.SLDPRT

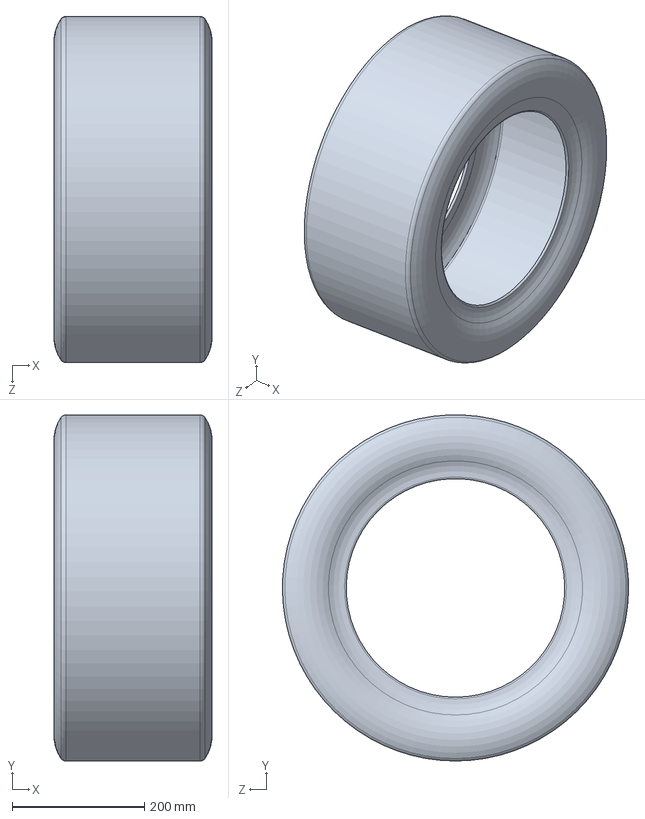
[picture p230: CAD file, 2016-09-20]
Mechanical/Wheel Assemblies/Wheels/Tires/Rear Tire.SLDPRT
238.4 x 523.0 x 523.1 mm
