BDR16/svn-migration-dump/Mechanical/Accumulator/Accumulator Box.SLDPRT

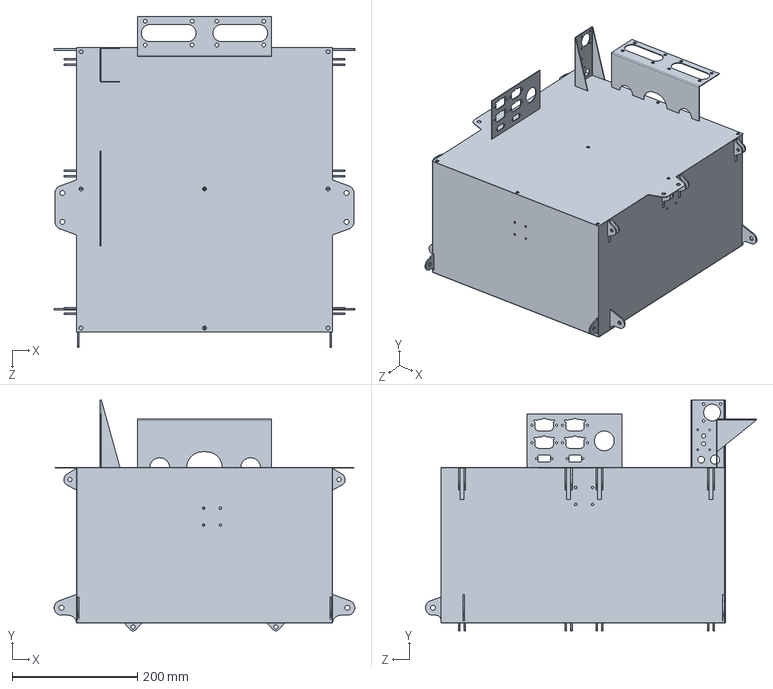
[picture p231: CAD file, 2016-09-20]
Mechanical/Accumulator/Accumulator Box.SLDPRT
481.0 x 369.1 x 529.5 mm
