BDR16/svn-migration-dump/Mechanical/Accumulator/Battery Management System/Cell Boards/Cell Board Middle.SLDPRT

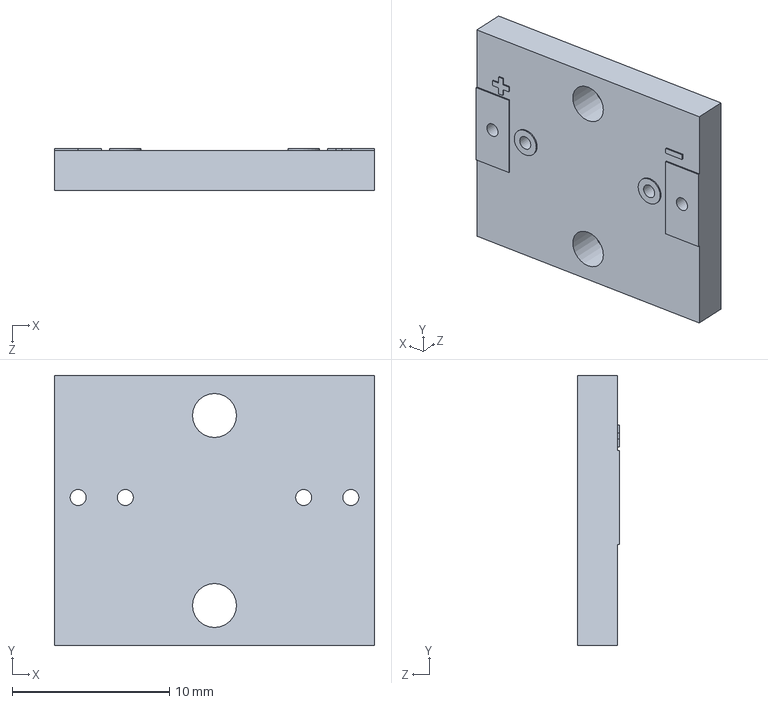
[picture p232: CAD file, 2016-09-20]
Mechanical/Accumulator/Battery Management System/Cell Boards/Cell Board Middle.SLDPRT
20.3 x 17.1 x 2.64 mm
