BDR16/svn-migration-dump/Mechanical/Accumulator/Connectors/Amphenol Triple PowerLok/Amphenol Triple PowerLok Receptacle.SLDPRT

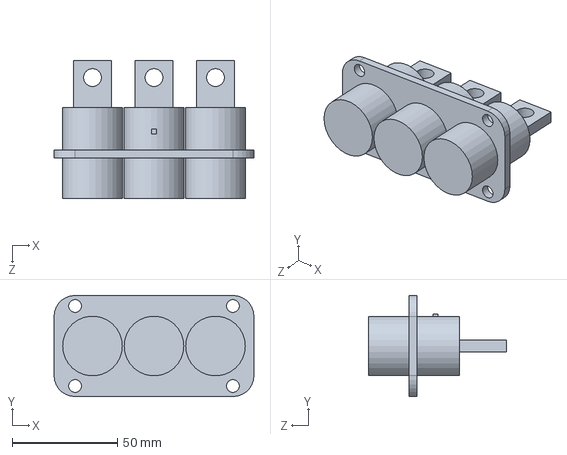
[picture p233: CAD file, 2016-09-20]
Mechanical/Accumulator/Connectors/Amphenol Triple PowerLok/Amphenol Triple PowerLok Receptacle.SLDPRT
95.0 x 48.0 x 65.3 mm
