BDR16/svn-migration-dump/Mechanical/Pedal Box/Potentiometers/Potentiometer.SLDASM

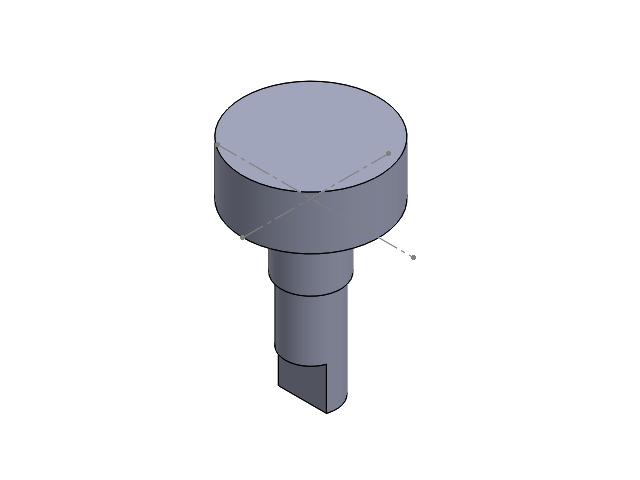
[picture p234: CAD file, 2016-09-20]
Mechanical/Pedal Box/Potentiometers/Potentiometer.SLDASM
Key
Casing
