BDR16/svn-migration-dump/(list of files, cad)

Other CAD files:
Mechanical/Accumulator/Battery Management System/BMS Controller/Lithiumate Pro Controller/1590J Lid - Modified.sldasm
Mechanical/Accumulator/Battery Management System/BMS Controller/BMS Controller Board.sldasm
Mechanical/Drivetrain/Tripod/Taylor INV-02002011.SLDASM
Mechanical/Accumulator/HV Control/AMS/1590J Lid - Modified.sldasm
Mechanical/BBB/BBB.SLDASM
Mechanical/Percy/Percy/PercyAssemble.SLDASM
Mechanical/Accumulator/HV Control/AMS/Lithiumate Board Assy.sldasm
Mechanical/Accumulator/HV Control/AMS/AMS.SLDASM
Mechanical/Accumulator/HV Control/AMS/1590J Lid.sldprt
Mechanical/Drivetrain/Gaskets/Nitrile Gasket.SLDPRT
Mechanical/Drivetrain/Motor/Emrax 207/25.sldprt
Mechanical/Drivetrain/Motor/Resolver Plate.sldprt
Mechanical/Wheel Assemblies/Suspension/Members/Bearings and Rod Ends/HXAM-4T Rod End/HXAM-4T Housing.SLDPRT
Mechanical/Wheel Assemblies/Suspension/Members/Wishbones/Wishbone Geometry/Rear Wishbone Geometry.SLDPRT
Mechanical/Accumulator/Battery Management System/BMS Controller/Lithiumate Pro Controller/Lithiumate Board.sldprt
Mechanical/Accumulator/Charging/Charging Board.SLDPRT
Mechanical/Accumulator/Covers/LV Cover.sldprt
Mechanical/Accumulator/HV Control/AMS/NorComp 171-009-213.sldprt
Administration/Competition Forms/Formula Hybrid/SES/Chassis Drawings.SLDDRW
Mechanical/Accumulator/Accumulator Box HV HC Panel CAM.SLDPRT
Mechanical/Accumulator/Accumulator Box LV Panel CAM.SLDPRT
Mechanical/Accumulator/Battery Management System/BMS Controller/Lithiumate Pro Controller/1590J Lid.sldprt
Mechanical/Accumulator/Battery Management System/BMS Controller/Lithiumate Pro Controller/1590JF Box.sldprt
Mechanical/Accumulator/Battery Management System/BMS Controller/Lithiumate Pro Controller/Molex 039281163.sldprt
Mechanical/Accumulator/Battery Management System/BMS Controller/Lithiumate Pro Controller/Molex 705430001.sldprt
Mechanical/Accumulator/Battery Management System/BMS Controller/Lithiumate Pro Controller/Molex 705430003.sldprt
Mechanical/Accumulator/Battery Management System/BMS Controller/Lithiumate Pro Controller/Molex 705430004.sldprt
Mechanical/Accumulator/Battery Management System/BMS Controller/Lithiumate Pro Controller/NorComp 171-009-213.sldprt
Mechanical/Accumulator/Battery Management System/BMS Controller/Lithiumate Pro Controller/PEM FHS-440-4ZI.sldprt
Mechanical/Accumulator/Charging/Charging Box.SLDPRT
Mechanical/Accumulator/Covers/Back Cover.SLDPRT
Mechanical/Accumulator/Covers/Bottom Seal.SLDPRT
Mechanical/Accumulator/Covers/Top Cover.SLDPRT
Mechanical/Accumulator/HV Control/AMS/1590JF Box.sldprt
Mechanical/Accumulator/HV Control/AMS/Lithiumate Board.sldprt
Mechanical/Accumulator/HV Control/AMS/Molex 039281163.sldprt
Mechanical/Accumulator/HV Control/AMS/Molex 705430001.sldprt
Mechanical/Accumulator/HV Control/AMS/Molex 705430003.sldprt
Mechanical/Accumulator/HV Control/AMS/Molex 705430004.sldprt
Mechanical/Accumulator/HV Control/AMS/PEM FHS-440-4ZI.sldprt
Mechanical/Accumulator/HV Control/Board.sldprt
Mechanical/Accumulator/HV Control/Bus Bars/HV Fuse to Positive AIR.SLDPRT
Mechanical/Accumulator/HV Control/Bus Bars/HVD to Negative Stack.SLDPRT
Mechanical/Accumulator/HV Control/Bus Bars/MC Negative.SLDPRT
Mechanical/Accumulator/HV Control/Bus Bars/Positive Stack to HV Fuse.SLDPRT
Mechanical/Accumulator/HV Control/Contactor.SLDPRT
Mechanical/Accumulator/HV Control/Current Sensor/Current Sensor.SLDPRT
Mechanical/Accumulator/HV Control/End End Bus Bar.SLDPRT
Mechanical/Accumulator/HV Control/End Lug Connector.SLDPRT
Mechanical/Accumulator/HV Control/End Middle Bus Bar.SLDPRT
Mechanical/Accumulator/HV Control/Energy Meter.SLDPRT
Mechanical/Accumulator/HV Control/HV Fusing/HV Fuse.SLDPRT
Mechanical/Accumulator/HV Control/HV Fusing/HV Fuseholder Plate.SLDPRT
Mechanical/Accumulator/HV Control/High Voltage Disconnect.SLDPRT
Mechanical/Accumulator/HV Control/IMD Mounting Bracket - otherside.SLDPRT
Mechanical/Accumulator/HV Control/IMD Mounting Bracket.SLDPRT
Mechanical/Accumulator/HV Control/IMD.SLDPRT
Mechanical/Accumulator/HV Control/PowerLok Connector.SLDPRT
Mechanical/Accumulator/HV Control/PowerLok Receptacle.SLDPRT
Mechanical/Accumulator/HV Control/Precharge Relay.SLDPRT
Mechanical/Accumulator/Motor Controller/Bamocar Board.SLDPRT
Mechanical/Accumulator/Motor Controller/Bamocar Box.SLDPRT
Mechanical/Accumulator/Motor Controller/Control Board Mount.SLDPRT
Mechanical/Accumulator/Motor Controller/Current Shunt Bent Shorter.SLDPRT
Mechanical/Accumulator/Motor Controller/Current Shunt Bent.SLDPRT
Mechanical/Accumulator/Motor Controller/Current Shunt Cover.SLDPRT
Mechanical/Accumulator/Motor Controller/Current Shunt.SLDPRT
Mechanical/Accumulator/Motor Controller/Current Tab T.SLDPRT
Mechanical/Accumulator/Motor Controller/Left Side End Bus Bar.SLDPRT
Mechanical/Accumulator/Motor Controller/Left Side Middle Bus Bar.SLDPRT
Mechanical/Accumulator/Motor Controller/Motor Controller Board/Capacitor Board.SLDPRT
Mechanical/Accumulator/Motor Controller/Motor Controller Board/Control Board.SLDPRT
Mechanical/Accumulator/Motor Controller/Motor Controller Board/Current Shunt Tab.SLDPRT
Mechanical/Accumulator/Motor Controller/Motor Controller Board/HV Board.SLDPRT
Mechanical/Accumulator/Motor Controller/Motor Controller Board/IGBT.SLDPRT
Mechanical/Accumulator/Motor Controller/Pfisterer Elbow.SLDPRT
Mechanical/Accumulator/Motor Controller/Right Side End Bus Bar.SLDPRT
Mechanical/Accumulator/Stacks/Cells/A123 Amp20 Old.SLDPRT
Mechanical/Accumulator/Stacks/Cells/Cell Tab Config A Negative End.SLDPRT
Mechanical/Accumulator/Stacks/Cells/Cell Tab Config A.SLDPRT
Mechanical/Accumulator/Stacks/Cells/Cell Tab Config B Negative End.SLDPRT
Mechanical/Accumulator/Stacks/Cells/Cell Tab Config B Positive End.SLDPRT
Mechanical/Accumulator/Stacks/Cells/Cell Tab Config B.SLDPRT
Mechanical/Accumulator/Stacks/Cells/Cell.SLDPRT
Mechanical/Accumulator/Stacks/Stack Parts/Expansion Limiter/Cell Load Spreader.SLDPRT
Mechanical/Accumulator/Stacks/Stack Parts/Expansion Limiter/Even Threaded Rod.SLDPRT
Mechanical/Accumulator/Stacks/Stack Parts/Expansion Limiter/Odd Threaded Rod.SLDPRT
Mechanical/Accumulator/Stacks/Stack Parts/Insulation Film/Insulation Film Back.SLDPRT
Mechanical/Accumulator/Stacks/Stack Parts/Insulation Film/Insulation Film End.SLDPRT
Mechanical/Accumulator/Stacks/Stack Parts/Insulation Film/Insulation Film Half.SLDPRT
Mechanical/Accumulator/Stacks/Stack Parts/Repeating Frame/Repeating Frame Inner.SLDPRT
Mechanical/Accumulator/Stacks/Stack Parts/Tab Cover/ASTM D149 IEC 60243 Specimen.SLDPRT
Mechanical/Accumulator/Stacks/Stack Parts/Tab Cover/Tab Cover Odd.SLDPRT
Mechanical/Accumulator/Stacks/Stack Parts/Tab Cover/Tab Cover Sixer.SLDPRT
Mechanical/Accumulator/Stacks/Stack Parts/Tab Cover/UL94 Specimen.SLDPRT
Mechanical/Accumulator/Stacks/Stack Parts/Tab Load Spreader.SLDDRW
Mechanical/Accumulator/Stacks/Thermal Simulation/Solidworks Model/Negative Layer.SLDPRT
Mechanical/Accumulator/Stacks/Thermal Simulation/Solidworks Model/Positive Layer.SLDPRT
Mechanical/Accumulator/Water Block/Pipe Press Test.SLDPRT
Mechanical/BBB/BBB Board.SLDPRT
Mechanical/Chassis/Tabs/Extra Tab.SLDPRT
Mechanical/Chassis/Tabs/Planetary Outer Tabs.sldprt
Mechanical/Chassis/Tabs/Tab 55.sldprt
Mechanical/Chassis/Tabs/Tab 56.sldprt
Mechanical/Chassis/Tabs/Tab 57.sldprt
Mechanical/Chassis/Tabs/Tab 58.sldprt
Mechanical/Chassis/Tabs/Tab 59.sldprt
Mechanical/Chassis/Tabs/Tab 60.sldprt
Mechanical/Chassis/Tabs/Tab 61.sldprt
Mechanical/Chassis/Tabs/Tab 62.sldprt
Mechanical/Chassis/Tabs/Tab 63.sldprt
Mechanical/Chassis/Tabs/Tab 64.sldprt
Mechanical/Chassis/Tabs/Tab 65.sldprt
Mechanical/Chassis/Tabs/Tab 66.sldprt
Mechanical/Chassis/Tabs/Tab 67.sldprt
Mechanical/Chassis/Tabs/Tab 68.sldprt
Mechanical/Chassis/Tabs/Tab 69.sldprt
Mechanical/Chassis/Tabs/Tab 71.sldprt
Mechanical/Chassis/Tabs/Tab 73.sldprt
Mechanical/Chassis/Tabs/Tab 75 (76 on cut list).sldprt
Mechanical/Chassis/Tabs/Tabs_Bulldogs_Racing_Rev02.DXF
Mechanical/Chassis/Tabs/Tabs_Bulldogs_Racing_Rev02.SLDDRW
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
