BDR16/svn-migration-dump/Mechanical/Wheel Assemblies/Suspension/Statics Analysis.xls

Sheet: Front
Geometry
 | x (mm) | y (mm) | z (mm)
Lower WB Front Pivot | 101.6 | 193.675 | -139.7
Lower WB Rear Pivot | -177.8 | 193.675 | -139.7
Lower WB Outer Ball Joint | -9.7688 | 605.0001 | -139.7
Upper WB Front Pivot | 101.6 | 279.4 | -342.9
Upper WB Rear Pivot | -177.8 | 279.4 | -342.9
Upper WB Outer Ball Joint | -26.9002 | 602.8614 | -384.6906
Inner Steering Link Ball Joint | 50 | 203.217 | -162.3183
Outer Steering Link Ball Joint | 83.6262 | 605.0001 | -166.37
Pull Rod WB End | -26.9002 | 567.5164 | -360.9067
Pull Rod Rocker End | 104.4271 | 197.446 | -159.0234
Tire Contact Patch Center | 0 | 629.245 | 0
Tube Lengths
Lower WB Front Length (mm) | 426.14
Lower WB Rear Length (mm) | 444.32
Upper WB Front Length (mm) | 350.55
Upper WB Rear Length (mm) | 359.37
Steering Link Length (mm) | 403.21
Pull Rod Length (mm) | 441.54
Calculation Using AX = B
A Matrix | Lower WB Front | Lower WB Rear | Upper WB Front | Upper WB Rear | Steering Link | Pull Rod
Fx (N) | 0.26 | -0.38 | 0.37 | -0.42 | -0.08 | 0.30
Fy (N) | -0.97 | -0.93 | -0.92 | -0.90 | -1.00 | -0.84
Fz (N) | 0.00 | 0.00 | 0.12 | 0.12 | 0.01 | 0.46
Mx (Nm) | -0.13 | -0.13 | -0.28 | -0.28 | -0.16 | -0.04
My (Nm) | 0.04 | -0.05 | 0.14 | -0.16 | -0.01 | 0.10
Mz (Nm) | 0.15 | -0.24 | 0.20 | -0.28 | 0.03 | 0.15
B Matrix | Load Case | 3g bump, 2g turn | 3g bump, 2g accel | 3g bump, 2*cos(45)g turn, 2*cos(45)g accel
Fx (N) | 1248.61 | 0 | 1765.8 | 1248.61
Fy (N) | -1248.61 | 1765.8 | 0 | 1248.61
Fz (N) | 3424.39 | 3271.01 | 3123.38 | 3424.39
Mx (Nm) | 2154.78
My (Nm) | 0.00
Mz (Nm) | 785.68
Inverse of A
5.17 | -0.96 | -2.10 | 2.71 | -6.27 | -4.57
0.75 | -0.67 | -1.15 | 2.10 | 6.44 | -5.35
-0.29 | 0.51 | -0.06 | -3.58 | 5.12 | -0.71
1.13 | 0.31 | 0.93 | -2.16 | -5.26 | -0.65
-6.40 | -0.02 | 0.67 | -0.57 | 0.09 | 10.55
-0.07 | -0.21 | 1.95 | 1.50 | 0.001037911256 | 0.12
Output
Tube Properties
Modulus of Elasticity (Gpa) | 205
Tube Wall Thickness (in) | 0.12
Tube OD (in) | 0.5
Second Moment of Area (m^4) | 2.367227997e-09
Effective Length Factor | 0.70
X = Inverse(A) * B | Force (N) | Compression (N) | Length (m) | Tube Critical Force (N) | Tube Safety Factor
Lower WB Front (N) | 2713.52 | 2713.52 | 0.43 | 53981.41 | 19.89
Lower WB Rear (N) | -1831.48 | 0.00 | 0.44 | 49652.60 | #DIV/0!
Upper WB Front (N) | -9461.00 | 0.00 | 0.35 | 79769.49 | #DIV/0!
Upper WB Rear (N) | -968.79 | 0.00 | 0.36 | 75903.80 | #DIV/0!
Steering Link (N) | 1406.37 | 1406.37 | 0.40 | 60294.93 | 42.87
Pull Rod (N) | 10171.75 | 10171.75 | 0.44 | 50280.91 | 4.94
Note that positive is tension and negative is compression
Bolt Properties
Bolt Diameter (in) | 0.25
Tensile Strength (psi) | 170000
Shear Strength Mult | 0.6
Shear Strength (psi) | 102000
Critical Force (N) | 44543.70368
Safety Factor | 4.379159636
Inboard Rod Ends
Name | HXAM-4T, HXAB-4T
Ball Bore (in) | 0.25
Ball Width (in) | 0.593
Head Diameter (in) | 1.025
Misalignment (deg) | 23
Static Radial Load Capacity (lbf) | 10789
Safety Factor | 4.71815174
Outboard Spherical Bearings
Name | HAB-4T
Ball Bore (in) | 0.25
Ball Width (in) | 0.593
Outside Diameter (in) | 0.74
Misalignment (deg) | 24
Static Radial Load Capacity (lbf) | 7560
Safety Factor | 3.306073515

Sheet: Rear
Geometry
 | x (mm) | y (mm) | z (mm)
Lower WB Front Pivot | -1409.7 | 25.4 | -139.7
Lower WB Rear Pivot | -1651 | 25.4 | -139.7
Lower WB Outer Ball Joint | -1549.4 | 565.8543 | -139.7
Upper WB Front Pivot | -1409.7 | 177.8 | -346.71
Upper WB Rear Pivot | -1651 | 177.8 | -346.71
Upper WB Outer Ball Joint | -1511.3 | 568.3961 | -389.6614
Inner Toe Link Ball Joint | -1651 | 177.8 | -346.71
Outer Toe Link Ball Joint | -1600.2 | 568.3961 | -389.6614
Pull Rod WB End | -1511.3 | 525.4656 | -366.4882
Pull Rod Rocker End | -1431.3596 | 318.4258 | -41.3055
Tire Contact Patch Center | -1549.4 | 591.145 | 0
Tube Lengths
Lower WB Front Length (mm) | 558.22
Lower WB Rear Length (mm) | 549.92
Upper WB Front Length (mm) | 405.87
Upper WB Rear Length (mm) | 417.04
Toe Link Length (mm) | 396.22
Pull Rod Length (mm) | 393.70
Calculation Using AX = B
A Matrix | Lower WB Front | Lower WB Rear | Upper WB Front | Upper WB Rear | Toe Link | Pull Rod
Fx (N) | 0.25 | -0.18 | 0.25 | -0.33 | -0.13 | 0.20
Fy (N) | -0.97 | -0.98 | -0.96 | -0.94 | -0.99 | -0.53
Fz (N) | 0.00 | 0.00 | 0.11 | 0.10 | 0.11 | 0.83
Mx (Nm) | -0.14 | -0.14 | -0.31 | -0.31 | -0.32 | 0.24
My (Nm) | 0.03 | -0.03 | -0.06 | -0.29 | -0.22 | -1.17
Mz (Nm) | -1.36 | -1.63 | -1.31 | -1.61 | -1.65 | -0.69
B Matrix | Load Case | 3g bump, 2g turn | 3g bump, 2g accel | 3g bump, 2*cos(45)g turn, 2*cos(45)g accel
Fx (N) | 1248.61 | 0 | 1765.8 | 1248.61
Fy (N) | -1248.61 | 1765.8 | 0 | 1248.61
Fz (N) | 3424.39 | 3271.01 | 3123.38 | 3424.39
Mx (Nm) | 2024.31
My (Nm) | -5305.75
Mz (Nm) | -1196.49
Inverse of A
3.03 | -2.28 | -15.07 | 1.90 | -9.27 | 1.02
-2.99 | 0.65 | 12.63 | 2.25 | 9.13 | -1.00
-2.96 | -5.22 | 10.54 | -2.23 | 6.69 | 3.57
-3.75 | -12.88 | -10.14 | -0.44 | -7.00 | 8.36
6.45 | 17.95 | 1.03 | -1.82 | 0.12 | -11.42
-6.866109748e-18 | -0.08 | 0.99 | 0.58 | -1.70579914e-17 | 2.059832924e-17
Output
Tube Properties
Modulus of Elasticity (Gpa) | 205
Tube Wall Thickness (in) | 0.12
Tube OD (in) | 0.5
Second Moment of Area (m^4) | 2.367227997e-09
Effective Length Factor | 0.70
X = Inverse(A) * B | Force (N) | Compression (N) | Length (m) | Tube Critical Force (N) | Tube Safety Factor
Lower WB Front (N) | 6810.68 | 6810.68 | 0.56 | 31458.08 | 4.62
Lower WB Rear (N) | -3969.89 | 0.00 | 0.55 | 32414.42 | #DIV/0!
Upper WB Front (N) | -5376.92 | 0.00 | 0.41 | 59505.83 | #DIV/0!
Upper WB Rear (N) | 2928.76 | 2928.76 | 0.42 | 56360.43 | 19.24
Toe Link (N) | -1486.48 | 0.00 | 0.40 | 62440.33 | #DIV/0!
Pull Rod (N) | 4664.73 | 4664.73 | 0.39 | 63242.41 | 13.56
Note that positive is tension and negative is compression
Bolt Properties
Bolt Diameter (in) | 0.25
Tensile Strength (psi) | 170000
Shear Strength Mult | 0.6
Shear Strength (psi) | 102000
Critical Force (N) | 44543.70368
Safety Factor | 6.540271147
Inboard Rod Ends
Name | HXAM-4T, HXAB-4T
Ball Bore (in) | 0.25
Ball Width (in) | 0.593
Head Diameter (in) | 1.025
Misalignment (deg) | 23
Static Radial Load Capacity (lbf) | 10789
Safety Factor | 7.046555562
Outboard Spherical Bearings
Name | HAB-4T
Ball Bore (in) | 0.25
Ball Width (in) | 0.593
Outside Diameter (in) | 0.74
Misalignment (deg) | 24
Static Radial Load Capacity (lbf) | 7560
Safety Factor | 4.937617949
