BDR16/svn-migration-dump/Mechanical/Wheel Assemblies/Suspension/Members/Wishbones/Wishbone Geometry/Wishbone Geometry.xls

Sheet: Fronts
BR2013 front design
 | Camber (°) | Track Change (mm) | RC Height (mm) | RC Width (mm)
Static | -2 | 0 | 54.16 | 0
1” Bump | -3.04 | 0.86 | 23.55 | 0
1” Droop | -1.12 | 0.86 | 85.8 | 0
1.25° Roll | -2.95, -1.41 | 2.17, 2.36 | 48.98 | 29.57
2.5° Roll | -3.92, -0.89 | 4.25, 5 | 43.81 | 62.69
Changed wheel offset by 0.25”, decreased KPI to 4 degrees, kept nearly the same scrub radius of about 22mm, changed upright angle to 3 degrees
 | Camber (°) | Track Change (mm) | RC Height (mm) | RC Width (mm)
Static | -1 | 0 | 52.54 | 0
1” Bump | -2 | 0.85 | 21.44 | 0
1” Droop | -0.15 | 0.85 | 84.58 | 0
1.25° Roll | -1.96, -0.39 | 2.17, 2.35 | 47.25 | 34.73
2.5° Roll | -2.93, 0.15 | 4.25, 4.99 | 41.87 | 74.63
Changed upright height to 240mm and static camber to 1.5 degrees (3 degree upright angle with shim on upright bottom)
 | Camber (°) | Track Change (mm) | RC Height (mm) | RC Width (mm)
Static | -1.5 | 0 | 44.91 | 0
1” Bump | -2.36 | 0.85 | 13.83 | 0
1” Droop | -0.78 | 0.85 | 76.83 | 0
1.25° Roll | -2.5, -0.8 | 2.17, 2.35 | 39.6 | 40.05
2.5° Roll | -3.52, -0.17 | 4.25, 4.99 | 34.12 | 88.2
Lowered KPI to 0.5 deg to equal static camber and increased wheel offset to 1.25”
 | Camber (°) | Track Change (mm) | RC Height (mm) | RC Width (mm)
Static | -0.5 | 0 | 42.08 | 0
1” Bump | -1.29 | 0.82 | 10.37 | 0
1” Droop | 0.17 | 0.82 | 74.48 | 0
1.25° Roll | -1.51, 0.23 | 2.17, 2.35 | 36.58 | 51.72
2.5° Roll | -2.53, 0.91 | 4.25, 4.98 | 30.65 | 116.71
Increased upright height by 5mm to get rid of the excessive RC width changes in roll (245mm)
 | Camber (°) | Track Change (mm) | RC Height (mm) | RC Width (mm)
Static | -0.5 | 0 | 46.77 | 0
1” Bump | -1.37 | 0.82 | 15.06 | 0
1” Droop | 0.26 | 0.82 | 79.22 | 0
1.25° Roll | -1.48, 0.18 | 2.17, 2.35 | 41.3 | 46.44
2.5° Roll | -2.48, 0.8 | 4.25, 4.98 | 35.49 | 102.81
Increased upright height by 5mm again to get rid of the excessive RC width changes in roll (250mm)
 | Camber (°) | Track Change (mm) | RC Height (mm) | RC Width (mm)
Static | -0.5 | 0 | 51.27 | 0
1” Bump | -1.45 | 0.82 | 19.57 | 0
1” Droop | 0.34 | 0.82 | 83.76 | 0
1.25° Roll | -1.45, 0.13 | 2.17, 2.35 | 45.81 | 42.33
2.5° Roll | -2.42, 0.70 | 4.25, 4.98 | 40.1 | 92.37
Decreased wheel offset by 0.25” to fit brake calipers better.
 | Camber (°) | Track Change (mm) | RC Height (mm) | RC Width (mm)
Static | -0.5 | 0 | 47.59 | 0
1” Bump | -1.4 | 0.83 | 15.64 | 0
1” Droop | 0.27 | 0.83 | 80.35 | 0
1.25° Roll | -1.48, 0.17 | 2.17, 2.35 | 40.27 | 45.73
2.5° Roll | -2.48, 0.78 | 4.25, 4.98 | 36.25 | 100.9
Changed hub to upright bottom node offset
 | Camber (°) | Track Change (mm) | RC Height (mm) | RC Width (mm)
Static | -0.5 | 0 | 47.47 | 0
1” Bump | -1.39 | 0.83 | 15.66 | 0
1” Droop | 0.27 | 0.83 | 80.18 | 0
1.25° Roll | -1.48, 0.17 | 2.17, 2.35 | 41.96 | 45.84
2.5° Roll | -2.47, 0.79 | 4.25, 4.98 | 36.14 | 101.19
Increased track width such that the wheels stick out 1” further than the rears
 | Camber (°) | Track Change (mm) | RC Height (mm) | RC Width (mm)
Static | -0.5 | 0 | 45.72 | 0
1” Bump | -1.32 | 0.79 | 13.86 | 0
1” Droop | 0.22 | 0.79 | 78.25 | 0
1.25° Roll | -1.49, 0.20 | 2.17, 2.35 | 40.2 | 50.82
2.5° Roll | -2.48, 0.85 | 4.25, 4.96 | 34.28 | 113.39

Sheet: Rears
Original rear design with 0.15” offset upper nodes and 1.3” offset lower nodes. Almost entirely based on old design
 | Camber (°) | Track Change (mm) | RC Height (mm) | RC Width (mm)
Static | -2.13 | 0 | 39.95 | 0
1” Bump | -2.92 | 0.62 | 19.09 | 0
1” Droop | -1.48 | 0.62 | 61.3 | 0
1.25° Roll | -3.04, -1.22 | 2.22, 2.21 | 40.26 | 37.12
2.5° Roll | -3.99, -0.33 | 4.46, 4.40 | 40.28 | 73.22
Changes include no suspension node offsets, 1.5° static camber, shorter uprights (235mm), and very small scrub radius using 1.5” wheel offsets
 | Camber (°) | Track Change (mm) | RC Height (mm) | RC Width (mm)
Static | -1.5 | 0 | 24.35 | 0
1” Bump | -1.99 | 0.58 | 3.98 | 0
1” Droop | -1.12 | 0.58 | 44.91 | 0
1.25° Roll | -2.54, -0.47 | 2.26, 2.25 | 24.55 | 59.07
2.5° Roll | -3.61, 0.54 | 4.54, 4.49 | 24.27 | 115.83
Increased the upright height to 245mm
 | Camber (°) | Track Change (mm) | RC Height (mm) | RC Width (mm)
Static | -1.5 | 0 | 31.71 | 0
1” Bump | -2.12 | 0.58 | 11.16 | 0
1” Droop | -0.99 | 0.58 | 52.49 | 0
1.25° Roll | -2.47, -0.53 | 2.26, 2.25 | 31.99 | 43.11
2.5° Roll | -3.47, 0.41 | 4.54, 4.49 | 31.96 | 84.83
Increased the upright height to 255mm
 | Camber (°) | Track Change (mm) | RC Height (mm) | RC Width (mm)
Static | -1.5 | 0 | 38.48 | 0
1” Bump | -2.23 | 0.58 | 17.79 | 0
1” Droop | -0.87 | 0.58 | 59.44 | 0
1.25° Roll | -2.41, -0.59 | 2.26, 2.25 | 38.82 | 33.88
2.5° Roll | -3.34, 0.3 | 4.54, 4.49 | 38.94 | 66.79
Decreased upright height to 250mm and increased static camber to 2°
 | Camber (°) | Track Change (mm) | RC Height (mm) | RC Width (mm)
Static | -2 | 0 | 35.27 | 0
1” Bump | -2.68 | 0.58 | 14.73 | 0
1” Droop | -1.43 | 0.58 | 56.07 | 0
1.25° Roll | -2.94, -1.06 | 2.26, 2.25 | 35.58 | 38.44
2.5° Roll | -3.9, -0.15 | 4.54, 4.49 | 35.62 | 75.75
Changed to 1” wheel offsets, same track
 | Camber (°) | Track Change (mm) | RC Height (mm) | RC Width (mm)
Static | -2 | 0 | 36.22 | 0
1” Bump | -2.7 | 0.59 | 15.52 | 0
1” Droop | -1.41 | 0.59 | 57.24 | 0
1.25° Roll | -2.93, -1.06 | 2.26, 2.25 | 36.53 | 38.36
2.5° Roll | -3.9, -0.15 | 4.54, 4.49 | 36.56 | 75.6
Changed KPI to 1 degree to allow for a flat backed upright with new static camber
 | Camber (°) | Track Change (mm) | RC Height (mm) | RC Width (mm)
Static | -1 | 0 | 35.97 | 0
1” Bump | -1.7 | 0.59 | 15.12 | 0
1” Droop | -0.42 | 0.59 | 57.15 | 0
1.25° Roll | -1.94, -0.07 | 2.26, 2.25 | 36.29 | 37.39
2.5° Roll | -2.91, 0.84 | 4.54, 4.49 | 36.36 | 73.56
Changed hub to suspension node offset to account for upright holes in the middle of the upright
 | Camber (°) | Track Change (mm) | RC Height (mm) | RC Width (mm)
Static | -1 | 0 | 36.52 | 0
1” Bump | -1.71 | 0.6 | 15.58 | 0
1” Droop | -0.41 | 0.6 | 57.83 | 0
1.25° Roll | -1.94, -0.07 | 2.27, 2.25 | 36.85 | 37.34
2.5° Roll | -2.9, 0.84 | 4.54, 4.48 | 36.91 | 73.56
