BDR16/svn-migration-dump/Electrical/Low Voltage/PDM Wiring.jpg

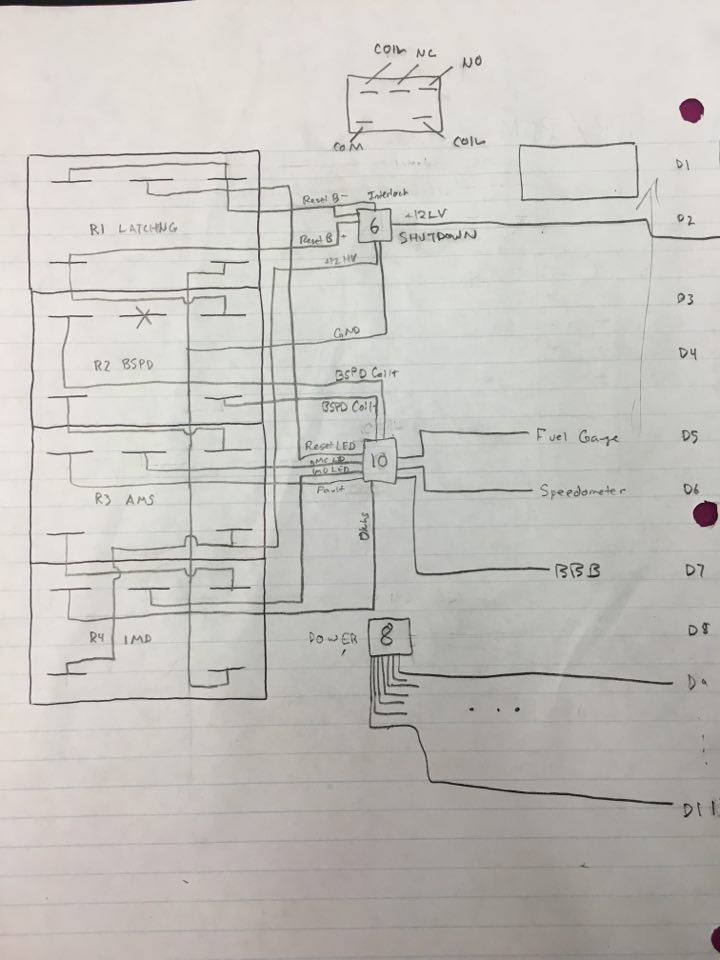
Electrical/Low Voltage/PDM Wiring.jpg
