BDR16/svn-migration-dump/Administration/Project Management/Work Packages/Impact Attenuator - Test - WP.docx

Task Description

You are responsible testing the impact attenuator. The specifications for this design and test are found in FH rules sections T3.20.

Responsible Parties

Claire Mallon is the sole member responsible for this test.

Deliverables

Report due in February (?) to Formula Hybrid and Formula Lincoln

Budget

$0

Resources (human and machine)

Instron – 2 hours

Time to complete

1 week (Nov 1 – 7)

Required Inputs

Manufactured impact attenuator and front bulkhead

Work Package: Impact Attenuator Test Principle Designer: Claire Mallon (Date) version 1
