BDR16/svn-migration-dump/Mechanical/Impact Attenuator/Data Sheets and References/Plascore Quasi-static Crush Test.pdf

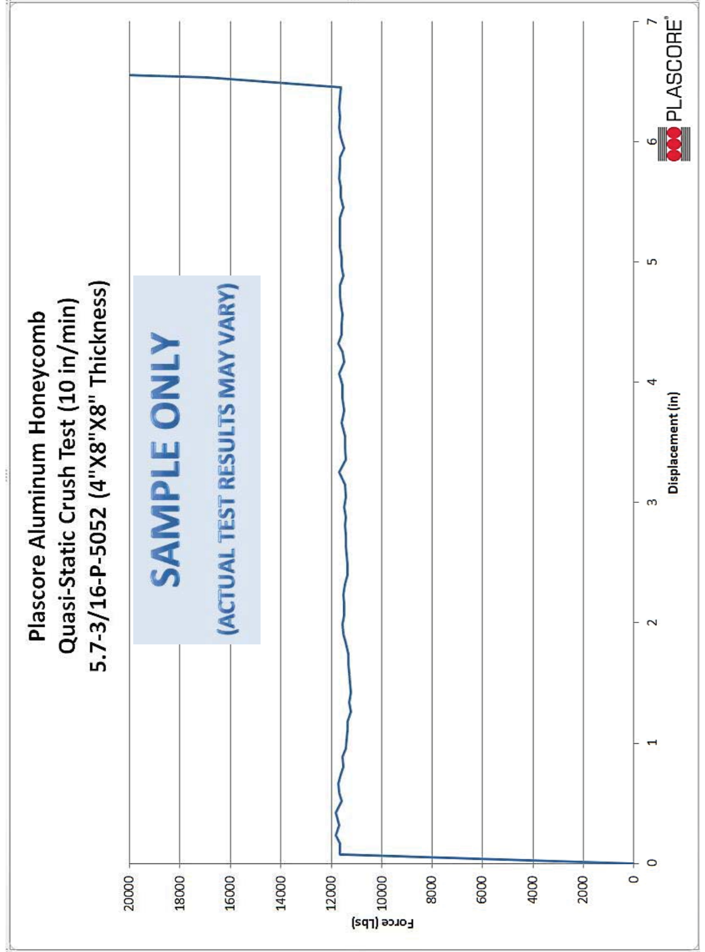
[picture p236: page 1]
