BDR16/svn-migration-dump/Administration/Competition Forms/Formula Electric/2016_FMEA_Yale_University.xls

Sheet: Intro
2016 FMEA
Car Number | 228
University | Yale University
This template contains two of examples of how to fill out the FMEA. Furthermore, it contains a number of failure modes which are both starting points and examples for the failures to be covered in your team's FMEA. NOTE: Not every given failure may apply to every team's system. The given failures may also be incomplete with respect to your specific system. Add failures to the list, if appropriate for your system.
Change the two complete examples given, i.e. No.1 and 2, to suit your system. Add missing failure modes with respect to your car's system. Be as complete as possible, adding any failures that affect the safety of your car, the driver, or other persons. Before submitting your FMEA please make sure it is complete. This way you will avoid unnecessary delays and queries. Please have a look at the document "How to pass ESF&FMEA" in the "Rules&Important Document, before filling out the FMEA form.
Edit the coloured cells to your specific data and reset the cell colour to white
Only add additional failures at the end of the list to keep the numbering scheme of the original template. This makes reviewing the document much easier and thus faster. Do not delete any failures, if they do not apply to your system. Just write "Does not apply." or similar with a short reason why.
Do not change the template's format!

Sheet: Definitions + Sev, Occ, Det
FMEA definitions of column headers and Key for Severity, Occurance and Detection ratings
Rating | Severity (Sev) | Occurrence (Occ) | Detection (Det)
1 | No injuries may be caused, but general safety is affected by this failure | Failure occurrence is very unlikely | Certain detection of the failure
2 | Light injuries may be caused by this failure | Relatively few failure occurrence | High chance of detecting this failure
3 | Medium injuries may be caused by this failure | Occasional failure occurrence | Medium chance of detecting this failure
4 | Heavy injuries may be caused by this failure | Frequent failure occurrence | Low chance of detecting this failure
5 | Fatal injuries may be caused by this failure | Persistent failure occurrence | Failure cannot be detected
Component/Item | The system or component that is affected
Function | What the system or component does
Failure Mode | The method by which the component fails
Failure Cause | The root cause of the failure
Failure Effect Local | What happens locally to the component as a consequence of the failure
Failure Effect Global | What happens to other systems or the rest of the vehicle as a consequence of the failure
Sev | The severity rating - see table above
Severity Reasoning | Your reasoning for the severity rating that is given
Occ | The likelihood of the occurrence - see table above
Occurrence Reasoning | Your reasoning for the occurance rating that is given
Failure Detection | How will the failure be detected - what are the systems on the car that detect this
Det | The rating for failure detection - see table
Detection Reasoning | Your reasoning for the failure detection rating
Risk | Calculated automatically from Sev, Occ and Det
Failure Handling - Vehicle | Once a failure has been detected, what is the immediate reaction of the ECU / BMS and the driver to mitigate the risk
Failure Handling - Team | How do you determine what has failed and what type of action is taken to remedy this? What precautions do you take whilst doing this?

Sheet: FMEA
 | 2016 FORMULA SAE - FMEA
 | Car No.: | 228 | University: | Yale University |  | Contact: | Philip Piper, philip.piper@yale.edu
FMEA No.: | Component/Item | Function | Failure Mode | Failure Cause | Failure Effect |  | Sev | Severity Reasoning | Occ | Occurrence Reasoning | Failure Detection | Det | Detection Reasoning | Risk | Failure Handling - Vehicle | Failure Handling - Team | Comments
 |  |  |  |  | Local | Global
1 | Tractive System Wiring | Energy transfer | Positive pole lost isolation to GLVS | Wiring insulation degradation | Potentially dangerous condition if operator touches the negative pole of the battery and the chassis | Possible chassis reference voltage potential change | 5 | Potentially lethal effect due to exposure to a voltage of over 60V with the ability to source over 100mA. | 2 | All wire insulations chosen with respect to the environment, additional thermal mechanical protection attached where needed, all wires are securely attached and professionaly built to lower the risk of damages by vibrations | Insulation resistance monitoring system. | 1 | IMD continuously detects potentially dangerous GLVS isolation losses. This check is also done before powering the car. | 10 | Isolation Lost Alarm enabled. IMD opens the AIRs through the Shutdown Circuit | IMD dashboard light indicates this as a potential failure. Appropriate procedure to be executed once the car back in the PIT to restore the isolation. Fault to be identified and rectified before enabling the AIRs. Insulating gloves to be used
2 | Tractive System Wiring | Energy transfer | Negative pole lost isolation to the GLVS | Wiring insulation degradation | Potentially dangerous condition if operator touches the positive pole of the battery and the chassis | Possible chassis reference voltage potential change | 5 | Potentially lethal effect due to exposure to a voltage of over 60V with the ability to source over 100mA. | 2 | All wire insulations chosen with respect to the environment, additional thermal mechanical protection attached where needed, all wires are securely attached and professionaly built to lower the risk of damages by vibrations | Insulation resistance monitoring system. | 1 | IMD continuously detects potentially dangerous GLVS isolation losses. This check is also done before powering the car. | 10 | Isolation Lost Alarm enabled. IMD opens the AIRs through the Shutdown Circuit | IMD dashboard light indicates this as a potential failure. Appropriate procedure to be executed once the car back in the PIT to restore the isolation. Fault to be identified and rectified before enabling the AIRs. Insulating gloves to be used
3 | Tractive System Wiring | Energy transfer | Open/live tractive system connections when switching on the tractive system | High voltage disconnect or maintenance plug disconnected when tractive system is turned on. Accumulator opened when tractive system is turned on. Additionally SMD or HVD failure due to incorrectly strain-reliefed connectors | Potentially dangerous condition if operator is able to touch the live part of the tractive system and the chassis. | Possible chassis reference voltage potential change and tractive system components may not be powered (since a connector is unplugged). | 5 | Potentially lethal effect due to exposure to a voltage of over 60V with the ability to source over 100mA. | 1 | All tractive system connectors are properly insulated such that the conductor can not be touched by a human finger while unplugged. Additionally the tractive system will not be powered while the accumulator box is open. | Visual inspection of the motors not being powered, the connectors being unplugged, or the accumulator box top being disconnected | 3 | The tractive system is powered in order for the motors to spin the wheels. Therefore it will be fairly obvious if the wheels do not spin when the tractive system is powered. Harder to detect a failure in connector insulation. | 9 | Motors are not powered by the tractive system when the high voltage disconnect is disconnected. | Immediately unpower the tractive system. Carefully check the tractive system wiring for disconnected SMDs or HVD. Additionally and more importantly, carefully check the tractive system wiring for failures in insulation or connector integrity.
4 | HVD / Tractive System Connectors | Energy transfer | HVD / Tractive System Connectors become loose while driving and eventually open up, exposing live contacts | Excessive vehicle vibration may cause an improperly specced nut to come loose in the high current path. | Potentially dangerous condition if the operator touches the pole of the battery and the chassis | Possible chassis reference voltage potential change and exposed tractive system voltage levels dangerous for operators. | 5 | Potentially lethal effect due to exposure to a voltage of over 60V with the ability to source over 100mA. | 1 | Positive locking fasteners are used to mount the HVD and Tractive System Connectors in order to prevent them from coming loose due to vehicle vibrations. | Insulation resistance monitoring system or visual detection | 3 | The IMD will detect the issue if isiolation is lost. If live contacts are exposed but insulation is not lost then visual detection is the only method of failure detection. | 9 | Isolation Lost Alarm enabled. IMD opens the AIRs through the Shutdown Circuit. If isolation is not lost then the vehicle will continue operating. | IMD dashboard light indicates this as a potential failure if isolation is lost. Appropriate procedure to be executed once the car back in the PIT to restore the isolation. Fault to be identified and rectified before enabling the AIRs. Insulating gloves to be used
5 | Tractive System Fusing | Protection of tractive system wiring | Overcurrent is higher than the maximum switch off current of the used fuse | Fuse is improperly sized such that the accumulator can provide more current than the breaking capacity of the main fuse. | Fuse is potentially destroyed and an electric arc can be sustained for longer than the fuse's rated speed. | Destruction of the fuse could spray conductive components throughout the accumulator, potentially damaging cells or AMS boards. Additionally the motor controllers or cells could be destroyed if an arc is sustained for much longer than the fuse speed. | 5 | The fuse and cells are contained within the accumulator while the motor controllers are housed in a Kevlar box. Therefore any minor explosion will be contained. However fuse failure leaves potentially lethal tractive system voltages present throughout the accumulator which can have a lethal effect over 60V, 100mA. | 1 | The fuse is properly sized such that the breaking capacity is much higher than the maximum current that the cells can supply in a worst case scenario of a short circuit across the entire accumulator. | The tractive system will stop working and the fuse will likely let off smoke after its destruction. | 1 | The tractive system will not work when powered and any destruction of the fuse or motor controllers will likely carry visual evidence of smoke or audio evidence of a loud bang. | 7 | The tractive system will not work because the main fuse will be an open circuit. | Immediately disconnect the HVD and SMDs to prepare the safe the accumulator and vehicle. The accumulator must be opened while wearing proper PPE, and the fuse must be replaced with one that has a proper breaking capacity.
6 | Accumulator | Energy Storage | Cell temperature above data sheet specification for discharging | This failure may occur if the accumulator is pushed to hard when trying to race the car. | The cell will not be able to discharge any longer because the AIRs will be switched off by the AMS. | Neighboring cells could be heated due to this cell's overvoltage. | 4 | The A123 Amp20 LiFePO4 cells do not go into thermal runaway at such low temperatures as 60C, therefore the overtemperature cell does not present any risk in this failure mode. However LiFePO4 cells still do outgas and can be involved in less catastrophic failures. | 3 | When testing/racing the car by pushing it to its limits, a cell overtemperature may happen. The cells are properly cooled via aluminum heat fins that carry excess heat to the ambient environment. | The tractive system will turn off and the AMS fault light will light up on the dashboard. | 3 | The AMS fault light will illuminate on the dashboard letting the team know that the AMS detected an issue. However the cell board temperature monitors can not monitor the maximum temperature across the cell, and therefore may not trip until parts of the cell are well above 60C. | 10 | The AIRs will be turned off by the AMS. | After noticing the AMS fault light, the ESO will connect to the AMS via a serial cable to identify which fault occurred. Then the accumulator will be allowed to cool before attempting to power the tractive system again.
7 | Accumulator | Energy Storage | Cell temperature above data sheet specification for charging | This failure may occur if the accumulator is improperly cooled while being charged. | The cell will not be able to charge any longer because the AIRs will be switched off by the AMS. | Neighboring cells could be heated due to this cell's overvoltage. | 4 | The A123 Amp20 LiFePO4 cells do not go into thermal runaway at such low temperatures as 60C, therefore the overtemperature cell does not present any risk in this failure mode. However LiFePO4 cells still do outgas and can be involved in less catastrophic failures. | 1 | The accumulator is charged at a current rating of about 0.5C = 10A, which is far too low to cause an overtemperature. The only time this fault would occur is if ambient temperature were very, very high - say 55 degrees Celsius. | The charger will be turned off by a relay between the wall plug and its AC power input. | 3 | The charger will prematurely turn off giving a visual indication that the AMS flipped the charger power input relay, directly disconnecting the charger's AC input. However the cell board temperature monitors can not monitor the maximum temperature across the cell, and therefore may not trip until parts of the cell are well above 60C. | 8 | The charger power input relay will be turned off by the AMS. | After noticing the AMS charger relay turn off, the ESO will connect to the AMS via a serial cable to identify which fault occurred. Then the accumulator will be allowed to cool before attempting to charge the cells again.
8 | Accumulator | Energy Storage | Cell voltage above data sheet specification | This failure could occur if there is a large resistance between the AMS cell board measurement wires and a cell's positive/negative tabs. | The cell will heat up until the AMS is tripped for a cell overtemperature | Neighboring cells could be heated due to this cell's overvoltage. | 4 | The A123 Amp20 LiFePO4 cells do not go into thermal runaway at such low temperatures as 60C, therefore the overvoltage, overtemperature cell does not present any risk in this failure mode. However LiFePO4 cells still do outgas and can be involved in less catastrophic failures. | 2 | The cell boards are about a millimeter away from either cell tab, therefore the possibility of one of the measurement wires having a large resistance, but not being completely disconnected (which the AMS would notice as an undervoltage) is very low. | The AMS would catch this fault during charging due to a cell overtemperature. During discharging the high cell voltage would lower as energy is pulled from the battery. | 4 | The AMS catching this fault as a cell overtemperature would be misleading, as the actual problem would be in the cell voltage monitor wires. | 10 | The AMS would shut off the AIRs when the cell has an overtemperature due to an overvoltage. | The team would attach a serial cable to the AMS to get the specific fault, then notice a single cell with a much higher temperature than the rest. This would result in the accumulator being deconstructed to further investigate the cell and its corresponding cell board.
9 | Accumulator | Energy Storage | Cell voltage below data sheet specification | A current path between the two terminals of a cell could cause this failure. Additionally a fully discharged cell would have a voltage near this failure. | The cell would wear out more quickly if it is discharged to this voltage often, or left at this voltage. | The overall accumulator voltage will be lower. | 1 | A low cell voltage will affect cell life but will not present a hazard to the driver or operators. | 3 | In an attempt to eek every bit of energy out of the accumulator the car will be run until cell's are very near their lower voltage limit. This is not an issue as long as the accumulator is not left in a discharged state for a long period of time. | The AMS will catch this style of fault. | 1 | The AMS catching this fault as a cell undervoltage would illuminate the AMS fault light on the dashboard and directly tell the team what went wrong. | 5 | The AMS would shut off the AIRs when the cell has an undertemperature. | The team will make sure that the tractive system is unpowered, then connect to the AMS via a serial monitor to get the exact fault specification. The AMS low voltage setpoint may be raised to prevent further failures at the cost of vehicle range.
10 | Accumulator | Energy Storage | Cell current above data sheet specification for discharging | An accumulator pack short or a short at the cell level could cause a cell overcurrent. | The cell will heat up quickly if the high current is allowed to flow for too long. | Neighboring cells could be heated due to this cell's overcurrent. | 3 | Cell's can not heat up past 60C due to the AMS cell board temperature monitors. The A123 Amp20 LiFePo4 cells do not go into thermal runaway at such low temperatures. However LiFePO4 cells still do outgas and can be involved in less catastrophic failures. | 1 | The motor controller is programmed to draw current at a level less than the cell's maximum current rating. | The AMS will catch this style of fault. | 4 | The AMS will catch an overcurrent if the entire pack is shorted. If only a single cell is shorted then the AMS will catch an overtemperature on that single cell. However a short at the cell level would only be detected as a cell undervolt which would be misleading as the cell would continue to discharge despite the AIRs opening. | 8 | The AMS would shut off the AIRs. | The team will make sure that the tractive system is unpowered, then connect to the AMS via a serial monitor to get the exact fault specification. The accumulator will then be opened by an operator wearing proper PPE to diagnose the failure.
11 | Accumulator | Energy Storage | Cell current above data sheet specification for charging | A short between two cells, one with a low voltage and one with a high voltage may cause the lower voltage cell to charge above its data sheet specification. | The cell will heat up quickly if the high current is allowed to flow for too long. | Neighboring cells could be heated due to this cell's overcurrent. | 4 | Cell's can not heat up past 60C due to the AMS cell board temperature monitors. The A123 Amp20 LiFePo4 cells do not go into thermal runaway at such low temperatures. However LiFePO4 cells still do outgas and can be involved in less catastrophic failures. | 1 | The charger can not electrically supply more current than the cell data sheet specification for charging current. Therefore only a short between both terminals of neighboring cells could cause this failure, which is very unlikely. | The AMS will catch this style of fault. | 2 | The AMS will catch an overtemperature if two cell's are shorted together. | 7 | The AMS would shut off the charger power input relay. | The team will make sure that the tractive system is unpowered, then connect to the AMS via a serial monitor to get the exact fault specification. The accumulator will then be opened by an operator wearing proper PPE to diagnose the failure.
12 | Accumulator | Energy Storage | Cooling system (water, air, oil) fails | The batteries are air cooled, therefore a failure in the cooling system will likely occur due to not enough air passing by the sides of the steel accumulator enclosure. | The cooling system itself will be fine as it is rated for far more than 60C. | The batteries will rise to 60C until the AMS shuts down the AIRs. | 4 | Cell's can not heat up past 60C due to the AMS cell board temperature monitors. The A123 Amp20 LiFePo4 cells do not go into thermal runaway at such low temperatures. However LiFePO4 cells still do outgas and can be involved in less catastrophic failures. | 2 | The cooling system is properly designed, but if the car is pushed very hard then this failure could occur. | The AMS will turn the car off. | 3 | When the cells reach an overtemperature of 60C, the AMS will turn the tractive system off. However the cell board temperature monitors can not monitor the maximum temperature across the cell, and therefore may not trip until parts of the cell are well above 60C. | 9 | The vehicle would turn off due to the AMS. | The team will connect a serial monitor to the AMS in order to diagnose the problem as cells overheating.
13 | Accumulator | Energy Storage | Accumulator is crushed / cells are mechanically damaged | If the vehicle were to crash into a barrier with a stiff, protruding object, then the accumulator could be crushed or mechanically damaged. | Punctured or crushed cells would cease to work and could cause the cell electrolyte to leak in the accumulator box. | The vehicle will likely stop moving if cells are damaged due to the AMS detecting undervoltages on the damaged cells. | 4 | A crushed accumulator could very easily cause high voltage connections to come loose, or insulation to be peeled off. This would be a hazard for operators trying to recover the vehicle. | 1 | A crushed accumulator would only occur during a major vehicle crash or if the accumulator is improperly handled outside of the vehicle. | Visual detection | 1 | The accumulator is a large, rectangular box, therefore any punctures, dents, or damage will be plainly obvious to the team and potential track operators. | 6 | The vehicle will turn off if cells are damaged or if the inertia switch is triggered. | The team will consult FSAE staff on the status of the car and will only operate on the car while wearing proper high voltage PPE as a damaged accumulator housing can be very dangerous.
14 | Torque Encoder | Signaling the pedal position | Sensor 1 and Sensor 2 deliver different position values | Throttle pedal yields or deforms plastically. | Throttle does not respond to inputs of acceleration | The driver will lose control over the positive longitudinal acceleration of the vehicle | 1 | The vehicle will still be operable to the extent that it will not pose a danger to the driver or the environment. | 1 | The driver, in the heat of the competition and the race, may use excessive force or frequency while operating the throttle, which may cause the pedal to enter the plastic region and thus change shape. | ECU | 2 | The ECU will be programmed to detect an implausability of more than 10% that exists for as little as 100 milliseconds. Since the ECU is running at a refresh rate much faster, it will easily handle the error detection. | 2 | The ECU shuts down the throttle such that the driver can no longer send inputs to the electric motors. BMS is ignorant. | The team will de-energize the car when it comes to a stop in a safe area. The nose cone will be removed and the pedal box will be inspected to determine the cause of the failure.
15 | Torque Encoder | Signaling the pedal position | Sensor 1 or Sensor 2 signal (analog or digital) not plausible | Either sensor gets mechanically disconnected | Throttle does not respond to inputs of acceleration | The driver will lose control over the positive longitudinal acceleration of the vehicle | 1 | The vehicle will still be operable to the extent that it will not pose a danger to the driver or the environment. | 2 | The driver, in the heat of the competition and the race, may use excessive force or frequency while operating the throttle, which may cause a sensor to get mechanically disconnected. | ECU | 2 | The ECU will be programmed to detect an implausability of more than 10% that exists for as little as 100 milliseconds. Since the ECU is running at a refresh rate much faster, it will easily handle the error detection. | 4 | The ECU shuts down the throttle such that the driver can no longer send inputs to the electric motors. BMS is ignorant. | The team will de-energize the car when it comes to a stop in a safe area. The nose cone will be removed and the pedal box will be inspected to determine the cause of the failure.
16 | Torque Encoder | Signaling the pedal position | Sensor 1 or Sensor 2 broken | Either sensor gets mechanically damaged | Throttle does not respond to inputs of acceleration | The driver will lose control over the positive longitudinal acceleration of the vehicle | 1 | The vehicle will still be operable to the extent that it will not pose a danger to the driver or the environment. | 2 | The driver, in the heat of the competition and the race, may use excessive force or frequency while operating the throttle, which may cause a sensor to get mechanically damaged. | ECU | 2 | The ECU will be programmed to detect the loss of signal from either sensor. | 4 | The ECU shuts down the throttle such that the driver can no longer send inputs to the electric motors. BMS is ignorant. | The team will de-energize the car when it comes to a stop in a safe area. The nose cone will be removed and the pedal box will be inspected to determine the cause of the failure.
17 | Torque Encoder | Signaling the pedal position | Signal connection (analog or digital) to Sensor 1 or Sensor 2 broken | Either sensor gets electronically damaged | Throttle does not respond to inputs of acceleration | The driver will lose control over the positive longitudinal acceleration of the vehicle | 1 | The vehicle will still be operable to the extent that it will not pose a danger to the driver or the environment. | 2 | The vehicle's weatherstripping fails to stop water to coming into the pedal box during a rainy race session, and the electronic interface of the sensor is damaged. | ECU | 2 | The ECU will be programmed to detect the loss of signal from either sensor. | 4 | The ECU shuts down the throttle such that the driver can no longer send inputs to the electric motors. BMS is ignorant. | The team will de-energize the car when it comes to a stop in a safe area. The nose cone will be removed and the pedal box will be inspected to determine the cause of the failure.
18 | Torque Encoder | Signaling the pedal position | Pedal stuck at maximum torque position | Throttle pedal hinge binds | The vehicle's electric motors will attempt to continuously accelerate the vehicle, regardless of driver input on throttle | The vehicle may pose a danger to the driver and to the environment due to its uncontrolled acceleration. | 4 | The vehicle will still be operable excluding the throttle, but the driver will have limited time to de-energize the vehicle by pusing the BRB before it gets out of control. | 1 | Double springs will ensure the return of the throttle pedal to its original 0% position. | Driver will notice that they no longer have control over the acceleration input, as well as the fact that the pedal is not returning to the original 0% position | 1 | The driver will immediately know that the throttle is stuck, as they can physically tell from the fact that it is not returning to the original position. They will also realize that the car is accelerating despite their will. | 4 | The driver presses the BRB on the dashboard and immediately actuates the brakes to counteract the acceleration input. The ECU and the BMS are ignorant. | The team will de-energize the car when it comes to a stop in a safe area. The nose cone will be removed and the pedal box will be inspected to determine the cause of the failure.
19 | Torque Encoder | Signaling the pedal position | Digital communication between sensors and receiving ECU is corrupted (e.g. bits change due to EMI) | The communication cable gets stripped and comes into contact with the chassis or signal wires were installed without proper electromagnetic radiation signaling. | Throttle does not respond to inputs of acceleration, or throttle is altered by signals that are different then what the driver is asking for through the pedal position. | The driver will lose control over the positive longitudinal acceleration of the vehicle, or potentially the vehicle will throttle uncontrollably. | 4 | The vehicle will still be operable to the extent that it will not pose a danger to the driver or the environment unless the vehicle is throttling uncontrollably due to both throttle signal lines being corrupted in a similar manner. | 1 | The cable passes through a snag point and gets stripped dues to lateral and longitudinal acceleration forces | ECU | 2 | The ECU will be programmed to detect the loss of signal from either sensor. | 2 | The ECU shuts down the throttle such that the driver can no longer send inputs to the electric motors. BMS is ignorant. | The team will de-energize the car when it comes to a stop in a safe area. The nose cone will be removed and the pedal box will be inspected to determine the cause of the failure.
20 | Torque Encoder | Signaling the pedal position | Signal connection (analog or digital) between implausibility check ECU and inverter is broken | Broken wire between ECU and pedal box. | ECU doesn't get an analog signal. | ECU pull-down resistor causes known failure value. | 1 | ECU turns the car off. | 1 | ECU wiring is done to professional standards. | ECU turns the car off | 1 | ECU detects this type of error. | 3 | The vehicle turns off. | ECU is rewired to pedal box using professional standards.
21 | Accumulator Insulation Relay(s) | Disconnecting the accumulator | Single Accumulator Insulation Relay short-circuit | The AIR contacts can potentially weld shut if turned on and off too many times (>1000 switches at maximum TS current for our particular model) or if exposed to an overcurrent failure. Additionally a crushing impact could break the AIR, shorting its poles. | The AIR will act as a short circuit and won't be controlled by the AMS. | Whichever pole the AIR is supposed to be protecting will not be protected, leaving dangerous tractive system voltages on the vehicle while an operator could potentially be working. | 5 | Potentially lethal effect due to exposure to a voltage of over 60V with the ability to source over 100mA. | 1 | The tractive system is current limited by a fuse, therefore it is not likely that the AIRs will weld shut due to an overcurrent. Additionally it is very unlikely that the AIRs fail due to overuse as the AIR model was picked to prevent this type of failure. | Tractive system active light. | 1 | The tractive system active light will remain lit even if the tractive system is turned off due to a circuit that detects if the AIR is closed. | 7 | The vehicle will work just as it normally does, except one pole of the tractive system will always be powered. This could cause motor controller damage if it is the positive pole as the precharge circuit will be bypassed. | The team will disconnect the HVD once the problem is diagnosed. Then the accumulator top will be opened so that the contactor can be replaced.
22 | Accumulator Insulation Relay(s) | Disconnecting the accumulator | Both Accumulator Insulation Relay short-circuit | The AIR contacts can potentially weld shut if turned on and off too many times (>1000 switches at maximum TS current for our particular model) or if exposed to an overcurrent failure. Additionally a crushing impact could break the AIR, shorting its poles. | Both AIRs will act as a short circuit and won't be controlled by the AMS. | The entire tractive system will remain powered despite the driver telling the car to turn the tractive system off through the dashboard. Additionally the discharge resistor will have a constant current flowing through it because the NC discharge relay will be turned off. | 5 | Potentially lethal effect due to exposure to a voltage of over 60V with the ability to source over 100mA. | 1 | The tractive system is current limited by a fuse, therefore it is not likely that the AIRs will weld shut due to an overcurrent. Additionally it is very unlikely that the AIRs fail due to overuse as the AIR model was picked to prevent this type of failure. | Tractive system active light. | 1 | The tractive system active light will remain lit even if the tractive system is turned off due to a circuit that detects if the AIR is closed. | 7 | The vehicle will work just as it normally does, except both poles of the tractive system will always be powered. This could cause failure of the discharge resistor if left in this state for too long. | The team will disconnect the HVD once the problem is diagnosed. Then the accumulator top will be opened so that the contactors can be replaced. Additionally the team will rethink the specifications for the chosen AIRs if both fail at the same time.
23 | Accumulator Insulation Relay(s) | Disconnecting the accumulator | Single Accumulator Insulation Relay control connection lost | AIR control wire breaks. | The AIR can not be properly controlled by the AMS. | The AIR wire, if broken, could short elsewhere potentially delivering +12V or GND to some other part of the GLVS accumulator section. | 4 | If the broken AIR wire is energized by resting on +12V or GND (depending on the wire), then the AIR could turn on without being controlled. If this failure were to occur while driving, loss of control in the longitudinal (SAE x axis) direction would occur. | 1 | The AIR control wires are fabricated to industry standards such that this failure will likely not occur. | Visual inspection by the driver or by operators. | 1 | The AIR will not respond to the AMS, and therefore the tractive system will not turn on/off when instructed to. | 6 | The vehicle will work just as it normally does, except one pole of the tractive system might be powered/unpowered despite what the AMS tells it to do. This could cause motor controller damage if it is the positive pole as the precharge circuit will be bypassed. | The team will disconnect the HVD once the problem is diagnosed. Then the accumulator top will be opened so that the contactor control wire can be fixed.
24 | Accumulator Insulation Relay(s) | Disconnecting the accumulator | Both Accumulator Insulation Relay control connection lost | Both AIR control wires break. | The AIRs can not be properly controlled by the AMS. | The AIR wires, if broken, could short elsewhere potentially delivering +12V or GND to some other part of the GLVS accumulator section. | 4 | If the broken AIR wire is energized by resting on +12V or GND (depending on the wire), then the AIR could turn on without being controlled. If this failure were to occur while driving, loss of control in the longitudinal (SAE x axis) direction would occur. | 1 | The AIR control wires are fabricated to industry standards such that this failure will likely not occur. | Visual inspection by the driver or by operators. | 1 | The AIRs will not respond to the AMS, and therefore the tractive system will not turn on/off when instructed to. | 6 | The vehicle will work just as it normally does, except both poles of the tractive system might be powered/unpowered despite what the AMS tells them to do. This could cause failure of the discharge resistor if left in this state for too long. | The team will disconnect the HVD once the problem is diagnosed. Then the accumulator top will be opened so that the contactor control wires can be fixed.
25 | Pre-Charge Relay | Pre-Charging the intermediate circuit | Pre-Charge Relay short circuit | A PCB board trace coming loose or FOD scratching into the silk screen could cause a pre-charge relay short circuit. | A short-circuited precharge relay exposes tractive system voltage passed the positive AIR even if the positive AIR is off. | The high impedance positive pole (due to the precharge resistor) will be exposed at the input to the motor controllers, the SMDs, and the HVD. | 4 | A shorted pre-charge relay will still allow the car to precharge and discharge properly. The only risk is that there will be high voltage on the motor controller positive connections unexpectedly if SMDs are not used when handling the accumulator. | 1 | The precharge relay could weld shut if there is an overcurrent or if it is overused, however it is properly sized to prevent this. Additionally a short on the high voltage PCB could cause this failure, but is unlikely to occur since the PCB has proper insulation distances built into it. | Operators will have to check the tractive system voltages through the TSMPs when the car is turned on. | 4 | This failure is hard to detect because the TSMPs can't be used to see if there is always positive voltage on the motor controllers as the voltage can not be measured with one pole. The pre-charge relay would have to be physically checked to identify this failure. | 9 | The vehicle would still work as expected except there will be high voltage on the positive pole of the motor controllers. | The operators would turn off the tractive system, put on proper HV PPE, and disconnect the HV board in the accumulator so that the pre-charge relay can be replaced.
26 | Pre-Charge Relay | Pre-Charging the intermediate circuit | Pre-Charge Relay control connection lost | Pre-charge relay control wire breaks. | The pre-charge relay would shut down if the wire is disconnected, but if the wire is broken it could potentially short to ground or +12V. | The pre-charge relay will not respond to the AMS, causing the motor controllers to not be pre-charged properly. | 3 | The motor controllers could break if they are not pre-charged properly. More likely the main pack fuse will blow when too much current is pulled. Additionally a potential arc hazard due to a non-pre-charge motor contorller being energized. | 1 | The precharge relay control wires are fabricated to professional standards, therefore this problem will likely not occur. | Main accumulator fuse | 1 | The main accumulator fuse will fail because the motor controller capacitors will draw too much current when not pre-charged properly. | 2 | The vehicle will stop working due to the blown fuse. | The tractive system will be shutdown, SMDs disconnected, and PPE put on such that the accumulator can be opened. Then the main fuse failure will have to be diagnosed by the team as a pre-charge relay control problem.
27 | Pre-Charge Resistor | Pre-Charging the intermediate circuit | Pre-Charge Resistor broken / open circuit | Pre-charge resistor overheats and is destroyed. Additionally the traces connecting the resistor to the rest of the TS could break. | The resistor would not allow current to flow due to the high impedance disruption in the pre-charge circuit path. | The pre-charge relay may turn on/off but the motor controllers will not be pre-charged properly. | 3 | The motor controllers could break if they are not pre-charged properly. More likely the main pack fuse will blow when too much current is pulled. Additionally a potential arc hazard due to a non-pre-charge motor contorller being energized. | 1 | The precharge resistor is fabricated along with the HV board to professional standards, therefore it is unlikely that the pre-charge circuit breaks. | Main accumulator fuse | 1 | The main accumulator fuse will fail because the motor controller capacitors will draw too much current when not pre-charged properly. | 5 | The vehicle will stop working due to the blown fuse. | The tractive system will be shutdown, SMDs disconnected, and PPE put on such that the accumulator can be opened. Then the main fuse failure will have to be diagnosed by the team as a pre-charge resistor problem.
28 | Discharge Relay | Discharging the intermediate circuit | Discharge Relay short circuit | A failure of the HV board could cause traces to connect such that the discharge relay short circuits the positive and negative sides of the motor controllers. | The discharge resistor could overheat if current is dumped into it for too long. | The accumulator energy will be drained more quickly than normal due to the discharge relay shorting the positive and negative poles through the discharge resistor. | 5 | A properly sized discharge resistor could overheat, causing high temperatures to components around it. However all of this is contained by a Kevlar enclosure such that operators are not affected. This would however leave high voltage on the tractive system when it is turned off due to a faulty discharge circuit. | 1 | The discharge relay is fabricated along with the HV board to professional standards, therefore it is unlikely that the discharge circuit breaks. | Accumulator energy draining when the car isn't moving | 3 | The discharge resistance is so large that it may be hard to see the accumulator energy draining when the car isn't moving (but the TS is still on of course). | 9 | The vehicle will continue working, but range will be reduced. | The tractive system will be shutdown, SMDs disconnected, and PPE put on such that the accumulator can be opened. Then the accumulator drain failure will have to be diagnosed by the team as a discharge relay problem.
29 | Discharge Relay | Discharging the intermediate circuit | Discharge Relay control connection lost | Discharge relay control wire breaks. | The discharge relay (normally-closed relay) would close if the control wire is disconnected, but if the wire is broken it could potentially short to ground or +12V. | The discharge circuit would always be exposed, even when the tractive system is on. | 5 | A properly sized discharge resistor could overheat, causing high temperatures to components around it. However all of this is contained by a Kevlar enclosure such that operators are not affected. This would however leave high voltage on the tractive system when it is turned off due to a faulty discharge circuit. | 1 | The discharge relay is fabricated along with the HV board to professional standards, therefore it is unlikely that the discharge circuit breaks. | Accumulator energy draining when the car isn't moving | 3 | The discharge resistance is so large that it may be hard to see the accumulator energy draining when the car isn't moving (but the TS is still on of course). | 9 | The vehicle will continue working, but range will be reduced. | The tractive system will be shutdown, SMDs disconnected, and PPE put on such that the accumulator can be opened. Then the accumulator drain failure will have to be diagnosed by the team as a discharge relay problem.
30 | Discharge Resistor | Discharging the intermediate circuit | Discharge Resistor broken / open circuit | If the discharge resistor overheats it could break causing an open circuit in the discharge circuit. | The discharge circuit would not work as it would be an open circuit. | The motor controller inputs would stay at a high voltage, even when the tractive system is turned off. | 5 | A properly sized discharge resistor could overheat, causing high temperatures to components around it. However all of this is contained by a Kevlar enclosure such that operators are not affected. This would however leave high voltage on the tractive system when it is turned off due to a faulty discharge circuit. | 2 | An improperly sized discharge resistor could cause this problem to occur. | TSAL on when TS is off. | 1 | The TSAL would stay on while the TS is off indicating that there is a problem with the AIRs or the discharge circuit. | 8 | The vehicle will continue working but operators will not be able to work on the car without HV PPE because the TSAL won't turn off. | The tractive system will be shutdown, SMDs disconnected, and PPE put on such that the accumulator can be opened. Then the AIRs and discharge circuit will be examined to figure out the cause of failure. The resistor will be replaced.
31 | Motor Controller / Inverter | Controlling the motor power | Motor Controller output stage short-circuit | A loose connection between the motor controllers and the motors could cause two of the phases to come into contact. | The motor controllers will likely fail due to the shorted output phases from the IGBTs. | The tractive system of the car will stop working when the motor controllers fail. | 1 | The motor controllers are contained by a blast-resistant cover such that a failure can not harm nearby operators. Additionally the firewall prevents the failure from reaching the driver. | 1 | The output phase connections are secured with positive locking mechanisms such that they do not loosen. | The tractive system won't run and an audio indication will occur if the motor controllers fail. | 1 | The failure of the motor controllers will make a loud, sharp noise, and the motors won't turn anymore. | 3 | The tractive system will not work properly. | The car will be shutdown and brought into the pit properly. The HVD and SMDs will be removed such that the motor controller outputs can be worked upon.
32 | Motor Controller / Inverter | Controlling the motor power | Motor Controller control connection lost | A loose motor controller connection on the low voltage side could cause control to be lost from the ECU to the controller. | The motor controller analog input will be floating. | The pull down resistor in the motor controller will cause the motor controller to read a 0V input, resulting in a command of no torque. | 1 | The car will stop moving due to the loss of analog input to the motor controller and the pull down resistor internal to the controller. Loss of control in the x longitudinal axis of the car allowing for the vehicle to be brought to a safe stop | 1 | Professional wiring of the low voltage harness makes this failure unlikely to occur. | The car won't respond to the pedal. | 1 | The car won't respond to the pedal, even when the tractive system is on. | 3 | The car won't respond to driver acceleration input. Then the motor controller can be connected to over a serial monitor to diagnose the issue. | The car will be shutdown and brought into the pit properly. A serial monitor will be connected to the motor controller to diagnose the issue. Then the wire will be reconnected in a professional manner.
33 | Motor Controller / Inverter | Controlling the motor power | Motor Controller does not react plausible to control input | A software or hardware error internal to the motor controller could cause it to not react plausibly to the control input. | The motor controller will command the motors to turn even if the driver is not on the accelerator pedal. | The motors will turn causing the car to accelerate or deccelerate. | 5 | Complete loss of control in the x longitudinal axis of the car potentially leading to an uncontrolled acceleration. | 1 | The motor controller is professionally made by a reputable company (Unitek). Additionally the team has used the motor controller for the past 2 years with no problem (although that is not a good indication of future success). | The car will accelerate in an uncontrolled manner. | 1 | The driver will notice that he/she is not controlling the torque delivered to the wheels and will slam on the brakes, causing the BSPD to trigger. | 7 | The car will turn off once the BSPD is triggered by the driver slamming on the brakes. | The car will be shutdown and brought into the pit properly. A serial monitor will be connected to the motor controller to diagnose the issue. Then the motor controller software will either be updated from the manufacturer or the controller will be replaced.
34 | Motor Controller / Inverter | Controlling the motor power | Cooling system (water, air, oil) fails | A number of things could cause a cooling system failure. For example a leak in the coolant loop or an overtemperature in the loop causing water to boil are potential failures. | The cooling system will cease to operate properly, potentially spilling water on the track. | The motors and motor controllers will not be cooled properly, potentially causing an overtemperature. | 3 | A sudden leak of boiling water could cause burning to nearby operators. | 2 | The cooling system is properly connected with industry standard fittings and fasteners in order to lessen the likelihood of a coolant leak. | Visual detection or the motor controllers can detect overtemperatures. | 1 | A leak in the coolant system will be easy to spot visually due to the trail of water left behind the vehicle. Should the coolant level get too low, the motor controllers will identify if the motors or controllers are too hot, and turn off accordingly. | 6 | The motor controllers would turn off if the motors or controllers overheat. | The team will connect a serial monitor to the motor controllers in order to diagnose the tractive system shutdown. Once a coolant problem is identified the tractive system will be turned off, but the coolant pump will be left on to find the leak.
35 | Motor Resolver | Measures angular motor position | Motor position resolver failed | The motor resolver could be struck by debris or a wire could come loose between the resolver and the motor controller. Additionally the motor resolver may suffer from electromagnetic radiation noise due to the high current motor it is attached to. | If broken, the motor resolver will deliver an incorrect position signal to the motor controller. | The motors will not run properly without a proper position feedback from the resolver. | 1 | Current can still be delivered to the motor if the resolver is broken, but the motor will not turn. Therefore all of the energy will be dissipated into heat. The motor controller will then catch a motor overheat failure. | 1 | The resolver is professionally designed and manufactured, therefore it likely will not break. The LV wiring between the resolver and the motor controller is made to a professional standard. | The motors won't spin. | 1 | The motors won't spin when the tractive system is on. Additionally they will make a whining noise with increasing accelerator pedal actuation that alludes to the resolver problem. | 3 | The motors will not spin due to the resolver problem. | A serial connection will be made to the motor controller to diagnose the tractive system problem. A new resolver will be ordered from Emrax if the resolver is the problem. The wiring will be redone to professional standards if the wiring was the problem.
36 | Insulation Monitoring Device | Monitoring the insulation of the tractive system | Insulation Monitoring Device lost connection to reference ground | The IMD connector could come loose, resulting in a lost connection to ground. | The IMD will throw an error. | Once the IMD throws an error the latching circuit attached to the IMD output will cause the shutdown circuit to turn off the car. | 1 | A hardwired shutdown signal turns off the car when the IMD loses reference ground. | 1 | Connectors are fabricated to professional standards, therefore this failure is unlikely to occur. | The IMD will fail. | 1 | A failed IMD will actuate the shutdown circuit causing the car to turn off. | 3 | The car will turn off, and won't turn on afterwards. | A multimeter will be connected to the measurement port of the IMD such that the issue can be identified. Then the IMD ground strap will be replaced.
37 | Insulation Monitoring Device | Monitoring the insulation of the tractive system | Insulation Monitoring Device lost connection to HV+ | The IMD connector could come loose, resulting in a lost connection to HV+. | The IMD will throw an error. | Once the IMD throws an error the latching circuit attached to the IMD output will cause the shutdown circuit to turn off the car. | 5 | A hardwired shutdown signal turns off the car when the IMD loses reference ground. However a loose HV+ signal could be fatal if an operator were to come in contact with it. | 1 | Connectors are fabricated to professional standards, therefore this failure is unlikely to occur. | The IMD will fault. | 1 | A failed IMD will actuate the shutdown circuit causing the car to turn off. | 7 | The car will turn off, and won't turn on afterwards. | A multimeter will be connected to the measurement port of the IMD such that the issue can be identified. Then the IMD HV+ connector will be replaced.
38 | Insulation Monitoring Device | Monitoring the insulation of the tractive system | Insulation Monitoring Device lost connection to HV- | The IMD connector could come loose, resulting in a lost connection to HV-. | The IMD will throw an error. | Once the IMD throws an error the latching circuit attached to the IMD output will cause the shutdown circuit to turn off the car. | 5 | A hardwired shutdown signal turns off the car when the IMD loses reference ground. However a loose HV+ signal could be fatal if an operator were to come in contact with it. | 1 | Connectors are fabricated to professional standards, therefore this failure is unlikely to occur. | The IMD will fault. | 1 | A failed IMD will actuate the shutdown circuit causing the car to turn off. | 7 | The car will turn off, and won't turn on afterwards. | A multimeter will be connected to the measurement port of the IMD such that the issue can be identified. Then the IMD HV- connector will be replaced.
39 | Insulation Monitoring Device | Monitoring the insulation of the tractive system | Insulation Monitoring Device lost power supply | The IMD connector could come loose, resulting in a lost connection to the +12V power supply. | The IMD will turn off. | The latching relay attached to the IMD output will not be powered, turning off the car. | 1 | A hardwired shutdown signal turns off the car when the IMD loses power. | 1 | Connectors are fabricated to professional standards, therefore this failure is unlikely to occur. | The IMD will turn off. | 1 | The IMD will turn off causing the latching relay on its output to turn off the car. | 3 | The car will turn off, and won't turn on afterwards. | The voltage of the GLVS will be traced through the shutdown circuit until the fault is found at the IMD power. The connection will be replaced with a new one to industry standards.
40 | Insulation Monitoring Device | Monitoring the insulation of the tractive system | Insulation Monitoring Device has a general fault | The IMD could have a software fault internal to itself. | The IMD will throw an error. | Once the IMD throws an error the latching circuit attached to the IMD output will cause the shutdown circuit to turn off the car. | 3 | An undetected (by the IMD) internal error could cause the IMD to stop working potentially allowing an isolation fault to occur without being detected. | 1 | Connectors are fabricated to professional standards, therefore this failure is unlikely to occur. | The IMD will fault. | 3 | A failed IMD will actuate the shutdown circuit causing the car to turn off if the IMD detects the fault. If it doesn't then the car will continue to run as if everything were normal. | 7 | The car will turn off, and won't turn on afterwards. | A multimeter will be connected to the measurement port of the IMD such that the issue can be identified. Then proper action can be taken based on the IMD response.
41 | Insulation Monitoring Device | Monitoring the insulation of the tractive system | Connection between Insulation Monitoring Device and powerstage to open the shutdown circuit is broken | The powerstage to open the shutdown circuit is internal to the IMD. A relay is powered by this powerstage. If the wiring to the latching relay breaks, this failure could occur. | The IMD will turn off. | The latching relay attached to the IMD output will not be powered, turning off the car. | 1 | A hardwired shutdown signal turns off the car when the IMD loses its connection to the power relay | 1 | Connectors are fabricated to professional standards, therefore this failure is unlikely to occur. | The IMD will turn off. | 1 | The IMD will turn off causing the latching relay on its output to turn off the car. | 3 | The car will turn off, and won't turn on afterwards. | The voltage of the GLVS will be traced through the shutdown circuit until the fault is found at the IMD power. The connection will be replaced with a new one to industry standards.
42 | Insulation Monitoring Device | Monitoring the insulation of the tractive system | Powerstage (relay/transistor) to open the shutdown circuit is broken | If the latching relay on the output of the IMD breaks by failing closed, the car could be powered even if there is an IMD error. | The IMD will not be able to control the shutdown circuit. | The car will turn on despite there being a potential TS/GLVS isolation problem. | 5 | Potentially lethal effect due to exposure to a voltage of over 60V with the ability to source over 100mA. | 1 | Mechanical relays don't often fail closed unless too much current is passed through them. Our relay is properly sized for the GLVS. | The IMD on button will be bypassed. | 1 | The car will turn on without an operator pressing the IMD on button. This will immediately cause alarm such that the car will be turned off and examined. | 7 | The car will turn on without pressing the IMD on button. Additionally it won't be protected by the IMD. | The latching relay will have to be replaced when the car is turned off.
43 | Insulation Monitoring Device | Monitoring the insulation of the tractive system | Insulation Monitoring Device not installed | In the haste of trying to make a dynamic event the IMD could be left off of the car. | The latching relay will not be powered by the IMD OK signal. | None of the other systems will be powered past the shutdown circuit. | 1 | The car won't turn on. | 2 | It is plausible that the IMD is not installed accidentally in the excitement of competition or testing. | The car won't turn on. | 1 | The latching circuit won't be powered by the Okhs signal of the IMD, therefore the car won't turn on. | 4 | The car won't turn on without the IMD. | The IMD will be installed by the team.
44 | Accumulator Management System | Monitoring the accumulator condition | AMS Master has a general fault (CPU/Software erroneous) | The AMS could have an internal software fault. | The AMS may lock in its current state, leaving the contactors powered despite the driver signalicing for them to be opened. | The tractive system would turn off and the fault would be displayed to the driver on the dashboard. | 5 | If the AMS is locked in the on state, the driver may turn off the car, press the throttle, and unintentionally accelerate the car into another person or barrier. | 1 | The AMS is manufactured by professionals, therefore this fault is not likely to occur. Additionally this team has been using the same AMS for over 3 years and an error like this has never occurred (although causation does not imply correlation). | The AMS will turn off the AIRs. | 1 | The AMS will turn off the AIRs such that the tractive system is not powered. Additionally the driver will see the AMS fault light on the dashboard. If the AMS is locked on, then the driver will notice that the throttle pedal still powers the car, despite the car being off. | 7 | The vehicle will not move with the AIRs open. | The AMS will be updated with new software remotely through the manufacturer - eLithion.
45 | Accumulator Management System | Monitoring the accumulator condition | AMS Slave has a general fault (CPU/Software erroneous) | The AMS cell boards could have an error in their digital signal processing one-wire communication chip. | The cell board would scramble the one-line communication protocol that occurs between the master and the slave for that accumulator stack (four stacks total). | The AMS would recognize that the communication protocol failed on that stack and would report a failure. | 4 | Potentially incorrect data could reach the AMS, allowing for a cell overcurrent which could cause the cell to overheat. Lithium iron cells are not as catastrophically dangerous as Lithium Cobalt cells in this situation, but could still cause a fire. | 1 | The AMS is manufactured by professionals, therefore this fault is not likely to occur. Additionally this team has been using the same AMS for over 3 years and an error like this has never occurred (although causation does not imply correlation). | The AMS will turn off the AIRs. | 1 | The AMS will turn off the AIRs such that the tractive system is not powered. Additionally the driver will see the AMS fault light on the dashboard. | 6 | The vehicle will not move with the AIRs open. | The AMS cell board will be replaced with a new one while the operator wears proper PPE.
46 | Accumulator Management System | Monitoring the accumulator condition | Temperature Sensor is faulty | The AMS cell boards could have an improperly installed temperature sensor that reports faulty values. | The cell board would not monitor the cell's temperature properly, potentially allowing for over/under-temperature conditions. | The rest of the car would continue working unless the AMS reported a false-negative or a correct over/under-temperature of the cell it is monitoring. | 4 | The cells could reach too high or low of a temperature if the sensor is reporting a false-positive. This could result in the cells expanding and outgassing through the vent designed into the cell. Lithium iron cells are not as catastrophically dangerous as Lithium Cobalt cells in this situation, but could still cause a fire. | 1 | The AMS is manufactured by professionals, therefore this fault is not likely to occur. | The AMS will turn off the AIRs if the temperature sensor reads out of bounds. | 3 | The temperature of the failed cell board will have to be monitored along with the rest of the cell boards to determine if that cell board isn't following the trend. | 8 | The vehicle will work normally unless the cell board reports an out of bounds temperature. | The AMS cell board will be replaced with a new one while the operator wears proper PPE.
47 | Accumulator Management System | Monitoring the accumulator condition | Signal connection to temperature sensor is broken | The on-board temperature sensor could be thermally insulated such that it is not measuring the correct cell temperature. | The cell board would not monitor the cell's temperature properly, potentially allowing for over/under-temperature conditions. | The rest of the car would continue working unless the AMS reported a false-negative or a correct over/under-temperature of the cell it is monitoring. | 4 | The cell board would follow ambient temperature of the accumulator closer than the temperature of the cell board it is supposed to be monitoring. This means that the cell could be a much higher temperature than is reported. Lithium iron cells are not as catastrophically dangerous as Lithium Cobalt cells in this situation, but could still cause a fire. | 1 | The AMS is manufactured by professionals, therefore this fault is not likely to occur. Additionally the cell boards are placed within about a millimeter of the pouch cell tabs resulting in a good thermal connection. | The AMS will turn off the AIRs if the temperature sensor reads out of bounds. | 3 | The temperature of the failed cell board will have to be monitored along with the rest of the cell boards to determine if that cell board isn't following the trend. | 8 | The temperature of that cell will lag behind the rest. This will be visible by looking at the temperatures of all of the cells in that stack at the same time. | The AMS cell board will be replaced with a new one while the operator wears proper PPE.
48 | Accumulator Management System | Monitoring the accumulator condition | Voltage sense input is broken | The AMS cell boards could have an improperly installed voltage sensor that reports faulty values. | The cell board would not monitor the cell's voltage properly, potentially allowing for over/under-voltage conditions. | The rest of the car would continue working unless the AMS reported a false-negative or a correct over/under-voltage of the cell it is monitoring. | 4 | The cells could reach too high or low of a voltage if the sensor is reporting a false-positive. This could result in the cells expanding and outgassing through the vent designed into the cell. Outgassing could cause a fire, which is a potential danger to the driver and operators | 1 | The AMS is manufactured by professionals, therefore this fault is not likely to occur. | The AMS will turn off the AIRs if the voltage sensor reads out of bounds. | 3 | The voltage of the failed cell board will have to be monitored along with the rest of the cell boards to determine if that cell board isn't following the trend. | 8 | The vehicle will work normally unless the cell board reports an out of bounds voltage. | The AMS cell board will be replaced with a new one while the operator wears proper PPE.
49 | Accumulator Management System | Monitoring the accumulator condition | Voltage sense wire is broken | The voltage sensor wire could be improperly installed causing an open connection between the cell tab and the AMS board. | The cell board would read an open circuit for the cell's voltage. | The AMS would detect the open circuit through the slave's one-wire communication. | 4 | A cell would be completely unmonitored, potentially allowing for the cell to be overcharged or overdischarged. This could cause outgassing and a fire | 1 | The AMS cell board wiring is done to professional standards, therefore this failure is not likely to occur. | The AMS will turn off the AIRs if an open voltage is read. | 1 | The AMS will detect the open circuit. | 6 | Connecting a serial monitor to the AMS will show an open circuit on the exact cell board that is having a failure. | The AMS cell board voltage sense connection will be rewired to professional standards while wearing proper PPE.
50 | Accumulator Management System | Monitoring the accumulator condition | Overcurrent in the voltage sense wire | A short within the internal circuitry of the cell board could cause an overcurrent between the voltage sense wires of a single cell board. | The cell board would likely be destroyed. | The one-wire communication across that cell board's stack would stop working. The AMS would notice this and turn off the AIRs. | 4 | A cell would be completely unmonitored, potentially allowing for the cell to be overcharged or overdischarged. This could cause outgassing and a fire | 1 | The AMS is manufactured by professionals, therefore this fault is not likely to occur. | The AMS will turn off the AIRs. | 1 | The AMS will detect the issue in the one-wire communication between that stack's cell boards, resulting in the AMS throwing a fault and shutting down the AIRs. | 6 | The vehicle's tractive system will turn off while the GLVS will continue working. | Connecting a serial monitor to the AMS will show which stack is having a problem. Then the cell boards can be visually inspected for damage while wearing PPE and replaced appropriately.
51 | Accumulator Management System | Monitoring the accumulator condition | Signal Connection between AMS Master and Slave is broken | An open circuit on the communication lines between the cell boards and the AMS could be caused by faulty wiring. | The AMS will detect the lack of communication from the given stack. | The AMS will turn off the tractive system and throw a fault. | 4 | If the AMS were to continue powering the contactors despite the loss of communications, a cell could be overcharged or overdischarged potentially resulting in a fire. | 1 | The AMS cell board wiring is done to professional standards, therefore this failure is not likely to occur. | The AMS will turn off the AIRs. | 1 | The AMS will detect the open circuit in the one-wire communication between that stack's cell boards, resulting in the AMS throwing a fault and shutting down the AIRs. | 6 | The vehicle's tractive system will turn off while the GLVS will continue working. | Connecting a serial monitor to the AMS will show which stack is having a problem. Then the cell board connections can be visually inspected and rewired professionally while wearing HV PPE.
52 | Accumulator Management System | Monitoring the accumulator condition | Powerstage (relay/transistor) to open the shutdown circuit is broken | The AMS shutdown circuit relay could fail closed causing the AMS to lose control of the shutdown circuit for the tractive system. | The shutdown circuit will not operate properly. | The AMS could have a fault but the shutdown circuit wouldn't remove power from the motor controllers. | 4 | If the shutdown circuit were to remain closed while the AMS was in a fault condition, a cell could be overcharged or discharged potentially resulting in a fire | 1 | The AMS shutdown circuit relay is professionaly manufactured by a reputable company and is used within its specifications. | Visual inspection of the electrical system. | 3 | The motor controllers may remain on during a HV fault, but the AIRs would open and the dashboard would show the driver a HV fault. | 8 | The vehicle would still work as normal if the AMS shutdown circuit relay broke. However if an HV fault occurred the motor controllers would be powered by LV when they shouldn't be. | The AMS shutdown circuit relay will be replaced by a suitable alternative while wearing appropriate PPE.
53 | Accumulator Management System | Monitoring the accumulator condition | Connection between AMS and powerstage to open the shutdown circuit is broken | The connection between the AMS and the AMS shutdown circuit relay could break to an open circuit, causing the AMS to lose control over the shutdown circuit for the tractive system. | The shutdown circuit will not operate properly. | The AMS could have a fault but the shutdown circuit wouldn't remove power from the motor controllers. | 4 | If the shutdown circuit were to remain closed while the AMS was in a fault condition, a cell could be overcharged or discharged potentially resulting in a fire | 1 | The AMS shutdown circuit is manufactured to professional standards, and will likely not fail due to a broken connection. | Visual inspection of the electrical system. | 3 | The motor controllers may remain on during a HV fault, but the AIRs would open and the dashboard would show the driver a HV fault. | 8 | The vehicle would still work as normal if the connection to the AMS shutdown circuit relay broke. However if an HV fault occurred the motor controllers would be powered by LV when they shouldn't be. | The connection between the AMS and the AMS shutdown circuit relay must be rewired to professional standards.
54 | Accumulator Management System | Monitoring the accumulator condition | AMS lost power supply | The wiring up to the AMS could be broken resulting in the AMS not being powered by the GLVS. | The AMS would not turn on. | The AMS would not be able to turn the AIRs on resulting in the vehicle not being able to move. | 1 | An unpowered AMS would result in the contactors opening as they are powered through the AMS. Therefore the driver would lose the ability to accelerate in the x longitidudinal axis. This is a safe condition because the brakes and steering would be unaffected. | 1 | The AMS wiring is manufactured to professional standards, and will likely not fail due to a broken connection. | The tractive system won't turn on. | 1 | Despite the tractive system being turned on from the dashboard, the AMS will not receive power and the motors won't turn. | 3 | The vehicle would not respond to the driver trying to turn it on. | The AMS connection to the GLVS would have to be rewired to professional standards.
55 | Accumulator Management System | Monitoring the accumulator condition | Cell balancing powerstage has a short circuit | The cell balancing on the cell board could short circuit due to FOD in the accumulator. Then the FOD could weld the connection shut due to the high current. | The cell would discharge at an alarming rate. | The AMS would not allow for the car to turn on, although the cell would still be discharging in the accumulator, heating up nearby cells. | 4 | The short-circuited cell could expand rapidly, venting gas into the accumulator and could potentially start a fire. | 1 | The AMS is manufactured by professionals, therefore this fault is not likely to occur. | The tractive system won't turn on. | 1 | Despite the tractive system being turned on from the dashboard, the AMS will not close the AIRs due to either the overtemperature on the cell or the broken cell board not being able to communicate to the master. | 6 | The vehicle would not respond to the driver trying to turn it on. | The driver will need to immediately evacuate the vehicle. Then the vehicle should be left to sit until the accumulator is deemed safe, namely the cell is completely discharged of potential energy. At that point the accumulator would have to be taken apart while wearing proper HV PPE, and the cell along with multiple nearby cells may need to be replaced.
56 | Accumulator Management System | Monitoring the accumulator condition | Digital communication between AMS master and slave is corrupted (e.g. bits change due to EMI) | EMI from the high current in the accumulator could cause a bit to be flipped over the digital one-wire communication line between AMS slave and master. | The AMS master would recognize the incorrect temperature/voltage data due to the checksum that the one-wire communication uses. | The AMS would shutdown the AIRs if the faulty reading persisted. | 4 | An incorrect voltage or current could be reported from a cell board to the central AMS allowing for a cell to be overcharged or overdischarged. This could cause outgassing and a fire. | 4 | This error could occur often, but the AMS is able to detect it using checksums. | The AMS automatically detects this failure via checksums. | 1 | Failure detection is built in such that our team doesn't have to worry about a few bits being flipped every now and then. | 9 | The vehicle would continue working as normal. | No action needed.
57 | Accumulator Management System | Monitoring the accumulator condition | AMS not installed | The AMS could be left out of the accumulator during construction. | The AMS would not be able to turn on the AIRs since it is not installed. | If the AIRs aren't closed then the car won't run. | 4 | If the AMS is bypassed and somehow the car is still allowed to run, the cells would be completely unmonitored. They could be overcharged or overdischarged resulting in outgassing and/or a fire. | 1 | The AMS is critical to the accumulator, and will likely not be forgotten. | The car won't run. | 1 | The car will not turn on the tractive system without the AIRs turning on. | 6 | The car won't run. | Install the AMS while wearing appropriate PPE.
58 | Tractive System Active Light | Displaying the status of the tractive system | Light emitting device broken | Semiconductor experiences overcurrent/overvoltage. | TSV visual indication would be unavailable. | Possible risk of TSV being on at inappropriate times. | 5 | Operation on the tractive system may occur despite an energized vehicle due to the TSAL not working. This could result in a fatal electrocution | 2 | Difficult to break LED when actual electronics isolated from TSV system. Overcurrent prevented via resistors. Overvoltage transients rare in non-switching power systems. | Visual confirmation of inactive LED upon activation of TSV system | 1 | LED size and brightness conspicous enough for easy visual detection. | 8 | TSV would continue to operate normally. | Lack of an indicator light would alert the team to possible electrical issues in the TSV. TSV would be shut down and discharged and the problem diagnosed.
59 | Tractive System Active Light | Displaying the status of the tractive system | Circuitry erroneous | Incorrect wiring during construction | TSV visual indication would be unavailable. | Other local GLV electronics may be effected be incorrect wiring | 5 | Operation on the tractive system may occur despite an energized vehicle due to the TSAL not working. This could result in a fatal electrocution | 2 | GLV system responsible for TSAL is on fabricated PCB, which undergoes multiple cycles of quality control | Visual confirmation of inactive LED upon activation of TSV system. TSEL light would also be conspicuously off. | 1 | LED usual size and brightness conspicous enough for easy visual detection. | 8 | TSV would continue to operate normally. | Lack of an indicator light would alert the team to possible electrical issues in the TSV. TSV would be shut down and discharged and the problem diagnosed.
60 | Tractive System Active Light | Displaying the status of the tractive system | Voltage sense connection to HV+ or HV- broken | DC-DC converter failure/wiring on the HV side could break. | TSV visual indication would be unavailable. | Tractive System Enclosure Light would also be deactivated. | 5 | Operation on the tractive system may occur despite an energized vehicle due to the TSAL not working. This could result in a fatal electrocution | 2 | Professional fabricated PCB and DC-DC converter unlikely to fail or break during nominal operation. | Visual confirmation of inactive LED upon activation of TSV system. TSEL light would also be conspicuously off. | 1 | LED usual size and brightness conspicous enough for easy visual detection. | 8 | TSV would continue to operate normally. | Lack of an indicator light would alert the team to possible electrical issues in the TSV. TSV would be shut down and discharged and the problem diagnosed.
61 | Tractive System Active Light | Displaying the status of the tractive system | Tractive system active light lost power supply | DC-DC converter failure/wiring on the GLV side could break. | TSV visual indication would be unavailable. | Tractive System Enclosure Light would also be deactivated. | 5 | Operation on the tractive system may occur despite an energized vehicle due to the TSAL not working. This could result in a fatal electrocution | 2 | Professional fabricated PCB and DC-DC converter unlikely to fail or break during nominal operation. | Visual confirmation of inactive LED upon activation of TSV system. TSEL light would also be conspicuously off. | 1 | LED usual size and brightness conspicous enough for easy visual detection. | 8 | TSV would continue to operate normally. | Lack of an indicator light would alert the team to possible electrical issues in the TSV. TSV would be shut down and discharged and the problem diagnosed.
62 | Accumulator Indicator | Shows, if more than 60VDC exist behind the AIRs | Signal connection to HV+ or HV- lost | Wiring between LED and the TSV_POS line broken | No indication of dangerous voltages on car side. | Risk of working on TSV at inappropriate times. | 5 | Working on TSV while accumulator is connected without such knowledge can lead to risk of electrocution. | 2 | Accumulator assembly to be fabricated to professional standards. Minor broken connections unlikely. | Measurement of Tractive System Measuring Points while light is off can easily reveal error. | 2 | Basic safety standards insist that one check voltages before working on TSV system. Voltages are easy to check via TSMP. | 9 | Vehicle would operate normally. | Lack of indicator light during normal vehicle operation would alert the team to the hazard. TSV would be shut down, discharged, and the problem diagnosed and resolved.
63 | Accumulator Indicator | Shows, if more than 60VDC exist behind the AIRs | Lost power supply | Wiring between TSV and accumulator broken | No indication of any voltages on car side. | No energy is delivered to TSV. Car refuses to start. | 1 | TSV is disconnected. Risk of injury is minimal. Although broken connections in general pose a safety risk. | 2 | Accumulator assembly to be fabricated to professional standards. Major broken connections extremely unlikely. | Measurement of Tractive System Measuring Points while light is off can easily reveal error. | 2 | Basic safety standards insist that one check voltages before working on TSV system. Voltages are easy to check via TSMP. | 5 | Vehicle would not start. | Lack of starting/detection of invalid TSMP voltages will alert the team to the malfunction. TSV would be disconnected, discharged, and the problem diagnosed and resolved.
64 | Accumulator Indicator | Shows, if more than 60VDC exist behind the AIRs | Circuitry erroneos | Incorrect wiring during construction | No indication of dangerous voltages on car side. Depending on error in wiring. Potential high voltage short circuit. | Depending on wiring, could cause fuse to trip. May damage portions of TSV because of transient overcurrent. | 3 | Burns and electric arcing may occur due to a short circuit in the incorrectly wired LED circuit. Unlikely due to the HV fuse. | 2 | Accumulator assembly to be fabricated to professional standards. Circuit wiring will be checked multiple times before deployment. Incorrectly wired connections extremely unlikely. | Short circuit is readily visible due to damage. Measurement of Tractive System Measuring Points while light is off can easily reveal error. | 2 | Basic safety standards insist that one check voltages before working on TSV system. Voltages are easy to check via TSMP. | 7 | Vehicle performance will vary, depen+Q69+L69:P69+K69:P69 | Basic TSMP testing can detect error. TSV would be disconnected, discharged, and the problem diagnosed and resolved.
65 | Ready-To-Drive-Sound | Indicating that the vehicle is ready-to-drive | Speaker/noise producing device broken | Speaker cone damaged | The vehicle does not produce a status sound | The driver does not have auditory signal about the energizing of the vehicle | 4 | Auditory response is a secondary system. The primary response system is the warning light. However bystanders may not see the TSAL resulting in a low speed impact | 1 | Speaker will have a mesh protection to prevent ingress of debris. | No sound is produced when the vehicle is energized | 1 | The driver and the team will expect the status sound for at least 1 second, but since the device will not produce it, they will understand that it has failed. | 6 | ECU and BMS are ignorant about the failure. The driver will depend on the expected 80 dBA auditory signal, and upon not hearing it, will summon the team. | The team will de-energize the vehicle and investigate the speakers and the circuitry. A new speaker will be plugged in to see if the error was caused by a bad sound device.
66 | Ready-To-Drive-Sound | Indicating that the vehicle is ready-to-drive | Circuitry erroneos | Speaker is wired improperly | The vehicle does not produce a status sound | The driver does not have auditory signal about the energizing of the vehicle | 4 | Auditory response is a secondary system. The primary response system is the warning light. However bystanders may not see the TSAL resulting in a low speed impact | 1 | Speaker cables will be color coded and labelled. | No sound is produced when the vehicle is energized | 1 | The driver and the team will expect the status sound for at least 1 second, but since the device will not produce it, they will understand that it has failed. | 6 | ECU and BMS are ignorant about the failure. The driver will depend on the expected 80 dBA auditory signal, and upon not hearing it, will summon the team. | The team will de-energize the vehicle and investigate the speakers and the circuitry.
67 | Ready-To-Drive-Sound | Indicating that the vehicle is ready-to-drive | Signal connection to ECU indicating ready-to-drive-mode broken | Speaker is wired improperly | The vehicle does not produce a status sound | The driver does not have auditory signal about the energizing of the vehicle | 4 | Auditory response is a secondary system. The primary response system is the warning light. However bystanders may not see the TSAL resulting in a low speed impact | 1 | Speaker cables will be color coded and labelled. | No sound is produced when the vehicle is energized | 1 | The driver and the team will expect the status sound for at least 1 second, but since the device will not produce it, they will understand that it has failed. | 6 | ECU and BMS are ignorant about the failure. The driver will depend on the expected 80 dBA auditory signal, and upon not hearing it, will summon the team. | The team will de-energize the vehicle and investigate the speakers and the circuitry.
68 | Ready-To-Drive-Sound | Indicating that the vehicle is ready-to-drive | Ready-To-Drive-Sound module not installed | No module installed | no auditory response | no auditory response | 4 | Auditory response is a secondary system. The primary response system is the warning light. However bystanders may not see the TSAL resulting in a low speed impact | 1 | unlikely, that system is uninstalled | no auditory response when expected | 1 | no sound when expected | 6 | BMS/ECU ignorant, driver calls team | Find out why it was not installed, install it
69 | Ready-To-Drive-Sound | Indicating that the vehicle is ready-to-drive | Ready-To-Drive-Sound module lost power supply | Cable gets damaged due to routing next to a snag point | The vehicle does not produce a status sound | The driver does not have auditory signal about the energizing of the vehicle | 4 | Auditory response is a secondary system. The primary response system is the warning light. However bystanders may not see the TSAL resulting in a low speed impact | 1 | Cables will be routed away from snag points and where the bodywork meets the chassis; proper wiring will be implemented. | No sound is produced when the vehicle is energized | 1 | The driver and the team will expect the status sound for at least 1 second, but since the device will not produce it, they will understand that it has failed. | 6 | ECU and BMS are ignorant about the failure. The driver will depend on the expected 80 dBA auditory signal, and upon not hearing it, will summon the team. | The team will de-energize the vehicle and investigate the speakers and the circuitry.
70 | Brake System Plausibility Device | Checking for implausibility between brake pedal sensor and power delivered to the motor(s) | Brake Pedal Sensor broken | The brake pedal potentiometer could break due to poor mechanical installation. | The BSPD would read a broken brake potentiometer as always being actuated due to a pull-down resistor. | The BSPD will activate any time the throttle is pressed. | 1 | The BSPD will always turn off the car resulting in no potentially dangerous situations. | 1 | The BSPD brake potentiometer will be professionally installed by the pedal box team to prevent it from breaking. | The car will turn itself off whenever trying to accelerate. | 1 | The car will turn on just like normal. However whenever the throttle is pressed the BSPD will turn the car off. | 3 | The car won't accelerate although it will turn on. | The team will turn off the car and examine the pedal box. Once the brake potentiometer is identified as the cause of the failure then it will be replaced in a professional manner.
71 | Brake System Plausibility Device | Checking for implausibility between brake pedal sensor and power delivered to the motor(s) | Signal connection (analog or digital) to Brake Pedal Sensor broken | The wiring to the brake pedal potentiometer could break due to poor electrical installation. | The BSPD would read an open circuit brake potentiometer as always being actuated due to a pull-down resistor. | The BSPD will activate any time the throttle is pressed. | 1 | The BSPD will always turn off the car resulting in no potentially dangerous situations. | 1 | The BSPD brake potentiometer wiring will be professionally installed by the pedal box electrical team to prevent it from breaking. | The car will turn itself off whenever trying to accelerate. | 1 | The car will turn on just like normal. However whenever the throttle is pressed the BSPD will turn the car off. | 3 | The car won't accelerate although it will turn on. | The team will turn off the car and examine the pedal box. Once the brake potentiometer wiring is identified as the cause of the failure then it will be rewired in a professional manner.
72 | Brake System Plausibility Device | Checking for implausibility between brake pedal sensor and power delivered to the motor(s) | Motor current sensor broken | The motor current sensor is internal to the Bamocar motor controller, and could break by being overheated or mechanically harmed. | The motor controller wouldn't be able to measure the current and therefore wouldn't be able to run the motor properly (because the motor controller uses feedback on two of the three output phases via shunt resistors). | That motor controller will fault out and won't be able to power the motor. | 1 | The motor controller will fault out such that the motor is not driven. | 1 | The motor controller is designed and fabricated by a professional, reputable company, and therefore will not likely break. | The motor controller won't power the motors. | 1 | The AMS and AIRs will work like normal however the motor controller will not power the motor. | 3 | The car won't accelerate although it will turn on. | The team will disconnect the HVD such that it can work on the motor controller. Then the shunt resistor will have to be replaced.
73 | Brake System Plausibility Device | Checking for implausibility between brake pedal sensor and power delivered to the motor(s) | Signal connection (analog or digital) to motor current sensor broken | The wiring between the BSPD and the motor controller for the current sensor could be broken. | The BSPD will not get proper current feedback from the motor controllers. | The BSPD has a pull-down resistor such that an open circuit to the motor controller current feedback will result in a signal similar to full throttle. This will shutdown the car through the BSPD as soon as the brakes are applied. | 1 | The BSPD will always turn off the car resulting in no potentially dangerous situations. | 1 | The BSPD current feedback wiring will be professionally installed by the powertrain electrical team to prevent it from breaking. | The car will turn itself off whenever trying to brake | 1 | The car will turn on just like normal. However whenever the brake pedal is pressed the BSPD will turn the car off. | 3 | The car will turn off as soon as the brakes are pressed. | The team will turn the car off and find the open circuit in the current feedback between the motor controllers and the BSPD. Then the current feedback wiring will be redone to professional standards.
74 | Brake System Plausibility Device | Checking for implausibility between brake pedal sensor and power delivered to the motor(s) | Brake system plausibility device lost power supply | The wiring between the BSPD and the GLVS could be broken. | The BSPD will not be powered and will therefore not power its shutdown circuit relay coil. | Without the BSPD relay powered, the car will not turn on. | 1 | An unpowered BSPD will prevent the car from turning on. | 1 | The BSPD power wiring will be professionally installed to prevent it from breaking in this manner. | The car will not turn on. | 1 | The BSPD power relay that is part of the shutdown circuit will not have its coil powered without the BSPD getting powered. | 3 | The car won't turn on. | The team will turn the car off and find the open circuit in the BSPD power circuit. Then the power wiring will be redone to professional standards.
75 | Brake System Plausibility Device | Checking for implausibility between brake pedal sensor and power delivered to the motor(s) | Powerstage (relay/transistor) to open the shutdown circuit is broken | The BSPD power relay could fail closed due to a current transient or repeated use. | The BSPD will not be able to control the shutdown circuit. | The car will continue running even though the BSPD may signal a fault. | 4 | The BSPD is meant to prevent an unintended acceleration. With the BSPD not working the driver will have to end an unintended acceleration by hitting the dashboard E-stop, which may be too late therefore causing a crash. | 1 | The power relay will be properly sized and bought from a professional, reputable manufacturer. | The driver will have to notice the problem. | 3 | The driver will have to notice that the BSPD is not working by actuating the brakes and the throttle at the same time. | 8 | The car will run as normal, but will not be protected from unintended accelerations. | The team will turn the car off and replace the BSPD shutdown circuit relay.
76 | Brake System Plausibility Device | Checking for implausibility between brake pedal sensor and power delivered to the motor(s) | Connection to powerstage to open the shutdown circuit is broken | The wiring between the BSPD and the BSPD power relay coil could be broken. | The BSPD relay coil will not be powered and will therefore not power its shutdown circuit relay contact. | Without the BSPD relay powered, the car will not turn on. | 1 | An unpowered BSPD will prevent the car from turning on. | 1 | The BSPD relay coil wiring will be professionally installed to prevent it from breaking in this manner. | The car will not turn on. | 1 | The BSPD will not allow for the car to turn on because the BSPD relay coil will not be powered due to the open circuit. | 3 | The car won't turn on. | The team will turn the car off and find the open circuit in the BSPD power circuit. Then the power wiring will be redone to professional standards.
77 | Brake System Plausibility Device | Checking for implausibility between brake pedal sensor and power delivered to the motor(s) | Brake system plausibility device not installed | The BSPD could be forgotten between competitions as Formula Hybrid does not require it. | The BSPD relay coil would not be powered without a BSPD. | The car will not turn on without the BSPD relay coil being powered. | 1 | The lack of a BSPD will prevent the car from turning on. | 1 | The BSPD will not be forgotten as it is a major component of the car. | The car will not turn on. | 1 | A lack of BSPD means that the BSPD relay can not be powered. | 3 | The car won't turn on. | The team will install the BSPD properly.
78 | Brake-Over-Travel-Switch | Detecting an over-travelling brake pedal | Electrical Connection to shut-down circuit broken | The wiring between the brake over travel switch and the shutdown circuit could come loose causing an open circuit. | The shutdown circuit will not operate properly. | The car will not turn on. | 1 | The car won't turn on, therefore there can be no danger from this failure. | 1 | The shutdown circuit wiring will be done to professional standards to prevent this type of failure. | The car will not turn on. | 1 | An open circuit in the shutdown circuit will prevent the car from running which will be plainly obvious to the driver and operators. | 3 | The car won't turn on. | The team will properly wire the brake over travel switch to the rest of the shutdown circuit using professional standards
79 | Brake-Over-Travel-Switch | Detecting an over-travelling brake pedal | Switch broken / does not switch | The positive stop on the brake pedal yields, causing the over-travel switch to break / not switch | The brake pedal will travel more than the design travel, potentially damaging the master cylinder. | The vehicle may fail to de-energize itself if the over-travel switch can not switch. | 5 | A damaged master cylinder would result in loss of braking. If this occurs at high speeds then the driver may lose control of the vehicle resulting in a moderate to high speed impact. | 1 | Brake pedal is designed to withstand more than 2000 N, per the rules. The positive stop is also designed accordingly such that it can take at least 2000 N without yielding. The over-travel switch is not used as part of the positive stop system. | The driver will realize that the pedal has travelled more than the design travel. In case of emergency braking, they will also notice that the vehicle has not been de-energized thanks to the status LEDs on the dashboard. | 2 | The driver may or may not understand immediately the nature of the failure, as even if the brake pedal yields, it may be unnoticeable; the LEDs on the dashboard may be obscured by sunlight or the steering wheel, momentarily. | 8 | The driver presses the BRB on the dashboard to de-energize the car. The ECU and BMS are ignorant. | The team will de-energize the car when it comes to a stop in a safe area. The nose cone will be removed and the pedal box will be inspected to determine the cause of the failure.
80 | ShutDown Button | Opening the shutdown circuit, when pushed | Electrical Connection to shut-down circuit broken | The wiring between the shutdown button and the shutdown circuit could come loose causing an open circuit. | The shutdown circuit will not operate properly. | The car will not turn on. | 1 | The car won't turn on, therefore there can be no danger from this failure. | 1 | The shutdown circuit wiring will be done to professional standards to prevent this type of failure. | The car will not turn on. | 1 | An open circuit in the shutdown circuit will prevent the car from running which will be plainly obvious to the driver and operators. | 3 | The car won't turn on. | The team will properly wire the shutdown switch to the rest of the shutdown circuit using professional standards
81 | ShutDown Button | Opening the shutdown circuit, when pushed | Button broken / does not switch | A broken shutdown button will not break the flow of current, and therefore won't break the shutdown circuit. | The shutdown circuit will not turn off the car when it should. | The car may continue running even when the operator/driver wants the car off. | 3 | Injuries may occur if the car is misbehaving while the operators are unsuccessfully trying to turn it off via the broken shutdown button | 1 | The shutdown buttons are manufactured by a professional and reputable company. Additionally they are being used within their design specifications. | The shutdown button will not shutdown the car. | 1 | If the button is pressed and the car does not turn off then it is blatant that either the button is broken or the car is wired improperly. | 5 | The car will continue to work like normal, however it won't be shutdown by that button. | The team will turn off the car and replace that shutdown button with one that works.
82 | Cockpit-mounted ShutDown Button | Opening the shutdown circuit, when pushed | Electrical Connection to shut-down circuit broken | The wiring between the cockpit shutdown button and the shutdown circuit could come loose causing an open circuit. | The shutdown circuit will not operate properly. | The driver will not be able to de-energize the car by pressing the BRB on the dashboard | 1 | The car won't turn on, therefore there can be no danger from this failure. | 1 | The shutdown circuit wiring will be done to professional standards to prevent this type of failure. | The car will not turn on. | 1 | An open circuit in the shutdown circuit will prevent the car from running which will be plainly obvious to the driver and operators. | 3 | The car won't turn on. | The team will properly wire the cockpit shutdown switch to the rest of the shutdown circuit using professional standards
83 | Cockpit-mounted ShutDown Button | Opening the shutdown circuit, when pushed | Button broken / does not switch | A broken cockpit shutdown button will not break the flow of current, and therefore won't break the shutdown circuit. | BRB on the dashboard does not work | The car may continue running even when the operator/driver wants the car off. | 3 | Injuries may occur if the car is misbehaving while the operators are unsuccessfully trying to turn it off via the broken shutdown button | 1 | The cockpit shutdown button is manufactured by a professional and reputable company. Additionally it is being used within its design specifications. | The cockpit shutdown button will not shutdown the car. | 1 | If the button is pressed and the car does not turn off then it is blatant that either the button is broken or the car is wired improperly. | 5 | The car will continue to work like normal, however it won't be shutdown by that button. | The team will turn off the car and replace the cockpit shutdown button with one that works.
84 | Tractive System Master Switch | Switches off the tractive system | Switch broken / does not switch | Mechanical failure of the switch | May remain either open or closed regardless of intended position | Tractive system may not shut down or start up | 5 | Loss of the ability to turn off the car could cause the car to be turned on when it shouldn't be. This may result in an unintended acceleration if the driver is told that the master switch is out and accidentally steps on the throttle causing the car to accelerate. Additionally there is a high voltage hazard when the car is on when it is expected to be off. | 1 | Switches are built with high reliability on their own. | The TSAL will let operators know if the switch is closed improperly | 1 | Visual inspection of the car TSAL. | 7 | Hitting the big red buttons will shutdown the vehicle when it isn't supposed to be running. | Get car back to pits and replace switch. Dissemble switch, see what went wrong.
85 | Grounded Low-Voltage System Master Switch | Switches off the GLVS | Switch broken / does not switch | Mechanical failure of the switch | May remain either open or closed regardless of intended position | GLVS may not shut down, or may not turn on | 4 | Loss of the ability to turn off the car could cause the car to be turned on when it shouldn't be. This may result in an unintended acceleration if the driver is told that the master switch is out and accidentally steps on the throttle causing the car to accelerate. | 1 | Switches are built with high reliability on their own. | Dashboard status lights will let the driver know if the switch is closed improperly | 1 | Visual inspection of the car dashboard. | 6 | Hitting the big red buttons will shutdown the vehicle when it isn't supposed to be running. | Get car back to pits and replace switch. Dissemble switch, see what went wrong.
86 | Inertia Switch | Opens the shut down circuit in case of a crash | Electrical Connection to shut-down circuit broken | A broken wire between the inertia switch and shutdown circuit could cause this failure. | The inertia switch would not be able to control the shutdown circuit. | The car would not turn on. | 1 | The vehicle won't turn on. | 1 | The wiring of the inertia switch will be done to a professional standard. | The car won't turn on. | 1 | The shutdown switch won't be actuated by the inertia switch, therefore the car won't turn on. | 3 | The car won't turn on. | The wiring of the inertia switch will have to be redone to professional standards.
87 | Inertia Switch | Opens the shut down circuit in case of a crash | Switch broken / does not switch | A broken inertia switch could cause the car to continue running even after a high velocity collision. | The inertia switch would not be able to control the shutdown circuit. | The car may not shutdown after an accident. | 4 | The vehicle may continue running if the driver passes out with his/her foot on the throttle. | 1 | The inertia switch is built by a professional and reliable company and will likely not break on its own. | The inertia switch test button can be used to check the switch. | 2 | Testing the inertia switch is as easy as using the built in functionality of the switch. However forgetting to test it could be problematic | 7 | The switch won't operate properly in a crash. | The inertia switch will have to be replaced.
88 | Inertia Switch | Opens the shut down circuit in case of a crash | Inertia Switch not installed | The inertia switch could be forgotten. | The shutdown circuit would not be complete. | The car would not turn on. | 1 | The car would not turn on. | 1 | The inertia switch is a major component of the car and will not be forgotten during manufacturing. | The car will not turn on. | 1 | The shutdown circuit will not be complete so the car will not turn on. | 3 | The car won't turn on. | The inertia switch will have to be installed.
89 | Tractive System Measurement Points | Carrying the current tractive system voltage for easy measurements | Connection to HV+ or HV- broken | A wire could be improperly installed between the TSMPs and the accumulator. | The tractive system measurement points won't give the voltage of the vehicle at the motor controller inputs properly. | The car will not report the correct tractive system voltage from the TSMPs. | 5 | If the IMD were improperly tested due to a TSMP broken connection for HV+ or HV-, then isolation may be lost due to a fauly IMD. This could cause potentially fatal acceleration if an operator were to work on the car when the vehicle was still powered. | 1 | The wiring of the TSMPs will be done to a professional standard. | The TSMPs will not show a voltage when measured. | 1 | Measuring at the TSMPs will not show a voltage even though the TSAL and TSEL are on. | 7 | The car will still run but the voltage can not be measured at the TSMPs. | The wiring to the TSMPS will have to be redone to professional standards
90 | LV-DC/DC converter | Converts TS voltage to GLVS voltage | DC/DC draws to much current | Short circuit in TSAL/TSEL indicator LEDs before fuse. | Potentially will burn out DC-DC converter. | All indicator lights attached to DC-DC converter (TSAL and TSEL) will be off | 4 | DC-DC converter may cause a fire in the accumulator container, which could be dangerous in an enclosed area such as the paddock. | 2 | Short circuits in indicator lights unlikely. External light wiring insulation chosen with respect to environmental factors. Internal light connections professional fabricated. | Visual confirmation of deactivated LEDs despite activation of TSV. | 1 | LED typically conspicuous due to brightness and size. Lack of indication conspicuous. | 7 | TSV will continue to operate normally. | Lack of an indicator light would alert the team to possible electrical issues in the TSV. TSV would be shut down and discharged and the problem diagnosed.
91 | LV-DC/DC converter | Converts TS voltage to GLVS voltage | DC/DC drains the HV-battery | Car was left unattended for indicator to drain accumulator charge | DC-DC converter no longer has voltage to convert. | All indicator lights turn off. TSV deactivates. Cells in accumulator may be undervolted. | 4 | If the DC-DC converter drains the battery too quickly it could cause a fire in the accumulator | 1 | Basic protocol dictates that TSV is shut off after work is done. Indicators and other systems prevent this level of negligence from being probable. | The AMS automatically detects accumulator cell undervoltage. TSMP measurements can easily detect undervoltage. | 1 | The AMS automatic shutdown routine occurs the moment the battery voltage dips below threshold. | 6 | The AMS will automatically respond. TSV will not work until batteries are recharged. | TSV undervoltage is easily detected due to lack of TSEL light. TSMP measurements will easily diagnose the problem. Team will remove the accumulator for recharging after disconnecting the TSV system.
92 | LV-DC/DC converter | Converts TS voltage to GLVS voltage | DC/DC overheats | Short circuit in TSAL/TSEL indicator LEDs. Or internal short circuit in the DC-DC converter. | Potentially will burn out DC-DC converter. | All indicator lights attached to DC-DC converter (TSAL and TSEL) will be off | 4 | DC-DC converter may cause a fire in the accumulator container, which could be dangerous in an enclosed area such as the paddock. | 2 | Short circuits in indicator lights unlikely. External light wiring insulation chosen with respect to environmental factors. Internal light connections professional fabricated. | Visual confirmation of deactivated LEDs despite activation of TSV. | 1 | LED typically conspicuous due to brightness and size. Lack of indication conspicuous. | 7 | TSV will continue to operate normally. | Lack of an indicator light would alert the team to possible electrical issues in the TSV. TSV would be shut down and discharged and the problem diagnosed.
93 | LV-DC/DC converter | Converts TS voltage to GLVS voltage | GLVS short circuit | Short circuit in TSAL/TSEL indicator LEDs. Or in the wires before the LEDs. | Potentially will burn out DC-DC converter, otherwise, a fuse will blow. | All indicator lights attached to DC-DC converter (TSAL and TSEL) will be off | 5 | HV may be present on the vehicle if the inputs to the DC-DC converter short to the output. This could cause fatal electrocution. | 2 | Short circuits in indicator lights unlikely. External light wiring insulation chosen with respect to environmental factors. Internal light connections professional fabricated. | Visual confirmation of deactivated LEDs despite activation of TSV. | 1 | LED typically conspicuous due to brightness and size. Lack of indication conspicuous. | 8 | TSV will continue to operate normally. | Lack of an indicator light would alert the team to possible electrical issues in the TSV. TSV would be shut down and discharged and the problem diagnosed.
94 | GLV System Supply | Supplies the GLV with energy | GLV System voltage critically low | The car could be run for so long that the GLVS voltage is very low. | The GLVS battery management system will prevent the battery from discharging. | The car will turn off. | 1 | The car will turn off due to the GLVS BMS. | 3 | The accumulator will likely run out of charge before the GLVS does. But using an already discharged GLVS battery could cause this failure. | The car will turn off. | 1 | The GLVS BMS will turn the car off. | 5 | The car won't run. | The GLVS battery will have to be recharged or replaced with another low voltage battery.
95 | Vehicle Dynamics Function / ECU | Additional influence on requested motor torque | Vehicle Dynamics Function / ECU has a general fault | A coding error in the ECU could occur. | The ECU may give an incorrect torque value to the motor controllers. | The motor controllers would still run with this incorrect torque value. | 5 | An unintentional acceleration could cause the vehicle to accelerate into a barrier or person. | 2 | It is plausible that coding errors get into the ECU. | The motor controllers won't power the motors according to the driver. | 3 | An incorrect torque value will cause the motors to run at a different torque than the driver is signaling. | 10 | The car will run but won't be smooth for the driver to use. | The ECU will have to be reprogrammed.
96 | Vehicle Dynamics Function | Additional influence on requested motor torque | Vehicle Dynamics Function / ECU circuitry is erroneous | An electrical engineering error connecting the ECU to the motor controller inputs could occur. | The ECU circuitry may give an incorrect torque value to the motor controllers. | The motor controllers would still run with this incorrect torque value. | 5 | An unintentional acceleration could cause the vehicle to accelerate into a barrier or person. | 2 | It is plausible that circuit errors get into the ECU-motor controller circuitry. | The motor controllers won't power the motors according to the driver. | 3 | An incorrect torque value will cause the motors to run at a different torque than the driver is signaling. | 10 | The car will run but won't be smooth for the driver to use. | The ECU circuitry will have to be reexamined to find potential problems causing the torque issue.
97 | Vehicle Dynamics Function | Additional influence on requested motor torque | Vehicle Dynamics Function / ECU signal connection to steering wheel sensor is broken | The wiring between the ECU and the steering wheel sensor could be broken. | The ECU will not read the correct steering wheel value. | The car will not torque vector correctly. | 4 | Incorrect steering signals sent to the microcontroller may cause it to accelerate the left and right wheels incorrectly (independently of one another) causing loss of control. | 1 | The steering wheel sensor wiring is done to professional standards to prevent this failure. | The ECU will shutdown | 1 | The ECU will shutdown the car such that this error can be diagnosed. | 6 | The car will not run. | The steering wheel sensor wiring will have to be redone to professional standards.
98 | Vehicle Dynamics Function | Additional influence on requested motor torque | Steering wheel sensor is faulty | The steering wheel sensor could break giving bad values to the ECU. | The ECU will read in incorrect steering angle values. | The car will not torque vector correctly. | 4 | Incorrect steering wheel signals sent to the microcontroller may cause it to accelerate the left and right wheels incorrectly (independently of one another) causing loss of control. | 1 | The steering wheel sensor is bought from a professional and reputable company. | The handling will not be correct. | 3 | The car will not handle correctly and the driver will be able to tell what the problem is | 8 | The car will run but not smoothly. | The steering wheel sensor will have to be replaced.
99 | Vehicle Dynamics Function | Additional influence on requested motor torque | Vehicle Dynamics Function / ECU signal connection to acceleration sensor is broken | The wiring between the ECU and the acceleration sensor could be broken. | The ECU will not read the correct acceleration value. | The car will not torque vector correctly. | 4 | Incorrect acceleration signals sent to the microcontroller may cause it to accelerate the left and right wheels incorrectly (independently of one another) causing loss of control. | 1 | The acceleration sensor wiring is done to professional standards to prevent this failure. | The ECU will shutdown | 1 | The ECU will shutdown the car such that this error can be diagnosed. | 6 | The car will not run. | The acceleration sensor wiring will have to be redone to professional standards.
100 | Vehicle Dynamics Function | Additional influence on requested motor torque | Acceleration sensor is faulty | The acceleration sensor could break giving bad values to the ECU. | The ECU will read in incorrect acceleration values. | The car will not torque vector correctly. | 4 | Incorrect acceleration signals sent to the microcontroller may cause it to accelerate the left and right wheels incorrectly (independently of one another) causing loss of control. | 1 | The acceleration sensor is bought from a professional and reputable company. | The handling will not be correct. | 3 | The car will not handle correctly and the driver will be able to tell what the problem is | 8 | The car will run but not smoothly. | The accelerationsensor will have to be replaced.
101 | Vehicle Dynamics Function | Additional influence on requested motor torque | Vehicle Dynamics Function / ECU signal connection to wheel speed sensor is broken | The wiring between the ECU and the wheel speed sensor could be broken. | The ECU will not read the correct wheel speed value. | The car will not torque vector correctly. | 4 | Incorrect wheel speed signals sent to the microcontroller may cause it to accelerate the left and right wheels incorrectly (independently of one another) causing loss of control. | 1 | The wheel speed sensor wiring is done to professional standards to prevent this failure. | The ECU will shutdown | 1 | The ECU will shutdown the car such that this error can be diagnosed. | 6 | The car will not run. | The wheel speed sensor wiring will have to be redone to professional standards.
102 | Vehicle Dynamics Function | Additional influence on requested motor torque | Wheel speed sensor is faulty | The wheel speed sensor could break giving bad values to the ECU. | The ECU will read in incorrect steering angle values. | The car will not torque vector correctly. | 4 | Incorrect wheel speed signals sent to the microcontroller may cause it to accelerate the left and right wheels incorrectly (independently of one another) causing loss of control. | 1 | The wheel speed sensor is bought from a professional and reputable company. | The handling will not be correct. | 3 | The car will not handle correctly and the driver will be able to tell what the problem is | 8 | The car will run but not smoothly. | The wheel speed sensor will have to be replaced.
103 | Regenerative Braking Function / ECU | Controls regenerative braking | Regenerative Braking Function / ECU has a general fault | The ECU code could have a fault. | The regenerative braking would occur without the driver wanting it. | The car would brake. | 4 | The car could brake without the driver wanting it to causing a collision. | 2 | The code in the ECU could be worng since it is made by students. | The car will suddenly slow down. | 1 | The car will brake on its own. | 7 | The car will not work because it will always brake. | The ECU code will have to be reprogrammed
104 | Regenerative Braking Function / ECU | Controls regenerative braking | Associated sensors fail | The regenerative braking sensors could fail on their own. | Boundary checks in the ECU code catch this sort of failure. | The ECU would shut down the car. | 4 | An associated regenerative braking sensor failing could cause the car to brake without the driver wanting it to causing a collision | 1 | The sensors are bought from reputable manufacturers. | The car will shutdown. | 1 | The car will shutdown due to the ECU command. | 6 | The car won't run. | The sensors will have to be replaced.
105 | Regenerative Braking Function / ECU | Controls regenerative braking | Connection to associated sensors fails | Wiring between the sensors and the ECU could fail. | The ECU pull-down resistors would catch the out of bounds analnog value. | The ECU would shut down the car. | 4 | An associated regenerative braking sensor failing could cause the car to brake without the driver wanting it to causing a collision | 1 | The wiring is done to professional standards. | The car will shutdown. | 1 | The car will shutdown due to the ECU command. | 6 | The car won't run. | The wiring will have to be redone to professional standards.
106 | Regenerative Braking Function / ECU | Controls regenerative braking | Rear wheel regenerative braking is activated at high-speed by mistake | Error in the ECU code. | The rear wheels lose traction. | The car enters an uncontrollable spin. | 4 | An error in the ECU could cause the car to brake without the driver wanting it to causing a collision | 2 | The regenerative braking ECU code will be looked at closely such that this type of problem doesn't happen. | The ECU code has checks for this type of failure. | 1 | The ECU does not allow for the car to regeneratively brake at high levels at high speesd. | 7 | The car checks for bad regenerative braking decisions by the driver. | N/A.
107 | Charger | Controls charging the accumulator | Connector is live when not connected | There could be a short in the charger. | The connector will be live. | Everything else will be normal. | 4 | A live wire could cause a potential hazard to operators. | 1 | The charger is made by a professional and reputable company. | The charger light will show that it is live. | 1 | The charger light will show that the output of the charger is live and therefore should be avoided. | 6 | The charging will still work as normal, but won't shutoff properly. | The charger needs to be replaced.

Sheet: Revision
Rev | Date | Name | Changes | Reason
1 | 2015-11-19 | P.Piper | First Rev | N/A
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
