BDR16/svn-migration-dump/Electrical/Schematic PDFs/hv battery.pdf

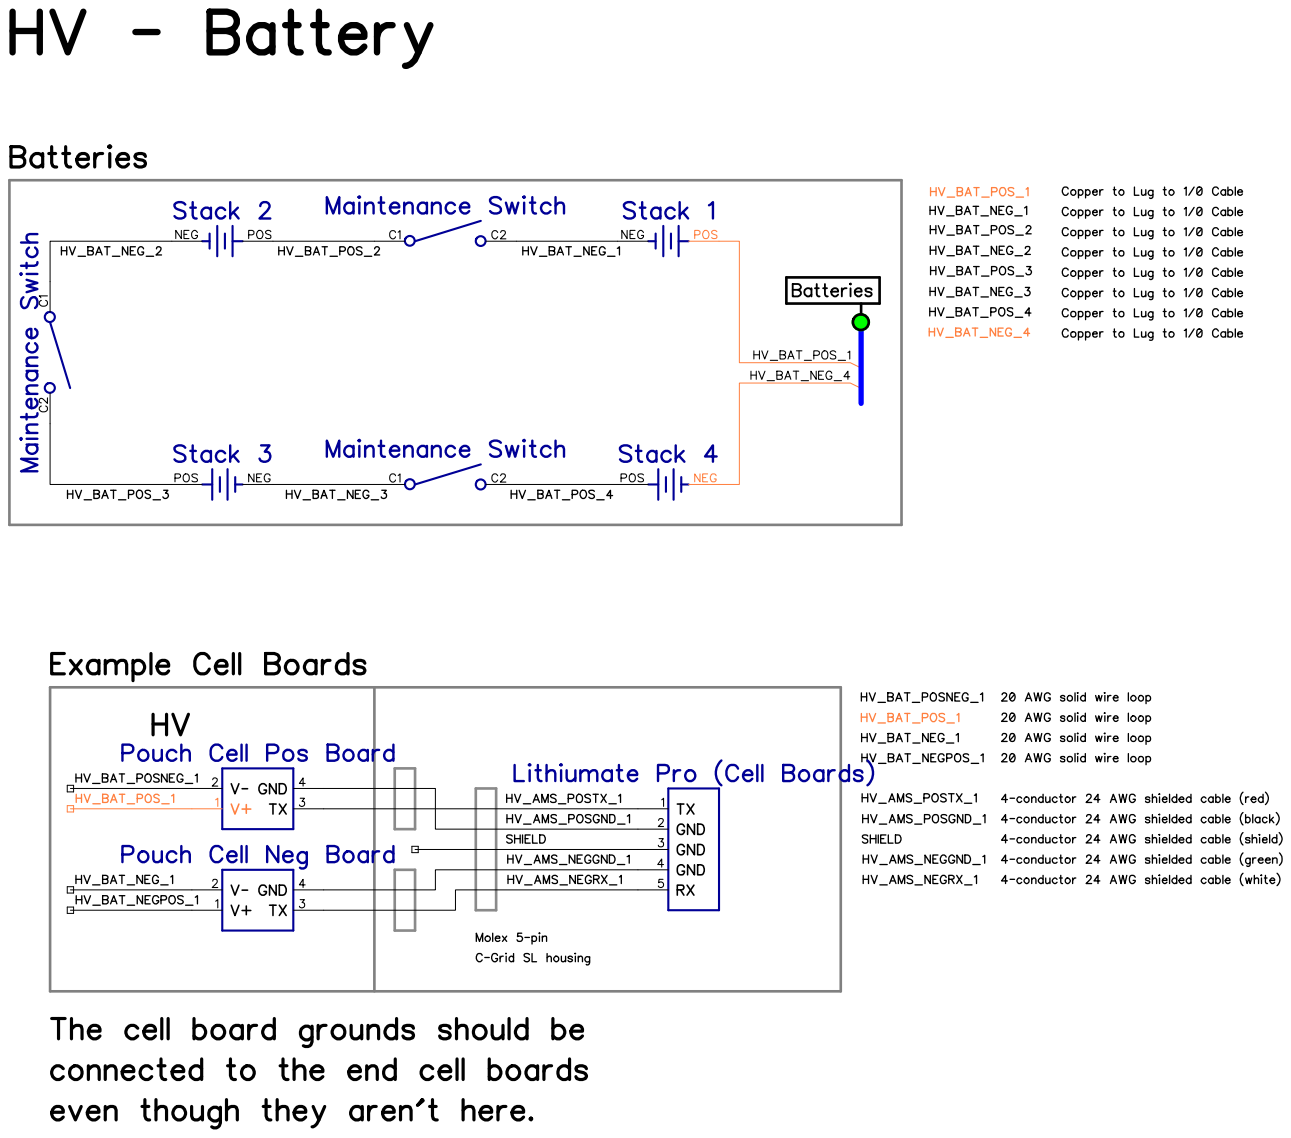
[picture p245: page 1]
