BDR16/svn-migration-dump/Electrical/Schematic PDFs/hv charging.pdf

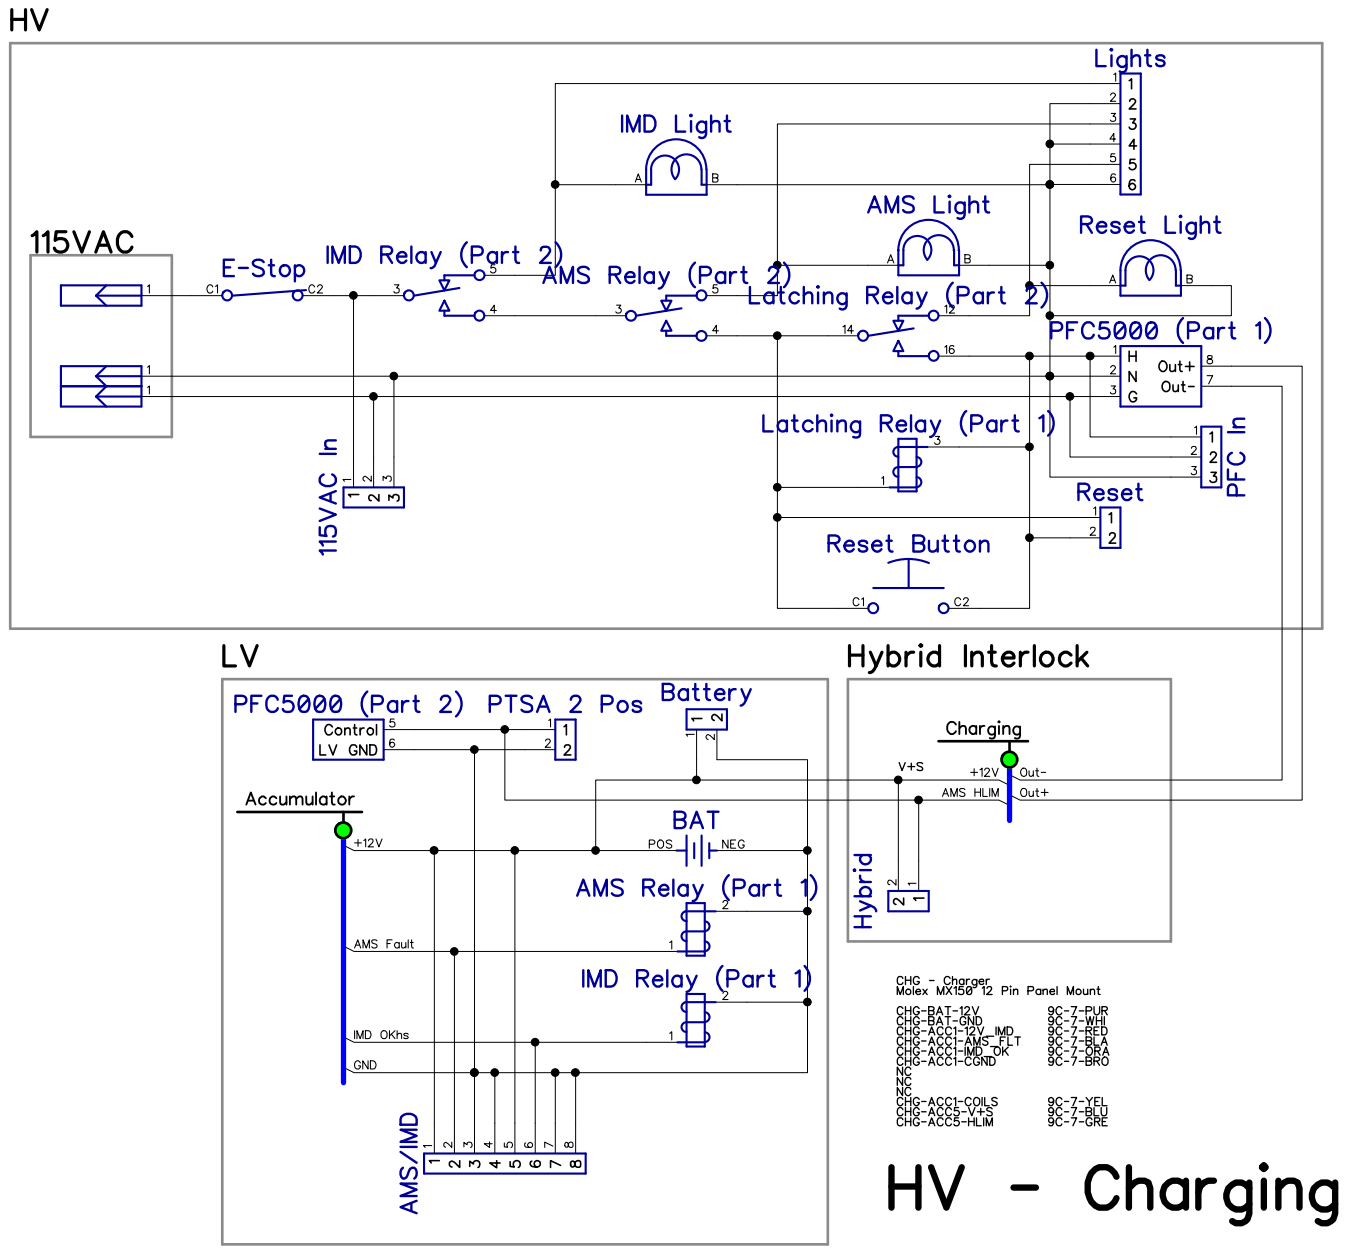
[picture p246: page 1]
