BDR16/svn-migration-dump/Electrical/Schematic PDFs/hv control.pdf

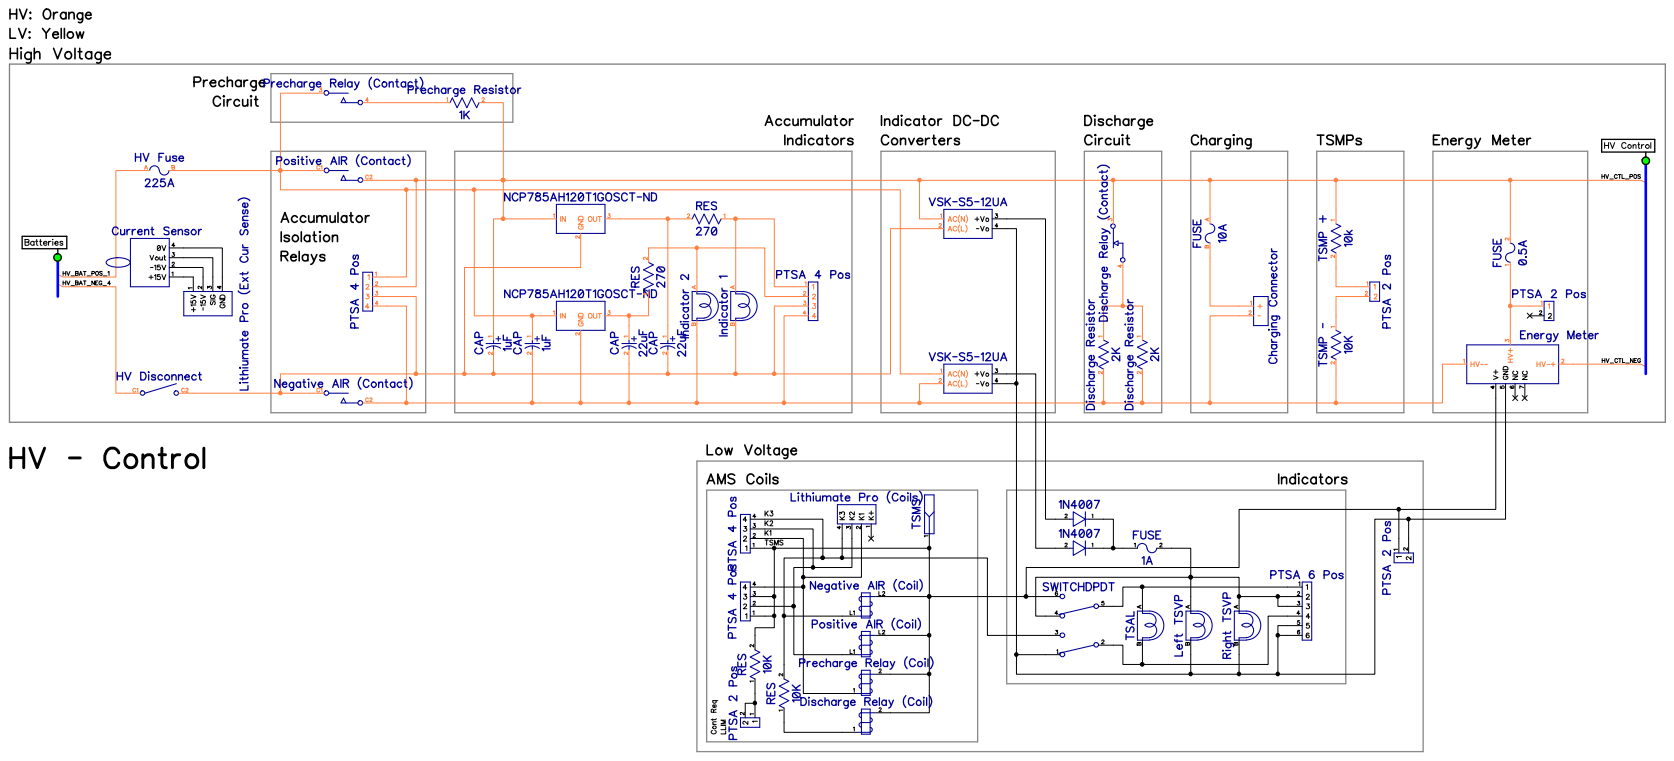
[picture p247: page 1]
