BDR16/svn-migration-dump/Electrical/Schematic PDFs/hv motors.pdf

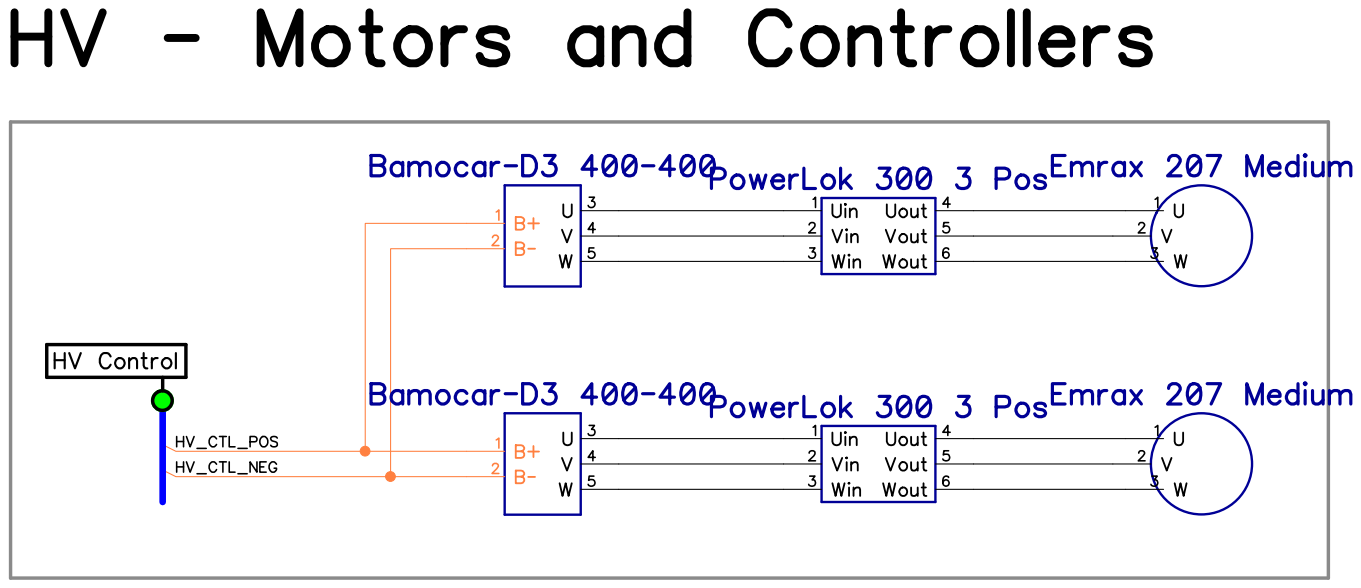
[picture p248: page 1]
