BDR16/svn-migration-dump/Electrical/Schematic PDFs/lv accumulator.pdf

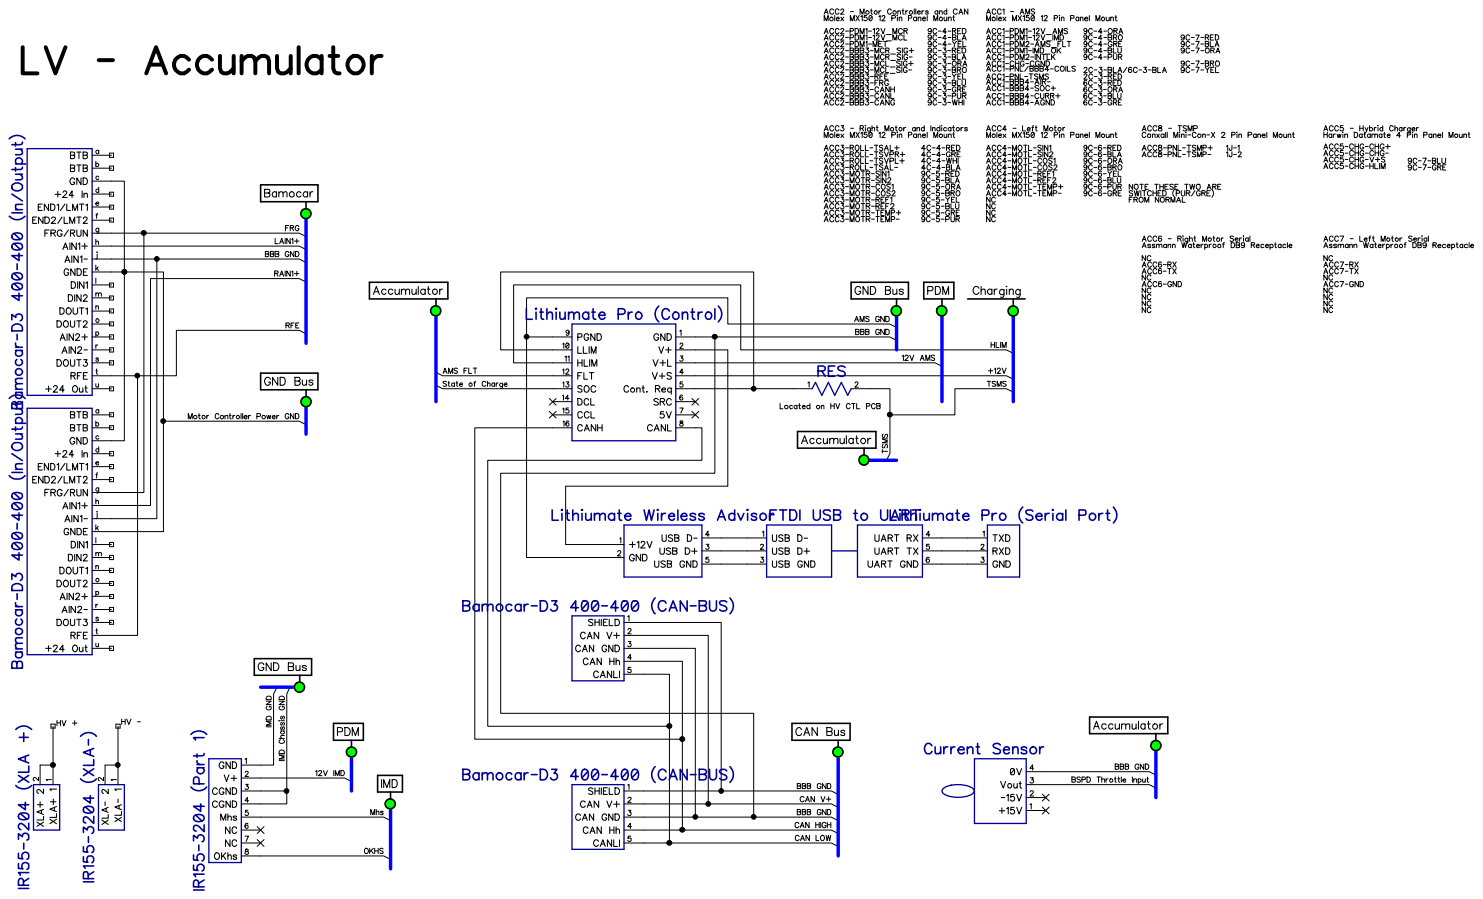
[picture p249: page 1]
