BDR16/svn-migration-dump/Electrical/Schematic PDFs/lv beaglebone.pdf

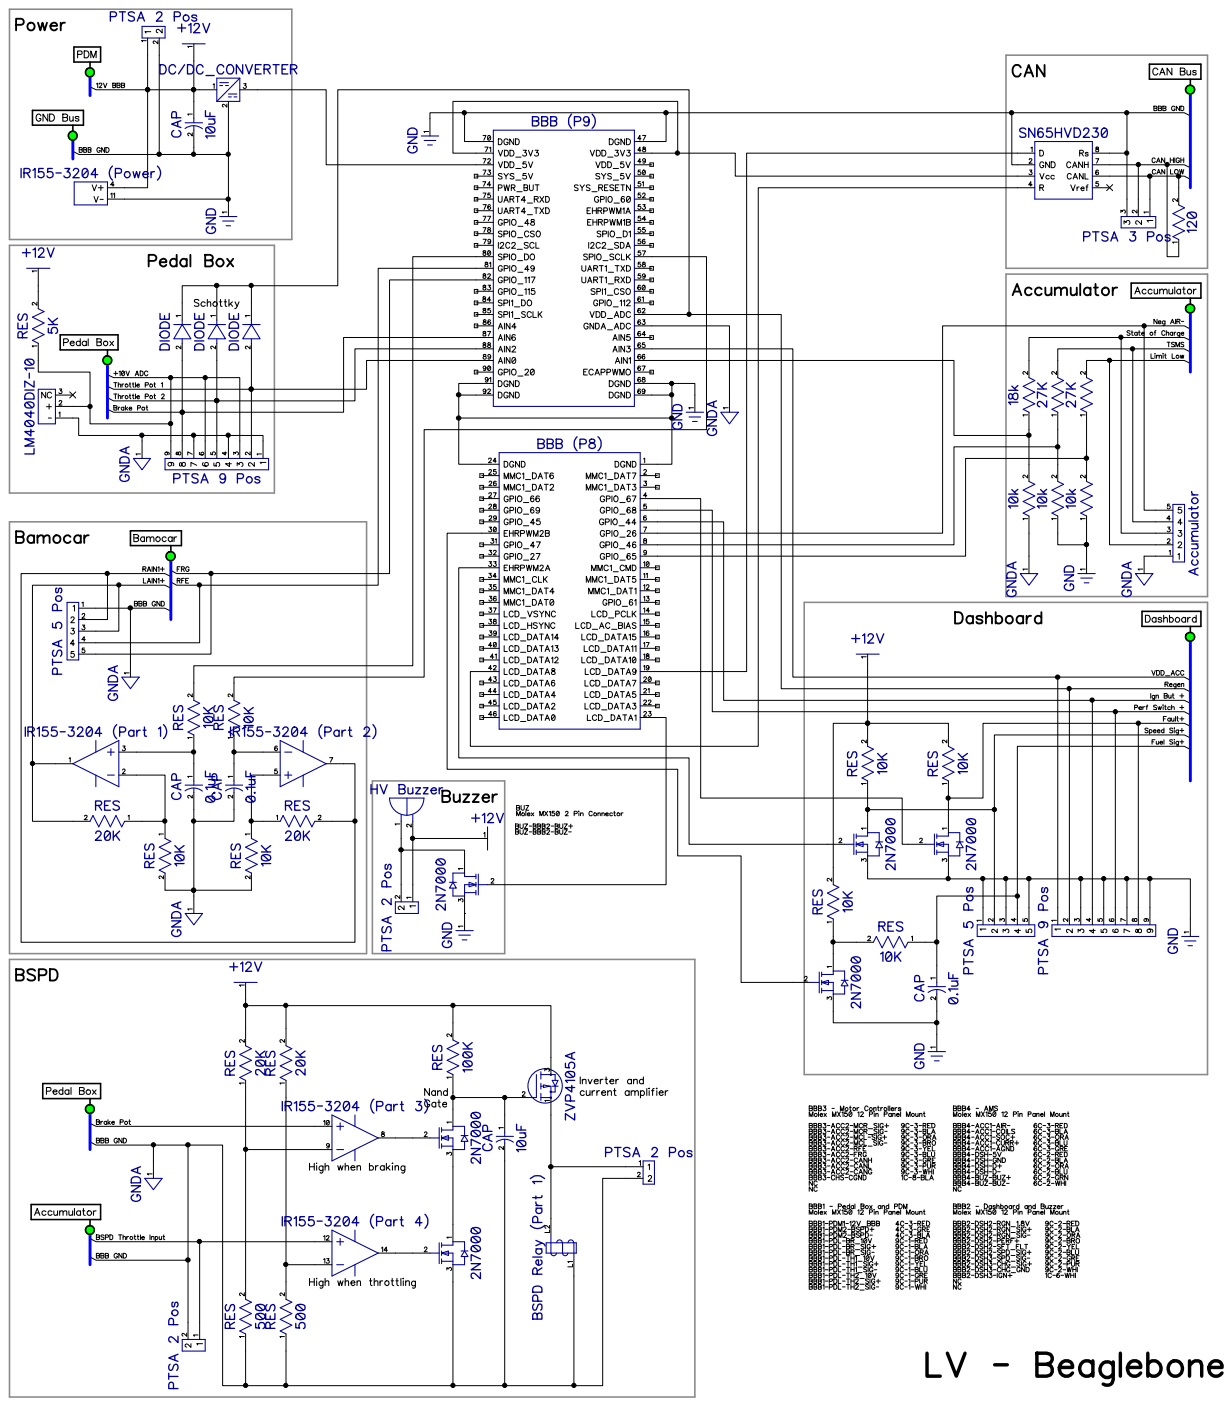
[picture p250: page 1]
