BDR16/svn-migration-dump/Electrical/Schematic PDFs/lv dashboard.pdf

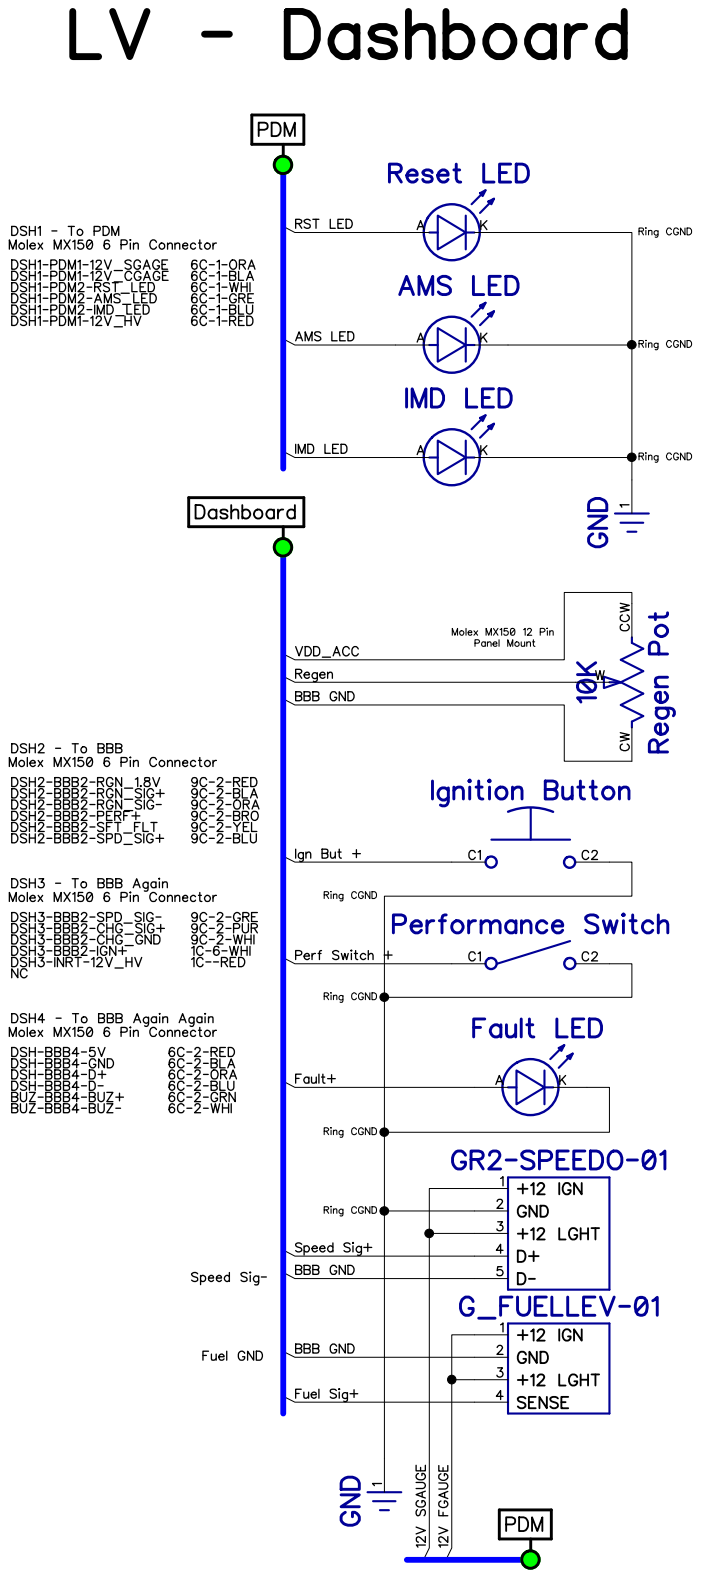
[picture p251: page 1]
