BDR16/svn-migration-dump/Electrical/Schematic PDFs/lv instrumentation.pdf

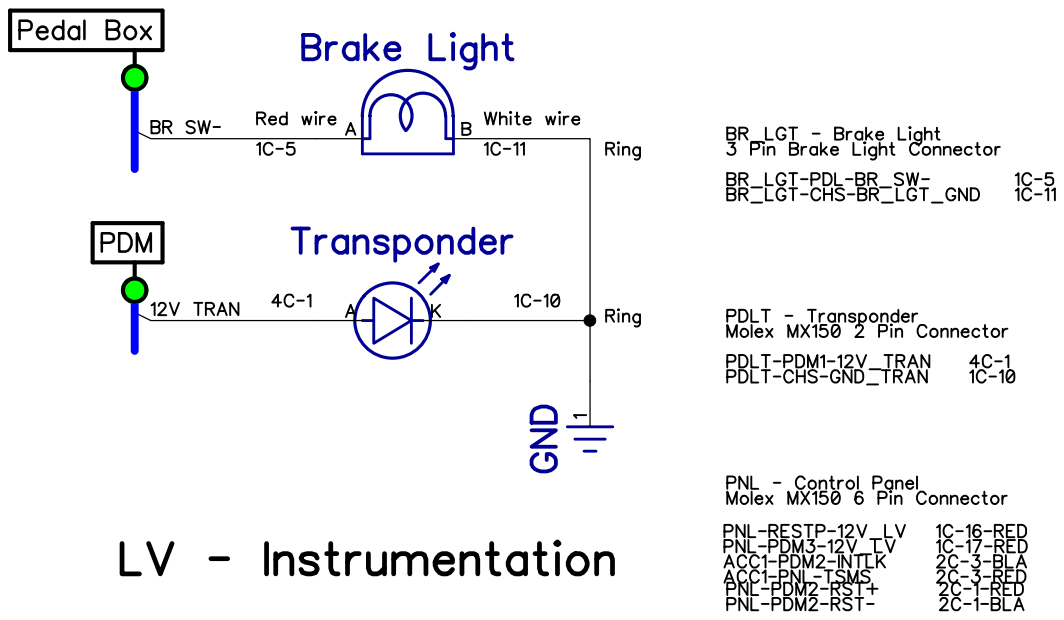
[picture p252: page 1]
