BDR16/svn-migration-dump/Electrical/Schematic PDFs/lv PDM.pdf

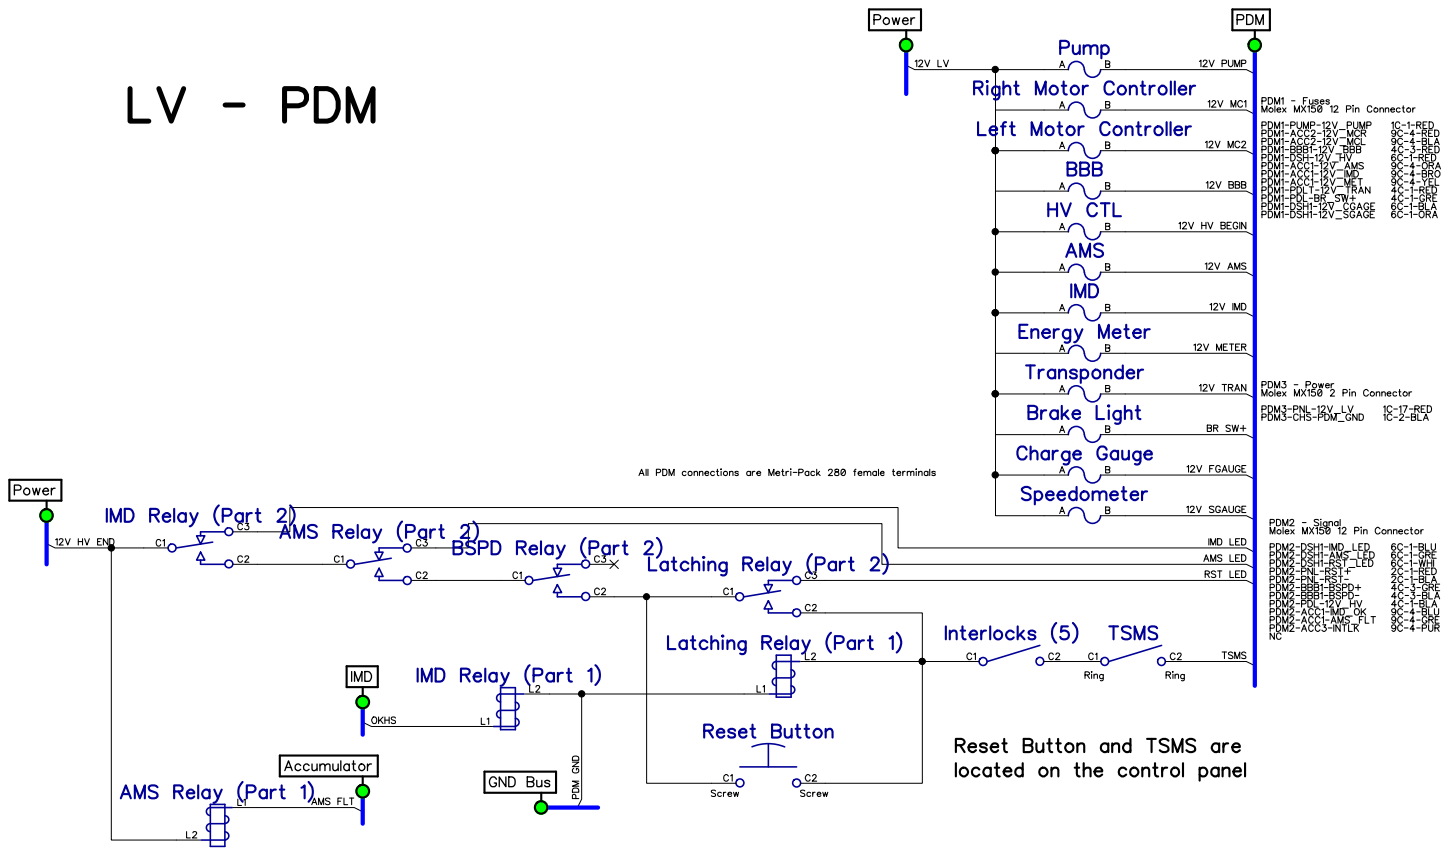
[picture p253: page 1]
