BDR16/svn-migration-dump/Electrical/Schematic PDFs/lv pedal box.pdf

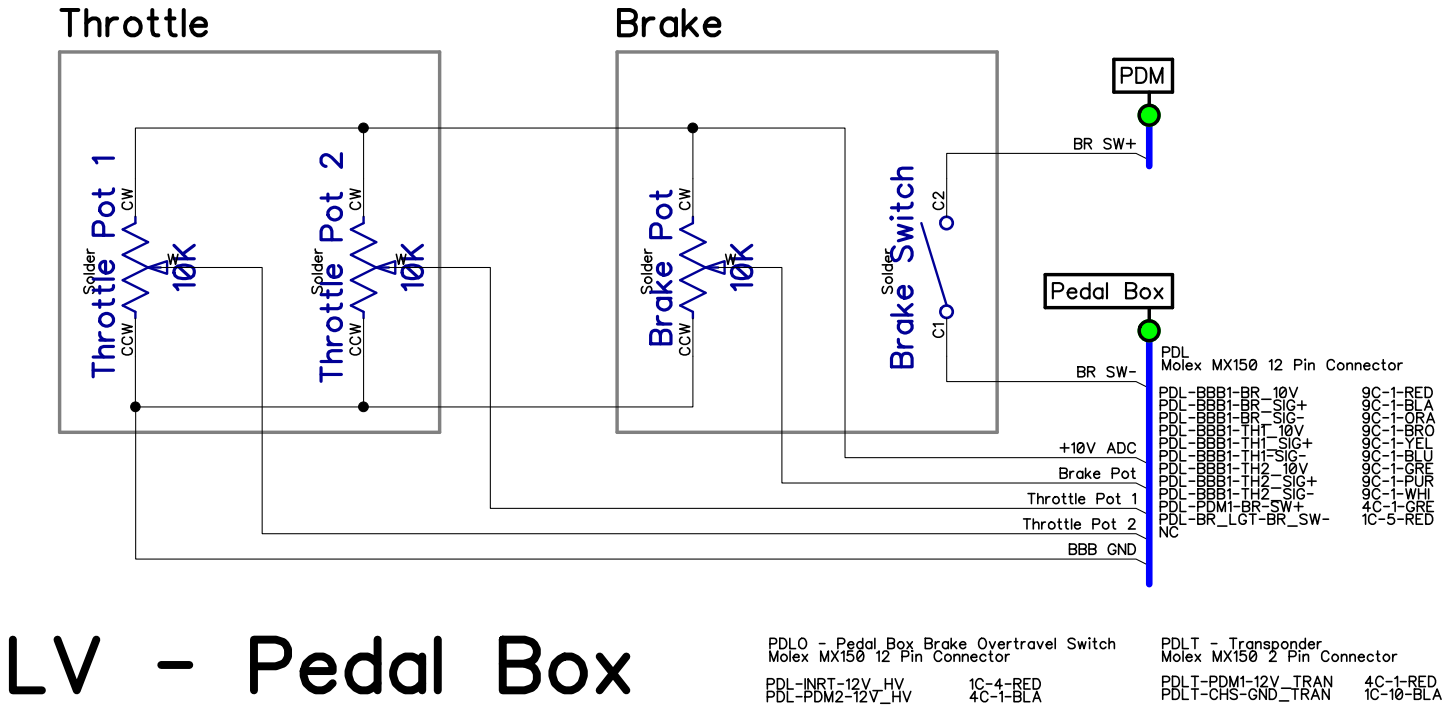
[picture p254: page 1]
