BDR16/svn-migration-dump/Electrical/Schematic PDFs/lv power.pdf

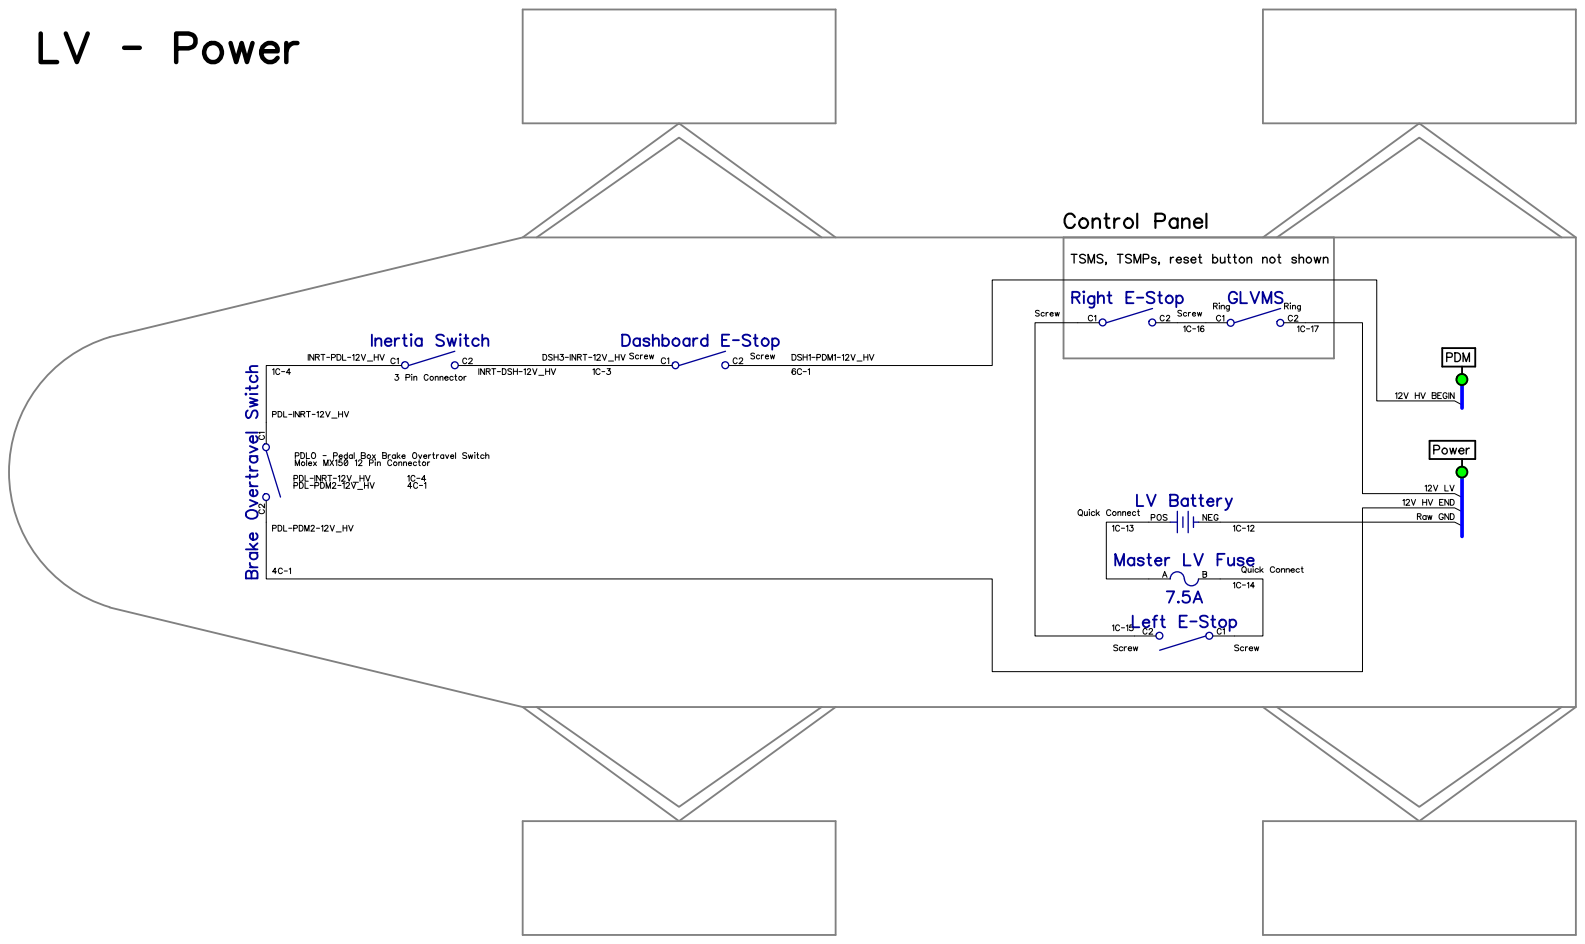
[picture p255: page 1]
