BDR16/svn-migration-dump/Mechanical/Wheel Assemblies/Suspension/Members/Wishbones/Pull Rod Tab Miters.pdf

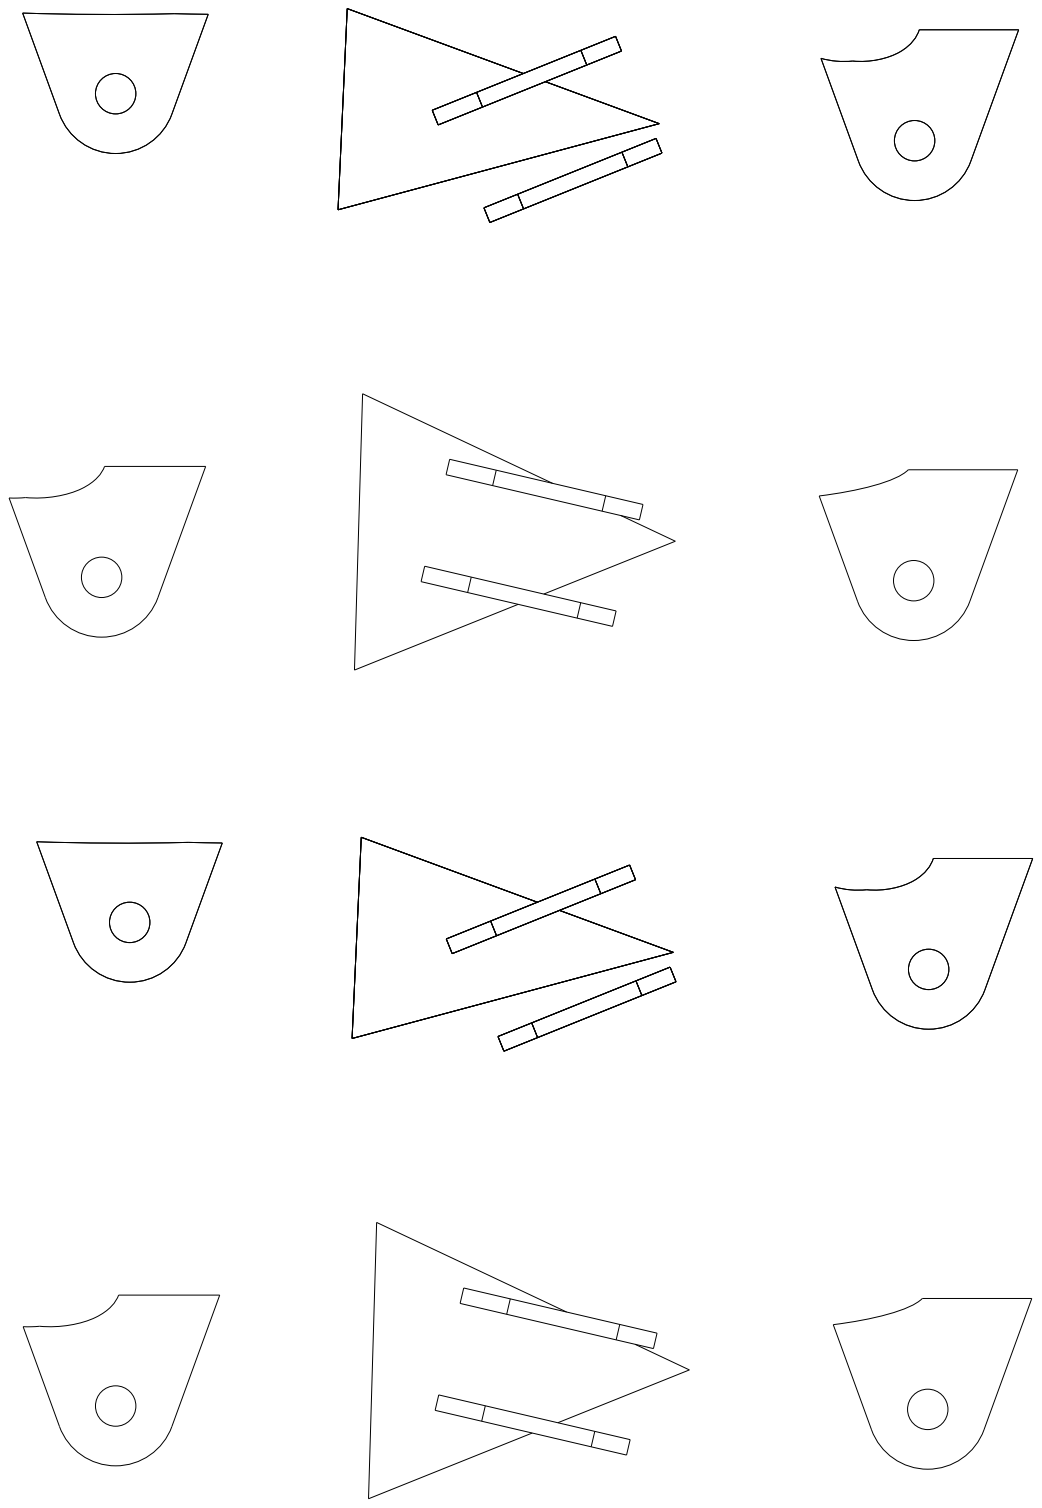
[picture p256: page 1]
