BDR16/svn-migration-dump/Mechanical/Accumulator/Stacks/Thermal Simulation/SPICE Model/22 Cell Stack.asc

C1: cap; {C}
C2: cap; {C}
C3: cap; {C}
C4: cap; {C}
C5: cap; {C}
C6: cap; {C}
C7: cap; {C}
C8: cap; {C}
C9: cap; {C}
C10: cap; {C}
C11: cap; {C}
R1: res; {R}
R2: res; {R}
R3: res; {R}
R4: res; {R}
R5: res; {R}
R6: res; {R}
R7: res; {R}
R8: res; {R}
R9: res; {R}
R10: res; {R}
R11: res; {R}
X1: Module
X2: Module
X3: Module
X4: Module
X5: Module
X6: Module
X7: Module
X8: Module
X9: Module
X10: Module
X11: Module
Named nets: 0, M1, M2, M3, M4, M5, M6, M7, M8, M9, M10, M11
.tran 90
.param R = 0.5
.param C = 80
.ic V(M1) = 0
.ic V(M2) = 0
.ic V(M3) = 0
.ic V(M4) = 0
.ic V(M5) = 0
.ic V(M6) = 0
.ic V(M7) = 0
.ic V(M8) = 0
.ic V(M9) = 0
.ic V(M10) = 0
.ic V(M11) = 0
