BDR16/svn-migration-dump/(list of files, drawings)

Other design files:
Electrical/Battery Tester/Battery Tester.dch
Electrical/High Voltage/Charging.dch
Electrical/High Voltage/Charging.dip
Electrical/High Voltage/High Voltage.dch
Electrical/High Voltage/High Voltage.dip
Electrical/Low Voltage/Low Voltage.dch
Electrical/Low Voltage/Low Voltage.dip
